EPFLXplore/Power_HW/README.md

# ERC_POWER_HW

This repository contains the KiCad design files for the power boards of the rover. The associated software can be found on the [ERC_POWER_SW](https://github.com/EPFLXplore/ERC_POWER_SW) repository.
