EPFLXplore/Power_HW/ElonMux/Computations/BQ25756-DESIGN-CALC-V01X2_backup.xlsx

Sheet: BQ2575X Design Calculator
 |  |  |  | BQ25756 Buck-Boost Battery Charger Design Calculator
 |  |  |  |  | View Password
 |  |  | = Input Box |  | BQ2575X
Step 1: Operating Specifications |  |  |  |  | Red Text = Conditional Formatting Conditions
 | Input Voltage - Min, VAC(min) | 10 | V | 10 V | 4.2 | 70
 | Input Voltage - Nom, VAC(nom) | 24 | V | 24 V | 4.2 | 70 | 10 | 33
 | Input Voltage - Max, VAC(max) | 33 | V | 33 V | 4.2 | 70
 | Battery Voltage, VBAT | 28.7 | V | 28,7 V | 3.3 | 70
 | Full Load Output Current, IOUT(max) | 10 | A | 10 A
 |  |  |  |  | Black Text = Lists or Formulas
Step 2: Switching Frequency
 | Desired Switching Frequency, FDFW | 600 | kHz | 600 kHz | 200 | 600
 | Recommended Switching Frequency Resistor, RFSW | 40.00 | kΩ | 40 kΩ
 | Selected Switching Frequency Resistor, RFSW | 40 | kΩ | 40 kΩ | 40 | 200
 | Recognized Switching Frequency, FSW | 600.00 | kHz |  | 570 | 630
 | Boost Duty Cycle Limitation | 86.50 | %
 | Boost Output Voltage Limitation at VAC(min) | 70 | V |  | 70 | 28.7
 | Boost Output Voltage Limitation at VAC(nom) | 70 | V |  | 70 | 28.7
 | Boost Output Voltage Limitation at VAC(max) | N/A | V |  | 70 | 28.7
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
