EPFLXplore/Power_HW/Wagos/power_hat_prots_ina/computations/ADM/24V_ADM1270 Design Spreadsheet tool_Release.xlsm

Set Resistor Tolerances
Sense Resistor Tolerance (%/100) |  | 0.01
Other Resistor Tolerance (%/100) |  | 0.01
UV and OV |  | Section 1
Set UV threshold | 20 | Volts
Set OV threshold | 27 | Volts
Set R3 in Kohms | 10 | Kohm
R1, closest Std 1% value | 255 | Kohm
R2, closest Std 1% value | 3.48 | Kohm
Actual UV Threshold | 19.92 | Volts
Actual OV Threshold | 26.848 | Volts
Worst Case UV High | 20.50 | Volts
Worst Case UV Low | 19.35 | Volts
Worst Case OV High | 27.64 | Volts
Worst Case OV Low | 26.07 | Volts
 |  | Section 2
CURRENT LIMIT
Desired Current Limit | 9 | Amps
Set Rsense | 0.005 | Ohms
Set R5 in Kohms | 10 | Kohms
R4, closest Std 1% value | 10 | Kohms
Calc actual OC | 9.000 | Amps
Calc VISET | 1.8 | Volts
Worst Case OC High | 9.825 | Amps
Worst Case OC Low | 8.194 | Amps
 |  | Section 3
FOLDBACK and PG
Set PG Threshold | 24 | Volts
Set FLB Threshold | 26 | Volts
Ignore these calculations, use next section
Set R9 in Kohms | 4.75 | Kohms
R7, closest Std 1% value | #N/A | Kohms
R8, closest Std 1% value | 110 | Kohms
Calc actual PG | #N/A | Volts
Worst Case PG High | #N/A
Worst Case PG Low | #N/A
Reverse FB and FLB connections, Set R8
Set R8 in Kohms | 100 | Kohms
R7, closest Std 1% value | 0.732 | Kohms
R9, closest Std 1% value | 3.65 | Kohms
Calc actual PG | 23.82 | Volts
Worst Case PG High | 24.52 | Volts
Worst Case PG Low | 23.14 | Volts
 |  | Section 4
Set Capacitor Tolerance (%/100) | 0.1
TIMER
Set Timer in milliseconds | 47 | mS
Calc Ctimer | 470 | nF
Wost Case Timer Max | 58.59 | mS
Wost Case Timer Min | 41.87 | mS
Set TimerOff in milliseconds | 940 | mS
Cal CtimerOff | 470 | nF
Wost Case TimerOff Max | 1318.3 | mS
Wost Case TimerOff Min | 690.9 | mS
Start Up Time from Internal UVLO (set by CtimerOff)
Wost Case Max | 65.9 | mS
Wost Case Min | 34.5 | mS
 |  | Section 5
Load Capacitance | 3500 | uF
Start up time | 0.01180727358 | Seconds
 | Time | Start Up
 | 0.01180727358 | 8.194
 | Volts | Start Up
 | 27.64 | 8.194
 |  | Section 6
FET Selection
Max Junction Temperature | 150 | C
Ambient Temperature | 40 | C
Mosfet thermal resistance from datasheet | 54 | C/W
Max permissible FET power dissipation | 2.037 | W
Permissible FET on resistance | 0.021 | ohms
Derating Factor from FET datasheet | 1.6
Max permissible FET on resistance | 0.013 | ohms
Actual FET on resistance @ 25C | 0.007 | ohms
Max FET on resistance at max Junc. Temp. | 0.011 | ohms
Actual FET power dissipation | 1.308 | W
Actual junction temperature rise | 70.636 | C
Maximum junction temperature | 110.636 | C
Calculated FET Power Derating Factor (DF) | 1.14
