EPFLXplore/Power_HW/Wagos/power_hat_prots_ina/computations/TPS/15V_TPS25983_Design_Calculator_v1.4.xlsm

TPS25983 Design Calculation Tool |  |  |  |  |  |  |  |  |  |  |  |  | Yes | 4
Constants Cells | Input/SelectCells | Calculation Cells |  |  | Recommended |  |  |  |  |  |  |  | No | 16
Error Cells, Must be Fixed | Calculated, but can be over-ridden by user |  |  |  | Value |  |  |  |  |  |  |  | Auto-Retry | 64
Parameter | Description | Value | Units | Tolerance |  |  |  |  |  |  |  |  | Latch-off | 256
VIN (nom) | Nominal operating input voltage | 15.00 | V |  |  |  |  |  |  |  |  |  |  | Infinite
VIN (max) | Maximum Operating input voltage (magnitude) | 15.00 | V |  | #REF!
OVLOset | Overvoltage Threshold (VIN Rising) | 18.00 | V
UVLOset | Undervoltage Threshold (VIN Rising) | 12.00 | V
VUVP | Internal IN Undervoltage Protection Threshold (VIN Rising) | 2.53 | V | 2.7%
Cout | Load Capacitance | 3500.0 | uF | 10.0%
Rlstart | Load at start-up (assumed to be resistive), Refer to Section 9.2.2.5.2 in Datasheet (http://www.ti.com/lit/ds/symlink/tps25982.pdf) | 75.0 | Ohm |  | 1.5
Imax | Maximum continuous load current (magnitude) | 10.00 | A
Ilimit | Set current Limit 20% (typical) higher than maximum continuous load current | 11.00 | A
TA(max) | Max Ambient Temperature | 70 | degC
 | Do you need to be immue to line transient due to adjacent card “hot-swap events” | No
tITIMER | Enter the time interval to support load transient currents | 5000 | us
 | Fault Response | Auto-Retry
tRETRY_DLY | Time delay between retries | 10.00 | ms
NRETRY | Number of retries | Infinite
Rec_VIMONMax | Recommended maximum IMON voltage | 3.3 | V
VIMON-Max | Enter current monitor (IMON) full-scale voltage range | 2.0 | V
UVLO, OVLO set point calculations |  |  |  |  |  |  |  |  |  | 120 |  | 111.1111111
UVLO Set Point | Desired Undervoltage Threshold (VIN Rising) | 12.00 |  |  |  |  |  | 10.90 | Power Fail (VIN Falling) | 180
OVLO Set Point | Desired Over Voltage Lockout Set Point | 18.00 |  |  |  |  |  | 11.90 | Release UVLO (VIN Rising)
R1: Pullup at EN/OVLO Pin | Value > 350K recommended | 1000.0 | kOhm | 1.0% |  |  |  | 17.63 | OV Cut-off (VIN Rising) | 182
R2_cal | Calculated value of Resistor at EN/OVLO pin | 37.0 | kOhm
R3_cal | Calculated value of Resistor at EN/OVLO pin | 74.1 | kOhm
SELECT THE VALUE OF RESISTORS AS CLOSEST AVAILABLE VALUE OF R2 & R3
R2 | Select the closest possible value as R2_cal | 36.50 | kOhm | 1.00% | 37.4
R3 | Select the closest possible value as R3_cal | 75.69 | kOhm | 1.00% | 75.69406393
UV_final_rising | Undervoltage Threshold (VIN Rising) | 11.90 | V
UV_final_falling | Undervoltage Threshold (VIN Falling) | 10.90 | V
OV_final_rising | Overvoltage Threshold (VIN Rising) | 17.63 | V
OV_final_falling | Overvoltage Threshold (VIN Falling) | 16.16 | V
I_R123 | Current in R1, R2 and R3 Branch | 13.49 | uA
Calculations for Ilimit (resistor on ILIM Pin) |  |  |  |  |  |  |  | 0.20 | Inrush Charging Current | 370.3703704
RILIM_Cal | Calculated current limit resistor | 134.07 | Ohm |  |  |  |  | 10.77 | Overload Curr Limit | 374
SELECT A ILIMIT RESISTOR WITH THE CLOSEST AVAILABLE VALUE OF Rilim_Cal |  |  |  |  |  |  |  |  |  | 134.07
RILIM | Select the closest available value of RILIM_cal | 137 | Ohm | 1.0% | 137 |  |  |  |  | 137
Ilimit_final | Final current Limit Set Point | 10.77 | A | 9.4% | 9.76 | A
Calculations for CURRENT MONITOR |  |  |  |  |  |  |  |  |  | 764.4193269
RIMON_max | Maximum allowed resistance at IMON pin | 764.42 | Ohm |  | 764.42 |  |  |  |  | 750
RIMON_sel | Resistor value selected at IMON pin | 750.00 | Ohm | 1.0% | 750
VIMON_final | Maximum voltage at IMON for maximum load current | 1.96 | V | 3.2%
The range of voltage output at IMON pin will be from 0V to VMON_imax |  | VIMON is Within Limits
Calculations for SoftStart control (external cap on dVdt pin)
Parameter | Description | Value | Units | Tolerance
Tchg_fastest | When no external capacitor is connected (max. slew rate) | 2.04 | ms | 15.0%
Icharge_fastest | Charging current when charging at fastest possible rate If this current is < Ilimit, no capacitor is required at dVdT pin | 10.77 | A
Tchg_req | The charging time required | 200.00 | ms
Icharge_req | Charging (inrush) current desired in the system | 0.30 | A
Cext_dvdt_cal1 | Calculated value of capacitor at dVdT pin for required Tcharge | 61.33 | nF
Cext_dvdt_cal2 | Calculated value of capacitor at dVdT pin for required Icharge | 53.67 | nF |  | 61.33
SELECT A CAPACITOR WITH THE CLOSEST POSSIBLE VALUE to max(Cext_dvdt_cal1, Cext_dvdt_cal2)
CdVdT_ext | The external capacitor connecetd across dVdT pin | 82.00 | nF | 10.0% | 68.0
Icharge | Charging Current as per dVdT setting | 0.20 | A | 18.0%
Does Device Enter Current Limit during start-up? |  | 0.00 |  |  | 13086.20
Tchg_dVdT | Charging time set | 267.39 | ms | 18.0%
Pd_Cout_startup | Power dissipation due to load cap at start-up | 1.47 | W
Total Power dissipation at Start-up
Pd_Rlstart | Power dissipation due to load resistance at start-up | 0.50 | W
Pd_startup | Total power dissipation at start-up | 1.97 | W |  |  |  |  |  |  | 2.57 | #N/A
 | Max power dissipation allowed for glitch-free startup for the programmed startup time (20% margin) | 2.06 | W | 20.0% | 2.57 |  |  |  |  | 1.40 | #N/A
 | Will the system have glitch-free startup? Look at Thermal Shutdown Limit Plot Tab | YES
Steady state Voltage drop & Power dissipation
Parameter | Description | Value | Units | Tolerance
Vdrop | Maximum voltage drop across device @ 25 degC | 32.00 | mV
Pdiss_Imax | Steady state power dissipation with Max current @ 25degC | 320.00 | mW
Calculations for Transient Overcurrent Blanking Interval
Citimer_cal | Calculated value of capacitor at ITIMER pin | 10.64 | nF |  | 10.64
Citimer_sel | Capacitor value selected at ITIMER pin | 10.00 | nF | 10.0% | 15.0
tITIMER_final | Time duration for which load transients between Ilimit and 2.1xIlimit are allowed | 4700 | us |  | 6536.74125 | nF
Setting the Auto-Retry Delay and Number of Retries
CRETRY_DLY_cal | Calculated value of capacitor at RETRY_DLY pin | 0.21 | nF |  | 0.21
CRETRY_DLY_sel | Capacitor value selected at RETRY_DLY pin | 0.22 | nF | 10.0% | 0.22
tRETRY_DLY_final | Time delay between retries | 10.49 | ms
CNRETRY_cal | Calculated value of capacitor at NRETRY pin | Short to Gnd | nF |  | Short to Gnd
CNRETRY_sel | Capacitor value selected at NRETRY pin | Short to Gnd | nF | 10.0% | Short to Gnd | #VALUE!
NRETRY_final | Number of retries | Infinite |  |  | Infinite | Infinite
Design Summary
 |  | R1 = | 12 | kOhm | Parameter |  | Typical | Units
 |  | R2 = | 36.5 | kOhm | Current limit |  | 10.77 | A
 |  | R3 = | 75.69 | kOhm | Upper UVLO Threshold |  | 11.90 | V
 |  | RG = | 2 | Ohm | Lower UVLO Threshold |  | 10.90 | V
 |  | RILIM = | 137 | Ohm | Output voltage ramp time, TdVdt |  | 267.39 | ms
 |  | RIMON = | 750.00 | Ohm
 |  | RPG = | 10.00 | kOhm | Transient overcurrent blanking interval (tITIMER) |  | 4700 | us
 |  | CdVdt = | 82.00 | nF
 |  | CITIMER = | 10 | nF | Time delay between retries |  | 10.48992 | ms
 |  | CRETRY_DLY = | 0.22 | nF | Number of retries |  | Infinite
 |  | CNRETRY = | Short to Gnd | nF
 |  |  |  |  | Overvoltage lockout |  | 17.63 | V
Notes: | 1. Although not mandatory, CIN provides transient suppression at the VIN pin | CIN = | 0.01uF | uF
 | 2. TVS clamp diode D1 from VIN to GND is recommented to clamp the voltage overshoot during device turn-off, e.g. during circuit breaker | COUT = | Optional
 | 3. Schottky diode D2 from VOUT to GND is mandatory to absorb negative spikes | D1 = | SMCJxx
 |  | D2 = | B530C-13-F
Parameters internal to Device
Internal FET Parameters
Parameter | Description | Value | Units | Tolerance
VDSS (max) | FET drain-source voltage rating (maximum) | 30.0 | V
ID(max) | FET drain-source current rating (maximum) | 18.0 | A
Rds(on) | FET maximum Rds(on) at 25degC | 3.20 | mOhm
Rds(on)_max | FET maximum Rds(on) at 125degC | 4.50 | mOhm
Thermal Parameters
Tj(max) | Device maximum junction temperature | 150.0 | C
TA(max) | Maximum ambient temperature of the application | 125.0 | C
RJC(top) | Junction to case (top) Thermal Resistance | 36.7 | C/W
RJA | Junction to ambient thermal resistance | 34.6 | C/W
RJC(bot) | Junction-to-case(bottom) thermal resistance | 1.6 | C/W
Internal References
Uvref_rise | Internal Undervoltage reference (Rising) | 1.20 | V | 2.5%
Uvref_fall | Internal Undervoltage reference (Falling) | 1.10 | V | 2.7%
GainIMON | Current monitor gain | 243.00 | uA/A | 3.0%
Idvdt | dVdt Pin Charging Current | 4.76 | uA | 3.0%
Delay
tD,ON | Device turn ON delay | 26.03 | ms
tGHI | Time taken to reach steady state | 346.45 | ms
