EPFLXplore/Power_HW/Wagos/power_hat_prots_ina/computations/TPS/TPS25983_Design_Calculator_v1.4.xlsm

TPS25983 Design Calculation Tool
Constants Cells | Input/SelectCells | Calculation Cells |  |  | Recommended
Error Cells, Must be Fixed | Calculated, but can be over-ridden by user |  |  |  | Value
Parameter | Description | Value | Units | Tolerance
VIN (nom) | Nominal operating input voltage | 15.00 | V
VIN (max) | Maximum Operating input voltage (magnitude) | 25.00 | V |  | #REF!
OVLOset | Overvoltage Threshold (VIN Rising) | 26.00 | V
UVLOset | Undervoltage Threshold (VIN Rising) | 4.00 | V
VUVP | Internal IN Undervoltage Protection Threshold (VIN Rising) | 2.53 | V | 2.7%
Cout | Load Capacitance | 62.0 | uF | 10.0%
Rlstart | Load at start-up (assumed to be resistive), Refer to Section 9.2.2.5.2 in Datasheet (http://www.ti.com/lit/ds/symlink/tps25982.pdf) | 24.0 | Ohm |  | 0.8
Imax | Maximum continuous load current (magnitude) | 18.00 | A
Ilimit | Set current Limit 20% (typical) higher than maximum continuous load current | 21.60 | A
TA(max) | Max Ambient Temperature | 70 | degC
 | Do you need to be immue to line transient due to adjacent card “hot-swap events” | No
tITIMER | Enter the time interval to support load transient currents | 2000 | us
 | Fault Response | Auto-Retry
tRETRY_DLY | Time delay between retries | 100.00 | ms
NRETRY | Number of retries | 4
Rec_VIMONMax | Recommended maximum IMON voltage | 3.3 | V
VIMON-Max | Enter current monitor (IMON) full-scale voltage range | 2.0 | V
UVLO, OVLO set point calculations |  |  |  |  |  |  |  |  |  | 400 |  | 213.8571429
UVLO Set Point | Desired Undervoltage Threshold (VIN Rising) | 4.00 |  |  |  |  |  | 3.65 | Power Fail (VIN Falling) | 260
OVLO Set Point | Desired Over Voltage Lockout Set Point | 26.00 |  |  |  |  |  | 3.99 | Release UVLO (VIN Rising)
R1: Pullup at EN/OVLO Pin | Value > 350K recommended | 499.0 | kOhm | 1.0% |  |  |  | 25.98 | OV Cut-off (VIN Rising) | 261
R2_cal | Calculated value of Resistor at EN/OVLO pin | 181.0 | kOhm
R3_cal | Calculated value of Resistor at EN/OVLO pin | 32.9 | kOhm
SELECT THE VALUE OF RESISTORS AS CLOSEST AVAILABLE VALUE OF R2 & R3
R2 | Select the closest possible value as R2_cal | 182.00 | kOhm | 1.00% | 182
R3 | Select the closest possible value as R3_cal | 32.98 | kOhm | 1.00% | 32.97927281
UV_final_rising | Undervoltage Threshold (VIN Rising) | 3.99 | V
UV_final_falling | Undervoltage Threshold (VIN Falling) | 3.65 | V
OV_final_rising | Overvoltage Threshold (VIN Rising) | 25.98 | V
OV_final_falling | Overvoltage Threshold (VIN Falling) | 23.81 | V
I_R123 | Current in R1, R2 and R3 Branch | 35.02 | uA
Calculations for Ilimit (resistor on ILIM Pin) |  |  |  |  |  |  |  | 0.05 | Inrush Charging Current | 180.956044
RILIM_Cal | Calculated current limit resistor | 67.94 | Ohm |  |  |  |  | 21.55 | Overload Curr Limit | 182
SELECT A ILIMIT RESISTOR WITH THE CLOSEST AVAILABLE VALUE OF Rilim_Cal |  |  |  |  |  |  |  |  |  | 679.3857608
RILIM | Select the closest available value of RILIM_cal | 68.1 | Ohm | 1.0% | 68.1 |  |  |  |  | 681
Ilimit_final | Final current Limit Set Point | 21.55 | A | 6.9% | 20.08 | A
Calculations for CURRENT MONITOR |  |  |  |  |  |  |  |  |  | 381.9402144
RIMON_max | Maximum allowed resistance at IMON pin | 381.94 | Ohm |  | 381.94 |  |  |  |  | 374
RIMON_sel | Resistor value selected at IMON pin | 374.00 | Ohm | 1.0% | 374
VIMON_final | Maximum voltage at IMON for maximum load current | 1.96 | V | 3.2%
The range of voltage output at IMON pin will be from 0V to VMON_imax |  | VIMON is Within Limits
Calculations for SoftStart control (external cap on dVdt pin)
Parameter | Description | Value | Units | Tolerance
Tchg_fastest | When no external capacitor is connected (max. slew rate) | 2.04 | ms | 15.0%
Icharge_fastest | Charging current when charging at fastest possible rate If this current is < Ilimit, no capacitor is required at dVdT pin | 0.46 | A
Tchg_req | The charging time required | 20.00 | ms
Icharge_req | Charging (inrush) current desired in the system | 1.00 | A
Cext_dvdt_cal1 | Calculated value of capacitor at dVdT pin for required Tcharge | 6.13 | nF
Cext_dvdt_cal2 | Calculated value of capacitor at dVdT pin for required Icharge | 0.29 | nF |  | 6.13
SELECT A CAPACITOR WITH THE CLOSEST POSSIBLE VALUE to max(Cext_dvdt_cal1, Cext_dvdt_cal2)
CdVdT_ext | The external capacitor connecetd across dVdT pin | 6.20 | nF | 10.0% | 6.2
Icharge | Charging Current as per dVdT setting | 0.05 | A | 18.0%
Does Device Enter Current Limit during start-up? |  | FALSE |  |  | 686.47
Tchg_dVdT | Charging time set | 20.22 | ms | 18.0%
Pd_Cout_startup | Power dissipation due to load cap at start-up | 0.34 | W
Total Power dissipation at Start-up
Pd_Rlstart | Power dissipation due to load resistance at start-up | 1.56 | W
Pd_startup | Total power dissipation at start-up | 1.91 | W |  |  |  |  |  |  | 9.69 | 9.28
 | Max power dissipation allowed for glitch-free startup for the programmed startup time (20% margin) | 7.75 | W | 20.0% | 9.69 |  |  |  |  | 6.62 | 6.69
 | Will the system have glitch-free startup? Look at Thermal Shutdown Limit Plot Tab | YES
Steady state Voltage drop & Power dissipation
Parameter | Description | Value | Units | Tolerance
Vdrop | Maximum voltage drop across device @ 25 degC | 57.60 | mV
Pdiss_Imax | Steady state power dissipation with Max current @ 25degC | 1036.80 | mW
Calculations for Transient Overcurrent Blanking Interval
Citimer_cal | Calculated value of capacitor at ITIMER pin | 4.26 | nF |  | 4.26
Citimer_sel | Capacitor value selected at ITIMER pin | 4.30 | nF | 10.0% | 4.3
tITIMER_final | Time duration for which load transients between Ilimit and 2.1xIlimit are allowed | 2021 | us |  | 517.1819868 | nF
Setting the Auto-Retry Delay and Number of Retries
CRETRY_DLY_cal | Calculated value of capacitor at RETRY_DLY pin | 2.13 | nF |  | 2.13
CRETRY_DLY_sel | Capacitor value selected at RETRY_DLY pin | 2.20 | nF | 10.0% | 2.2
tRETRY_DLY_final | Time delay between retries | 103.21 | ms
CNRETRY_cal | Calculated value of capacitor at NRETRY pin | 2.20 | nF |  | 1.98
CNRETRY_sel | Capacitor value selected at NRETRY pin | 1.8 | nF | 10.0% | 1.8 | 3.266787659
NRETRY_final | Number of retries | 4 |  |  | 3.266787659 | 4
Design Summary
 |  | R1 = | 4 | kOhm | Parameter |  | Typical | Units
 |  | R2 = | 182 | kOhm | Current limit |  | 21.55 | A
 |  | R3 = | 32.98 | kOhm | Upper UVLO Threshold |  | 3.99 | V
 |  | RG = | 2 | Ohm | Lower UVLO Threshold |  | 3.65 | V
 |  | RILIM = | 68.1 | Ohm | Output voltage ramp time, TdVdt |  | 20.22 | ms
 |  | RIMON = | 374 | Ohm
 |  | RPG = | 10.00 | kOhm | Transient overcurrent blanking interval (tITIMER) |  | 2021 | us
 |  | CdVdt = | 6.20 | nF
 |  | CITIMER = | 4.3 | nF | Time delay between retries |  | 103.21332 | ms
 |  | CRETRY_DLY = | 2.2 | nF | Number of retries |  | 4
 |  | CNRETRY = | 1.8 | nF
 |  |  |  |  | Overvoltage lockout |  | 25.98 | V
Notes: | 1. Although not mandatory, CIN provides transient suppression at the VIN pin | CIN = | 0.01uF | uF
 | 2. TVS clamp diode D1 from VIN to GND is recommented to clamp the voltage overshoot during device turn-off, e.g. during circuit breaker | COUT = | Optional
 | 3. Schottky diode D2 from VOUT to GND is mandatory to absorb negative spikes | D1 = | SMCJxx
 |  | D2 = | B530C-13-F
Parameters internal to Device
Internal FET Parameters
Parameter | Description | Value | Units | Tolerance
VDSS (max) | FET drain-source voltage rating (maximum) | 30.0 | V
ID(max) | FET drain-source current rating (maximum) | 18.0 | A
Rds(on) | FET maximum Rds(on) at 25degC | 3.20 | mOhm
Rds(on)_max | FET maximum Rds(on) at 125degC | 4.50 | mOhm
Thermal Parameters
Tj(max) | Device maximum junction temperature | 150.0 | C
TA(max) | Maximum ambient temperature of the application | 125.0 | C
RJC(top) | Junction to case (top) Thermal Resistance | 36.7 | C/W
RJA | Junction to ambient thermal resistance | 34.6 | C/W
RJC(bot) | Junction-to-case(bottom) thermal resistance | 1.6 | C/W
Internal References
Uvref_rise | Internal Undervoltage reference (Rising) | 1.20 | V | 2.5%
Uvref_fall | Internal Undervoltage reference (Falling) | 1.10 | V | 2.7%
GainIMON | Current monitor gain | 243.00 | uA/A | 3.0%
Idvdt | dVdt Pin Charging Current | 4.76 | uA | 3.0%
Delay
tD,ON | Device turn ON delay | 3.18 | ms
tGHI | Time taken to reach steady state | 27.41 | ms
