EPFLXplore/Power_HW/Pollux/Altium/Pollux III/ImportantLogos.docx

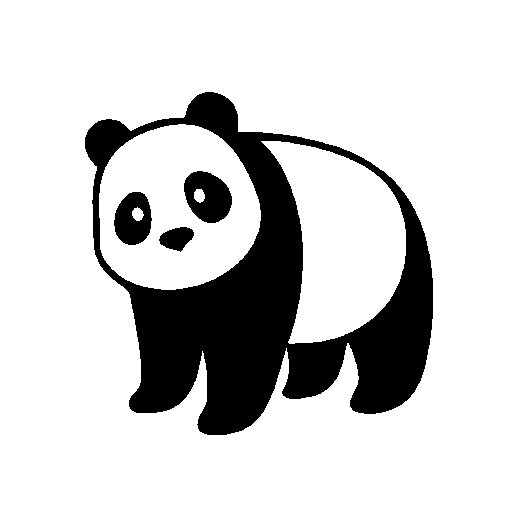
[picture p22: figure]
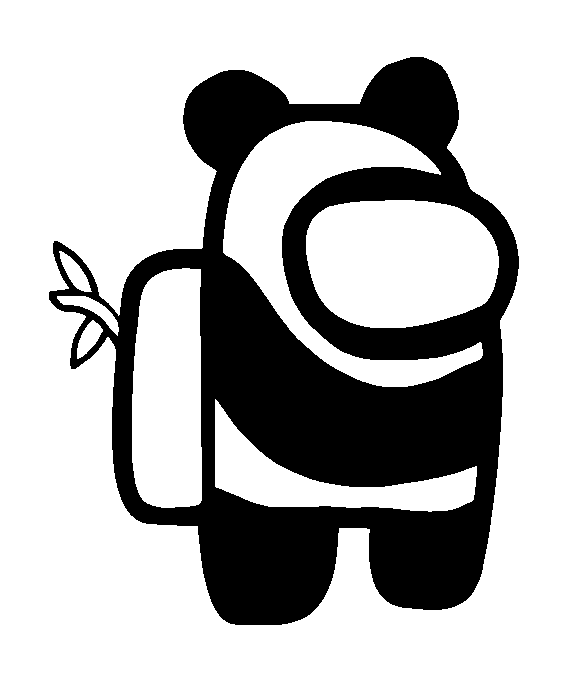
[picture p23: figure]
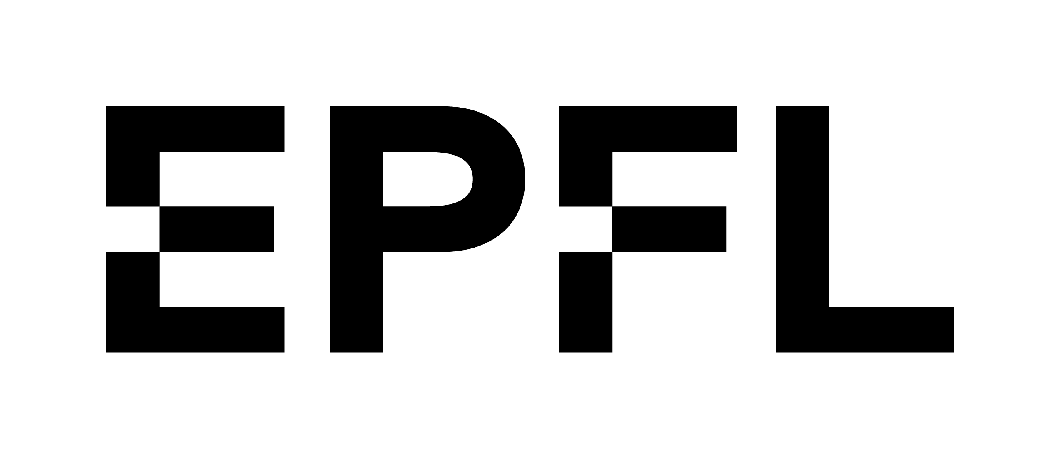
[picture p24: figure]
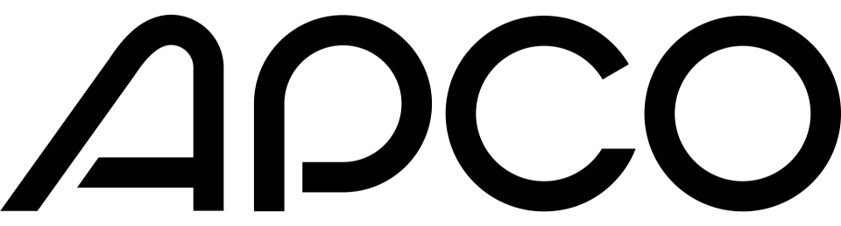
[picture p25: figure]
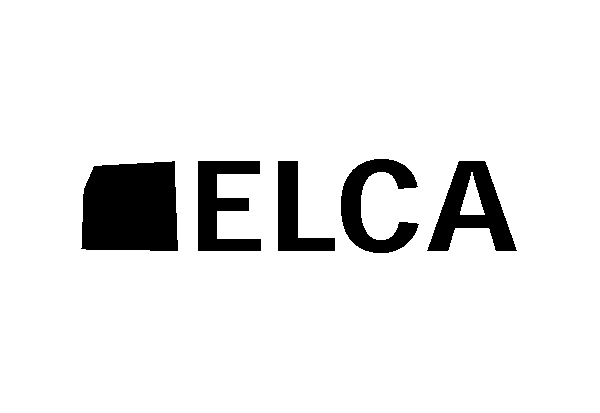
[picture p26: figure]
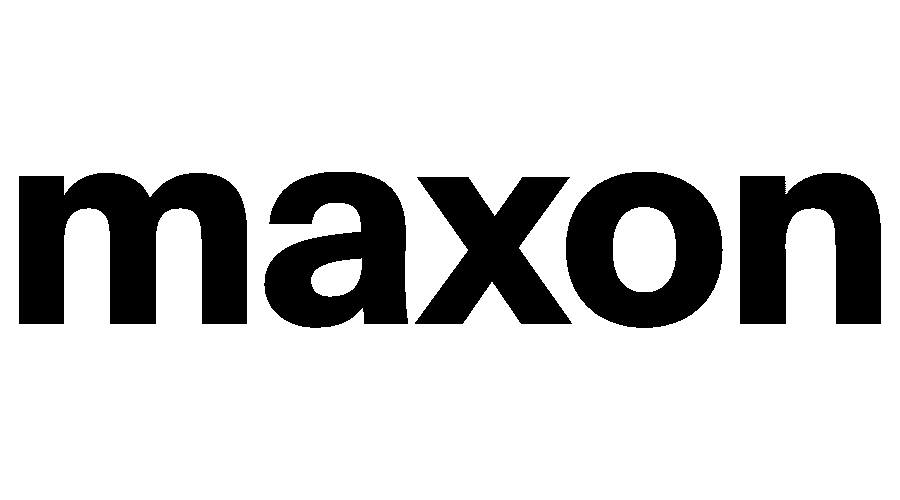
[picture p27: figure]
