EPFLXplore/Power_HW/ElonMux/Images/0.96-Inch-I2CIIC-4-Pin-OLED-Display-Module-WHITE-2.png.png

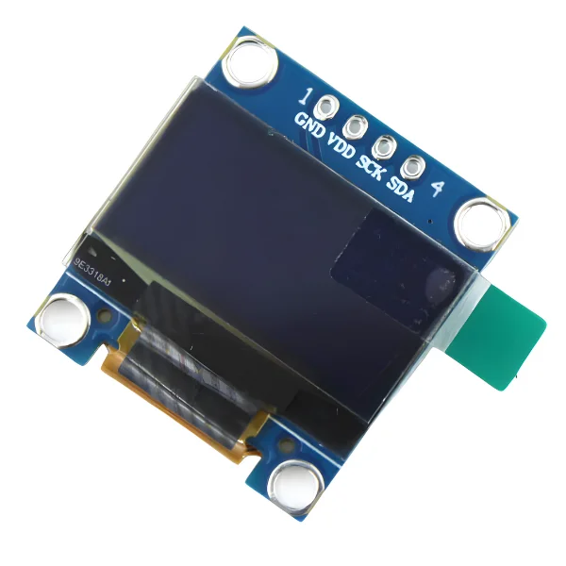
ElonMux/Images/0.96-Inch-I2CIIC-4-Pin-OLED-Display-Module-WHITE-2.png.png
