EPFLXplore/Power_HW/ElonMux/Images/BQ25756E.png

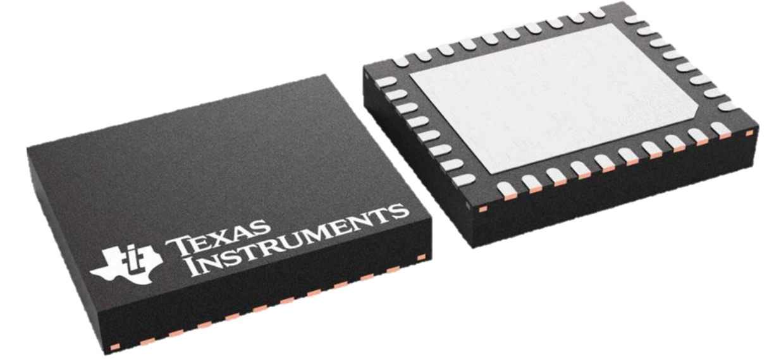
ElonMux/Images/BQ25756E.png
