EPFLXplore/Power_HW/ElonMux/Images/Capture d’écran 2024-12-14 à 01.28.16.png

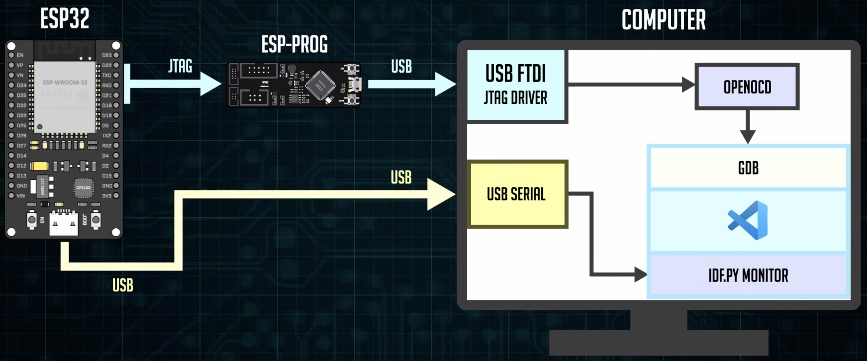
ElonMux/Images/Capture d’écran 2024-12-14 à 01.28.16.png
