EPFLXplore/Power_HW/ElonMux/Images/ElonMuxBack1.png

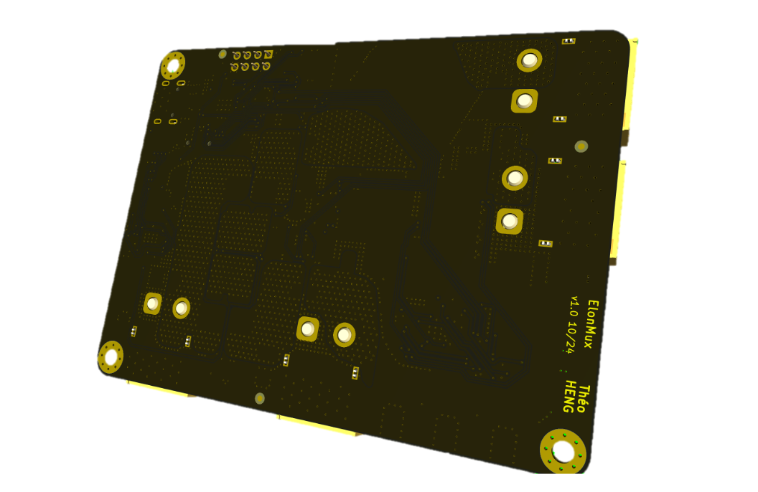
ElonMux/Images/ElonMuxBack1.png
