EPFLXplore/Power_HW/ElonMux/Images/ElonMuxBack2.png

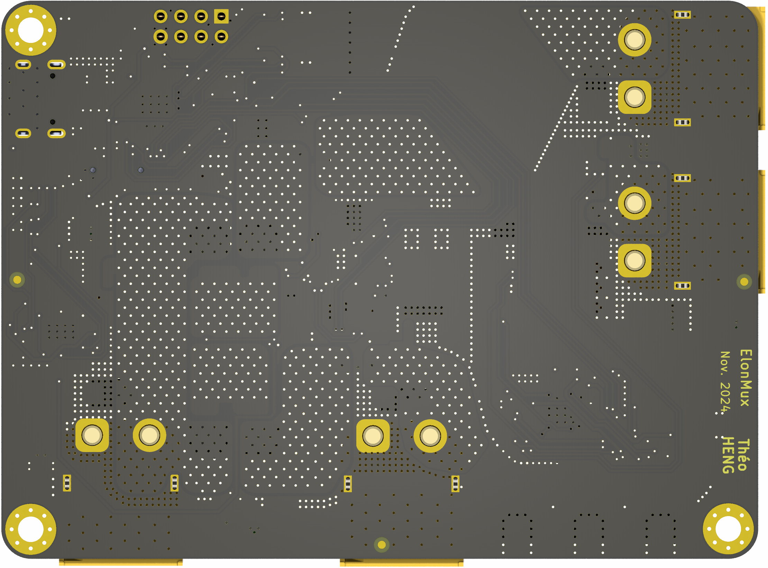
ElonMux/Images/ElonMuxBack2.png
