EPFLXplore/Power_HW/ElonMux/Images/ElonMuxBack3.png

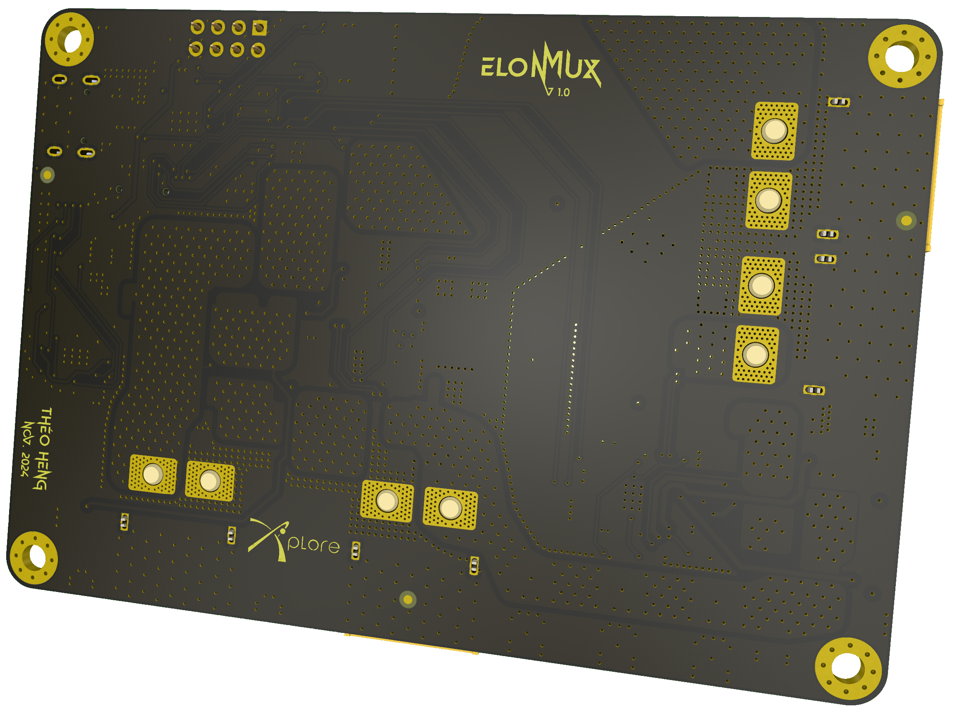
ElonMux/Images/ElonMuxBack3.png
