EPFLXplore/Power_HW/ElonMux/Images/ElonMuxBack4.png

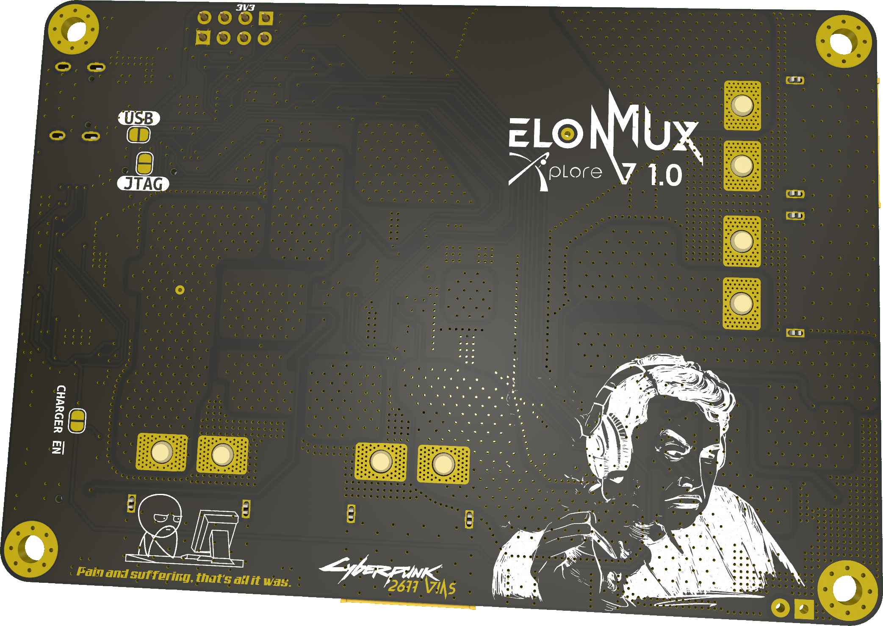
ElonMux/Images/ElonMuxBack4.png
