EPFLXplore/Power_HW/ElonMux/Images/ElonMuxBack5.png

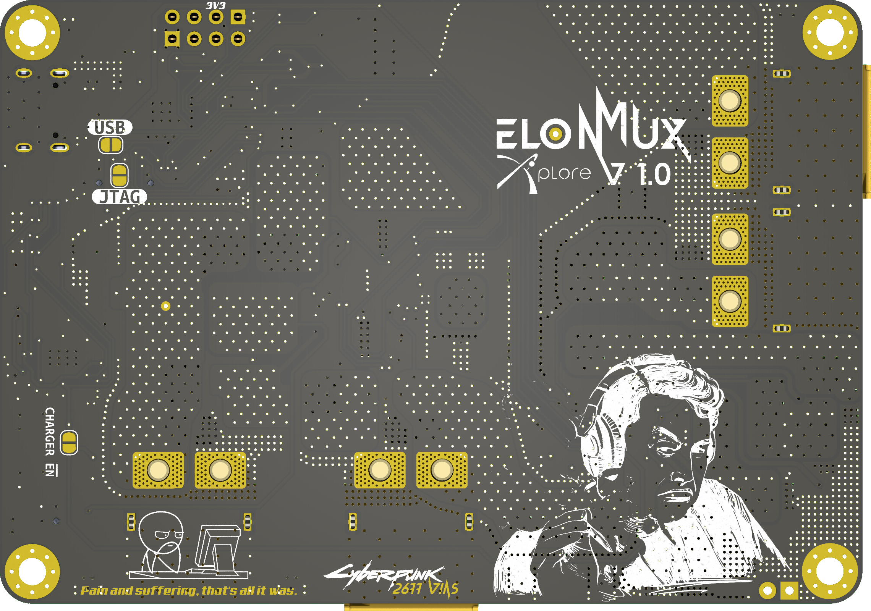
ElonMux/Images/ElonMuxBack5.png
