EPFLXplore/Power_HW/ElonMux/Images/ElonMuxFront1.png

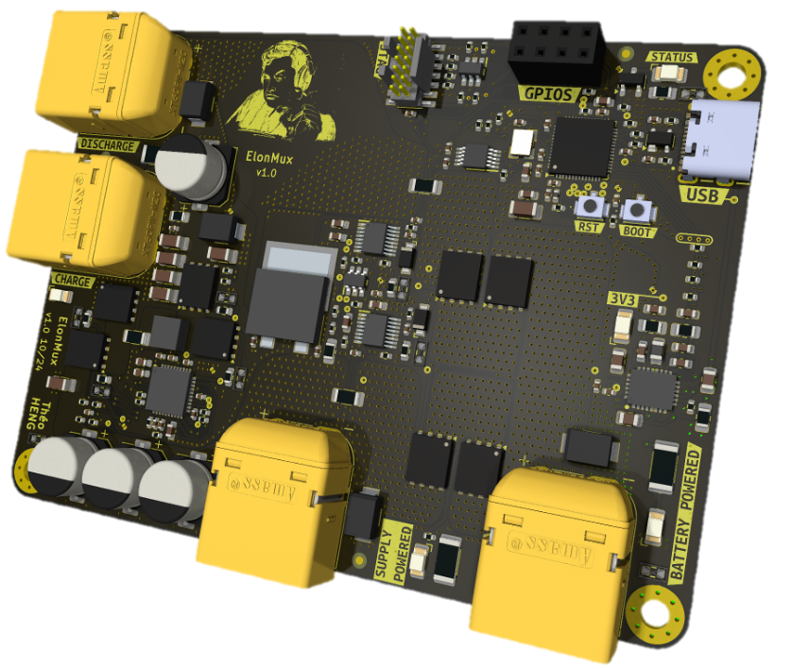
ElonMux/Images/ElonMuxFront1.png
