EPFLXplore/Power_HW/ElonMux/Images/ElonMuxFront2.png

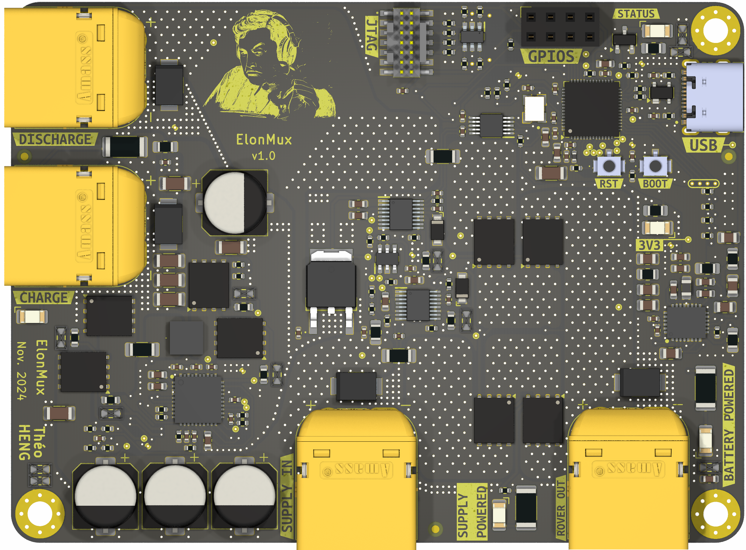
ElonMux/Images/ElonMuxFront2.png
