EPFLXplore/Power_HW/ElonMux/Images/ElonMuxFront3.png

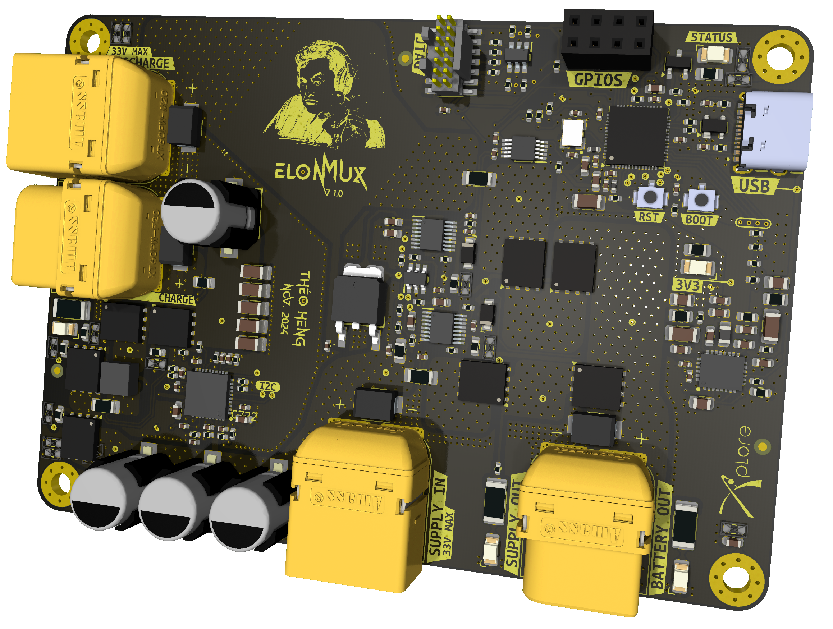
ElonMux/Images/ElonMuxFront3.png
