EPFLXplore/Power_HW/ElonMux/Images/ElonMuxFront4.png

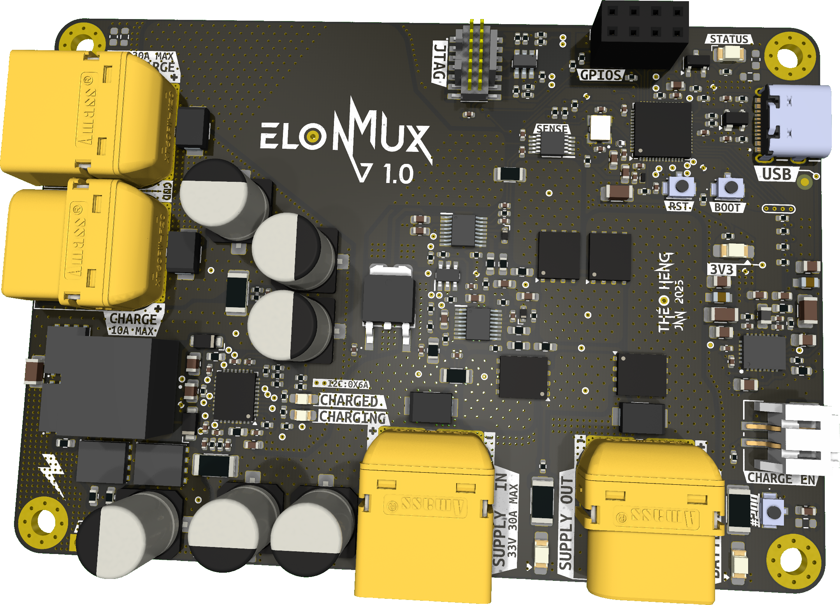
ElonMux/Images/ElonMuxFront4.png
