EPFLXplore/Power_HW/ElonMux/Images/ElonMuxFrontSafe_1.png

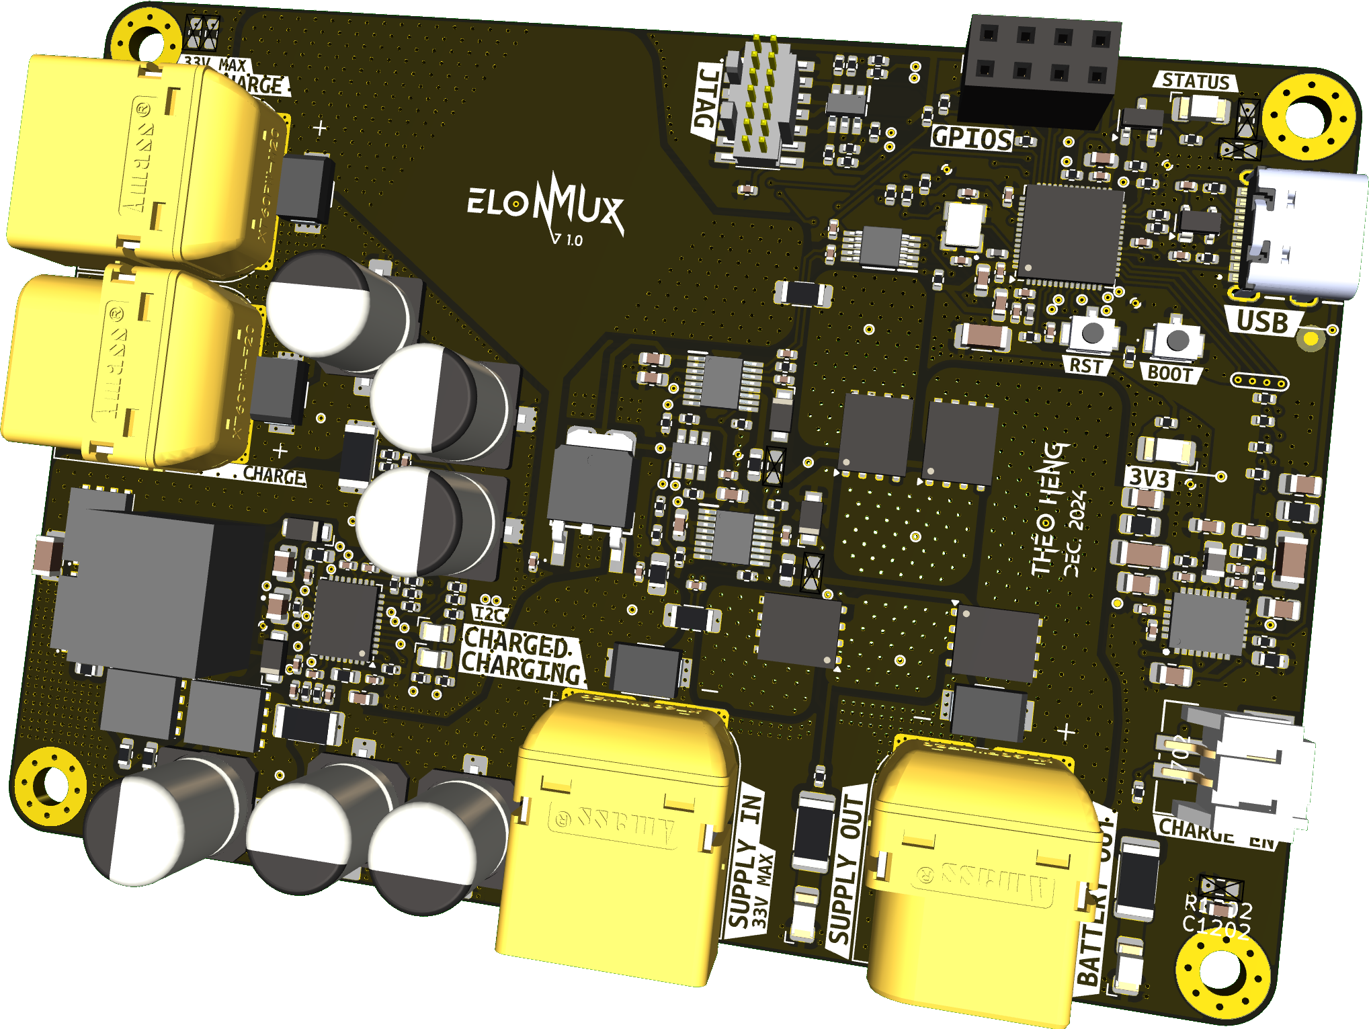
ElonMux/Images/ElonMuxFrontSafe_1.png
