EPFLXplore/Power_HW/ElonMux/Images/ElonMuxL1_1.png

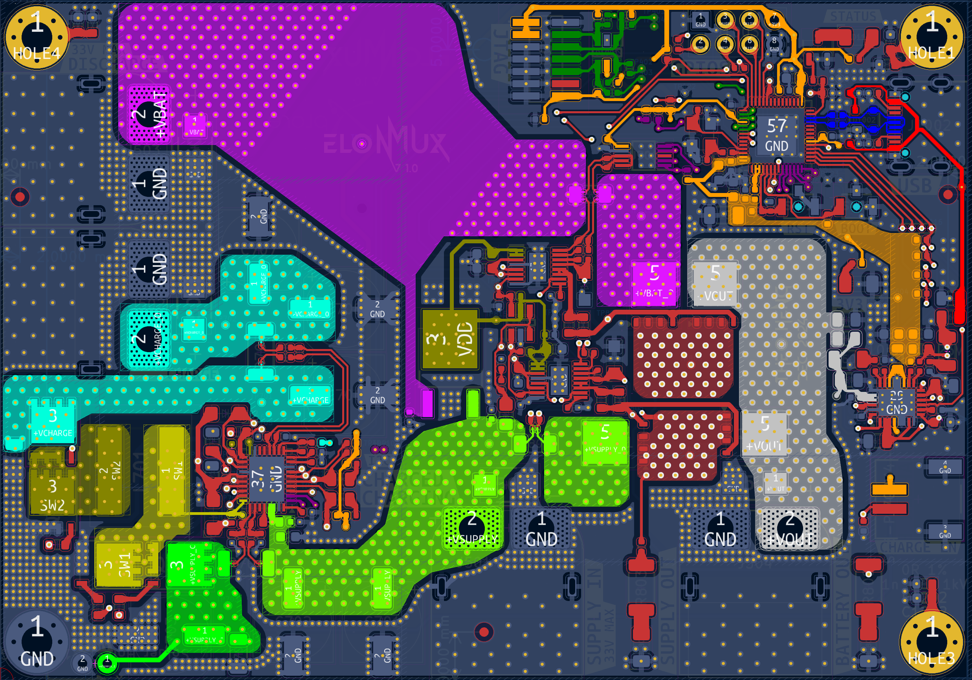
ElonMux/Images/ElonMuxL1_1.png
