EPFLXplore/Power_HW/ElonMux/Images/EMux_render.png

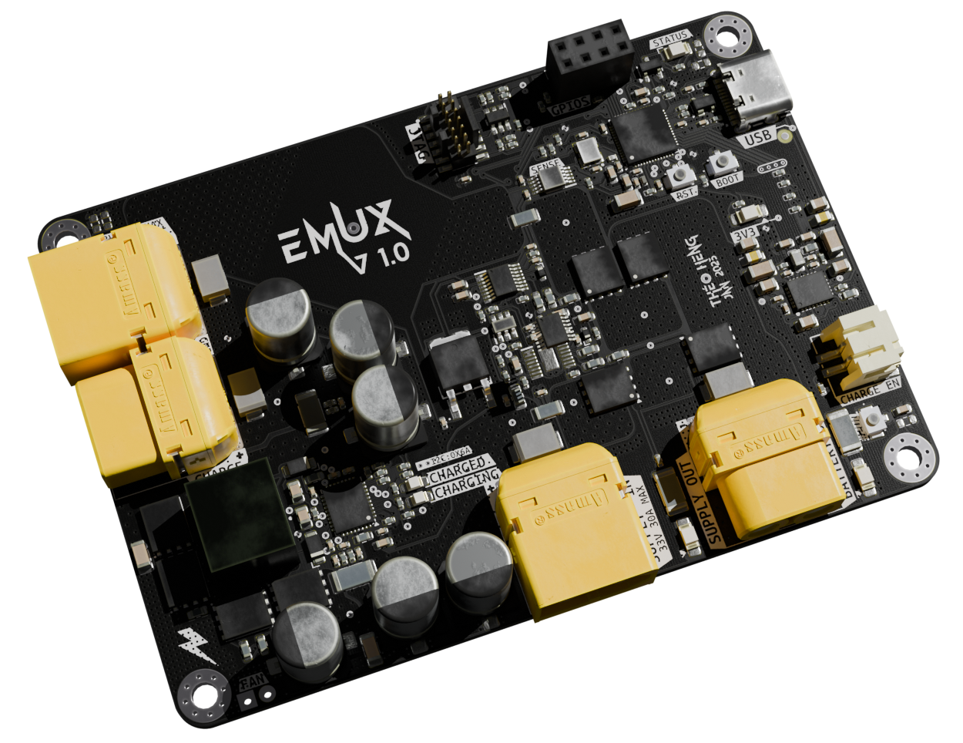
ElonMux/Images/EMux_render.png
