EPFLXplore/Power_HW/ElonMux/Images/ESP-Prog_Pinout.png

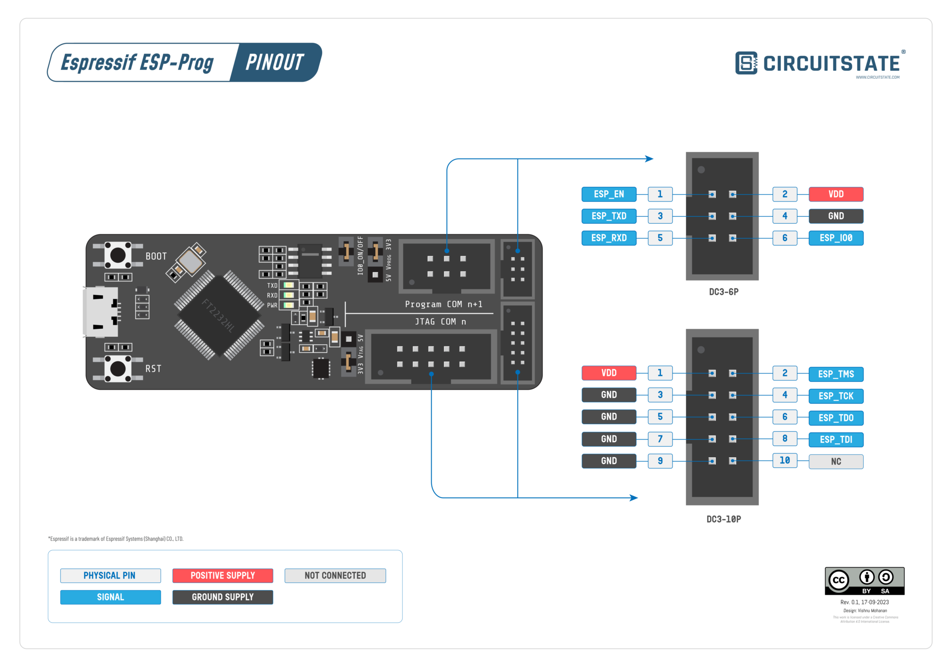
ElonMux/Images/ESP-Prog_Pinout.png
