EPFLXplore/Power_HW/ElonMux/Images/Ferrite Filter.png

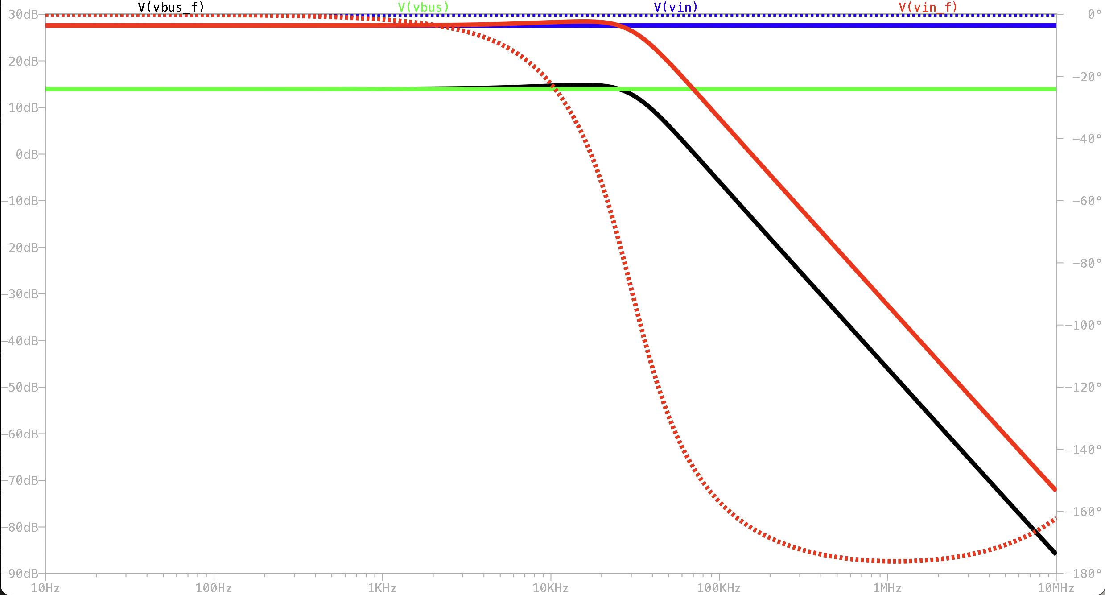
ElonMux/Images/Ferrite Filter.png
