EPFLXplore/Power_HW/ElonMux/Images/FTSH-107-01-F-DV-K.png

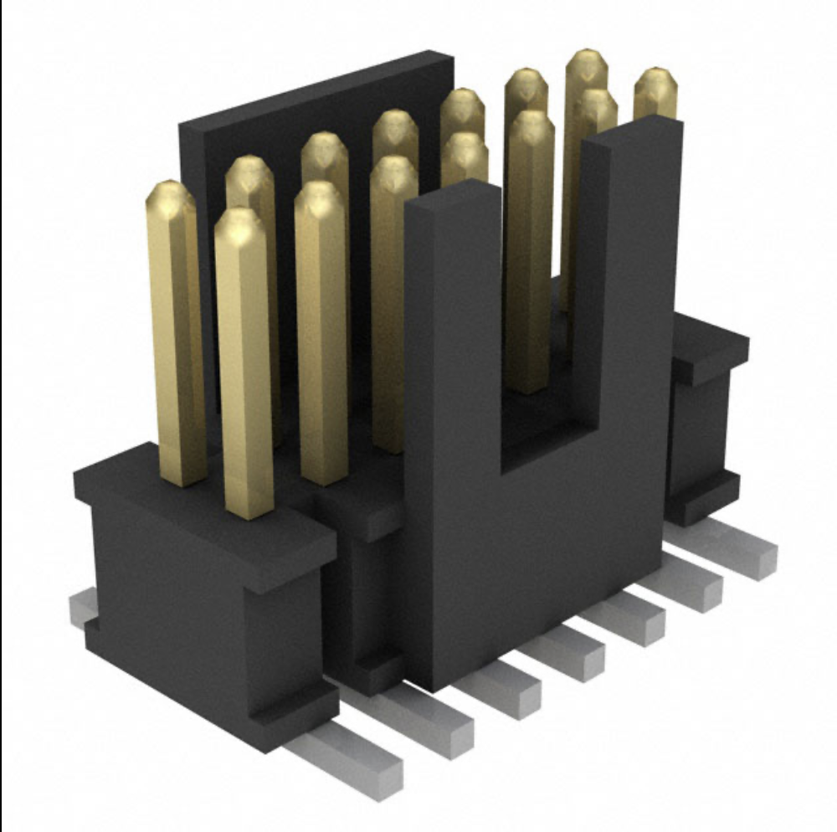
ElonMux/Images/FTSH-107-01-F-DV-K.png
