EPFLXplore/Power_HW/ElonMux/Images/Photos/IMG_1249.jpg

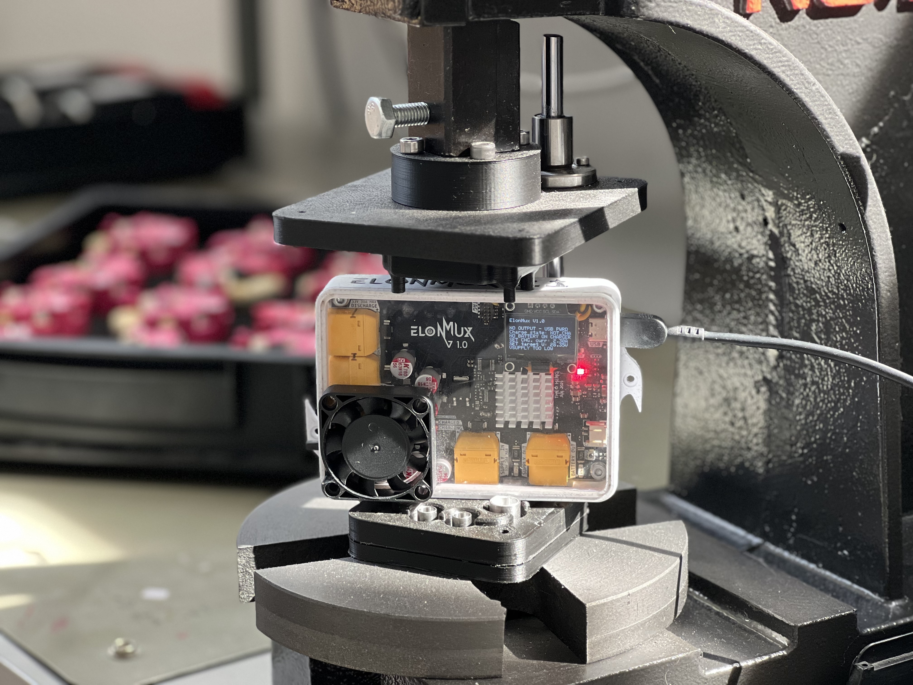
ElonMux/Images/Photos/IMG_1249.jpg
