EPFLXplore/Power_HW/ElonMux/Images/Photos/IMG_1306.jpg

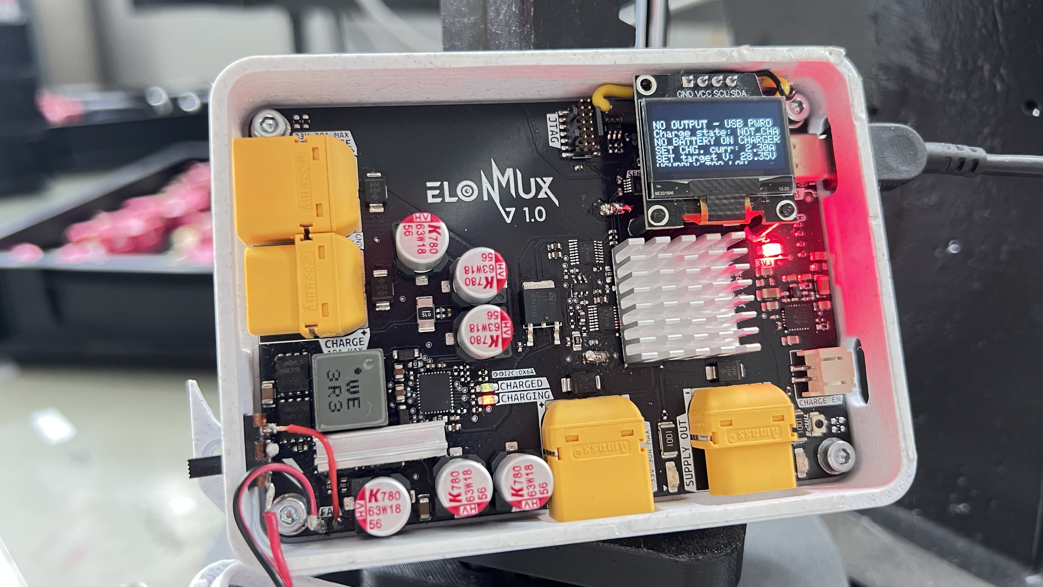
ElonMux/Images/Photos/IMG_1306.jpg
