EPFLXplore/Power_HW/ElonMux/Images/PPTC042LFBN-RC.jpg

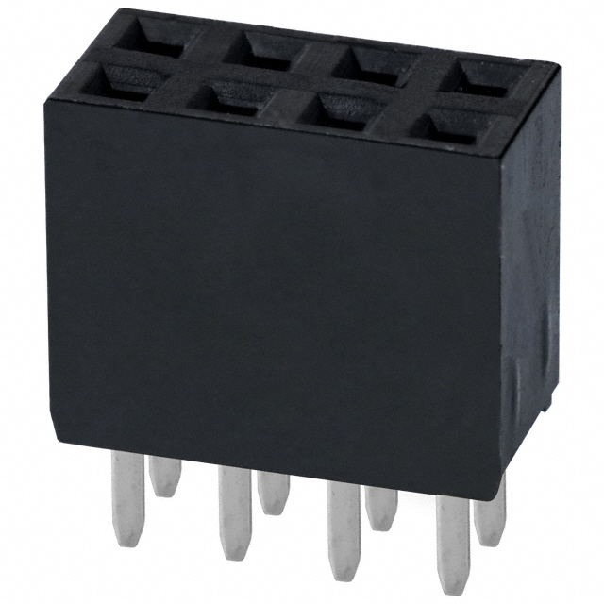
ElonMux/Images/PPTC042LFBN-RC.jpg
