EPFLXplore/Power_HW/ElonMux/Images/Switching freq graph.png

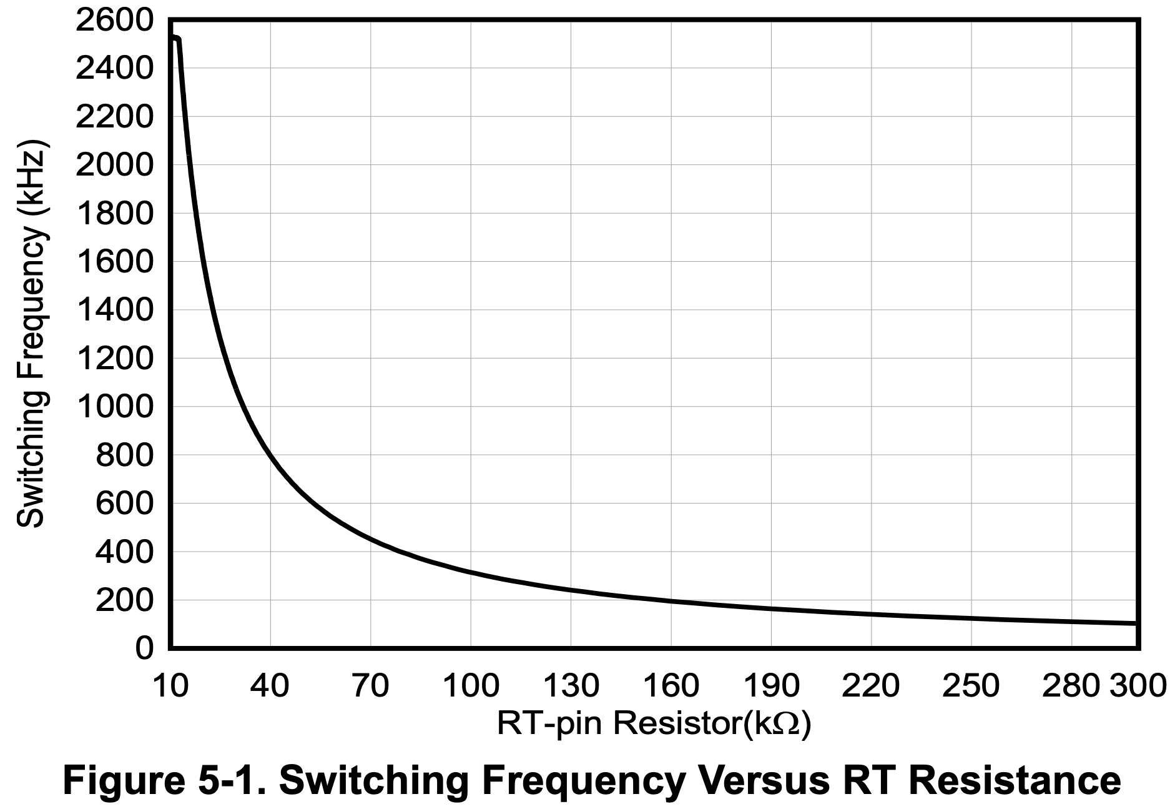
ElonMux/Images/Switching freq graph.png
