EPFLXplore/Power_HW/ElonMux/Thermal/FLIR0195.jpg

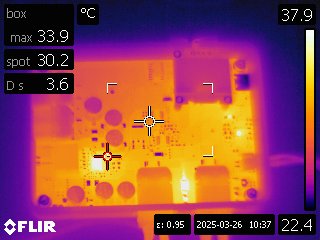
ElonMux/Thermal/FLIR0195.jpg
