EPFLXplore/Power_HW/ElonMux/Thermal/FLIR0197.jpg

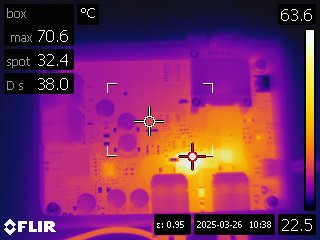
ElonMux/Thermal/FLIR0197.jpg
