EPFLXplore/Power_HW/ElonMux/Thermal/FLIR0199.jpg

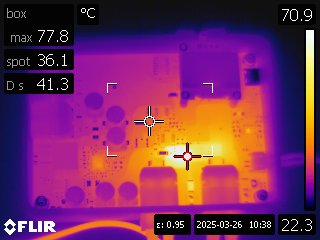
ElonMux/Thermal/FLIR0199.jpg
