EPFLXplore/Power_HW/ElonMux/Thermal/FLIR0201.jpg

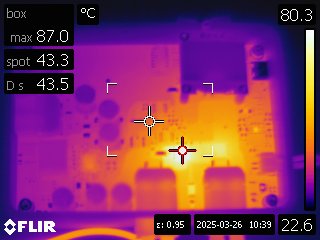
ElonMux/Thermal/FLIR0201.jpg
