EPFLXplore/Power_HW/ElonMux/Thermal/FLIR0203.jpg

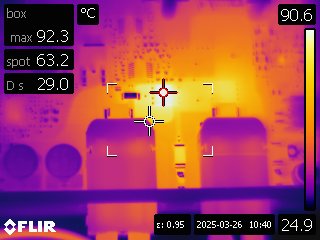
ElonMux/Thermal/FLIR0203.jpg
