EPFLXplore/Power_HW/ElonMux/Thermal/FLIR0207.jpg

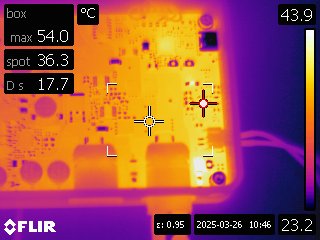
ElonMux/Thermal/FLIR0207.jpg
