EPFLXplore/Power_HW/ElonMux/Thermal/FLIR0209.jpg

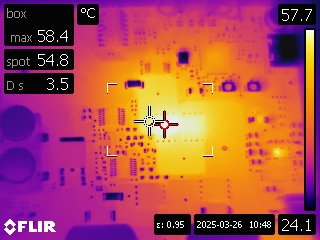
ElonMux/Thermal/FLIR0209.jpg
