EPFLXplore/Power_HW/ElonMux/Thermal/FLIR0211.jpg

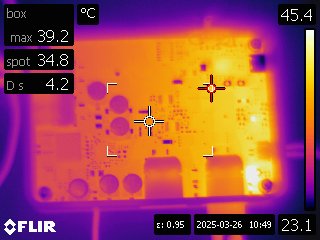
ElonMux/Thermal/FLIR0211.jpg
