EPFLXplore/Power_HW/ElonMux/Thermal/FLIR0213.jpg

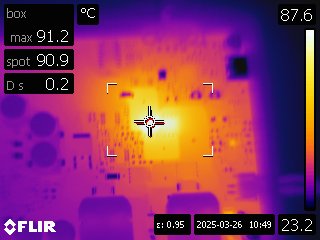
ElonMux/Thermal/FLIR0213.jpg
