EPFLXplore/Power_HW/ElonMux/Thermal/FLIR0215.jpg

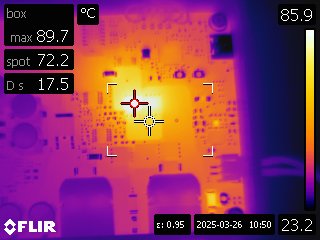
ElonMux/Thermal/FLIR0215.jpg
