EPFLXplore/Power_HW/ElonMux/Thermal/FLIR0217.jpg

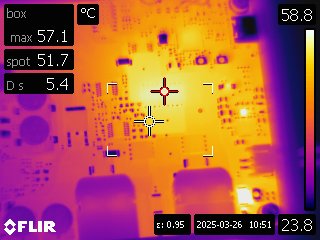
ElonMux/Thermal/FLIR0217.jpg
