EPFLXplore/Power_HW/ElonMux/Thermal/FLIR0219.jpg

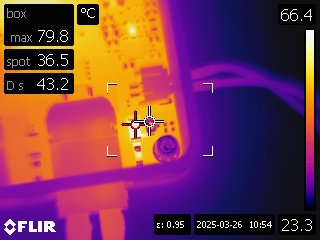
ElonMux/Thermal/FLIR0219.jpg
