EPFLXplore/Power_HW/ElonMux/Thermal/FLIR0221.jpg

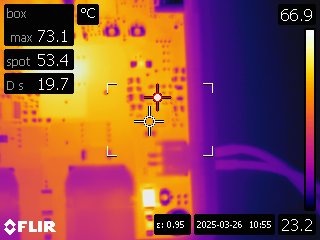
ElonMux/Thermal/FLIR0221.jpg
