EPFLXplore/Power_HW/ElonMux/Thermal/FLIR0223.jpg

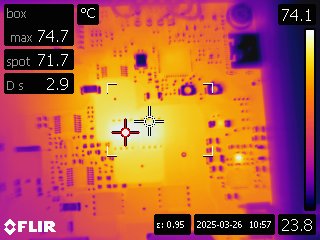
ElonMux/Thermal/FLIR0223.jpg
