EPFLXplore/Power_HW/GEODE/rev2/SMPS_legged_robot_module/footprints/Isolator/SI8630AB-B-IS.step

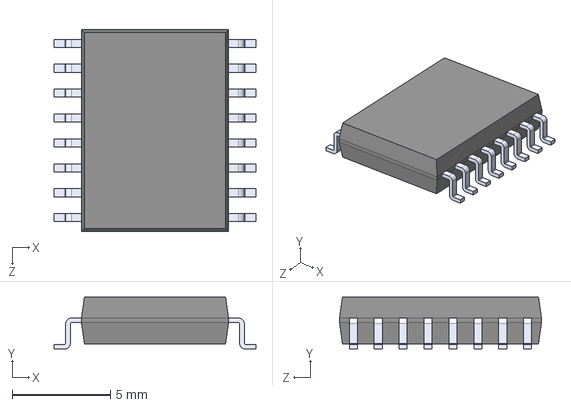
[picture p64: CAD file, 2025-02-26]
GEODE/rev2/SMPS_legged_robot_module/footprints/Isolator/SI8630AB-B-IS.step
10.3 x 2.65 x 10.3 mm
