EPFLXplore/Power_HW/GEODE/rev2/SMPS_legged_robot_module/footprints/Power module/LTC3889EUKG#PBF.stp

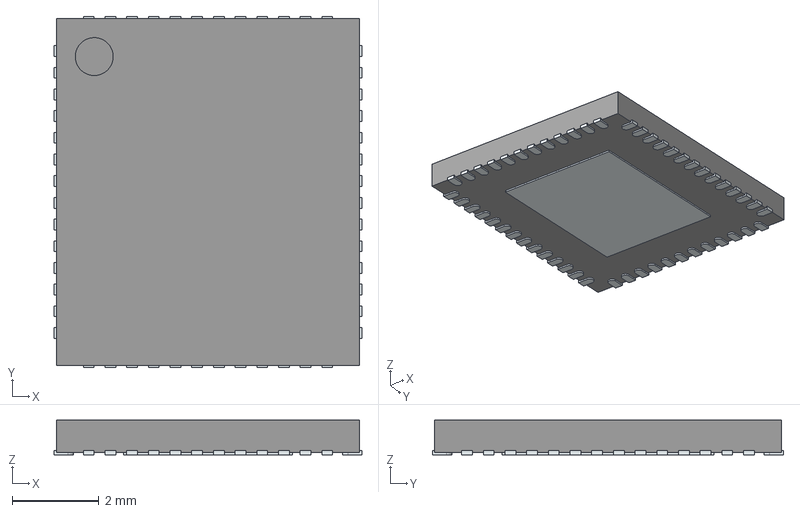
[picture p65: CAD file, 2025-02-26]
GEODE/rev2/SMPS_legged_robot_module/footprints/Power module/LTC3889EUKG#PBF.stp
7.10 x 8.10 x 0.8 mm
ThermalPin
PinsArrayLR
PinsArrayTB
