EPFLXplore/Power_HW/GEODE/rev2/SMPS_Motherboard/footprints/ampli/TPA6205A1DGN.stp

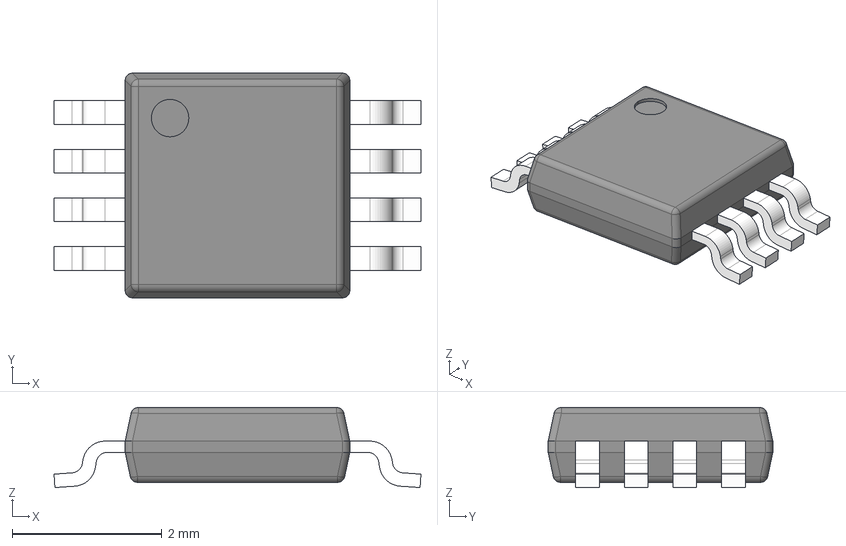
[picture p66: CAD file, 2025-02-26]
GEODE/rev2/SMPS_Motherboard/footprints/ampli/TPA6205A1DGN.stp
4.90 x 3.00 x 1.07 mm
BODY-DGN0008G
LEAD-DGN0008G x 8
PIN1_DGN0008G
DAP_DGN0008G
