EPFLXplore/Power_HW/GEODE/rev2/SMPS_Motherboard/footprints/connector/Input Voltage/XT90PW-F.STEP

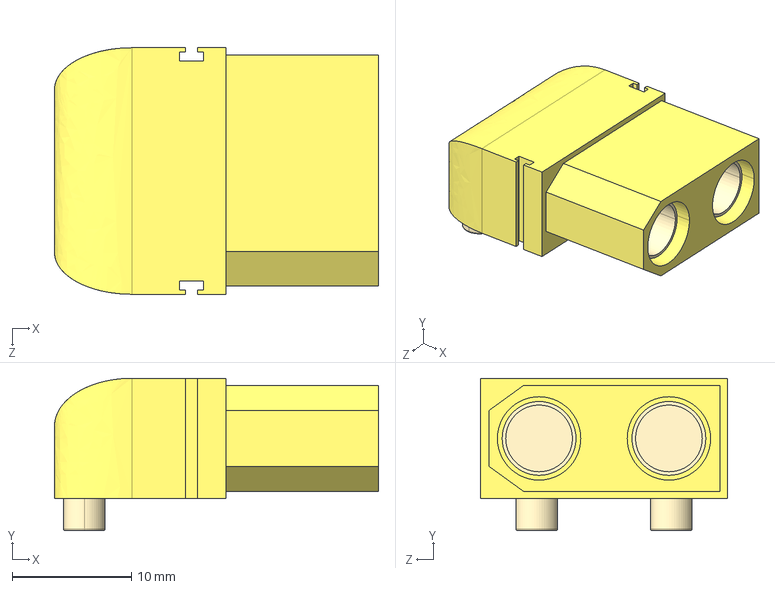
[picture p67: CAD file, 2025-02-26]
GEODE/rev2/SMPS_Motherboard/footprints/connector/Input Voltage/XT90PW-F.STEP
27.2 x 12.8 x 20.7 mm
