EPFLXplore/Power_HW/GEODE/rev2/SMPS_Motherboard/footprints/connector/Output Voltage/PJ-082BH.stp

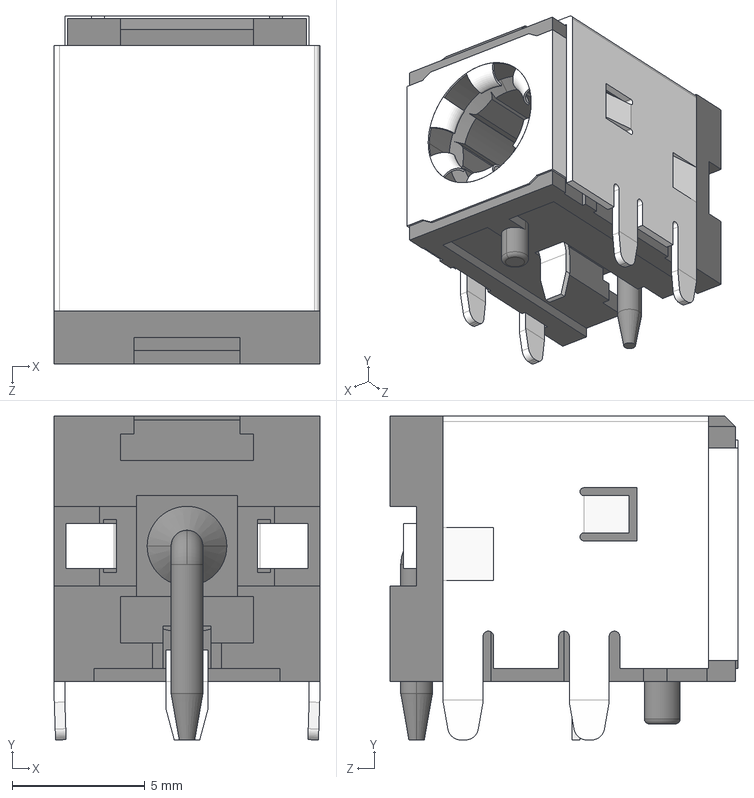
[picture p69: CAD file, 2025-02-26]
GEODE/rev2/SMPS_Motherboard/footprints/connector/Output Voltage/PJ-082BH.stp
10.0 x 12.2 x 13.1 mm
