EPFLXplore/Power_HW/GEODE/rev2/SMPS_Motherboard/footprints/EEPROM/M24C16-RMN6P.stp

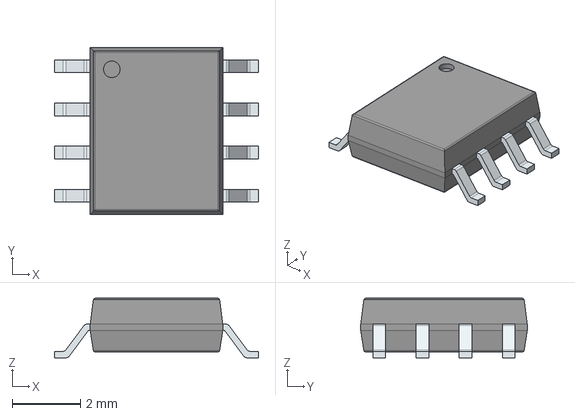
[picture p70: CAD file, 2025-02-26]
GEODE/rev2/SMPS_Motherboard/footprints/EEPROM/M24C16-RMN6P.stp
6.00 x 4.90 x 1.75 mm
PinsArrayLR
