EPFLXplore/Power_HW/GEODE/rev2/SMPS_Motherboard/footprints/EtherCAT/LAN9252_ML.stp

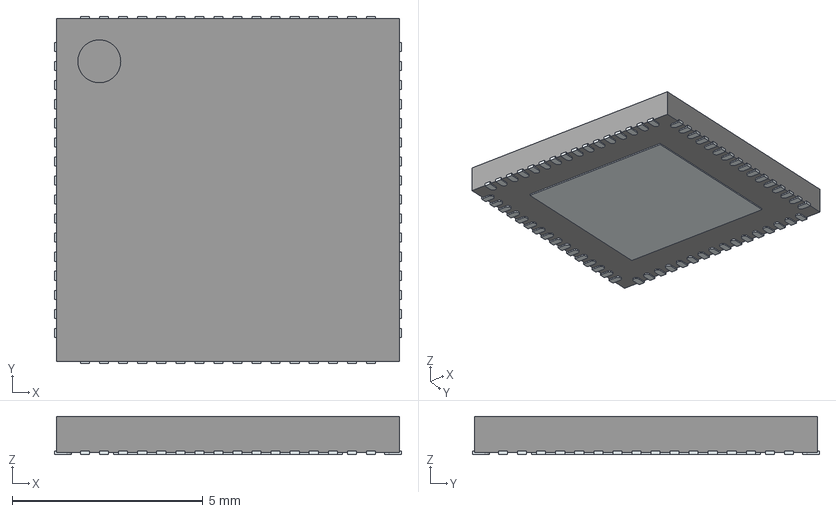
[picture p71: CAD file, 2025-02-26]
GEODE/rev2/SMPS_Motherboard/footprints/EtherCAT/LAN9252_ML.stp
9.10 x 9.10 x 1.00 mm
ThermalPin
PinsArrayLR
PinsArrayTB
