EPFLXplore/Power_HW/GEODE/rev2/SMPS_Motherboard/footprints/Power safety/Hot-Swap/TPS2490DGSRG4.stp

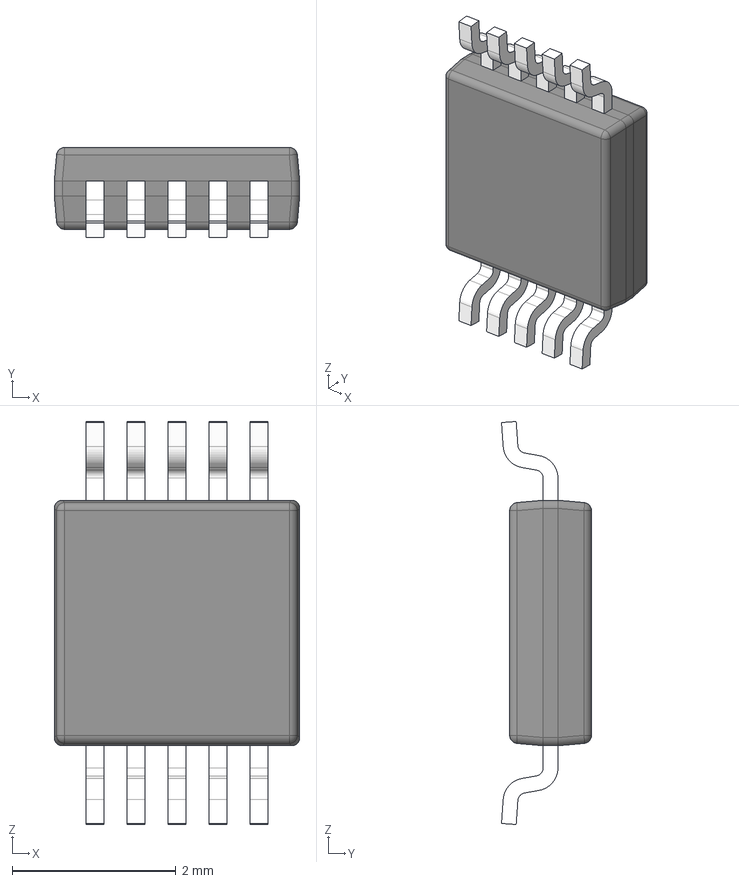
[picture p72: CAD file, 2025-02-26]
GEODE/rev2/SMPS_Motherboard/footprints/Power safety/Hot-Swap/TPS2490DGSRG4.stp
3.00 x 1.10 x 4.93 mm
BODY-SO
LEAD-SO x 10
PIN1-ID
