EPFLXplore/Power_HW/GEODE/rev2/SMPS_Motherboard/footprints/transistor/PSMN4R8-100BSEJ.stp

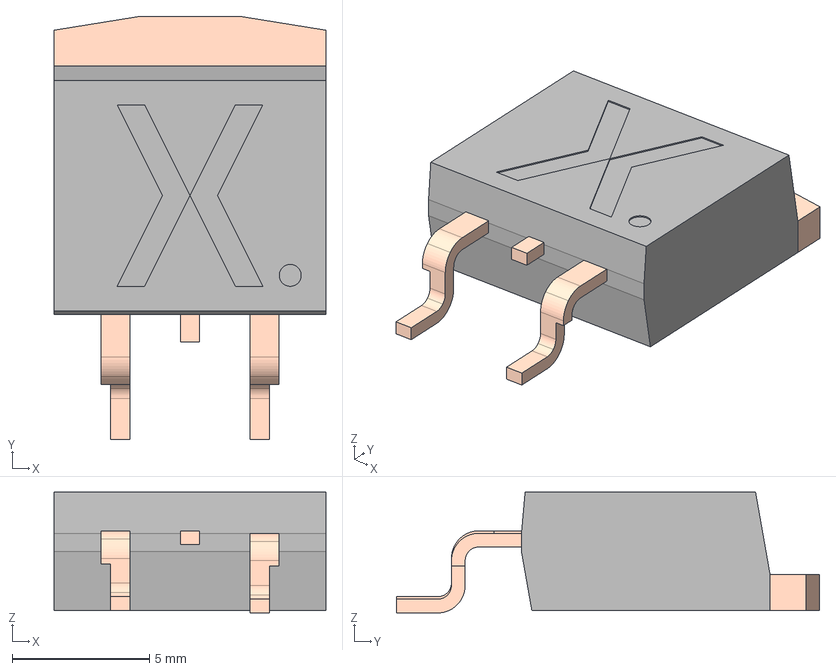
[picture p73: CAD file, 2025-02-26]
GEODE/rev2/SMPS_Motherboard/footprints/transistor/PSMN4R8-100BSEJ.stp
9.90 x 15.4 x 4.40 mm
