EPFLXplore/Power_HW/Pollux/Altium/Pollux III/Pollux III.step

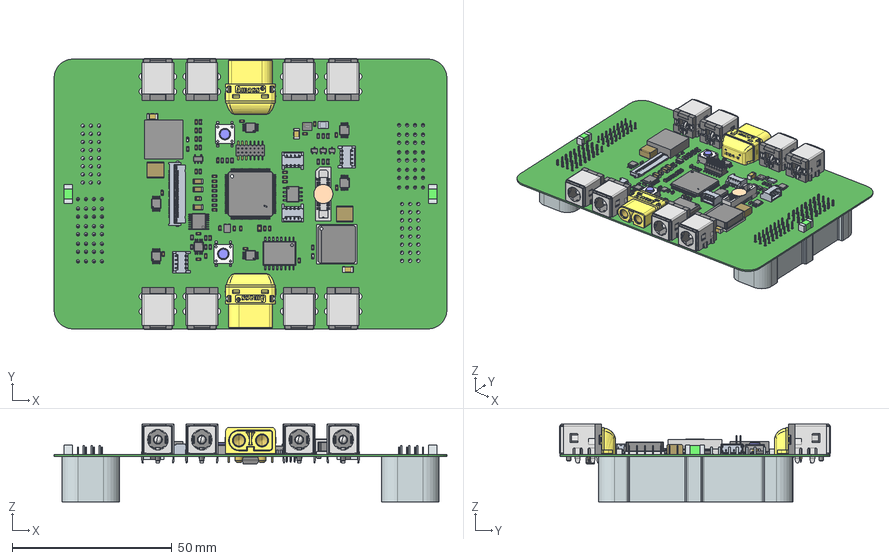
[picture p74: CAD file, 2026-09-20]
Pollux/Altium/Pollux III/Pollux III.step
123.0 x 84.7 x 24.4 mm
PinsArrayLR x 8
BODY_MUY08A
LEAD_MUY08A x 8
EXP_PAD_MUY08A
BODY_MF05A
LEAD_MF05F x 5
term1 x 33
term2 x 33
Pins x 4
CUI_DEVICES_PJ-082BH x 8
IC_BODY
circle
IC_LEG x 100
STMicroelectronics
LL3301_SMT x 2
TopPlate x 2
Plunger x 2
PinsArrayL x 3
FilletPinR x 3
RPMB-3.0
KRTB_DWLM32_32_20190603_geometry
_ERF5-020-05.0-DV_socket
_C-247-020-05.0
_K-DOT-.236-.343-.005_polyamide_pick
BODY-TSSOP
LEAD-TSSOP x 16
PIN1
FilletPin1
FilletPin2
