EPFLXplore/Power_HW/Pollux/Kicad/HVPowerModule/ALTIUM_EMBEDDED_MODELS/MCP47FEB02A0-E_ST.stp

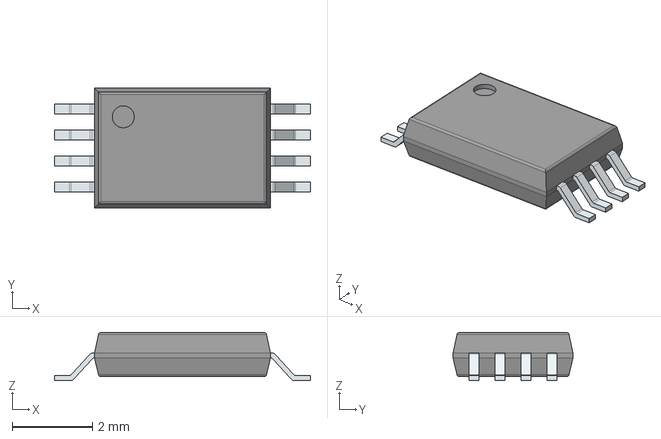
[picture p75: CAD file, 2026-09-20]
Pollux/Kicad/HVPowerModule/ALTIUM_EMBEDDED_MODELS/MCP47FEB02A0-E_ST.stp
6.40 x 3.00 x 1.20 mm
PinsArrayLR
