EPFLXplore/Power_HW/Pollux/Kicad/HVPowerModule/HVPowerModule.step

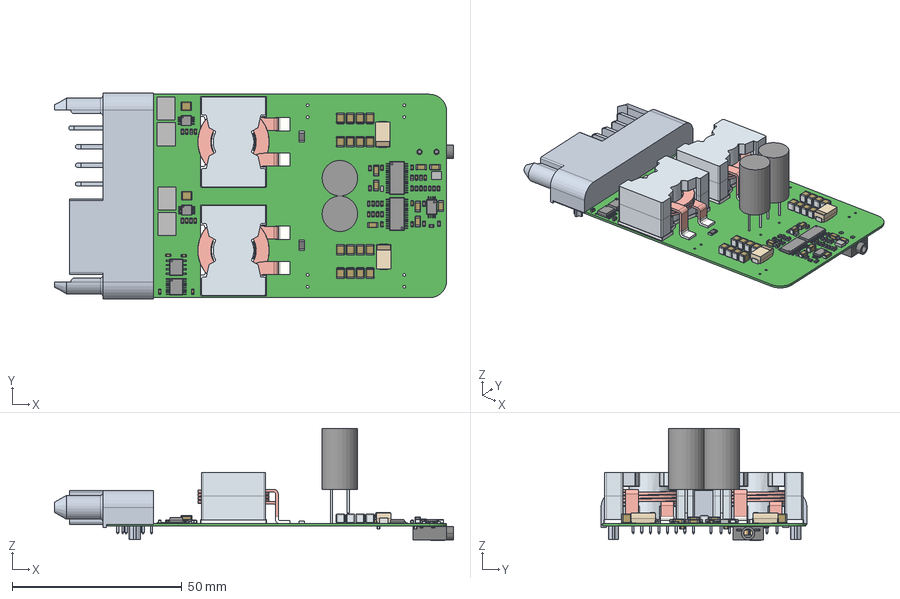
[picture p76: CAD file, 2026-09-20]
Pollux/Kicad/HVPowerModule/HVPowerModule.step
117.7 x 60.8 x 33.1 mm
PinsArrayLR x 7
BASE x 2
PIN x 2
PQ2614 x 4
COIL x 2
SimpleBody x 2
Pin1 x 2
Pin2 x 2
term1 x 22
term2 x 22
Extruded x 6
CAPMP76X43_31N_KEM x 2
ThermalPad x 2
