EPFLXplore/Power_HW/Pollux/Kicad/LVPowerModule/ALTIUM_EMBEDDED_MODELS/CRCW06033R00JNEA.stp

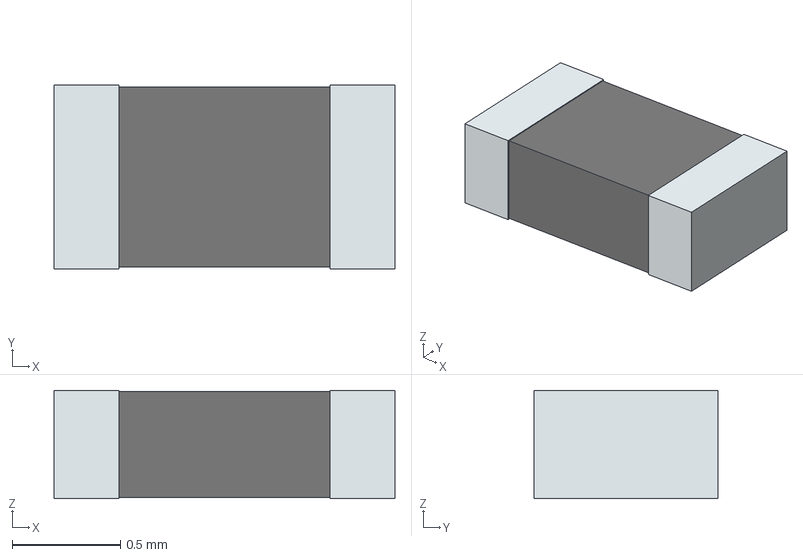
[picture p77: CAD file, 2026-09-20]
Pollux/Kicad/LVPowerModule/ALTIUM_EMBEDDED_MODELS/CRCW06033R00JNEA.stp
1.57 x 0.85 x 0.5 mm
term1
term2
