EPFLXplore/Power_HW/Pollux/Kicad/LVPowerModule/LVPowerModule.step

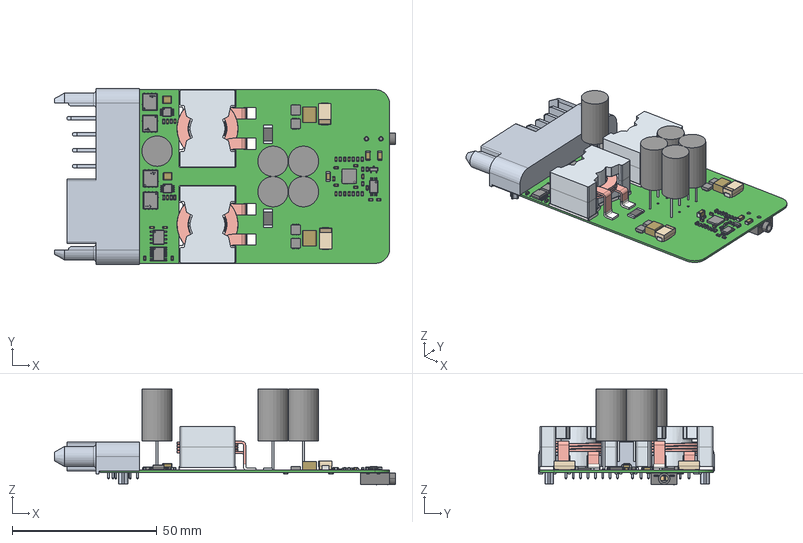
[picture p78: CAD file, 2026-09-20]
Pollux/Kicad/LVPowerModule/LVPowerModule.step
117.7 x 60.8 x 33.1 mm
SimpleBody x 5
Pin1 x 5
Pin2 x 5
PinsArrayLR x 6
term1 x 27
term2 x 27
Infineon_Logo x 4
PinsArrayL
FilletPinR
CAPMP76X43_31N_KEM x 2
Pins x 4
BASE x 2
PIN x 2
PQ2614 x 4
COIL x 2
ThermalPin
PinsArrayTB
