EPFLXplore/Power_HW/Pollux/Kicad/HVPowerModule/ALTIUM_EMBEDDED_MODELS/C1206C105M5RECTU.stp

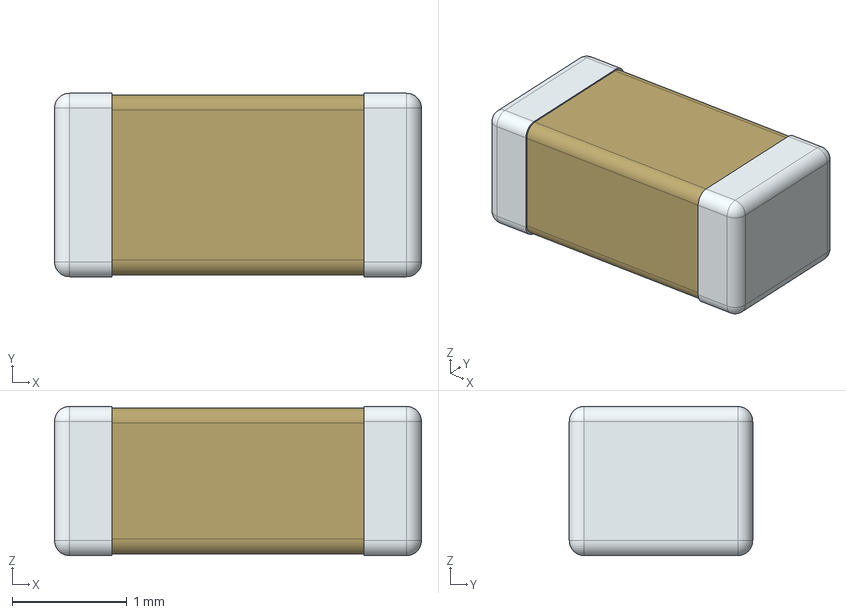
[picture p80: CAD file, 2026-09-20]
Pollux/Kicad/HVPowerModule/ALTIUM_EMBEDDED_MODELS/C1206C105M5RECTU.stp
3.20 x 1.60 x 1.30 mm
