EPFLXplore/Power_HW/Pollux/Kicad/LVPowerModule/ALTIUM_EMBEDDED_MODELS/CAPMP76X43_31N_KEM.step

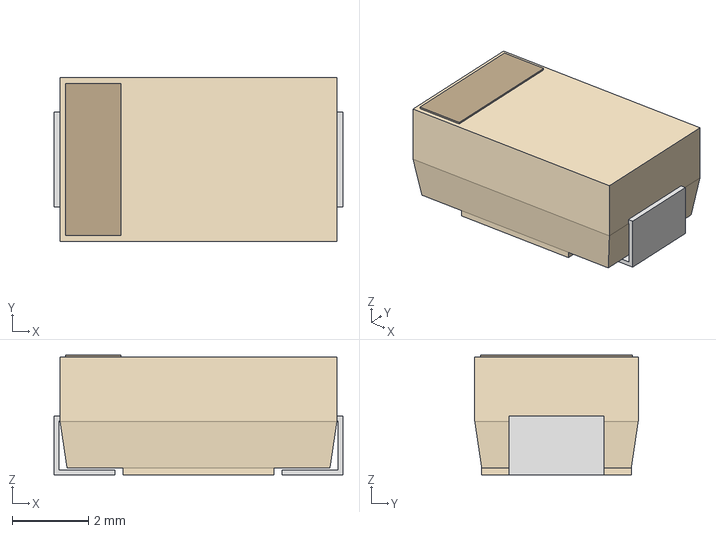
[picture p81: CAD file, 2026-09-20]
Pollux/Kicad/LVPowerModule/ALTIUM_EMBEDDED_MODELS/CAPMP76X43_31N_KEM.step
7.60 x 4.30 x 3.15 mm
