EPFLXplore/Power_HW/Pollux/Kicad/HVPowerModule/ALTIUM_EMBEDDED_MODELS/PCS1206FR0030ET.stp

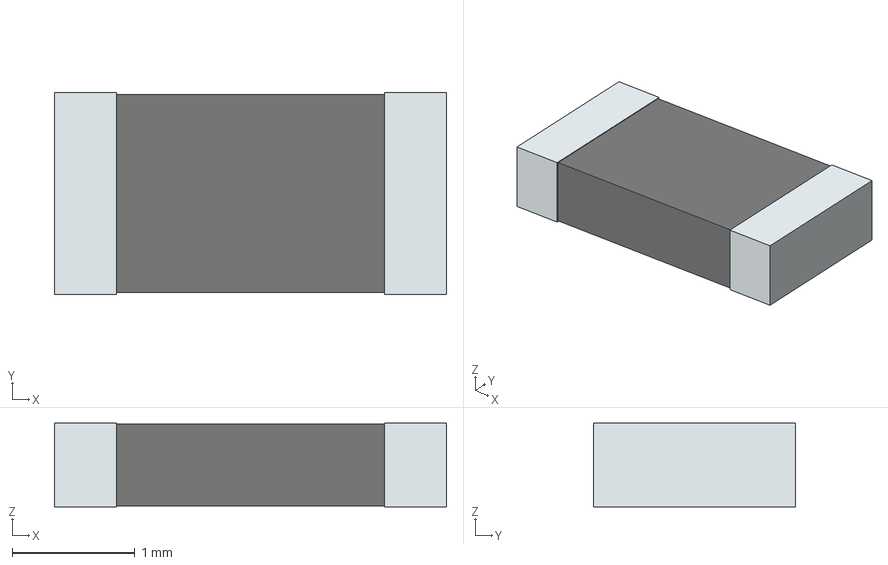
[picture p82: CAD file, 2026-09-20]
Pollux/Kicad/HVPowerModule/ALTIUM_EMBEDDED_MODELS/PCS1206FR0030ET.stp
3.20 x 1.65 x 0.684 mm
term1
term2
