EPFLXplore/Power_HW/Pollux/Kicad/LVPowerModule/ALTIUM_EMBEDDED_MODELS/CRF2512-FZ-R005ELF.stp

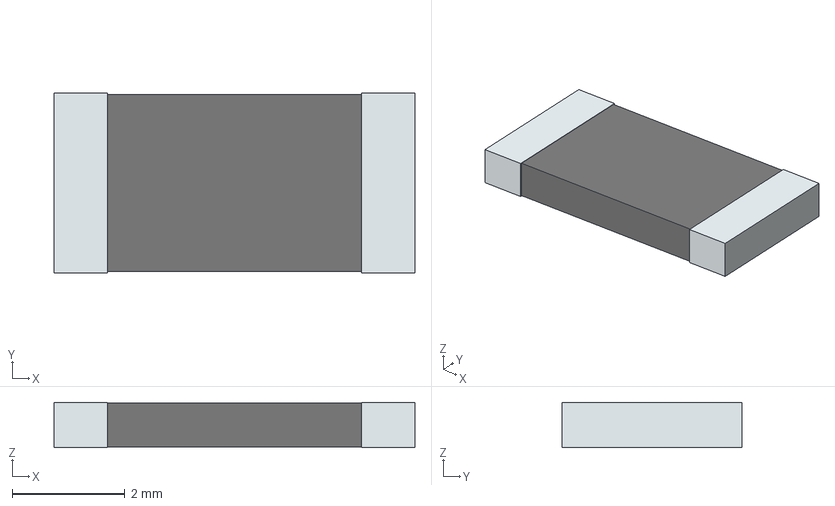
[picture p83: CAD file, 2026-09-20]
Pollux/Kicad/LVPowerModule/ALTIUM_EMBEDDED_MODELS/CRF2512-FZ-R005ELF.stp
6.40 x 3.20 x 0.8 mm
term1
term2
