EPFLXplore/Power_HW/Pollux/Kicad/HVPowerModule/ALTIUM_EMBEDDED_MODELS/SI8640EB-B-IU.stp

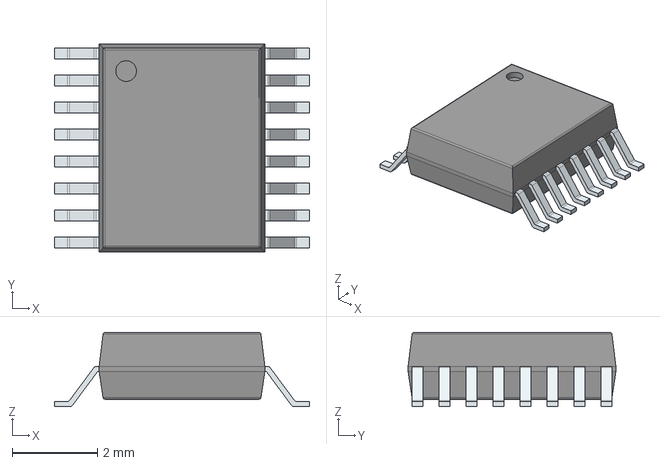
[picture p84: CAD file, 2026-09-20]
Pollux/Kicad/HVPowerModule/ALTIUM_EMBEDDED_MODELS/SI8640EB-B-IU.stp
6.00 x 4.89 x 1.75 mm
PinsArrayLR
