EPFLXplore/Power_HW/Pollux/Kicad/LVPowerModule/ALTIUM_EMBEDDED_MODELS/C0603C101J5RACTU.stp

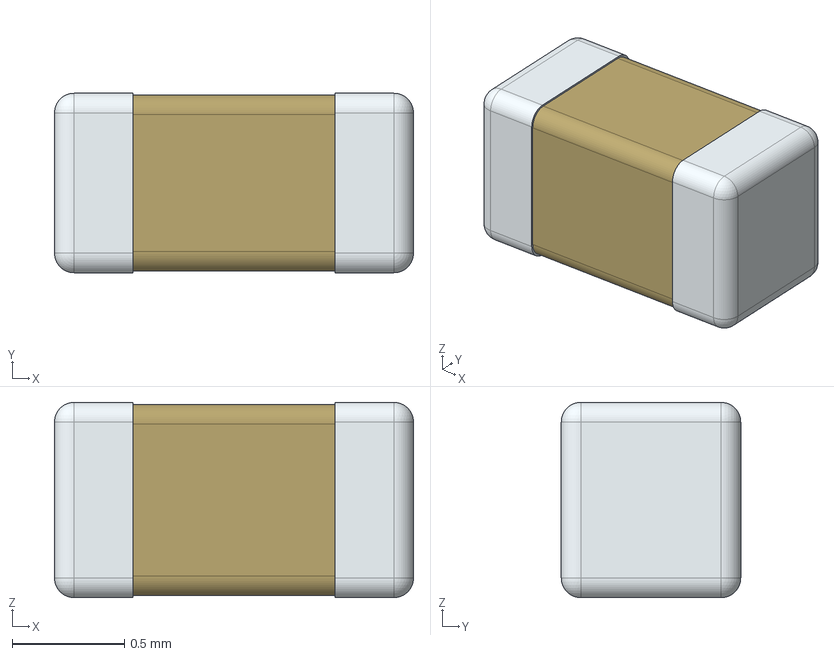
[picture p85: CAD file, 2026-09-20]
Pollux/Kicad/LVPowerModule/ALTIUM_EMBEDDED_MODELS/C0603C101J5RACTU.stp
1.60 x 0.8 x 0.87 mm
