EPFLXplore/Power_HW/Pollux/Kicad/HVPowerModule/ALTIUM_EMBEDDED_MODELS/C1210C106K5RACTU.stp

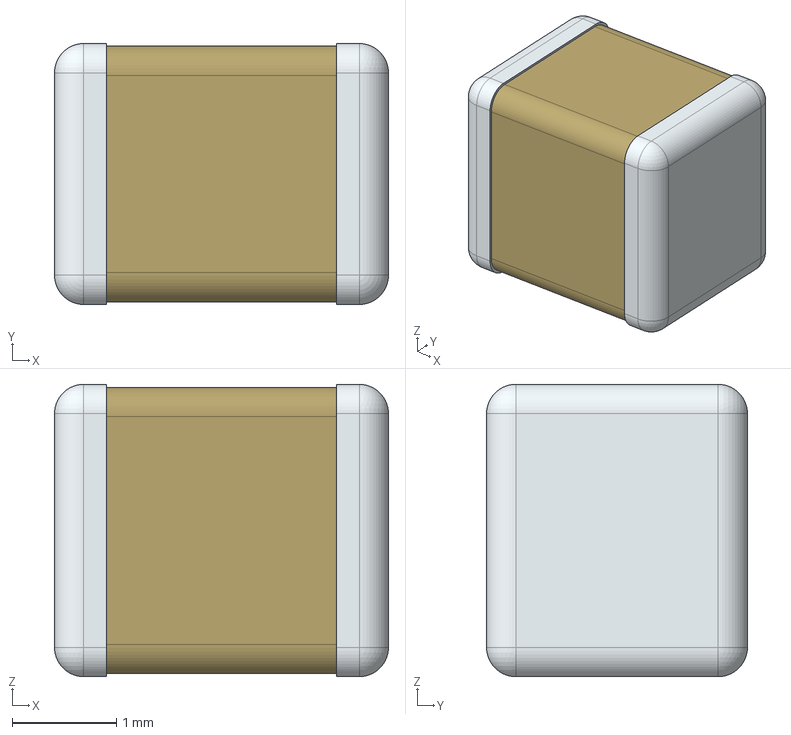
[picture p86: CAD file, 2026-09-20]
Pollux/Kicad/HVPowerModule/ALTIUM_EMBEDDED_MODELS/C1210C106K5RACTU.stp
3.20 x 2.50 x 2.80 mm
