EPFLXplore/Power_HW/Pollux/Kicad/LVPowerModule/ALTIUM_EMBEDDED_MODELS/C1206X475M5RACAUTO.stp

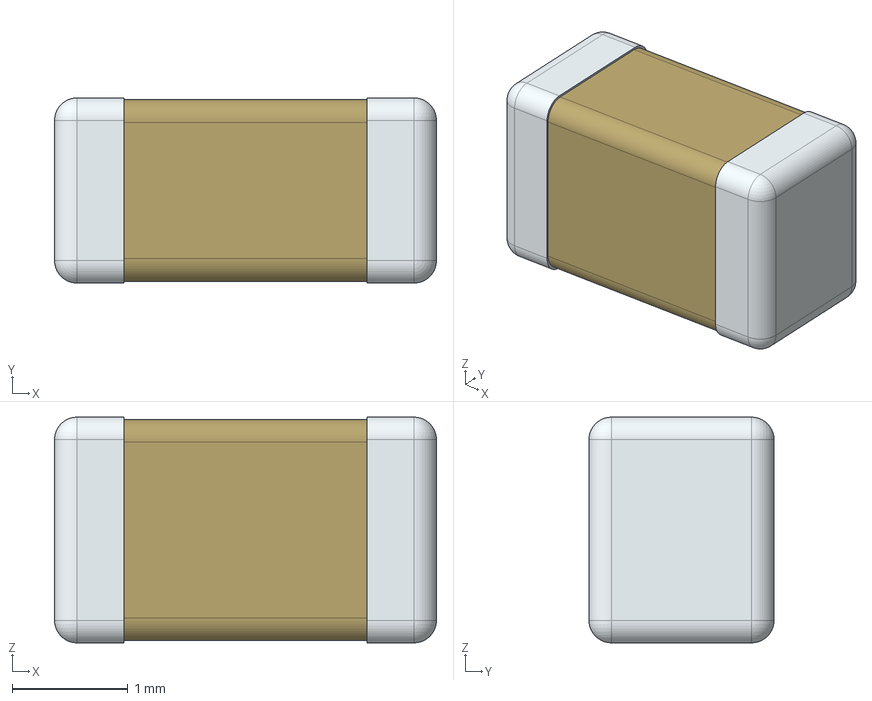
[picture p87: CAD file, 2026-09-20]
Pollux/Kicad/LVPowerModule/ALTIUM_EMBEDDED_MODELS/C1206X475M5RACAUTO.stp
3.30 x 1.60 x 1.95 mm
