EPFLXplore/Power_HW/Pollux/Kicad/LVPowerModule/ALTIUM_EMBEDDED_MODELS/C5750X7S2A106K230KB.stp

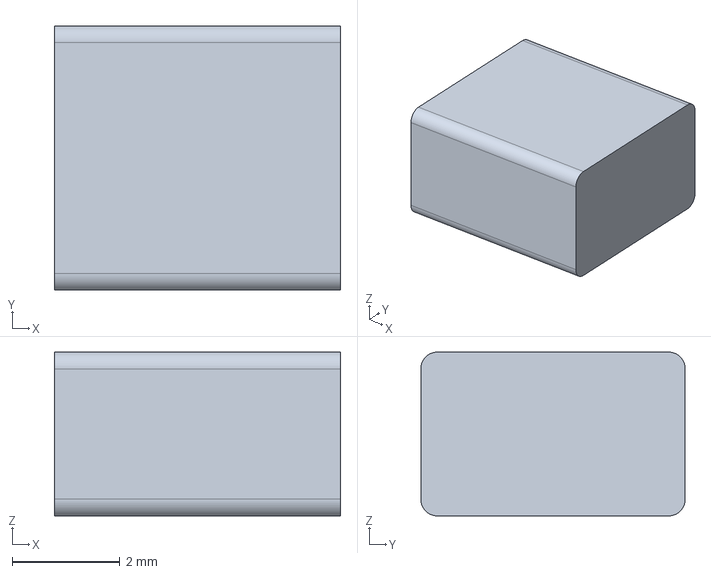
[picture p88: CAD file, 2026-09-20]
Pollux/Kicad/LVPowerModule/ALTIUM_EMBEDDED_MODELS/C5750X7S2A106K230KB.stp
5.30 x 4.90 x 3.04 mm
