EPFLXplore/Power_HW/Pollux/Kicad/HVPowerModule/ALTIUM_EMBEDDED_MODELS/CGA3E2X7R1H683K080AA.stp

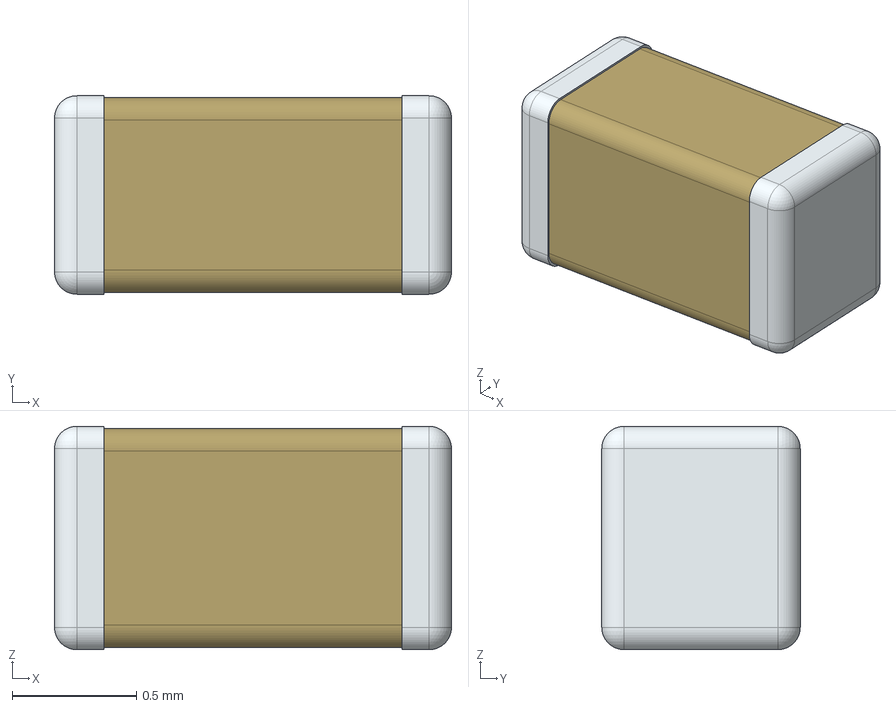
[picture p89: CAD file, 2026-09-20]
Pollux/Kicad/HVPowerModule/ALTIUM_EMBEDDED_MODELS/CGA3E2X7R1H683K080AA.stp
1.60 x 0.8 x 0.9 mm
