EPFLXplore/Power_HW/Pollux/Kicad/LVPowerModule/ALTIUM_EMBEDDED_MODELS/C0603C104M4RACTU.stp

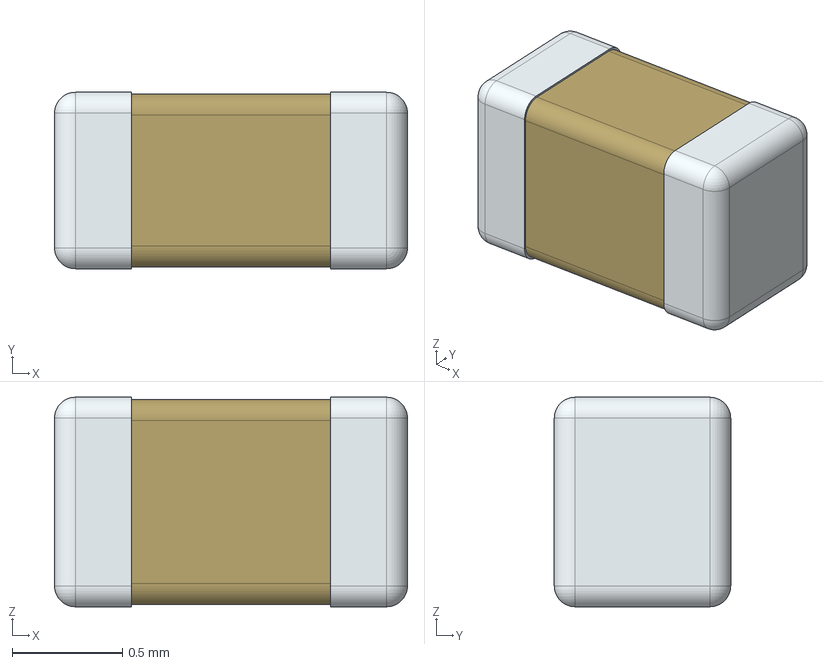
[picture p90: CAD file, 2026-09-20]
Pollux/Kicad/LVPowerModule/ALTIUM_EMBEDDED_MODELS/C0603C104M4RACTU.stp
1.60 x 0.8 x 0.95 mm
