EPFLXplore/Power_HW/Pollux/Kicad/LVPowerModule/ALTIUM_EMBEDDED_MODELS/C3225X7R1H106K250AC.stp

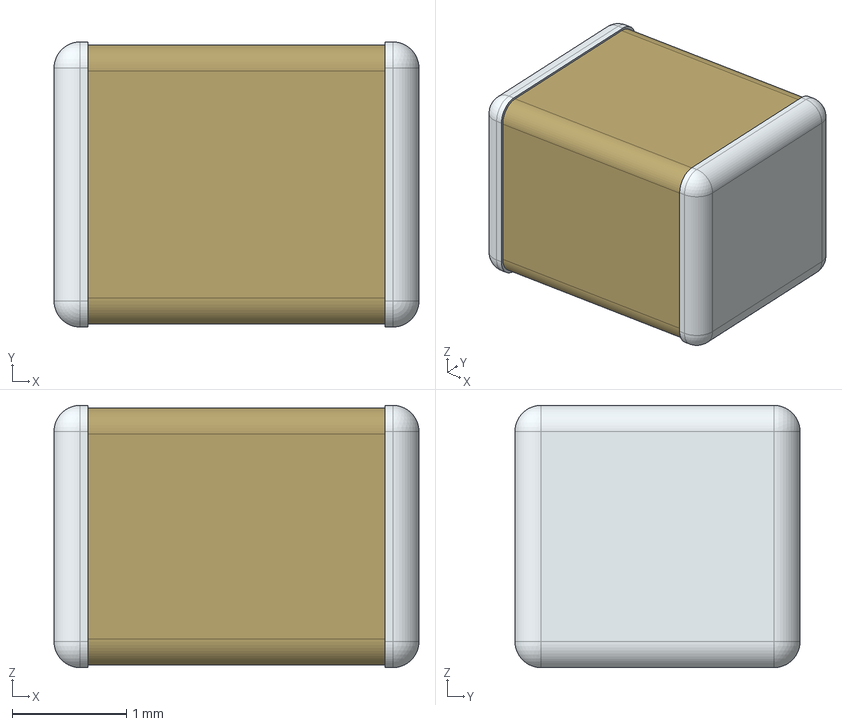
[picture p92: CAD file, 2026-09-20]
Pollux/Kicad/LVPowerModule/ALTIUM_EMBEDDED_MODELS/C3225X7R1H106K250AC.stp
3.20 x 2.50 x 2.30 mm
