EPFLXplore/Power_HW/Pollux/Kicad/HVPowerModule/ALTIUM_EMBEDDED_MODELS/LTC3892EFE-1#PBF.stp

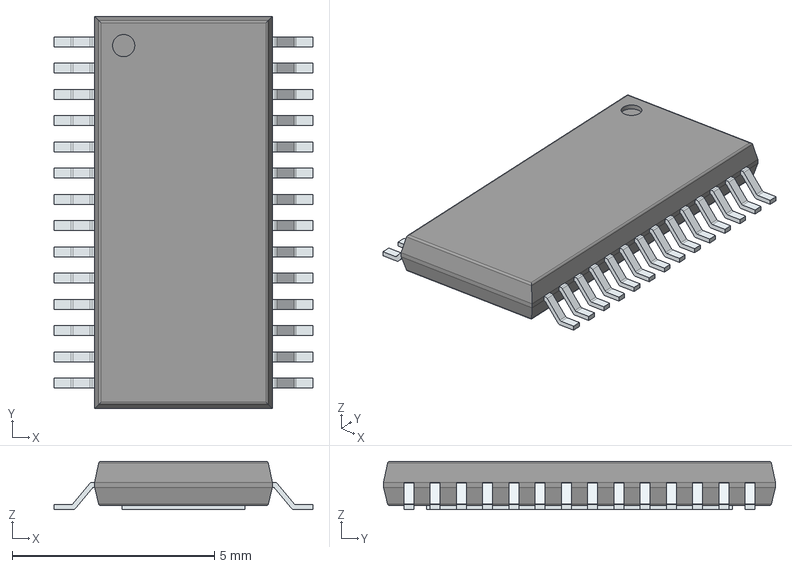
[picture p93: CAD file, 2026-09-20]
Pollux/Kicad/HVPowerModule/ALTIUM_EMBEDDED_MODELS/LTC3892EFE-1#PBF.stp
6.40 x 9.70 x 1.20 mm
PinsArrayLR
ThermalPad
