EPFLXplore/Power_HW/Pollux/Kicad/LVPowerModule/ALTIUM_EMBEDDED_MODELS/MCP1799T-3302H_TT.stp

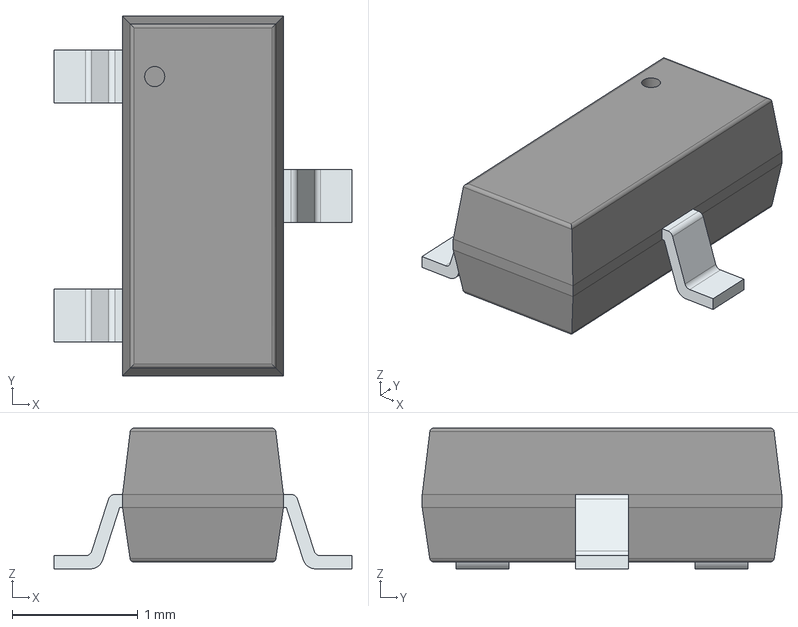
[picture p94: CAD file, 2026-09-20]
Pollux/Kicad/LVPowerModule/ALTIUM_EMBEDDED_MODELS/MCP1799T-3302H_TT.stp
2.37 x 2.86 x 1.12 mm
PinsArrayL
FilletPinR
