EPFLXplore/Power_HW/Pollux/Kicad/HVPowerModule/ALTIUM_EMBEDDED_MODELS/NE555DR.stp

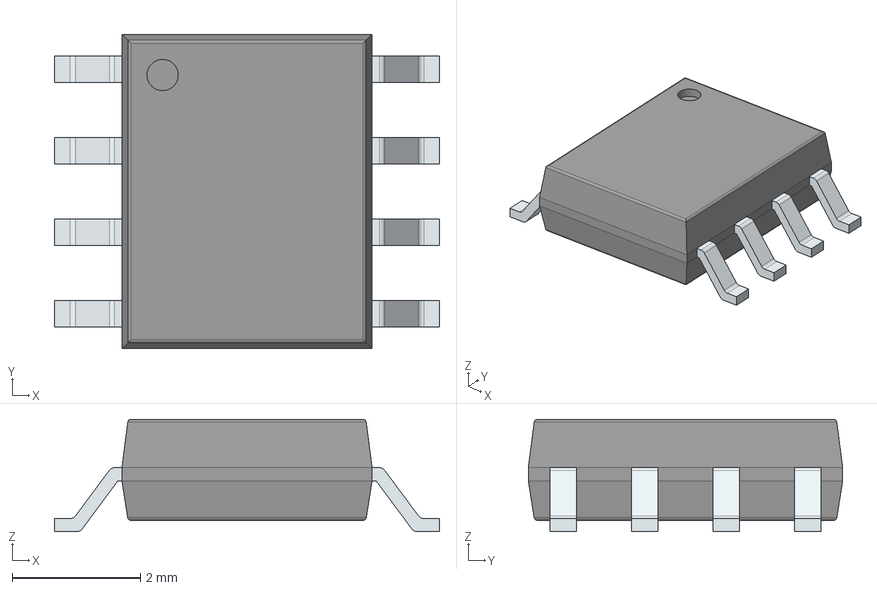
[picture p95: CAD file, 2026-09-20]
Pollux/Kicad/HVPowerModule/ALTIUM_EMBEDDED_MODELS/NE555DR.stp
6.00 x 4.90 x 1.75 mm
PinsArrayLR
