EPFLXplore/Power_HW/Pollux/Kicad/LVPowerModule/ALTIUM_EMBEDDED_MODELS/ERA-3ARB332V.stp

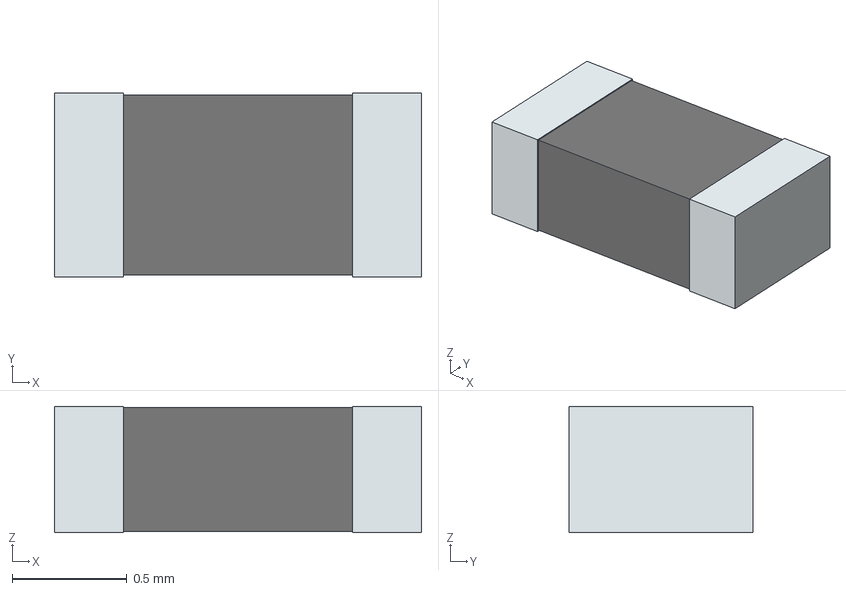
[picture p96: CAD file, 2026-09-20]
Pollux/Kicad/LVPowerModule/ALTIUM_EMBEDDED_MODELS/ERA-3ARB332V.stp
1.60 x 0.8 x 0.55 mm
term1
term2
