EPFLXplore/Power_HW/Pollux/Kicad/HVPowerModule/ALTIUM_EMBEDDED_MODELS/C1206C105K5RAC.stp

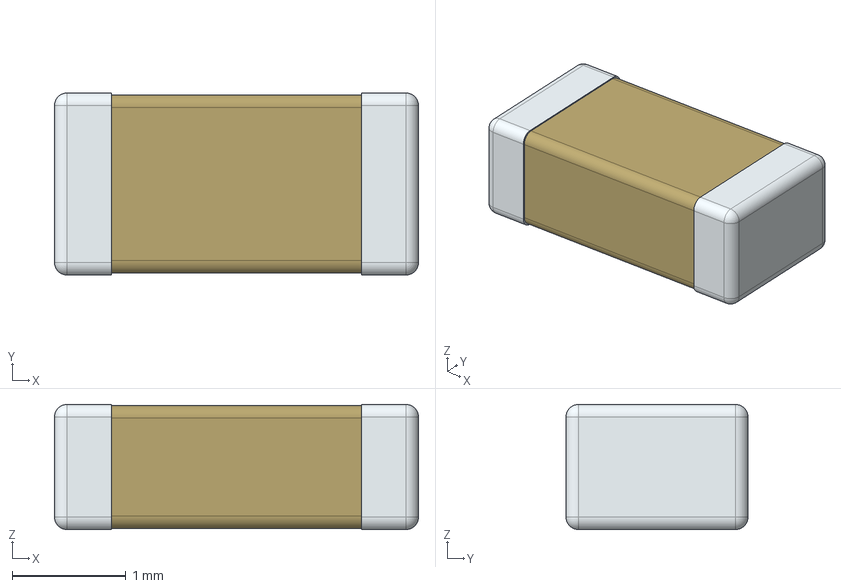
[picture p97: CAD file, 2026-09-20]
Pollux/Kicad/HVPowerModule/ALTIUM_EMBEDDED_MODELS/C1206C105K5RAC.stp
3.20 x 1.60 x 1.10 mm
