EPFLXplore/Power_HW/Pollux/Kicad/LVPowerModule/ALTIUM_EMBEDDED_MODELS/A750MW687M1VAAE018.stp

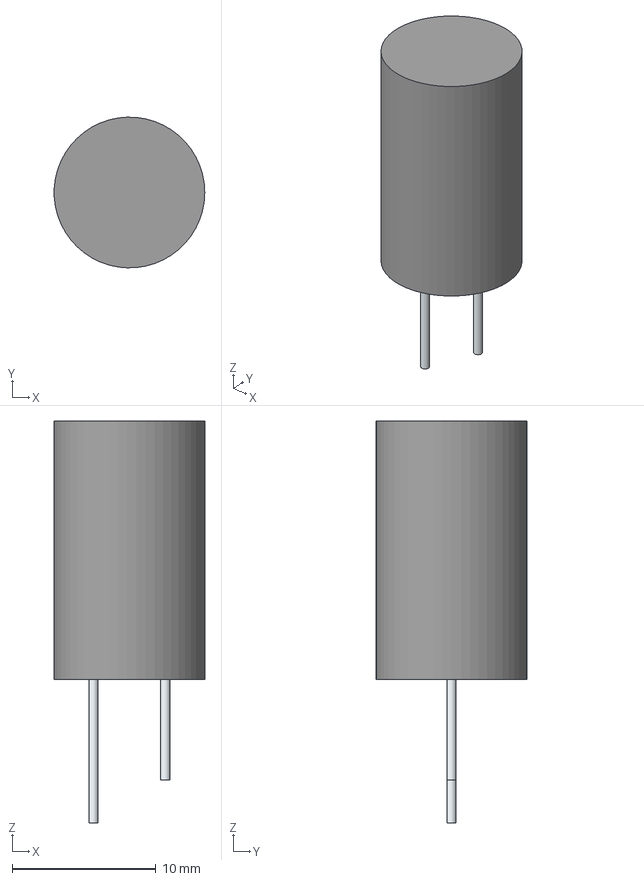
[picture p98: CAD file, 2026-09-20]
Pollux/Kicad/LVPowerModule/ALTIUM_EMBEDDED_MODELS/A750MW687M1VAAE018.stp
10.5 x 10.5 x 28.0 mm
SimpleBody
Pin1
Pin2
