EPFLXplore/Power_HW/Pollux/Kicad/HVPowerModule/ALTIUM_EMBEDDED_MODELS/PQ2614BLA (1).stp

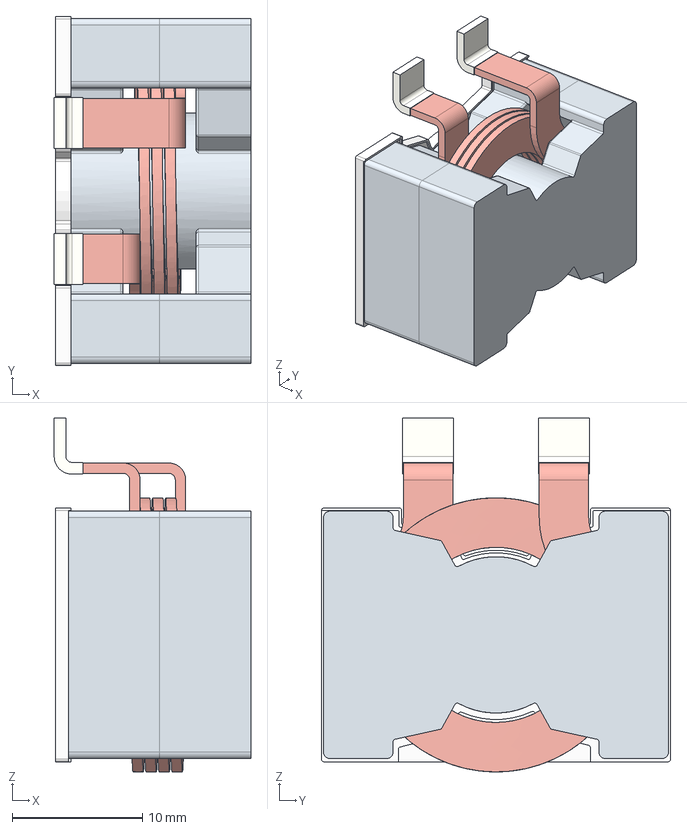
[picture p99: CAD file, 2026-09-20]
Pollux/Kicad/HVPowerModule/ALTIUM_EMBEDDED_MODELS/PQ2614BLA (1).stp
15.1 x 26.8 x 27.2 mm
BASE
PIN
PQ2614 x 2
COIL
