EPFLXplore/Power_HW/Pollux/Kicad/LVPowerModule/ALTIUM_EMBEDDED_MODELS/BSZ011NE2LS5IATMA1.stp

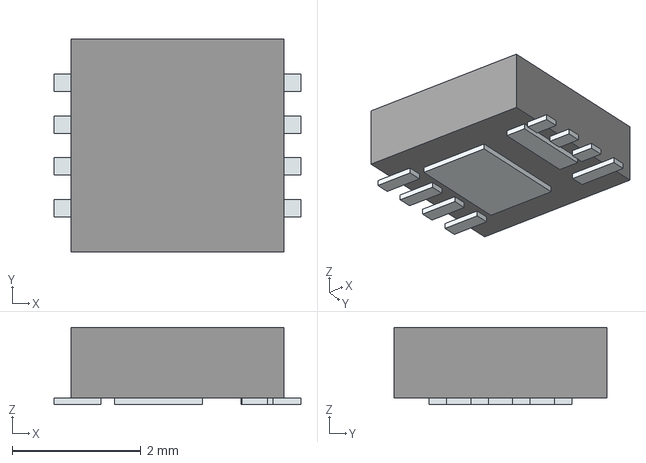
[picture p101: CAD file, 2026-09-20]
Pollux/Kicad/LVPowerModule/ALTIUM_EMBEDDED_MODELS/BSZ011NE2LS5IATMA1.stp
3.83 x 3.30 x 1.20 mm
Pins
