EPFLXplore/Power_HW/Pollux/Kicad/LVPowerModule/ALTIUM_EMBEDDED_MODELS/Trans_Infineon_BSC016N06NSATMA1_eec.STEP

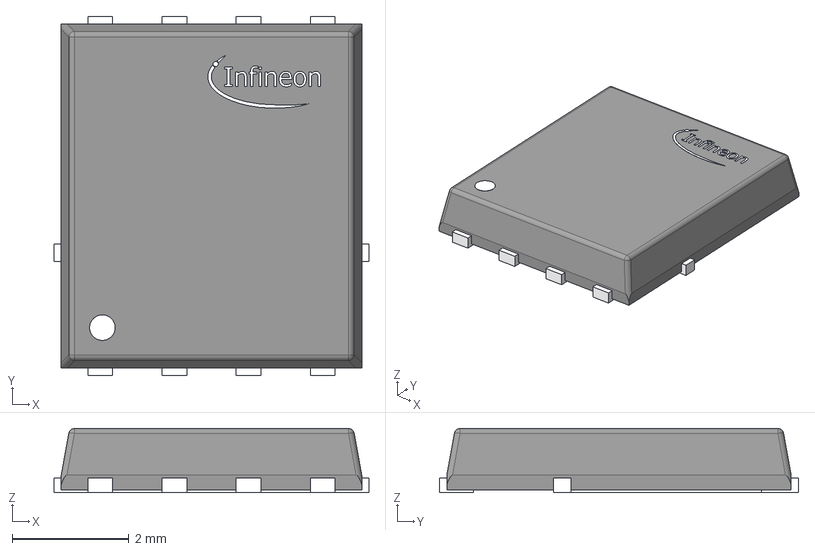
[picture p102: CAD file, 2026-09-20]
Pollux/Kicad/LVPowerModule/ALTIUM_EMBEDDED_MODELS/Trans_Infineon_BSC016N06NSATMA1_eec.STEP
5.39 x 6.15 x 1.10 mm
