EPFLXplore/Power_HW/Pollux/Kicad/HVPowerModule/ALTIUM_EMBEDDED_MODELS/LTC4372CMS8#TRPBF.stp

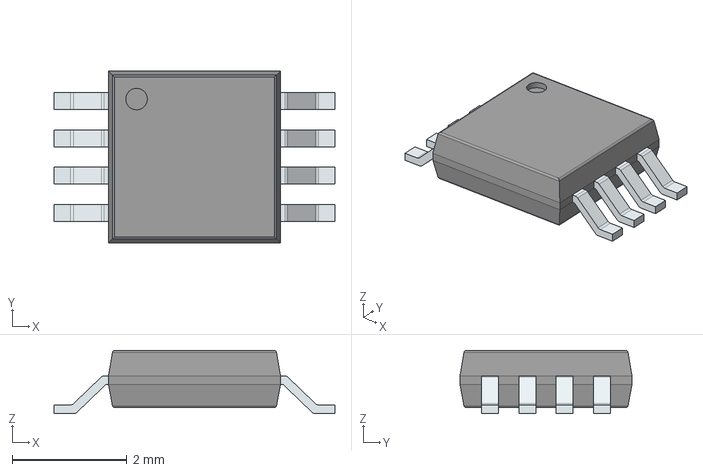
[picture p103: CAD file, 2025-02-26]
Pollux/Kicad/HVPowerModule/ALTIUM_EMBEDDED_MODELS/LTC4372CMS8#TRPBF.stp
4.90 x 3.00 x 1.10 mm
PinsArrayLR
