EPFLXplore/Power_HW/(list of files, cad)

Other CAD files:
Pollux/Kicad/HVPowerModule/ALTIUM_EMBEDDED_MODELS/CRCW0603118KFKEA.stp
Pollux/Kicad/LVPowerModule/ALTIUM_EMBEDDED_MODELS/CRCW0603118KFKEA.stp
GEODE/rev1/Documentation/KiCAD design files/SMPS_Motherboard/footprints/connector/Board to board/10159558-410421RLF.step
GEODE/rev1/Documentation/KiCAD design files/SMPS_Motherboard/footprints/connector/Board to board/10159558-410421RLF.stp
GEODE/rev1/Documentation/KiCAD design files/SMPS_Motherboard/footprints/connector/ETH/74980111211_Download_STP_74980111211_rev1.stp
GEODE/rev1/Documentation/KiCAD design files/SMPS_Motherboard/footprints/connector/ampli/53048-0450.stp
GEODE/rev1/Documentation/KiCAD design files/SMPS_Motherboard/footprints/different/fuse/0451015.MRL.stp
GEODE/rev1/SMPS_Motherboard/footprints/connector/Board to board/10159558-410421RLF.step
GEODE/rev1/SMPS_Motherboard/footprints/connector/Board to board/10159558-410421RLF.stp
GEODE/rev1/SMPS_Motherboard/footprints/connector/ETH/74980111211_Download_STP_74980111211_rev1.stp
GEODE/rev1/SMPS_Motherboard/footprints/connector/ampli/53048-0450.stp
GEODE/rev1/SMPS_Motherboard/footprints/different/fuse/0451015.MRL.stp
GEODE/rev2/SMPS_Motherboard/footprints/connector/Board to board/10159558-410421RLF.step
GEODE/rev2/SMPS_Motherboard/footprints/connector/Board to board/10159558-410421RLF.stp
GEODE/rev2/SMPS_Motherboard/footprints/connector/ETH/74980111211_Download_STP_74980111211_rev1.stp
GEODE/rev2/SMPS_Motherboard/footprints/connector/ampli/53048-0450.stp
GEODE/rev2/SMPS_Motherboard/footprints/different/fuse/0451015.MRL.stp
Pollux/Kicad/HVPowerModule/ALTIUM_EMBEDDED_MODELS/464373001.stp
Pollux/Kicad/LVPowerModule/ALTIUM_EMBEDDED_MODELS/464373001.stp
