EPFLXplore/Power_HW/Wagos/power_hat_prots_ina/computations/ADM/ADM1270 Design Guide Readme.pdf

### ADM1270 Hotswap controller Design Guide

By Glenn Morita
[glenn.morita@analog.com]

Note: The section titles correspond to the design tool sections.

System Specifications
The following conditions are assumed for this example:
- Controller = ADM1270
- VIN = 32 V Nominal
- VIN = 20 V Minimum
- 18V Power Good Threshold
- 8.7V UV Threshold
- 37.5V OV Threshold
- VMAX = 55V
- ITRIP = 450 mA
- CLOAD = 100 µF
- TAMAX = 60°C
- RPOWERUP = 500Ω (static load resistance during system power up)
To simplify this example, the calculations exclude the effects of component tolerances. These tolerances should of course be considered when designing for worst-case conditions. Note also there may be slight differences in the numbers quoted here compared to the design tool. In this case the tool takes precedence.

Sense Resistor/Vdrop Selection
Tool Section 2
The sense resistor chosen is primarily based on the required circuit breaker trip current. However, the ADM1270 has an adjustable current limit threshold which allows for fine tuning of the current limit beyond that provided by the limited availability of standard sense resistor values. The sense voltage can be programmed within a 12.5 to 62.5 mV range. Such a low sense voltage, along with the flexibility of programmability, offers reduced power loss and size in sense resistor selection. The circuit breaker timer (current fault glitch filter) begins is typically 1mV below the regulation point. This means that to set a trip point of 450 mA(45mV) we need to set the regulation point to ~460 mA (46mV).
= | = | ≈ | mΩ
I

V R

TRIP

SENSE
SENSE | 110
450 mA

0.050 V

This is not a common available value so the closest to consider is 100mΩ. Lets reverse the equation above to determine the required sense voltage.

m | mV
V | R | I SENSE | SENSE | TRIP
=100 Ω×0.45 ≈ 45

= ×

The ISET pin can be programmed to a desired voltage using a divider from the VCAP reference. ISET voltage = Vsense x 40.

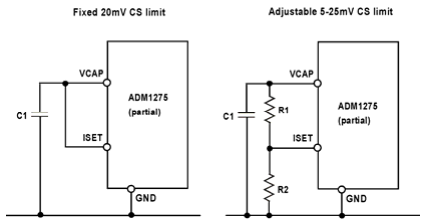
[picture p104: figure]

### VISET =VSENSE × 40 = 45mV × 40 =1.80V

Using the VCAP reference of 3.6V and assuming R2= 100KΩ, this will result in a top resistor of 100 KΩ.
The given ISET voltage provides a circuit breaker trip point of ~450 mA and a regulation current set point of 460 mA.

Power Rating:
Assuming worst case DC current could be as high as 487 mA (including tolerances), Therefore power can be calculated as:

~ 0.024 W

(0.487 A) 0.10 ²

2

=

= | × | Ω
RSENSE = TRIP × RSENSE P | I

So the sense resistor should be capable of dissipating 0.024 W (including temperature derating factors). A 0.1W or 0.125W resistor is recommended.
Summary of the key component selection for this section:

RISET(TOP) = 100 KΩ

RISET(BOT) = 100 KΩ
RSENSEx = 100mΩ
PG and Foldback - Tool Section 3
The ADM1270 utilizes a foldback technique to protect the MOSFETs in the event of overcurrent faults or short circuits. The output voltage is monitored using a divider on the FLB pin and the current limit is adjusted based on the VDS of the MOSFET. An example of this relationship can be seen in figure x

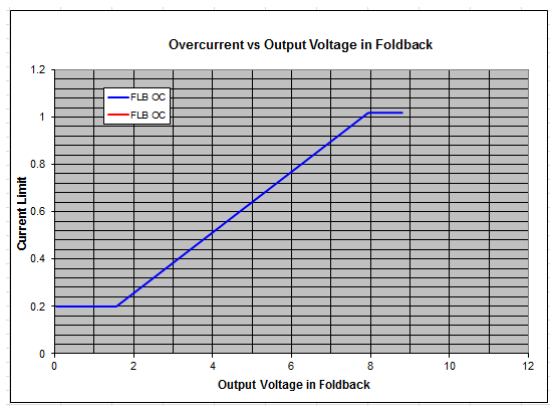
[picture p105: figure]

When the output voltage is at zero, there is a lower limit clamp to prevent the current limit approaching zero. This clamp is fixed at 0.2V on the FLB pin (or 8mV Vsense), which equated to ~200mA on this particular design. As the output voltage increases, the current limit ramps as a function of the output voltage. This threshold is set by the divider on the FLB pin, using a reference equal to VSENSEREG X 40. This voltage should be chosen to be low enough to avoid any expected Vout load steps from affecting the current limit. Also, the PGOOD output is derived from the voltage divider that sets the FLB level.

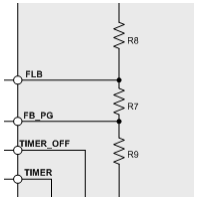
[picture p106: figure]

Targeting 8V and an 11V PGOOD we get a divider of 95.3KΩ (R8), 4.02K (R7), and 10KΩ (R9).
Summary of the key spec / component selection for this section:
VPG | = 18V
VFLB | = 13.2V
R7 | = 4.53K
R8 | = 332K
R9 | = 20K

MOSFET Selection - Tool Section 6
The first consideration as criteria for selection of a suitable MOSFET is the RDSON specification, to ensure that minimum power is lost in the
MOSFET when it is fully enhanced in normal operation.
The ADM1270 features a high voltage gate drive to ensure a minimum of 10V VGS is achieved to maintain the lowest specified RDSON. The gate drive circuit is designed to achieve this while still ensuring the 20V maximum VGS spec is not violated.
As the temperature of the MOSFET increases, its power rating is reduced, or derated. The RDSON spec determines the maximum junction temperature of the MOSFET and therefore the required derating can be applied to SOA parameters. In addition, running MOSFETs at high temperatures may decreases their reliability. Lets begin by estimating the required RDSON. Recall the maximum DC current was 487mA, worst case. Then using the maximum ambient temperature specified in section 1 we can estimate the power loss in the MOSFET(s). First we make a few assumptions…
- RthJA = 78 C/W (must not exceed)
- TjMAX = 120 °C

(This is the maximum preferred junction temp, keeping well away from any silicon limits)
Calculate the junction temperature rise:
120 60 60 C
- TRISE = TjMAX - TAMAX = - =

Then the power for a single FET:

mW
R

T P

thJA

RISE
MOSFET | 770
78
60 = | = | =

Now total RDSON:

3.25 0.487

0.770 = | 2 = | 2 = | Ω

MAXDC

MOSFET
DSON I

P R

Now we derate this further by a factor of 1.6:

2.03 1.6

3.25 RDSON = | = | Ω

Taking this as our target RSDON we can now search for suitable candidates. The search can be narrowed to FETs that fit the following profile:

- VDS = 60V (55V may be possible but not preferred)
- VGS = 20V
- RDSON ≤ 2.03Ω
After selecting a suitable MOSFET, the derating of the RDSON should be quantified using the MOSFET datasheet graph of RDSON against TJ.

Using TjMAX of 120 °C, we can see the RDSON increases by a factor of 1.6 to about 220mΩ (assuming 135mΩ at 25°C) at 120°C. As a rule it is best to keep junction temp ≤120C.
Assuming that the MOSFET’s max RDSON is 220mΩ, the power of the FET can be determined by:
( | )
( | )
52 W

0.487 A 220

10%

| 2
| 2

m

m

P | I | RDSON DMAX MOSFET

≈

= | × | Ω
= | × | ×

The MOSFET’s thermal resistance at ambient temperature should be specified in the datasheet. The footprint size, airflow, nearby heat sources and additional copper will also have an effect on this value so care must be taken to ensure the specified conditions are met. Assume, for this design a target of:

RthJA = 78
C/W

(Note: Care should be taken to ensure layout/airflow does not exceed this figure)
As the MOSFET is expected to dissipate ~52mW, a worst-case temperature rise of 4.1 °C above ambient can be expected as follows:
4.1 C
- TRISE = RthJA × PMOSFET =

The resulting junction temp of the FET can be determined as follows:
60 4.1 64.1 C
- TJ = TA + TRISE = + =

As this is below the maximum selected value of 120°C, the risk of thermal runway should be avoided. When using multiple MOSFETs in parallel, a 10Ω resistor should be use in series with the gate of each MOSFET to prevent oscillations.

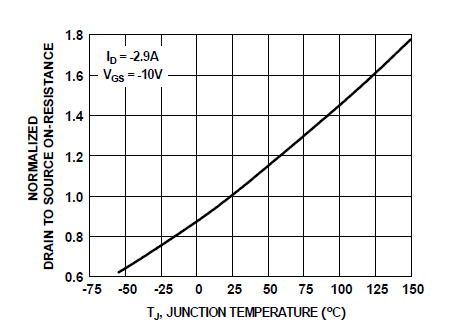
[picture p107: figure]

Summary of the key spec / component selection for this section:
QX | = Selected 135mΩ MOSFET.
RthJA | = 78 K/W

Power Derating Factor
Now that the maximum junction temperature is verified we can determine the maximum derate factor. This number will be used to derate all the SOA parameters to verify a robust solution across temperature.
To determine the maximum expected case temperature we can use:
T | C
T | T | R | P

C

C | j | thJC | MOSFET
- 64.1 (78 0.052) 60
| ( | | )
= | - | × | =
= - | ×

Now the derating factor can be calculated as follows:

1.4
150 C 60 C

150 C 25 C

max | max
max | = ° - °

° - ° = -

- =
J | C
J | CSOA
T | T
T | T DF

Summary of the key spec / component selection for this section:
DF = 1.4
MOSFET SOA Analysis – Short Circuit
The next step is to review the SOA curve on the MOSFET datasheet to determine how much time it can tolerate the worst case power in the FET. This will determine a suitable timer capacitor value.
The ADM1270 has a very fast overcurrent detect circuit which detects a severe overcurrent event and responds in <300ns. There is also a very large gate pulldown device to ensure large MOSFET are shutdown fast. These combined should ensure ~1µs shutdown(excluding any system level component which may slow down di/dt) . The controller will re-establish control and begin controlled current fault timing.
If a short was applied the Vds of the FET can be assumed to be ~20V (assuming source at GND). In reality the number would likely to be lower than this due to line impedance.
However, if we look at the profile of the FET power against Vout we see that the relationship is not monotonic.

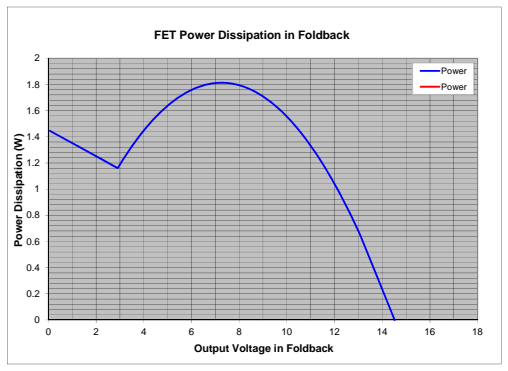
[picture p108: figure]
Power Dissipation (W); Output Voltage in Foldback; FET Power Dissipation in Foldback; Power

In figure x we can see that the worst case power in the FET is at ~7V (35% of Vin). The current can be easily calculated using the following equation:

mA
R | CS | m

V I

R | R

R
V | V
SENSE | GAIN

FLB
FLB WCP

FLB TOP FLB BOT

FLB BOT
FLB OUT WCP

103
100 40

0.413

0.413
20 336.5

20 7

_

_ | _

_
_

= Ω× = × =

÷ =
ø

ö ç
è

æ
+ = ×

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
(WCP=Worst Case Power)
Now derate this by 1.4 (from section 5) and we get 145mA. So if we go to the SOA diagram of the MOSFET, and intersect 7V with 145mA, we get approximately 10s. This means that timer “fault time” should never exceed 10s.

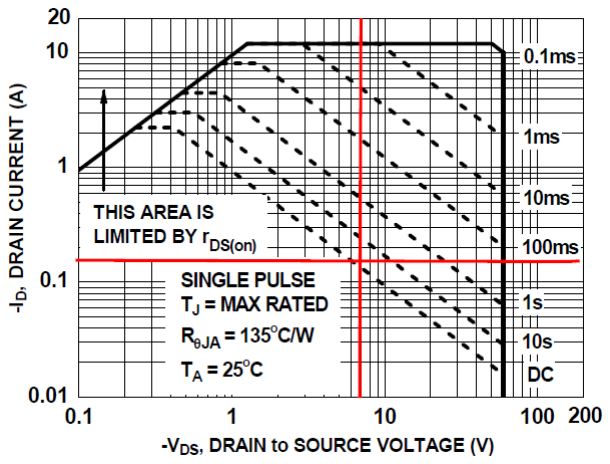
[picture p109: figure]

It should be noted that some FETs SOA power lines do not always represent a constant power product. This should be checked and if the line is not constant power then more points should be checked.

Summary of the key spec / component selection for this section:

TSOA_MAX | = 10s

Powerup analysis - Tool Section 5
Now that the timer had been selected, we must check to verify that there is sufficient time available to allow the loads caps to complete powerup. This is determined by how long the startup current profile intersects with the current limit… i.e. how long the timer is active during powerup.
During the power-up phase, the controller will usually hit the current limit due to the inrush current demanded by the load capacitance. If the time set by the TIMER pin is insufficient to allow the load capacitors to charge, then the MOSFET will be disabled and system will not power up.
We can use the following equation to estimate the powerup time using an average current limit across the foldback system:

ms

R

V I

C V
t

POWERUP

MAX
AVERAGE

LOAD MAX
CHARGE

45

1000

32 103mA

100 10 F 32 V

6

≈

× × =

× =

TPOWERUP | = ~ 45ms

Timer Capacitor - Tool Section 4
Now that the MOSFETs SOA requirements have been determined, and powerup time is satisfied, a TIMER capacitor value can be calculated. This can be calculated as follows:

TIMER

TIMER | TIMER
TIMER | V
t | I C | × =

Where ITIMER = 20 μA and VTIMER = 2.0 V,

( | )( | )
| 2.0 V
45 10 s 20 10 A -3 | -6 × | × | × CTIMER =

≈ 0.45 uF

Power in MOSFET at startup -SOA

Now, as a final step we need to check that the power being dissipated in the FETs at startup is within the SOA limits of the MOSFET. We can calculate the Energy required to charge the laod cap as follows:

()

### joules

### CV ECL

0.052

2

100 10 32

2

6 | 2

2

≈

× × =

=

The power can be determined using:

W

t

E PFET

1.16

45 10

0.052 3

≈

× =

=

- (where t = 116ms)

Now calculate the current at max Vds…

mA
V
P I | 36
32

1.16 = = =

Now if we examine the SOA again, we can see that 32V and 36mA corresponds to ~10s. As the maximum expected powerup is ~45ms, there is adequate room for tolerance and margin within this spec.
