EPFLXplore/Power_HW/Pollux/Altium/Pollux III/Output.pdf

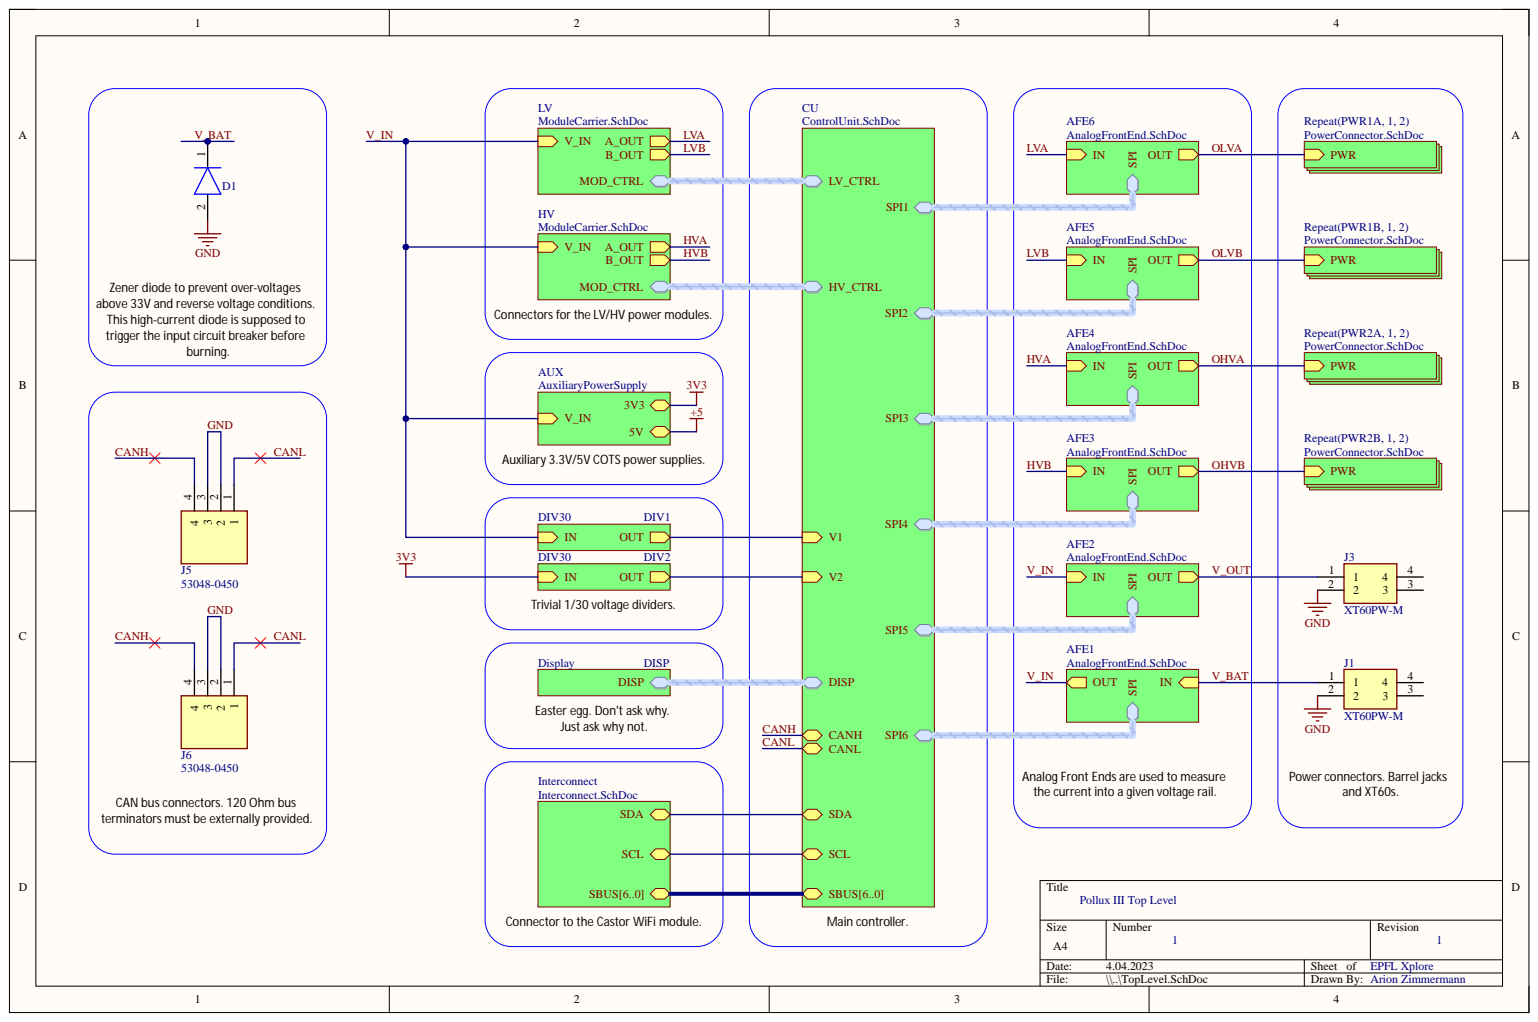
[picture p110: page 1]

Zener diode to prevent over-voltages
above 33V and reverse voltage condit
This high-current diode is supposed to
trigger the input circuit breaker be
53048-0450 GND GND

Connectors for the LV/HV power modules.

Auxiliary 3.3V/5V COTS power supplies.

Connector to the Castor WiFi module. Easter egg. Don't ask why.

Just ask why not.

Analog Front Ends are used to measure
the current in

Power connectors. Barrel jacks

to a given voltage rail.

CAN bus connectors. 120 Ohm bus
termina

tors must be externally provided.

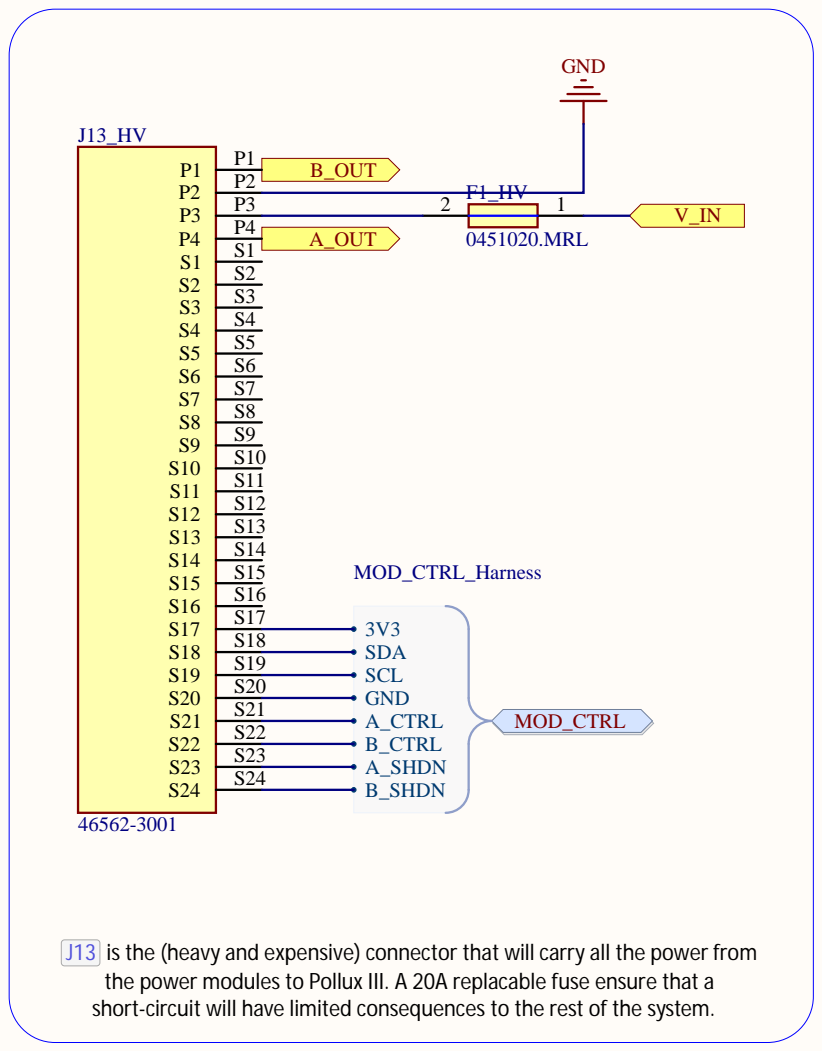
[picture p111: page 2]

J13 is the (heavy and expensive) connector that will carry all the power from
the power modules to Pollux III. A 20A replacable fuse ensure that a
short-circuit will have limited consequences to the rest of the system.

Interface to the Power Modules

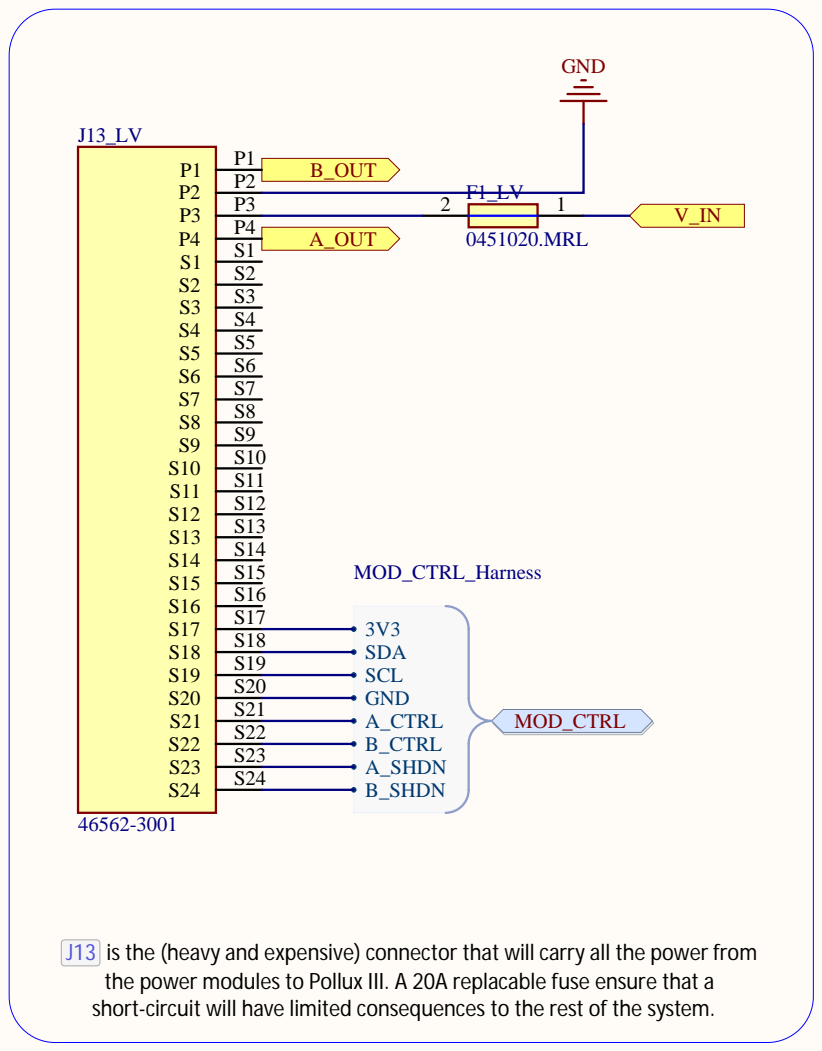
[picture p112: page 3]
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

Interface to the Power Modules

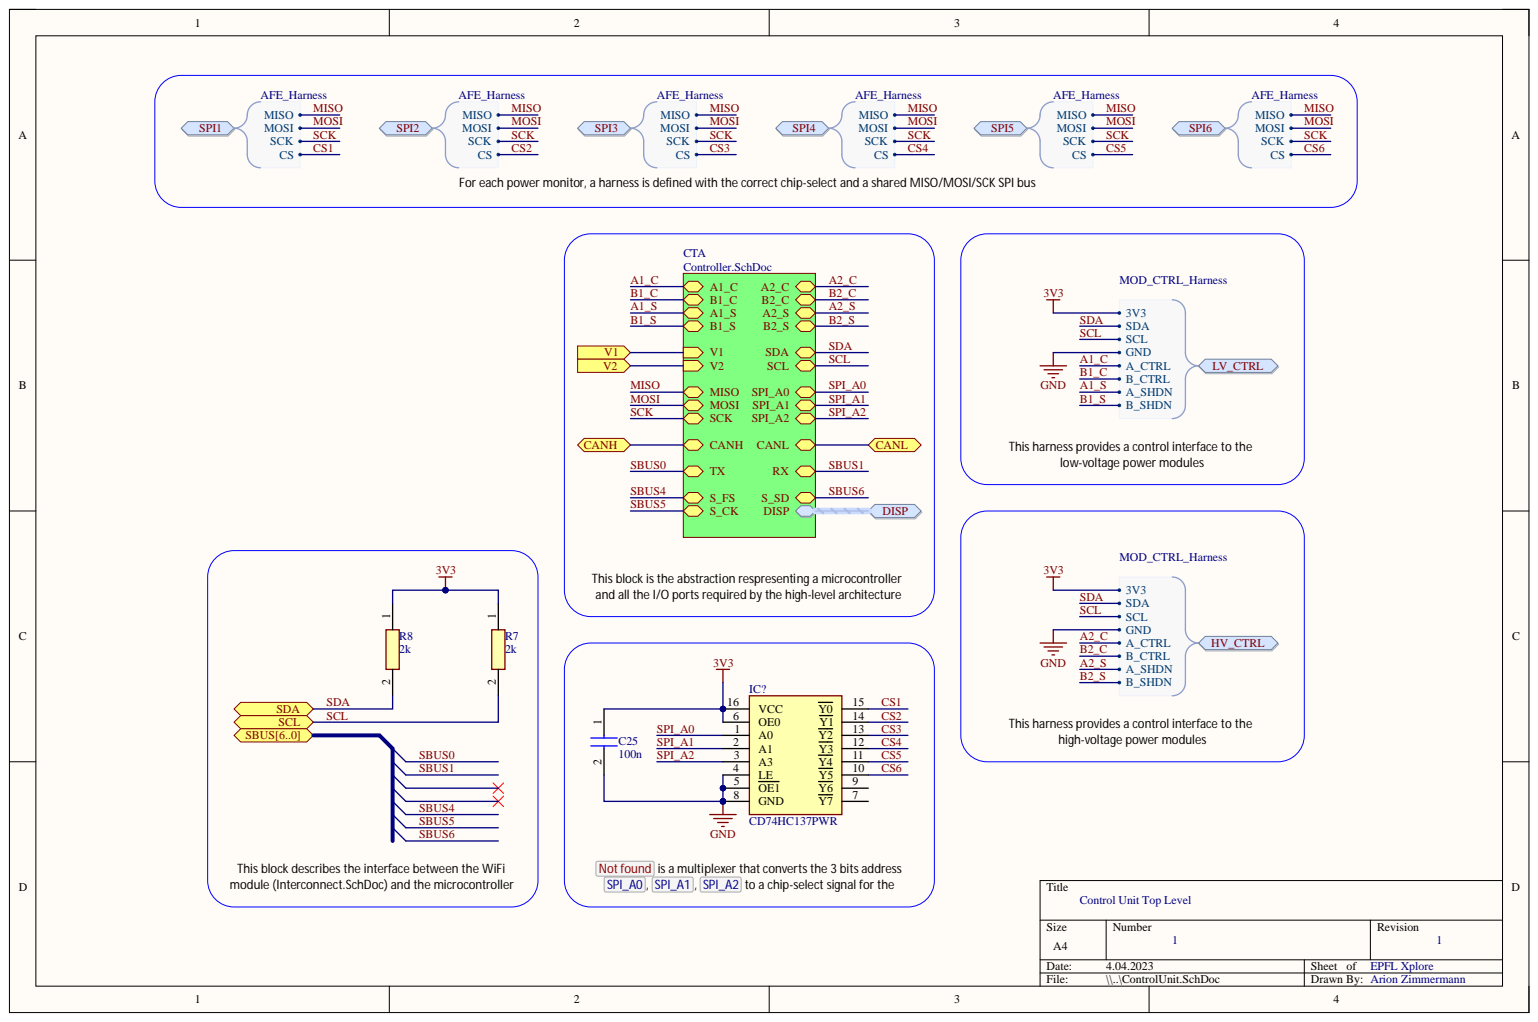
[picture p113: page 4]

For each power monitor, a harness is defined with the correct chip-select and a shared MISO/MOSI/SCK SPI bus

This harness provides a control interface to the

low-voltage power modules

This block is the abstraction respresenting a microcontroller
and all the I/O ports required by the high-level architecture

high-voltage power modules

This block describes the interface between the WiFi
module (Interconnect.SchDoc) and the microcontroller

Not found is a multiplexer that converts the 3 bits address
SPI_A0 , SPI_A1 , SPI_A2 to a chip-select signal for the

Control Unit Top Level

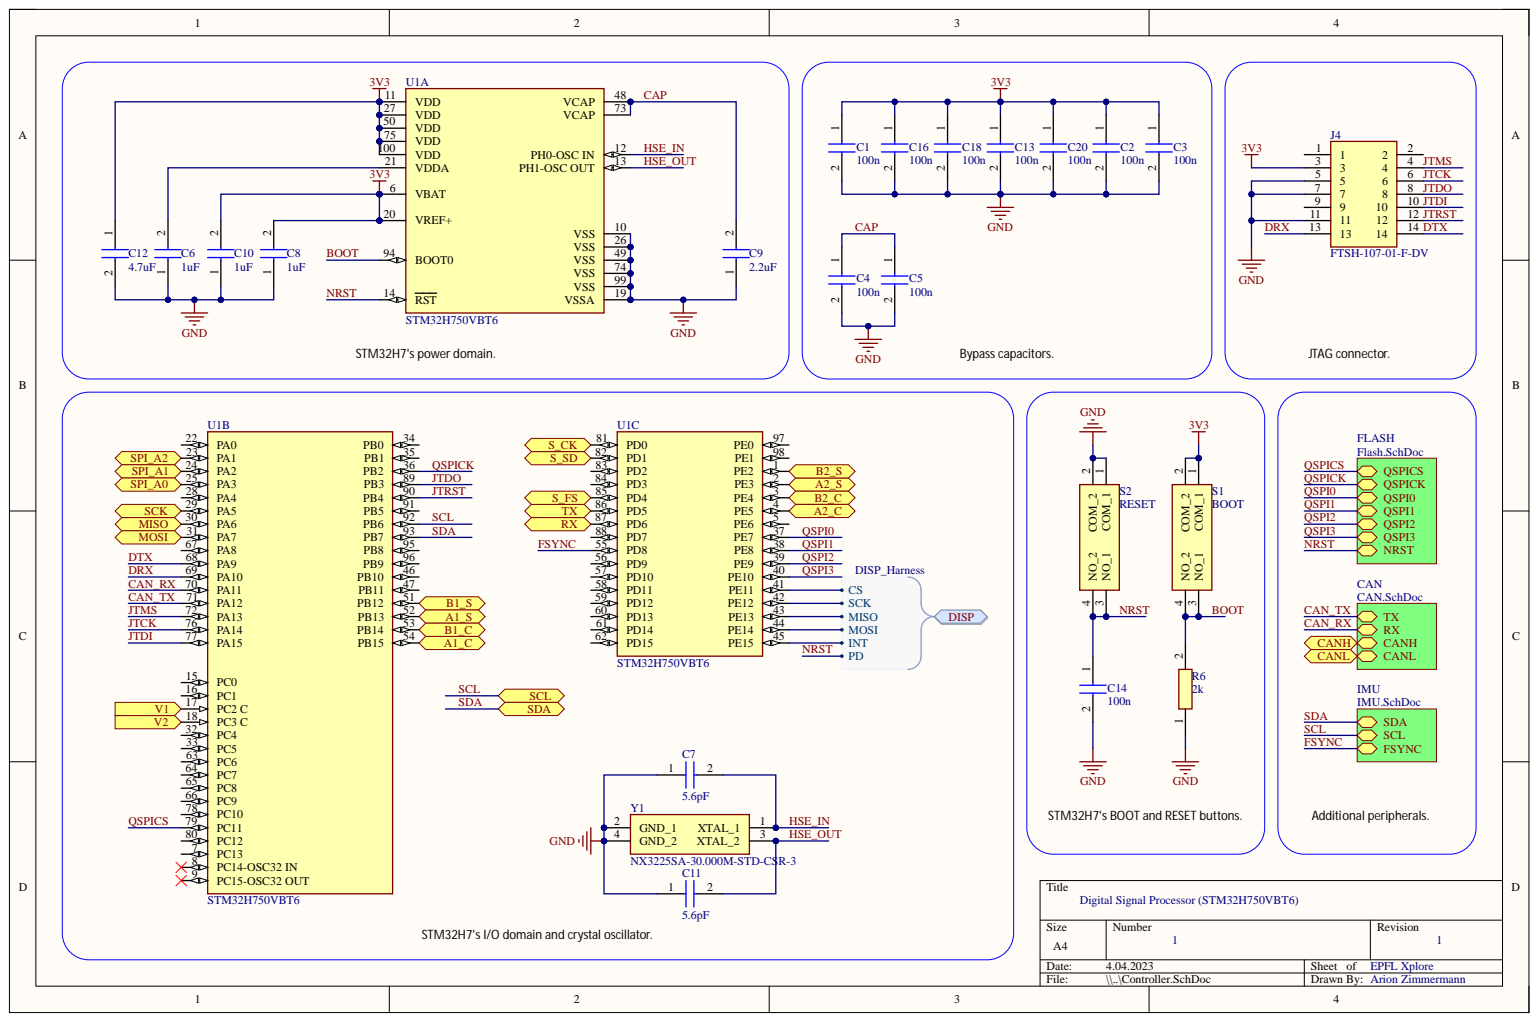
[picture p114: page 5]

STM32H7's I/O domain and crystal oscillator.

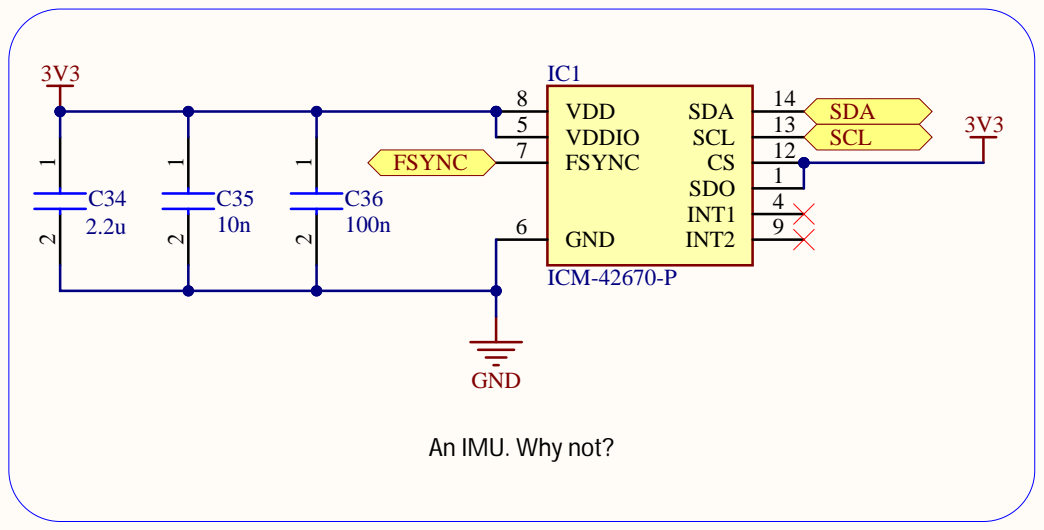
[picture p115: page 6]

An IMU. Why not?

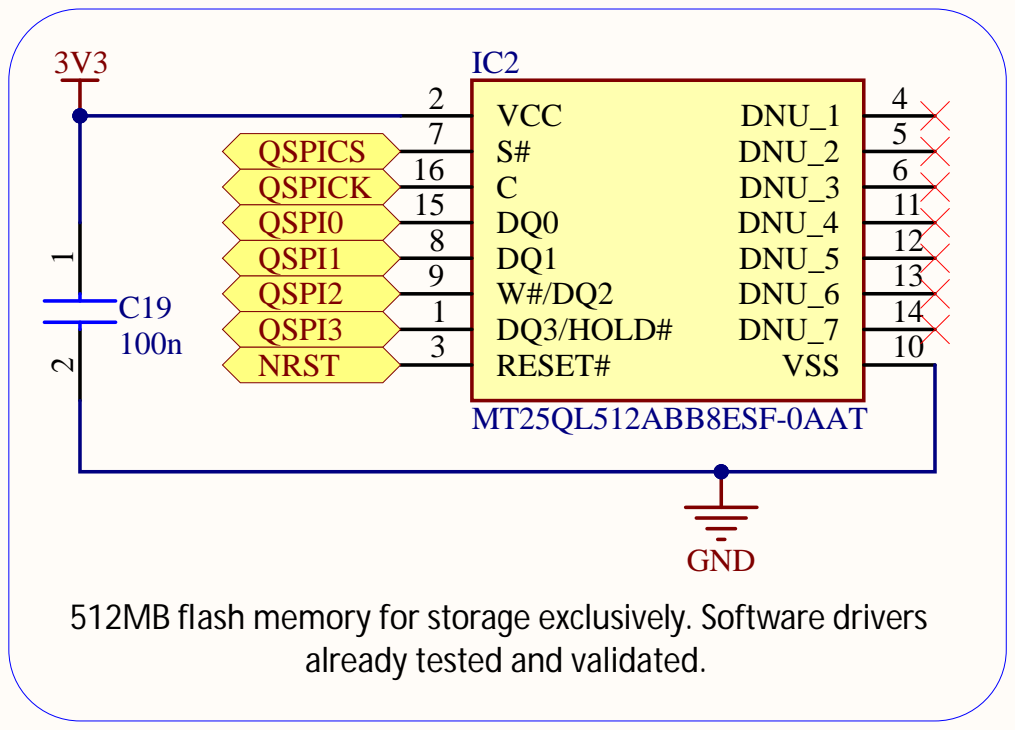
[picture p116: page 7]

512MB flash memory for storage e

already tested and valida

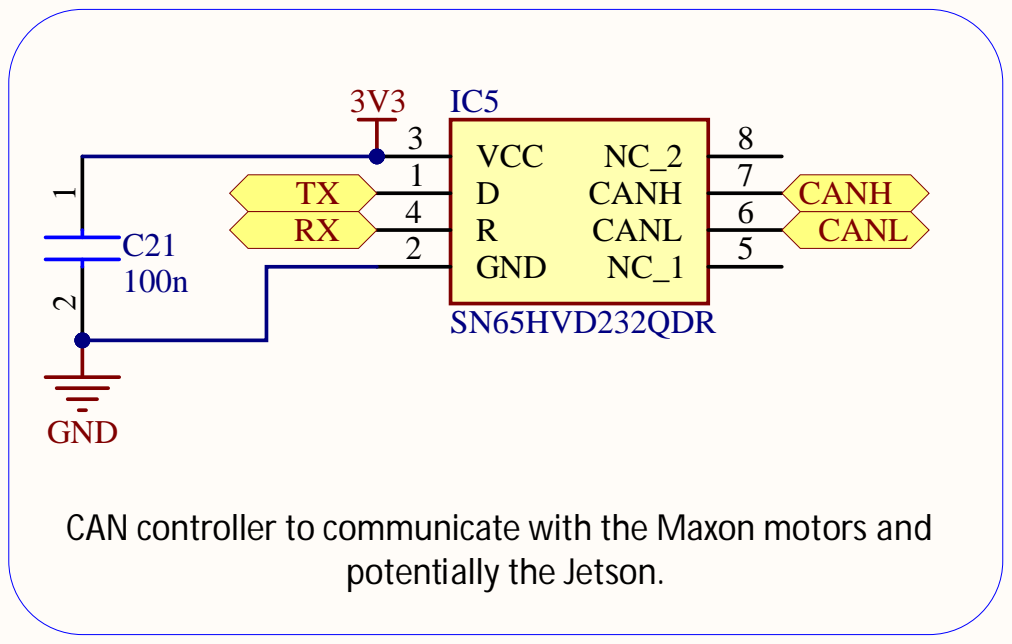
[picture p117: page 8]

CAN controller to communica

te with the Ma
tially the Jetson.

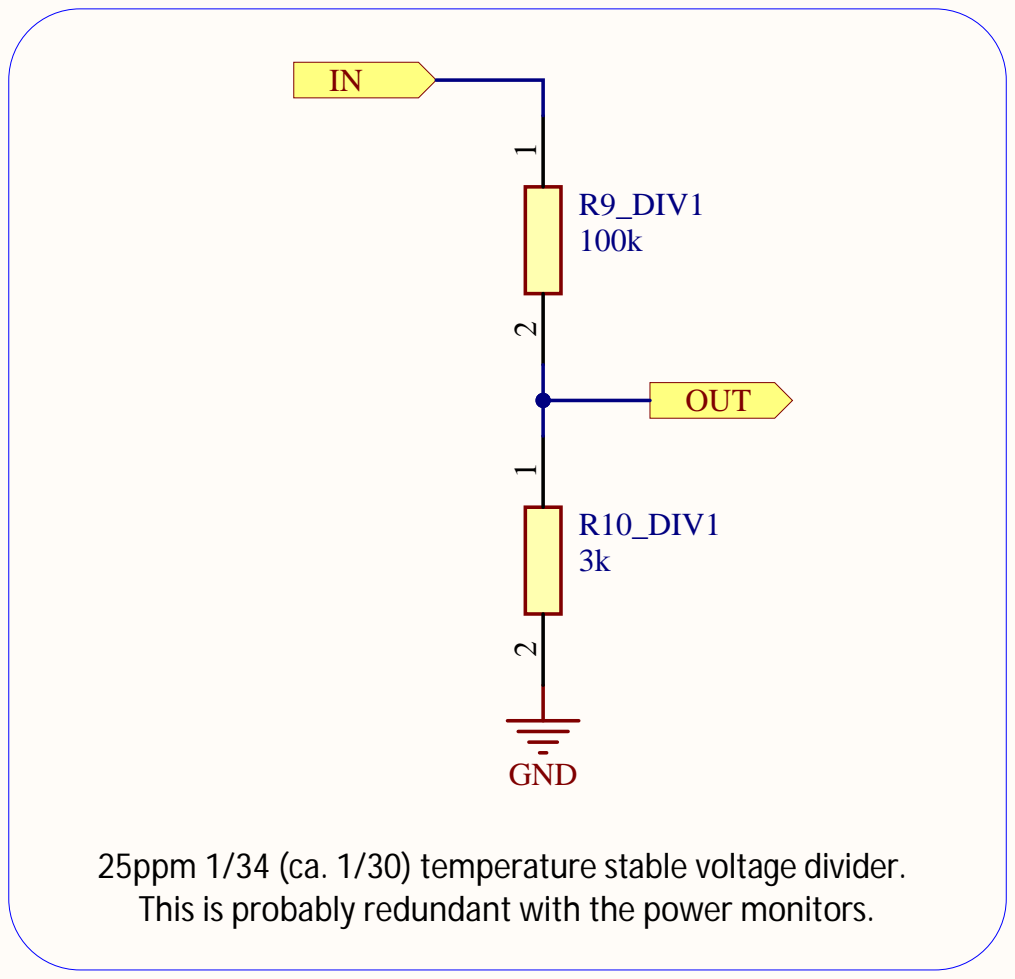
[picture p118: page 9]

25ppm 1/34 (ca. 1/30) temperature stable voltage divider.
This is probably redundant with the power monitors.

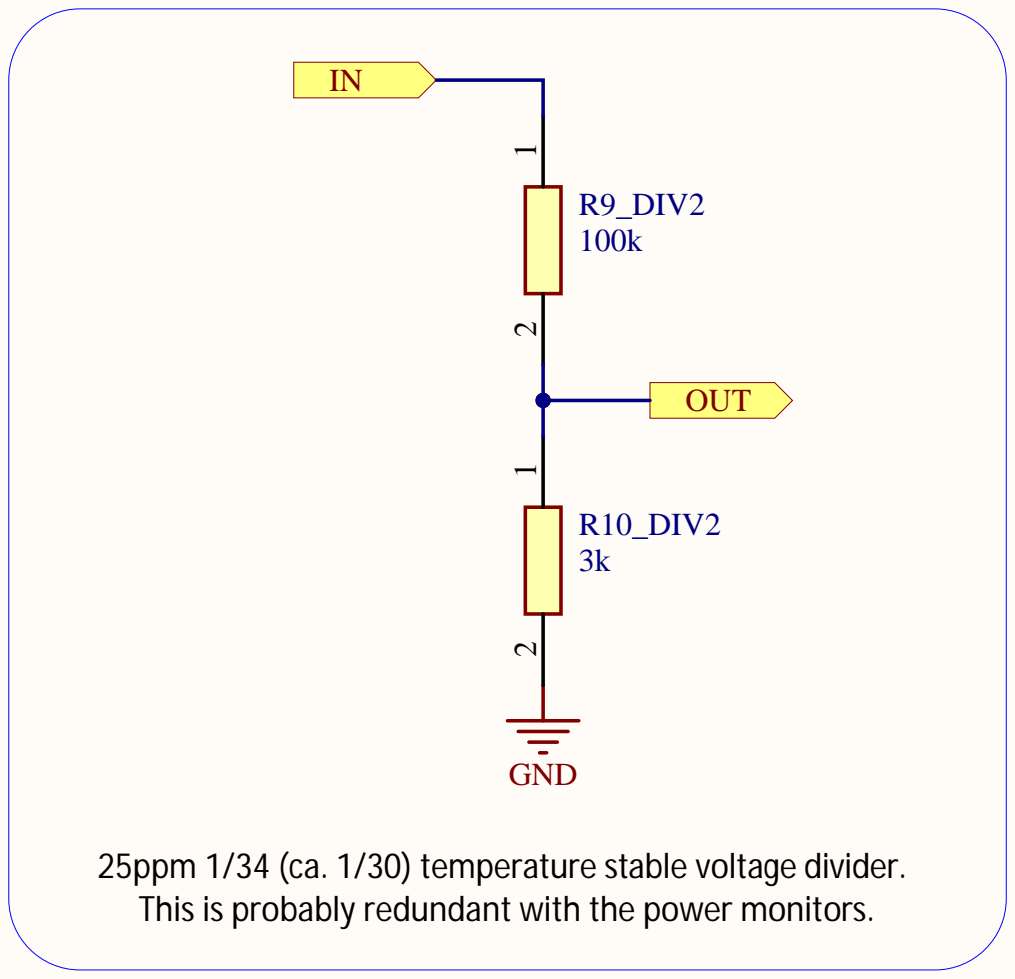
[picture p119: page 10]
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

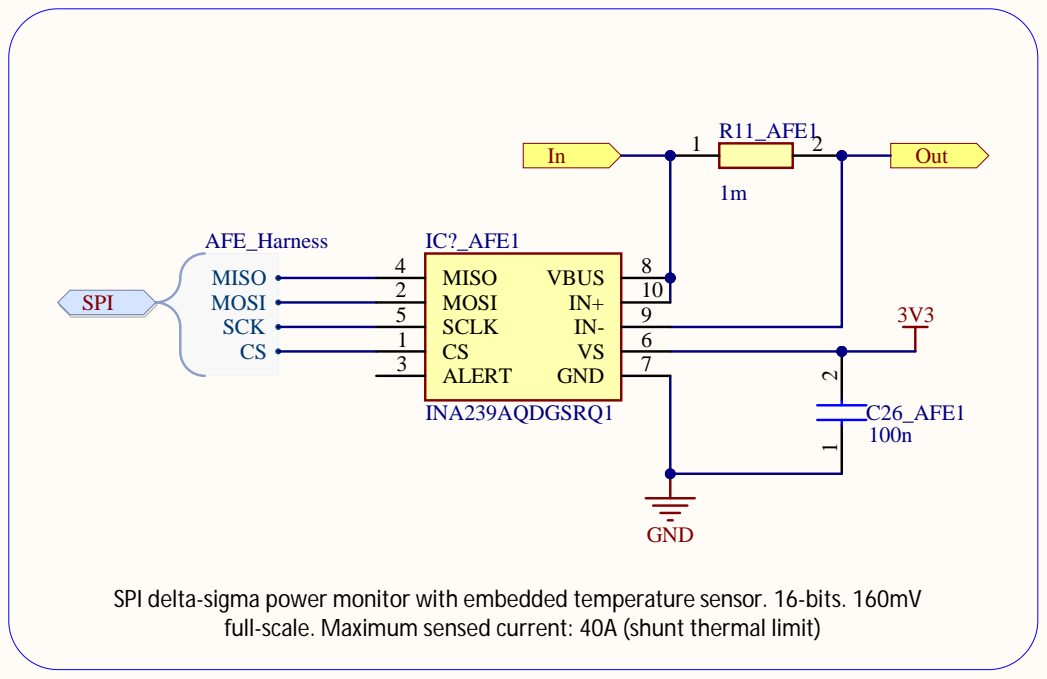
[picture p120: page 11]

SPI delta-sigma power monitor with embedded temperature sensor. 16-bits. 160mV

full-scale. Maximum sensed current: 40A (shunt thermal limit)

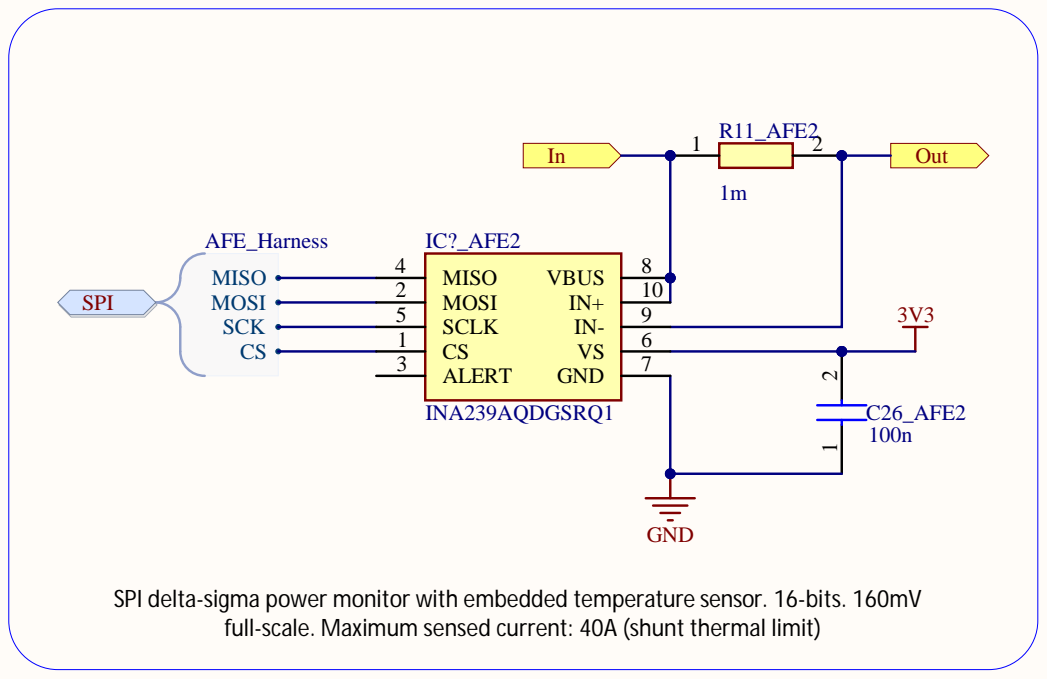
[picture p121: page 12]

SPI delta-sigma power monitor with embedded temperature sensor. 16-bits. 160mV

full-scale. Maximum sensed current: 40A (shunt thermal limit)

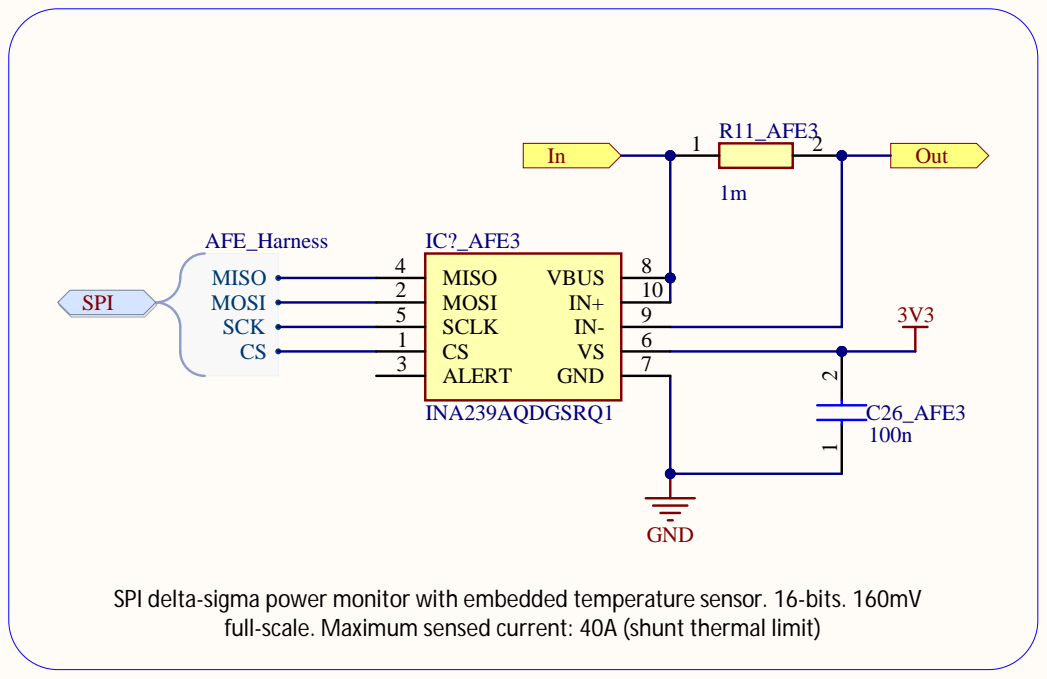
[picture p122: page 13]

SPI delta-sigma power monitor with embedded temperature sensor. 16-bits. 160mV

full-scale. Maximum sensed current: 40A (shunt thermal limit)

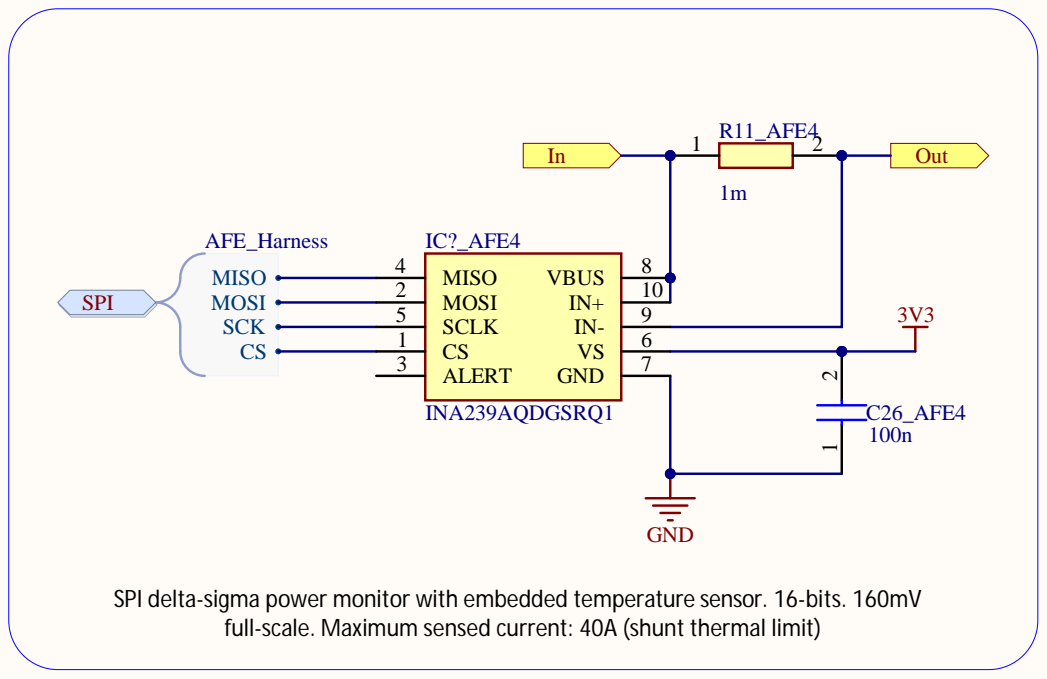
[picture p123: page 14]

SPI delta-sigma power monitor with embedded temperature sensor. 16-bits. 160mV

full-scale. Maximum sensed current: 40A (shunt thermal limit)

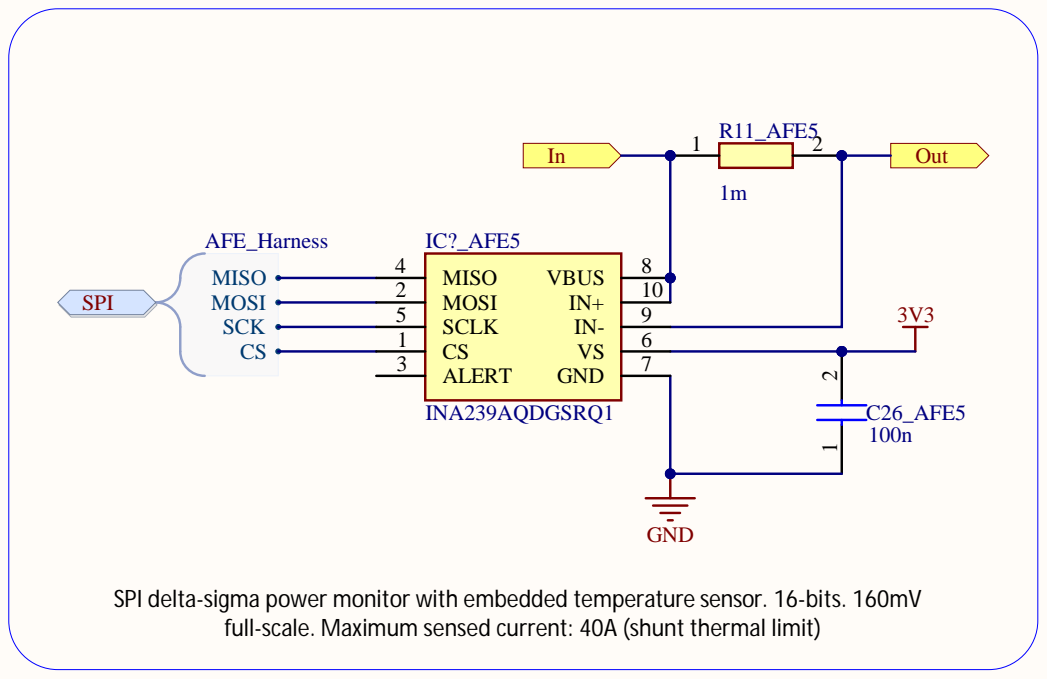
[picture p124: page 15]

SPI delta-sigma power monitor with embedded temperature sensor. 16-bits. 160mV

full-scale. Maximum sensed current: 40A (shunt thermal limit)

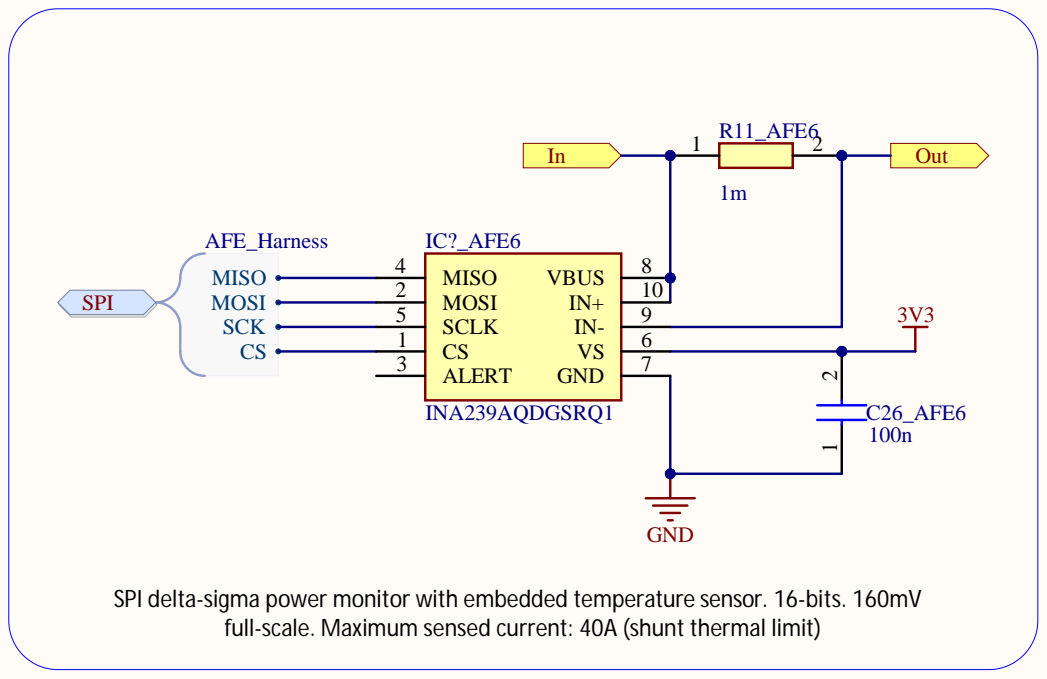
[picture p125: page 16]

SPI delta-sigma power monitor with embedded temperature sensor. 16-bits. 160mV

full-scale. Maximum sensed current: 40A (shunt thermal limit)

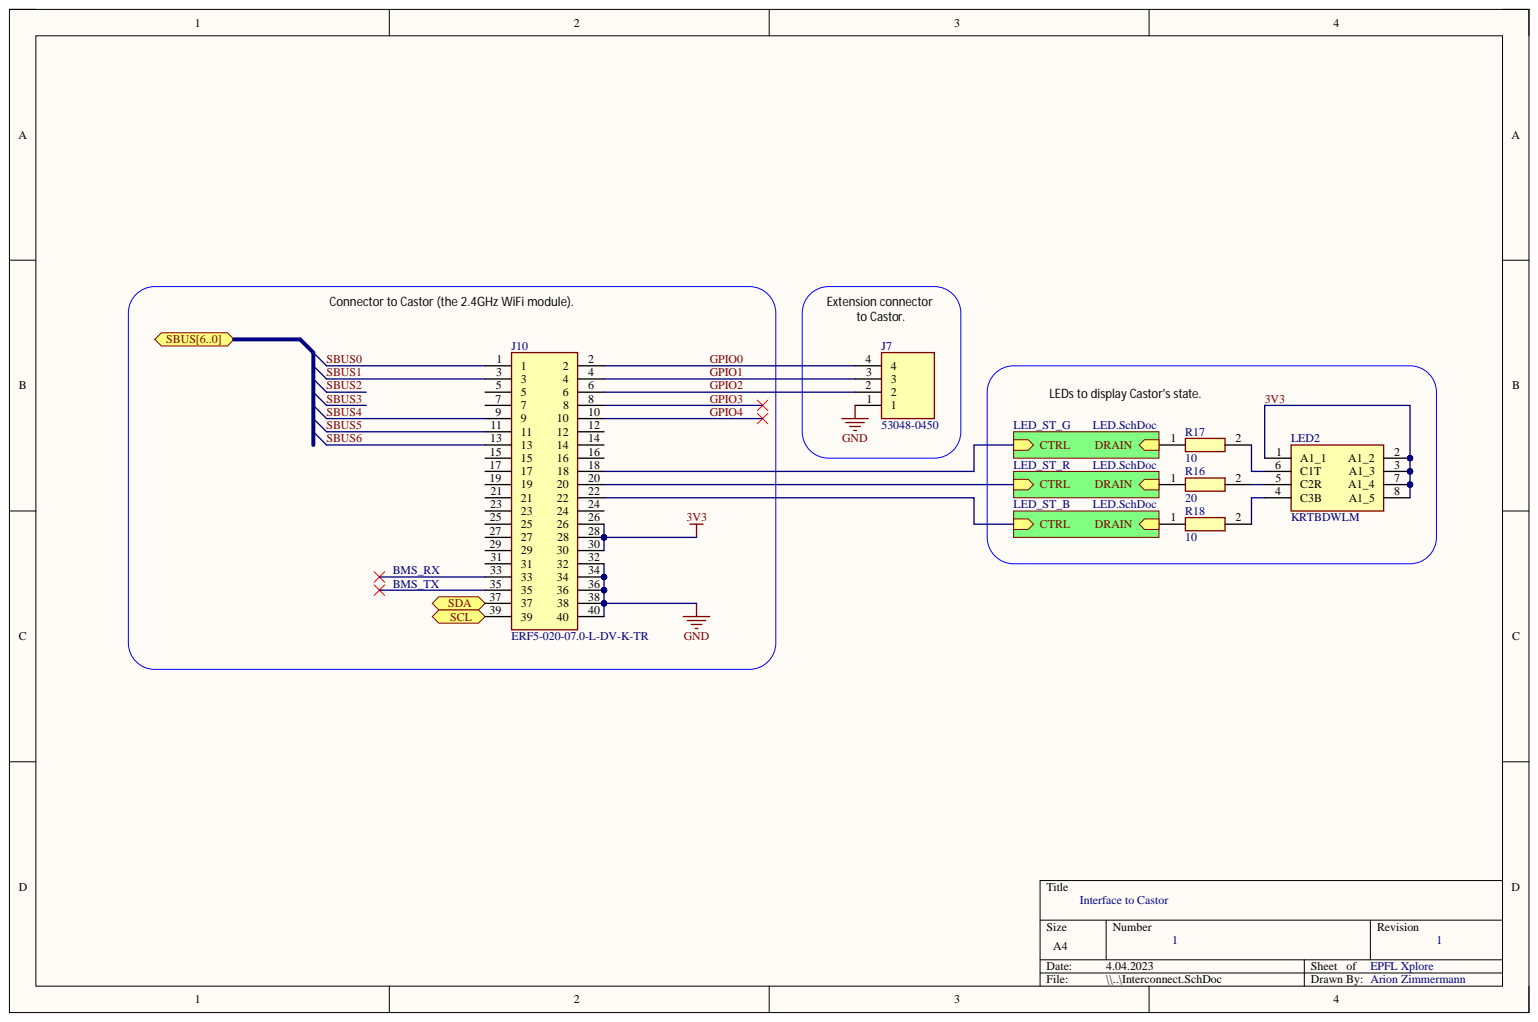
[picture p126: page 17]

LEDs to display Castor's sta

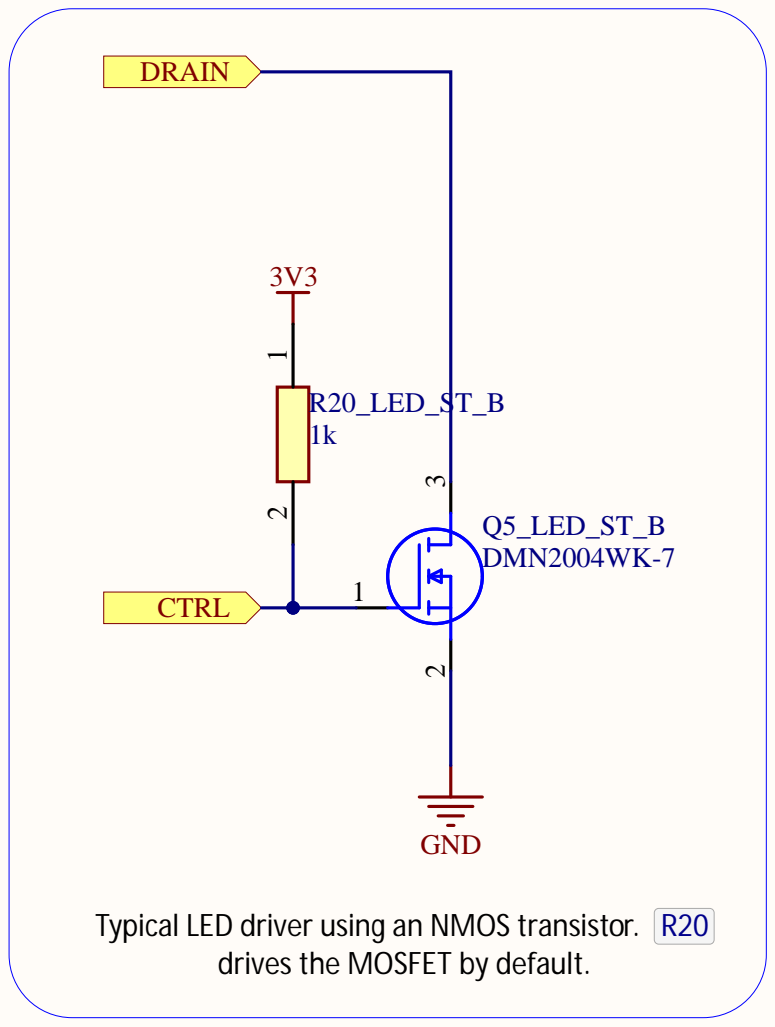
[picture p127: page 18]

Typical LED driver using an NMOS transistor. R20

drives the MOSFET by default.

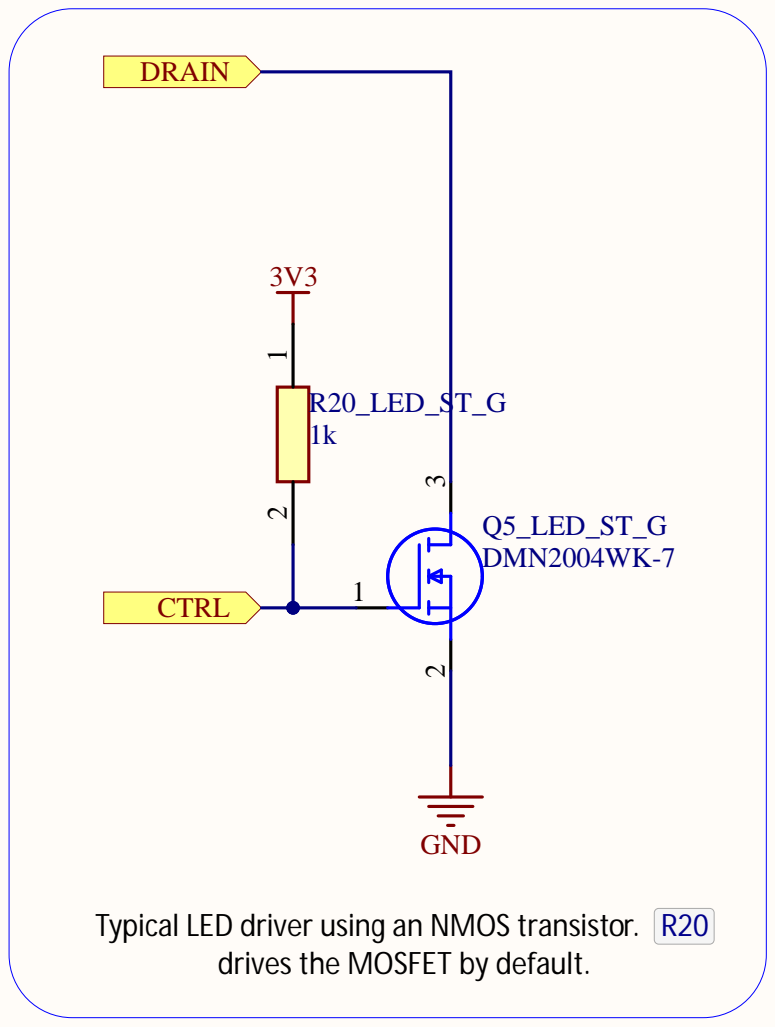
[picture p128: page 19]

Typical LED driver using an NMOS transistor. R20

drives the MOSFET by default.

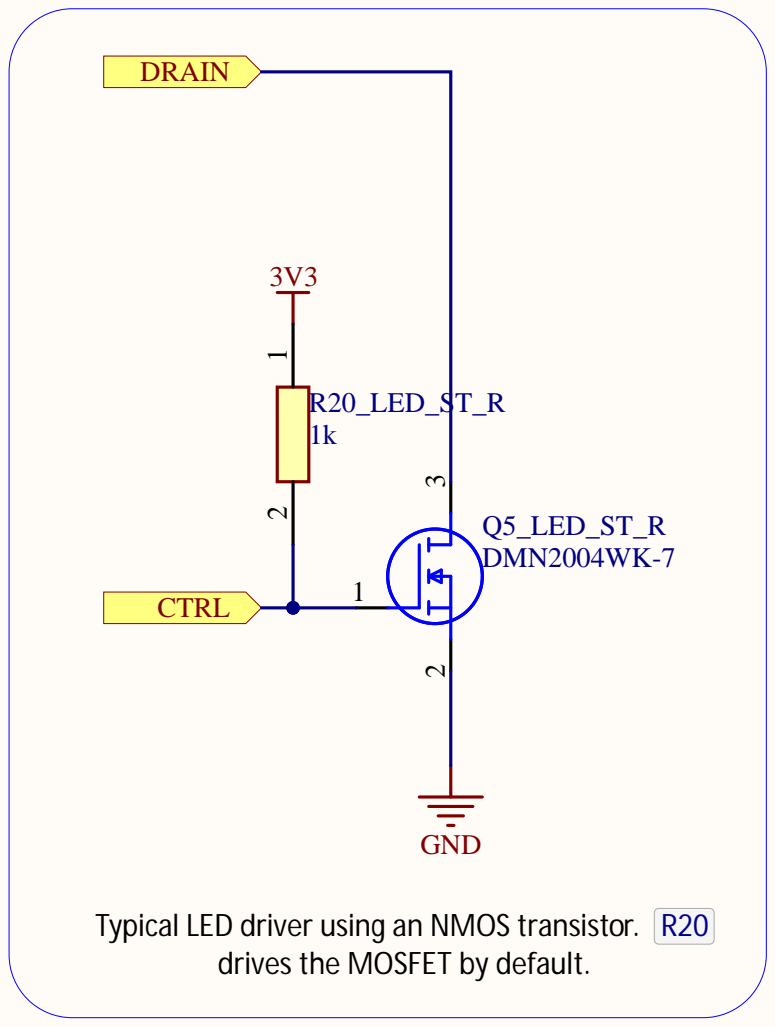
[picture p129: page 20]

Typical LED driver using an NMOS transistor. R20

drives the MOSFET by default.

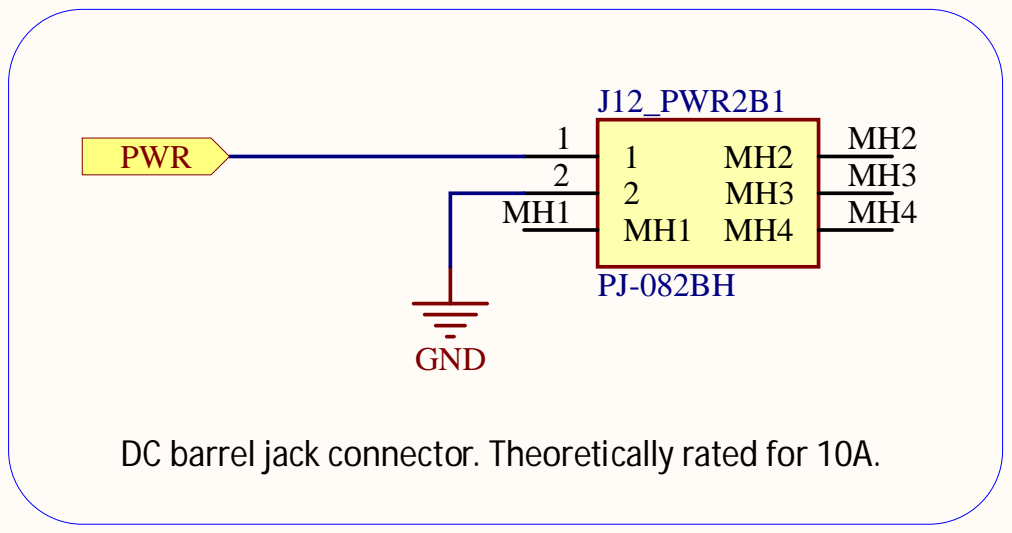
[picture p130: page 21]

DC barrel jack connector. Theoretically rated for 10A.

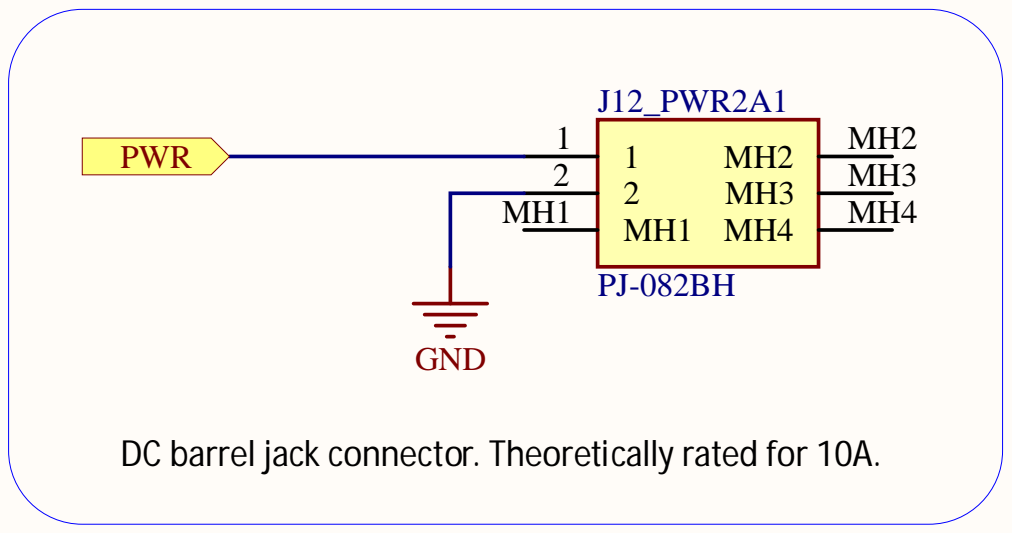
[picture p131: page 22]

DC barrel jack connector. Theoretically rated for 10A.

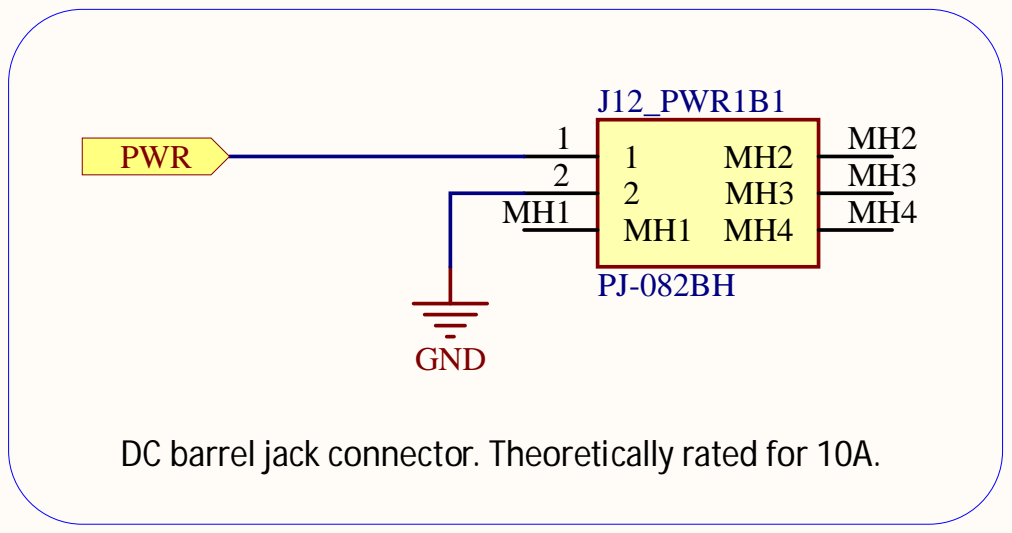
[picture p132: page 23]

DC barrel jack connector. Theoretically rated for 10A.

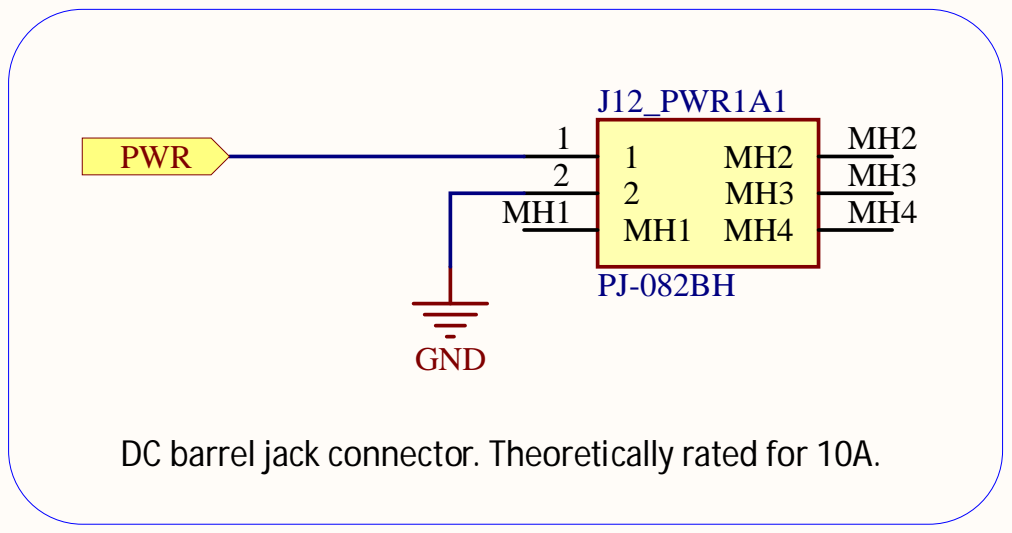
[picture p133: page 24]

DC barrel jack connector. Theoretically rated for 10A.

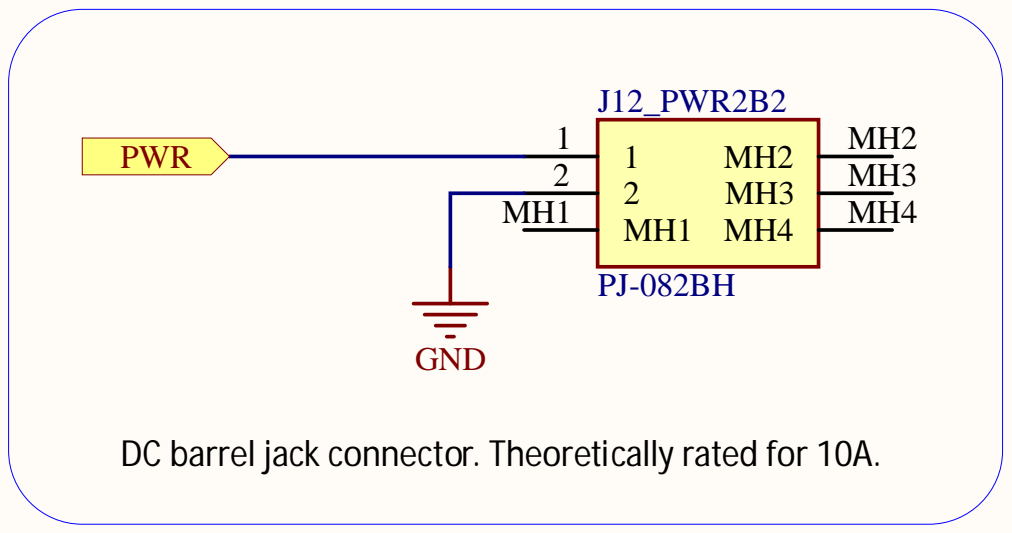
[picture p134: page 25]

DC barrel jack connector. Theoretically rated for 10A.

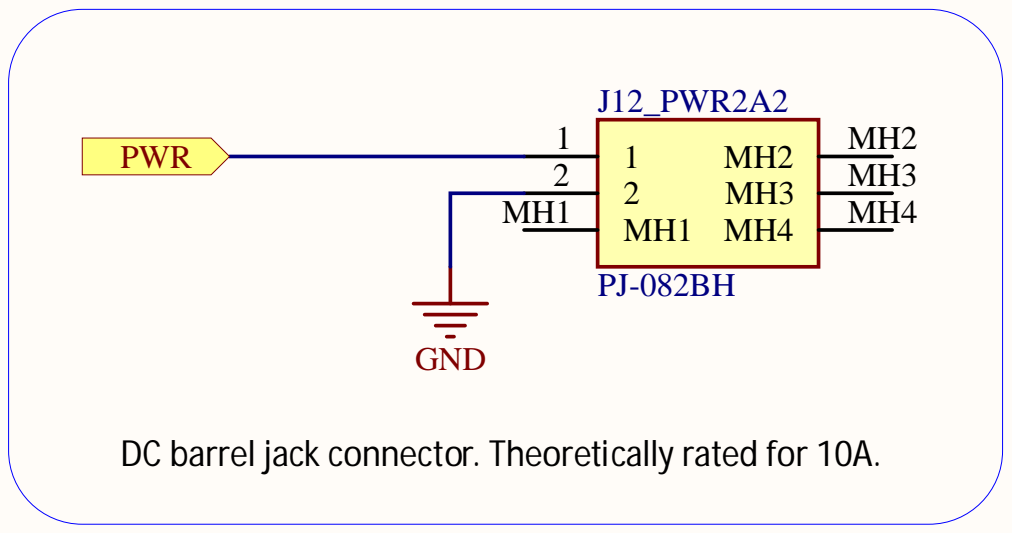
[picture p135: page 26]

DC barrel jack connector. Theoretically rated for 10A.

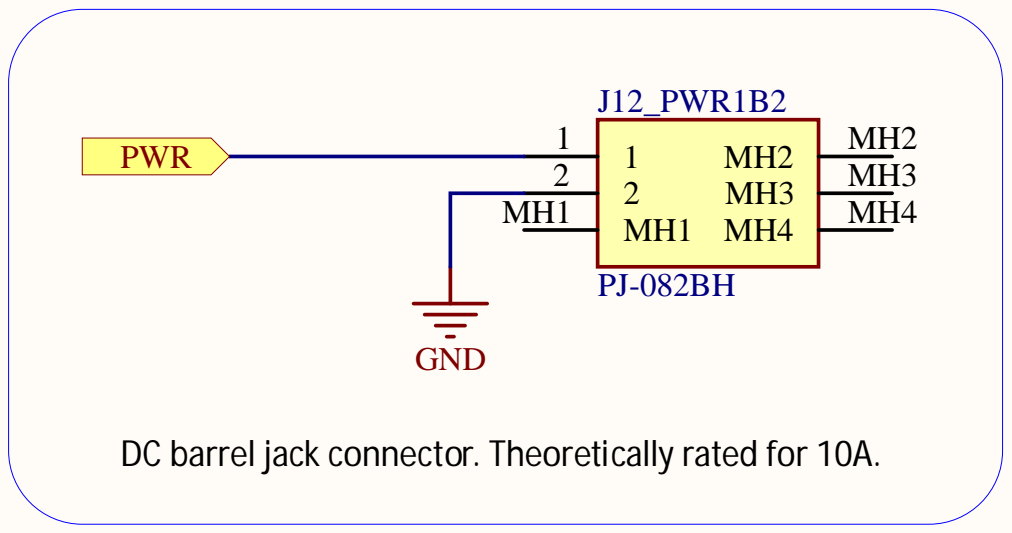
[picture p136: page 27]

DC barrel jack connector. Theoretically rated for 10A.

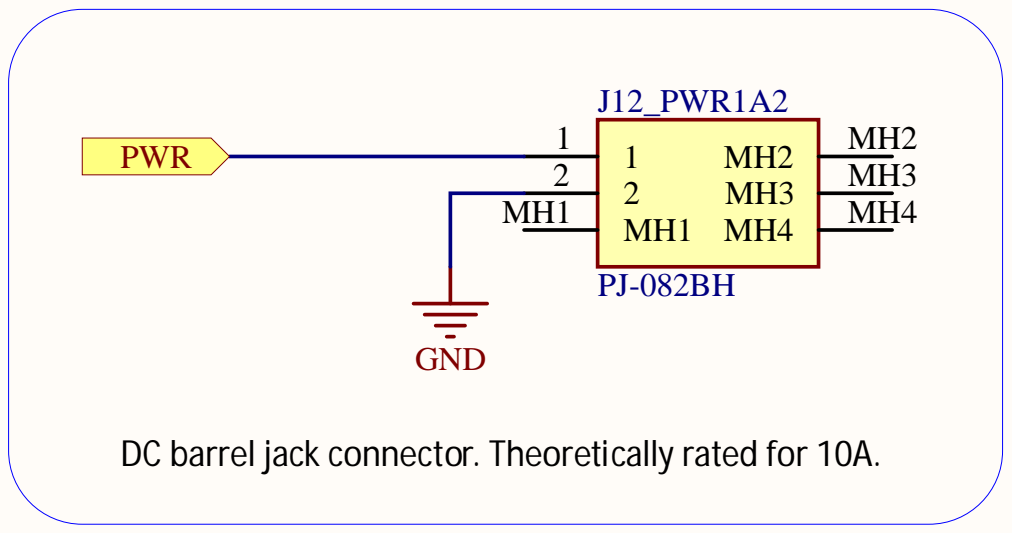
[picture p137: page 28]

DC barrel jack connector. Theoretically rated for 10A.

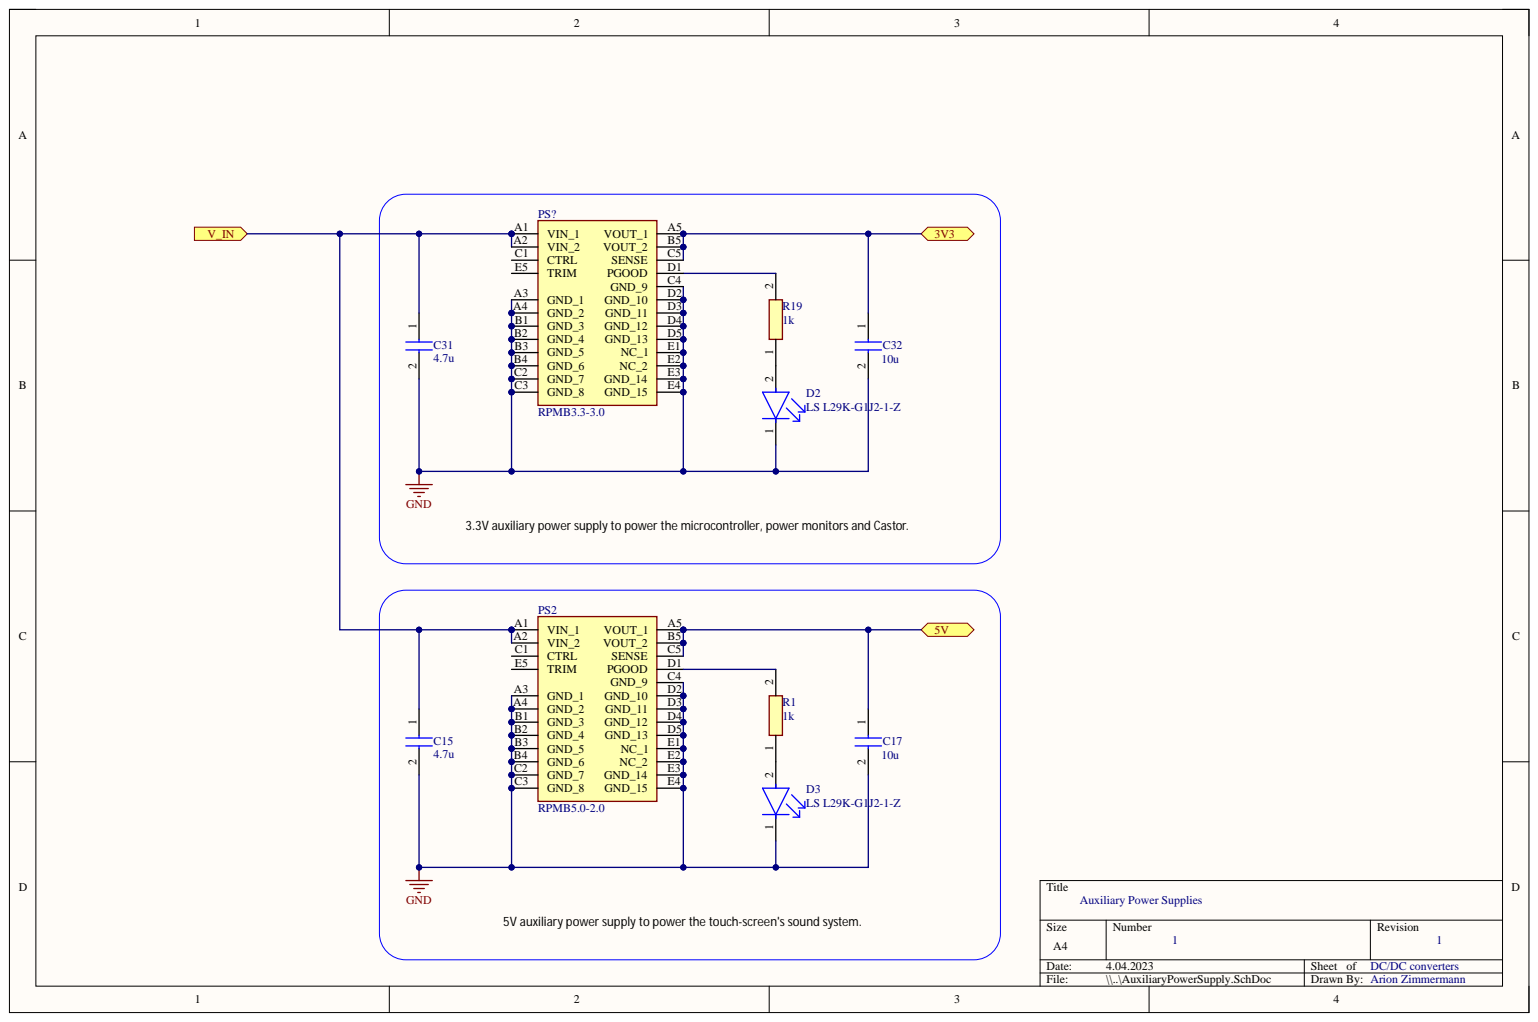
[picture p138: page 29]

3.3V auxiliary power supply to power the microcontroller, power monitors and Castor.
TRIM E5

5V auxiliary power supply to power the touch-screen's sound system.

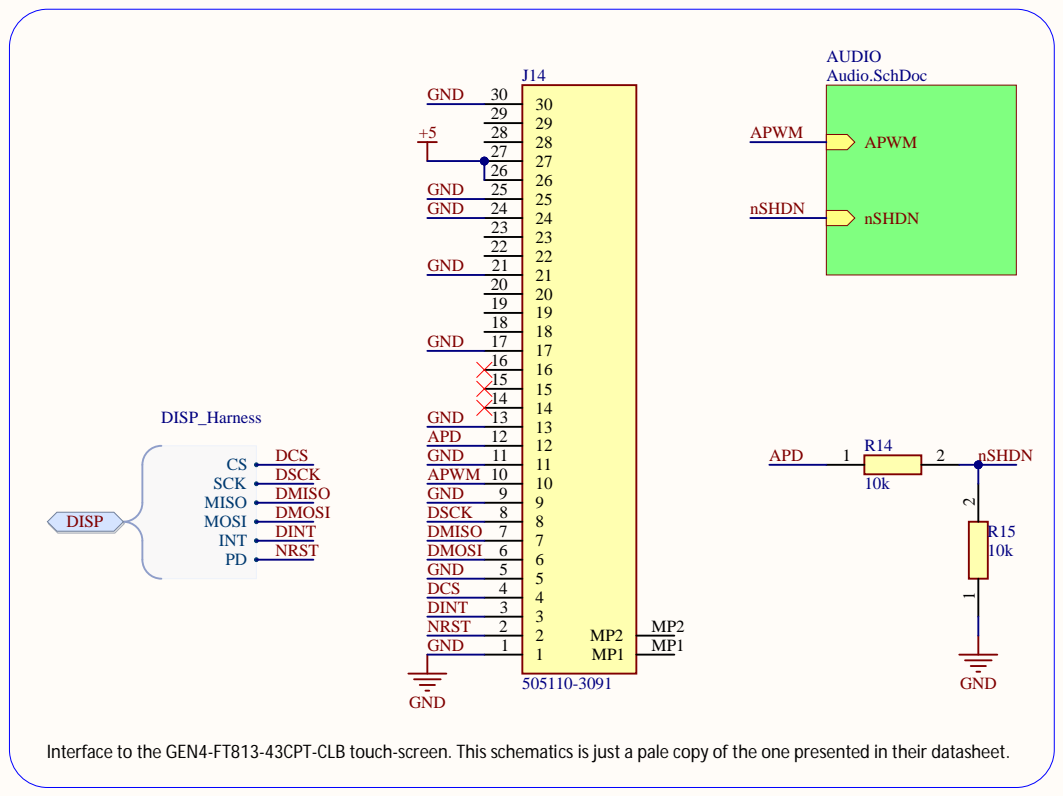
[picture p139: page 30]

GND GND GND GND GND

terface to the GEN4-FT813-43CPT-CLB touch-screen. This schema

tics is just a pale copy of the one presen

ted in their da

Interface to the Touch-Screen 1

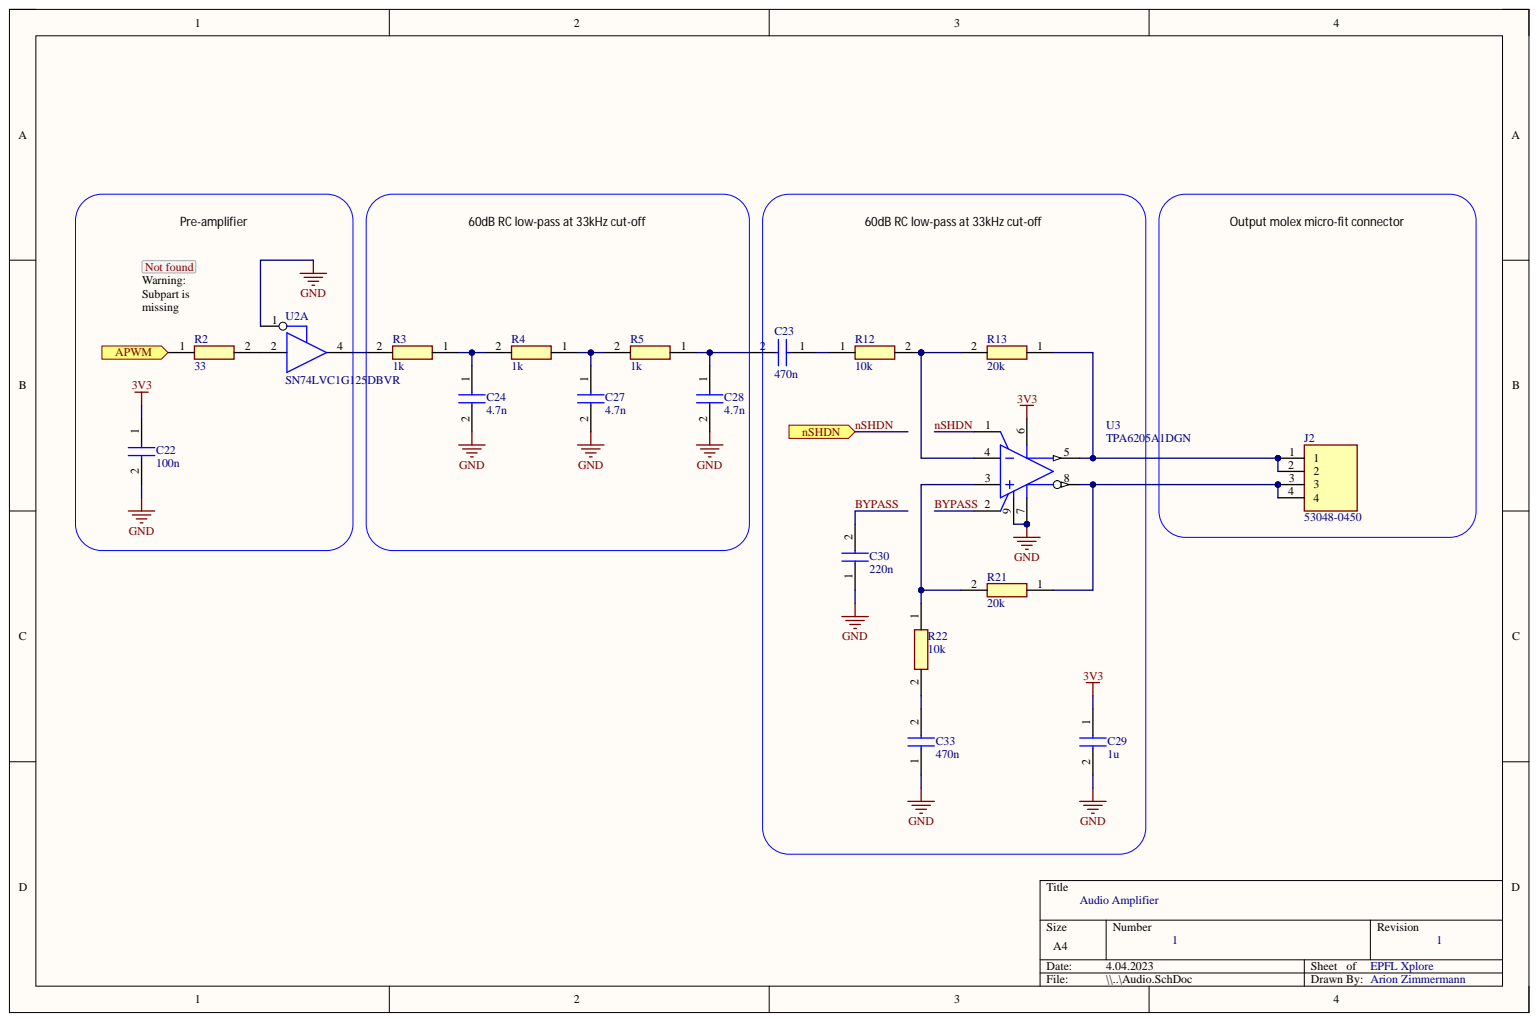
[picture p140: page 31]

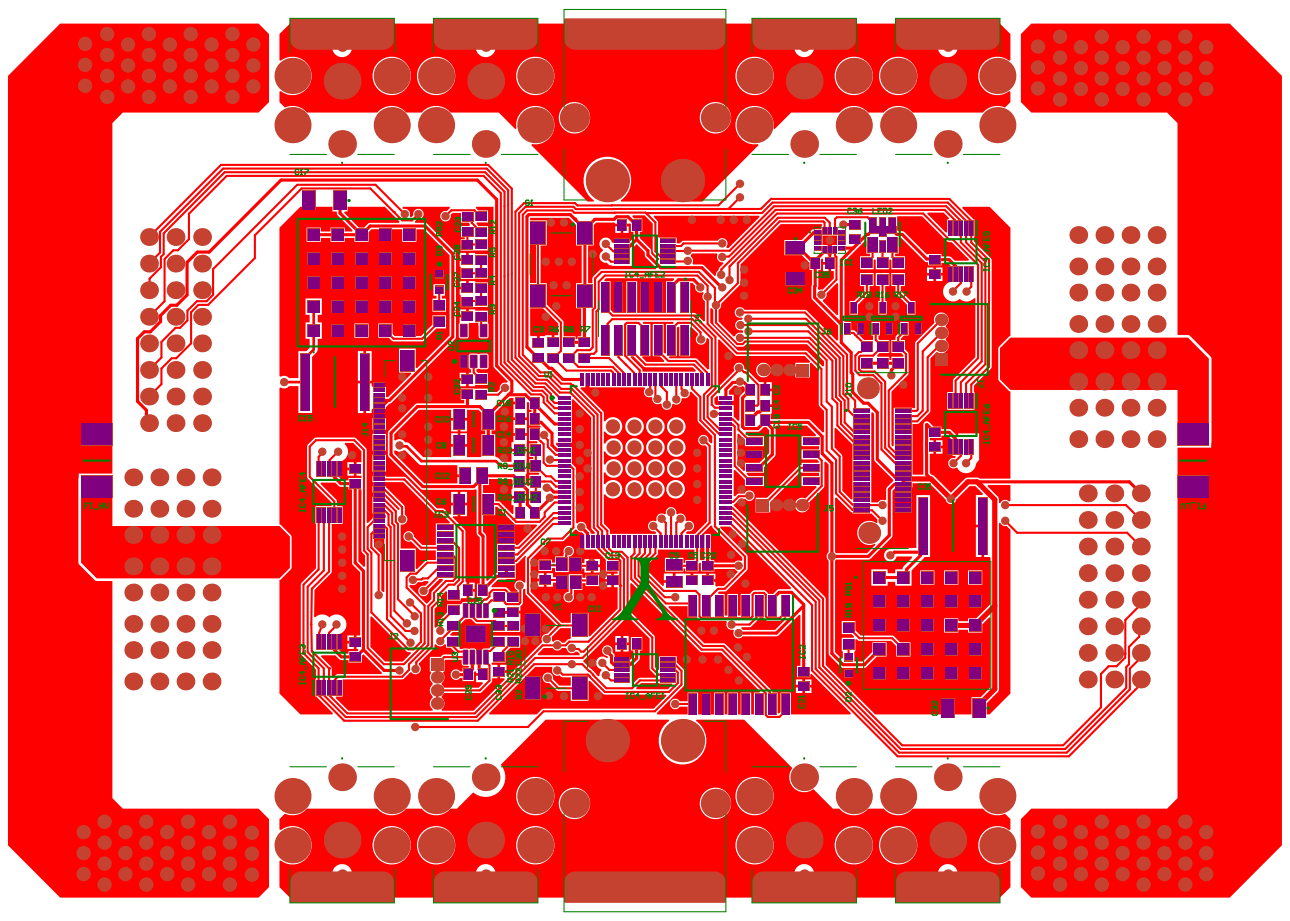
[picture p141: page 32]

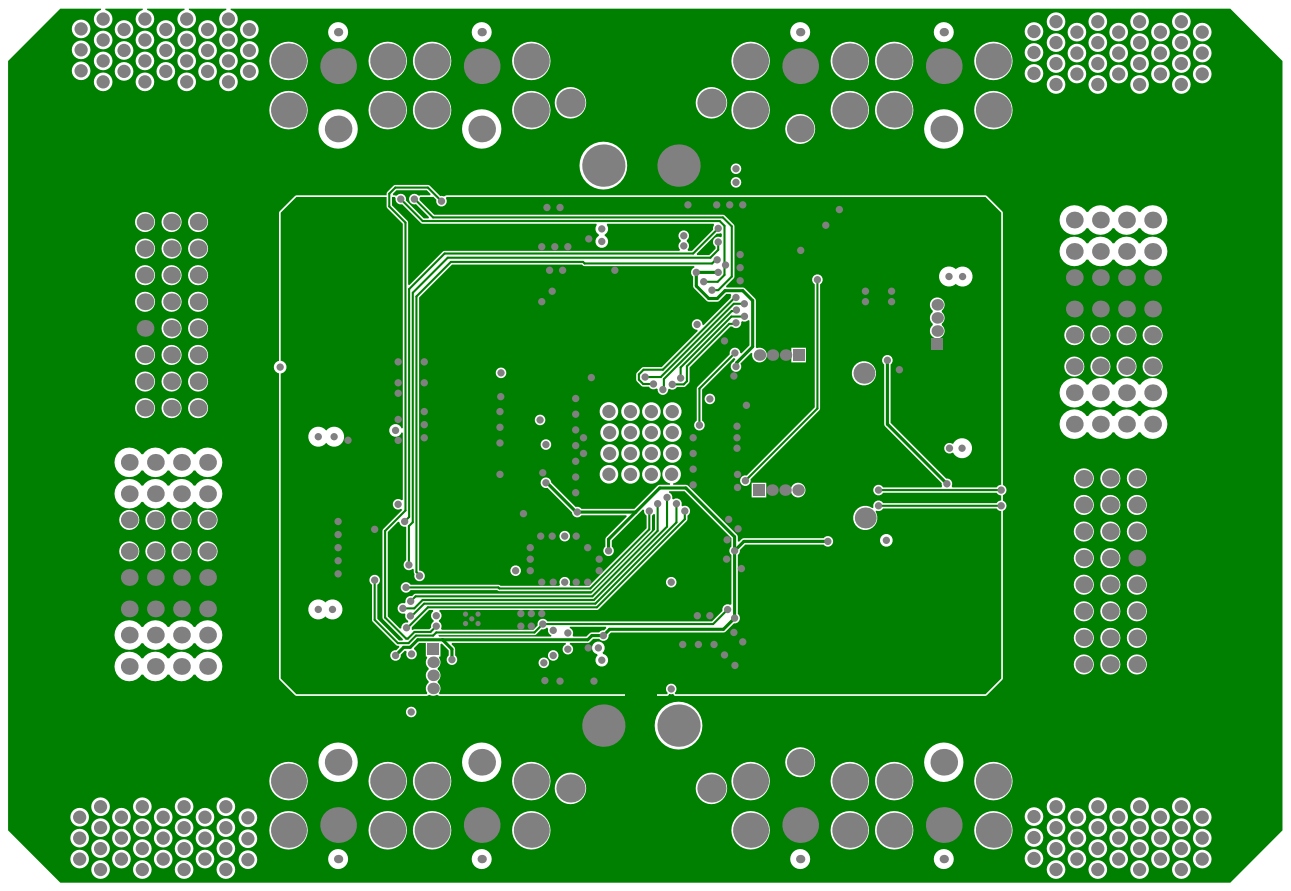
[picture p142: page 33]

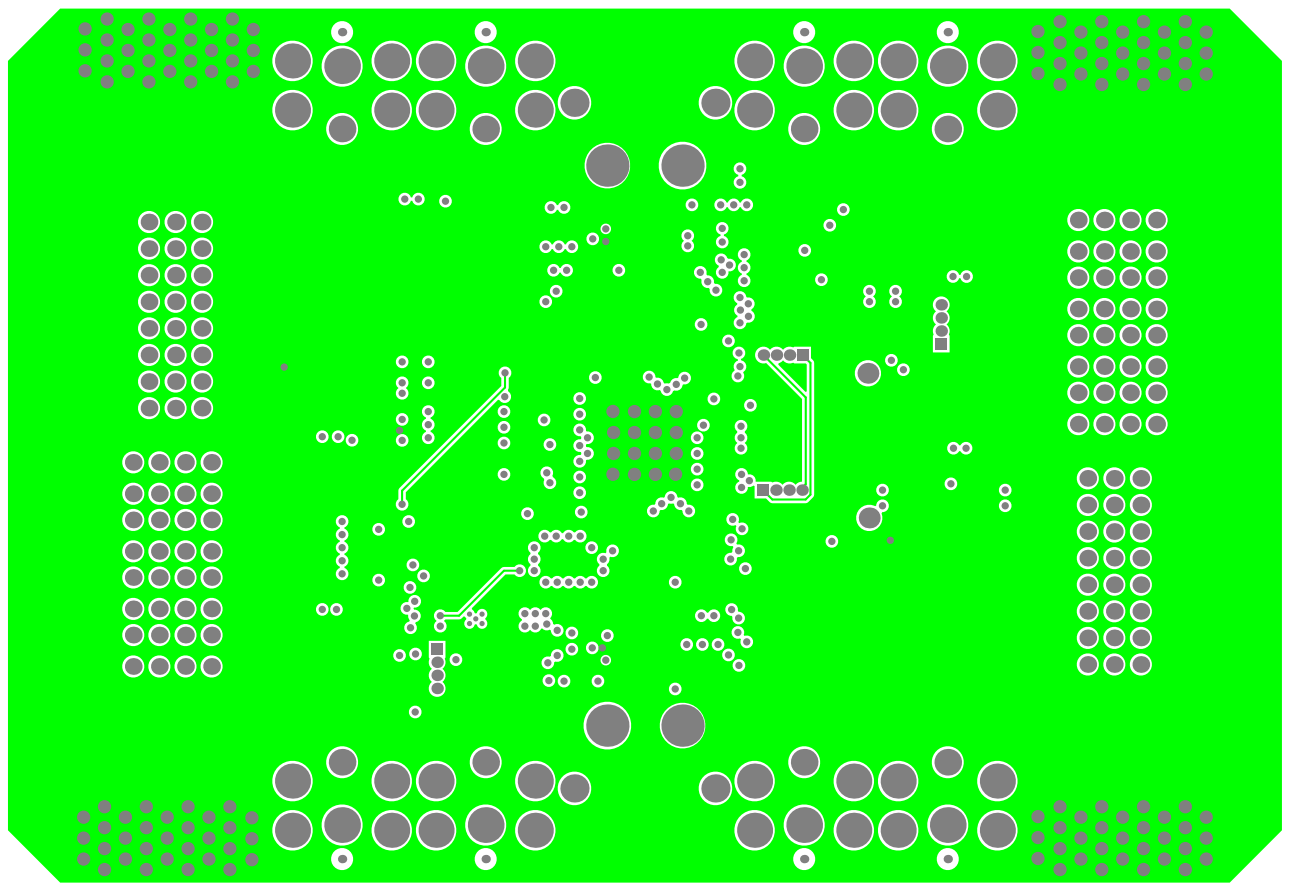
[picture p143: page 34]

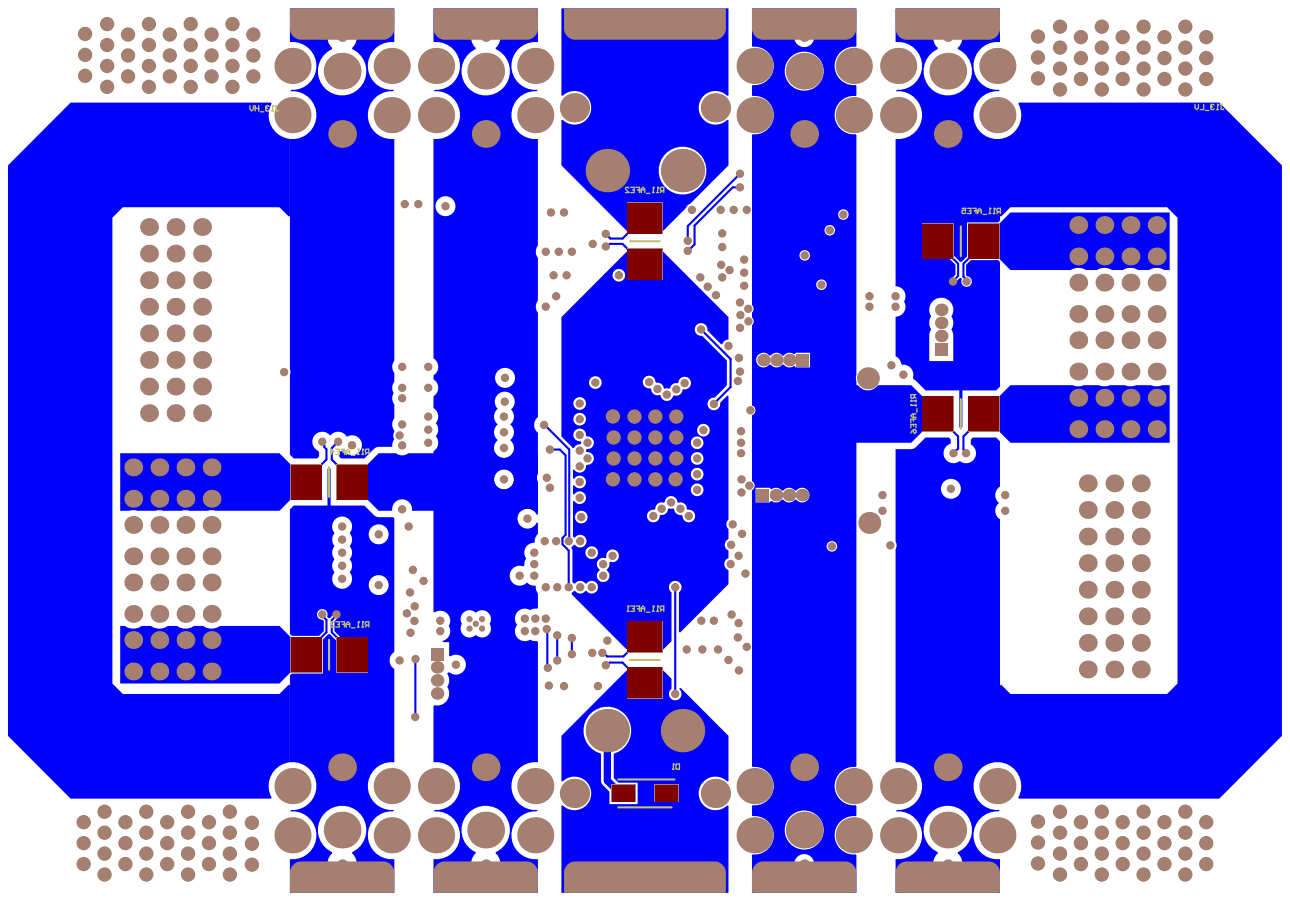
[picture p144: page 35]

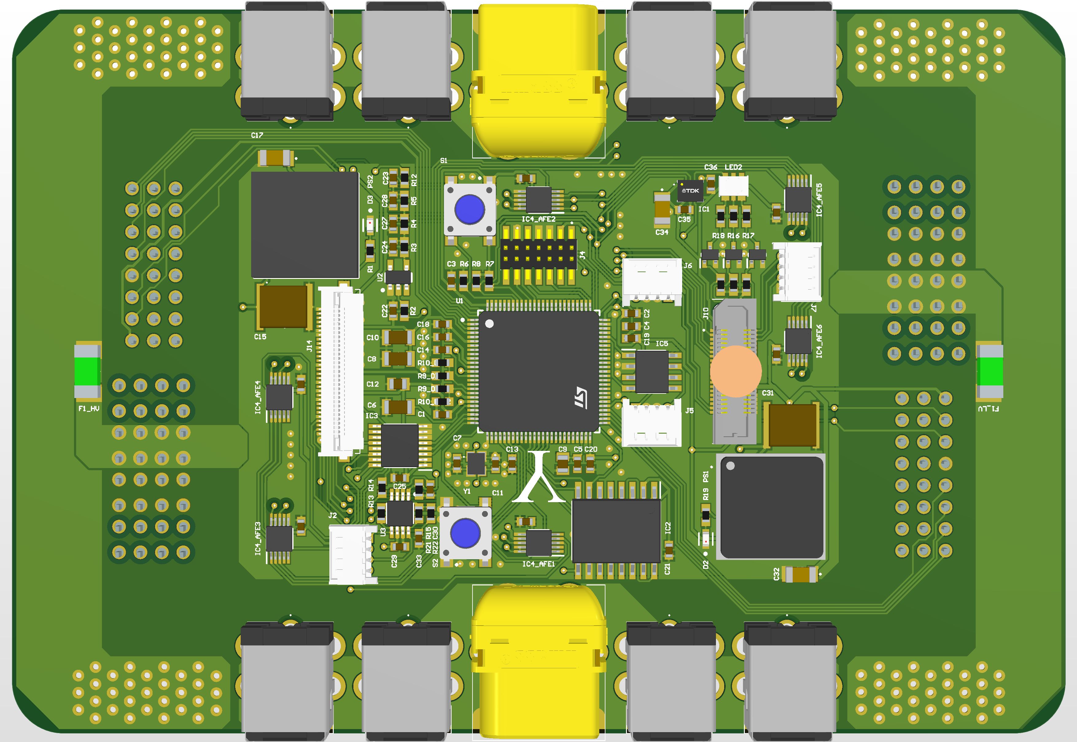
[picture p145: page 36]

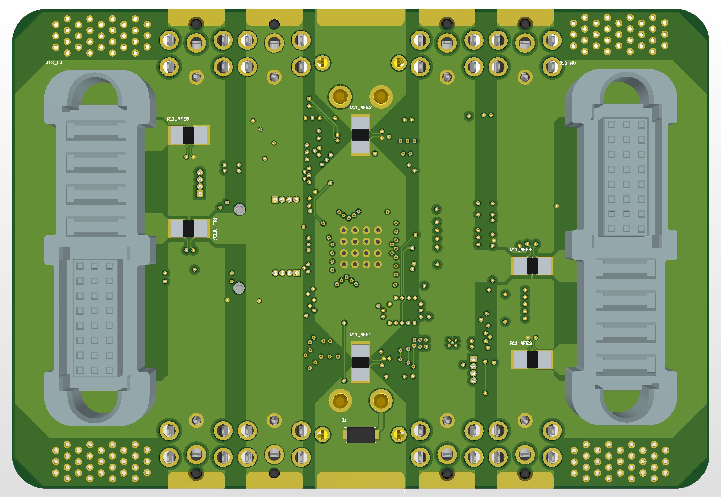
[picture p146: page 37]
