EPFLXplore/Power_HW/Pollux/Kicad/HVPowerModule/Output.pdf

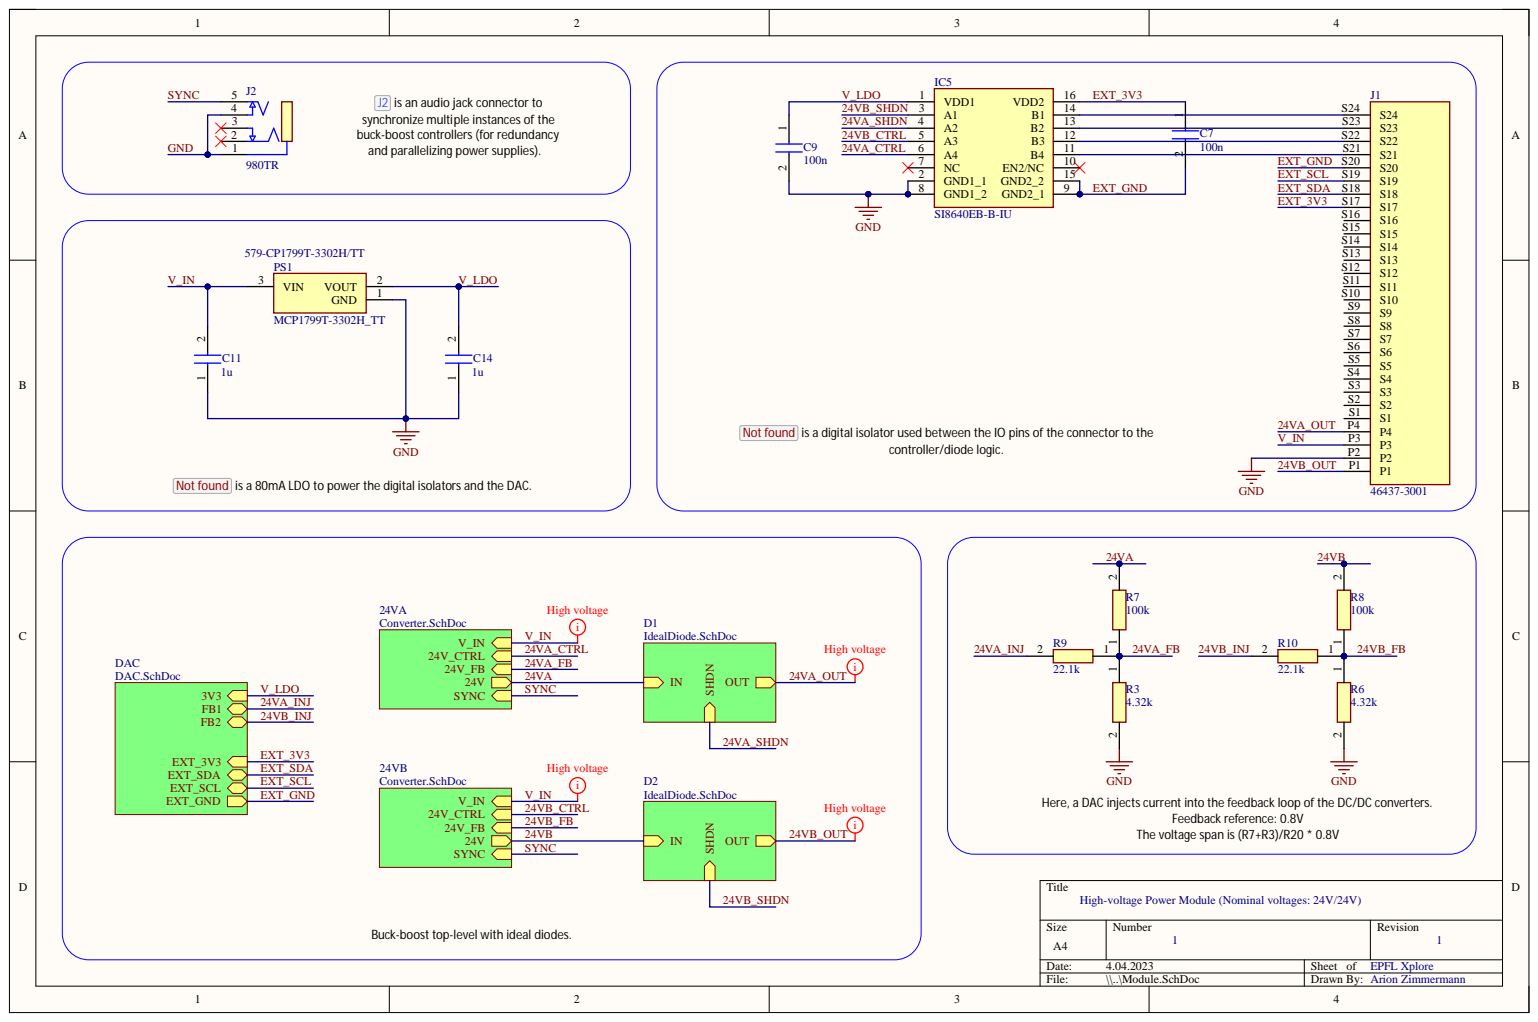
[picture p147: page 1]

J2 is an audio jack connector to
synchronize mult
buck-boost controllers (for redundancy
and parallelizing power supplies).

iple instances of the

EXT_GND

found is a digital isola

tor used between the IO pins of the connector to the controller/diode logic.

found is a 80mA LDO to power the digital isola

tors and the DAC.

Here, a DAC injects current in

to the feedback loop of the DC/DC con
Feedback reference: 0.8V
The voltage span is (R7+R3)/R20 * 0.8V

High-voltage Power Module (Nominal voltages: 24V/24V) 1

Buck-boost top-level with ideal diodes.

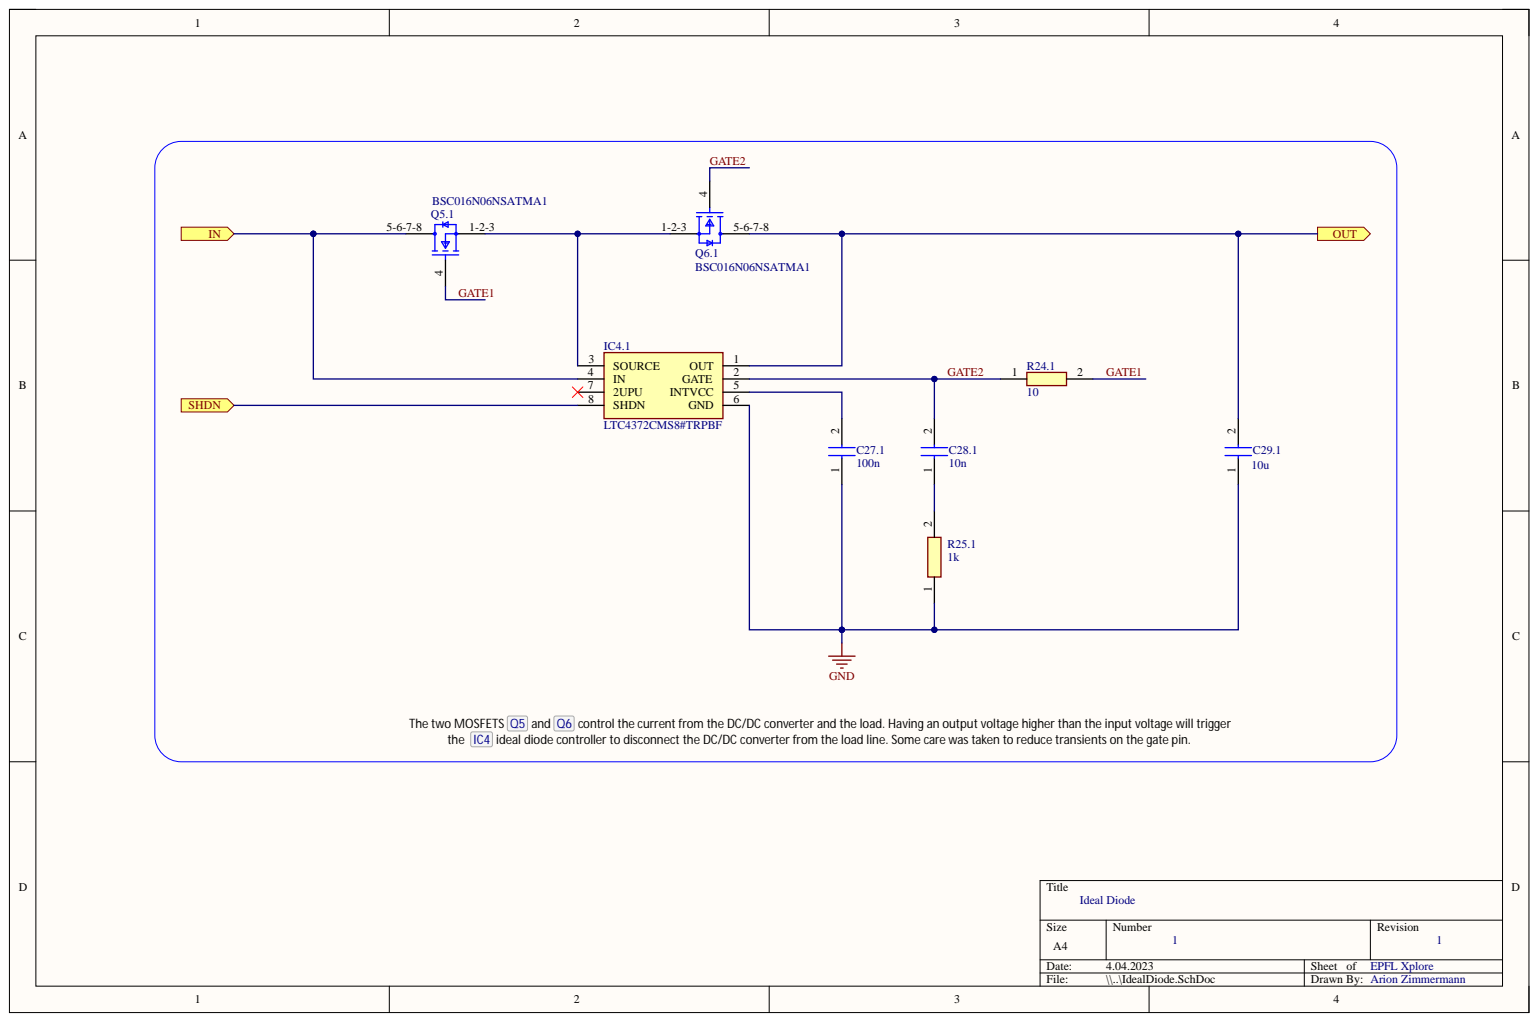
[picture p148: page 2]

The two MOSFETS Q5 an
the IC4 ideal diode controller to disconnect the DC/DC con

control the current from the DC/DC con

verter and the load. Having an output voltage higher than the input voltage will trigger
verter from the load line. Some care was taken to reduce transients on the ga

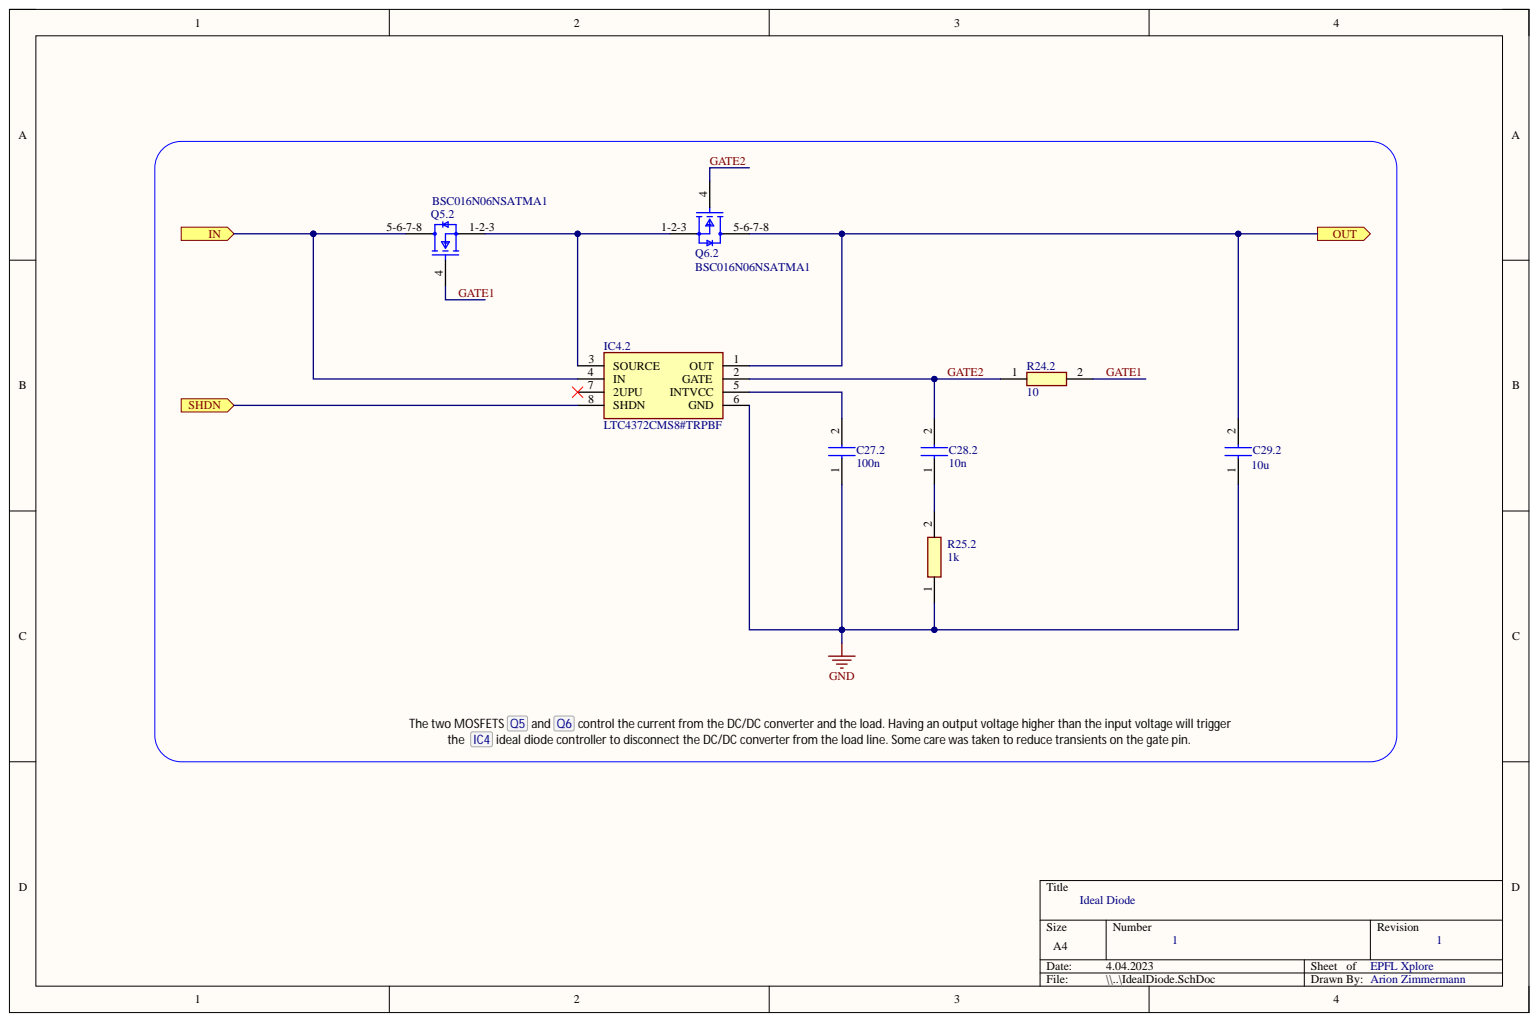
[picture p149: page 3]

The two MOSFETS Q5 an
the IC4 ideal diode controller to disconnect the DC/DC con

control the current from the DC/DC con

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

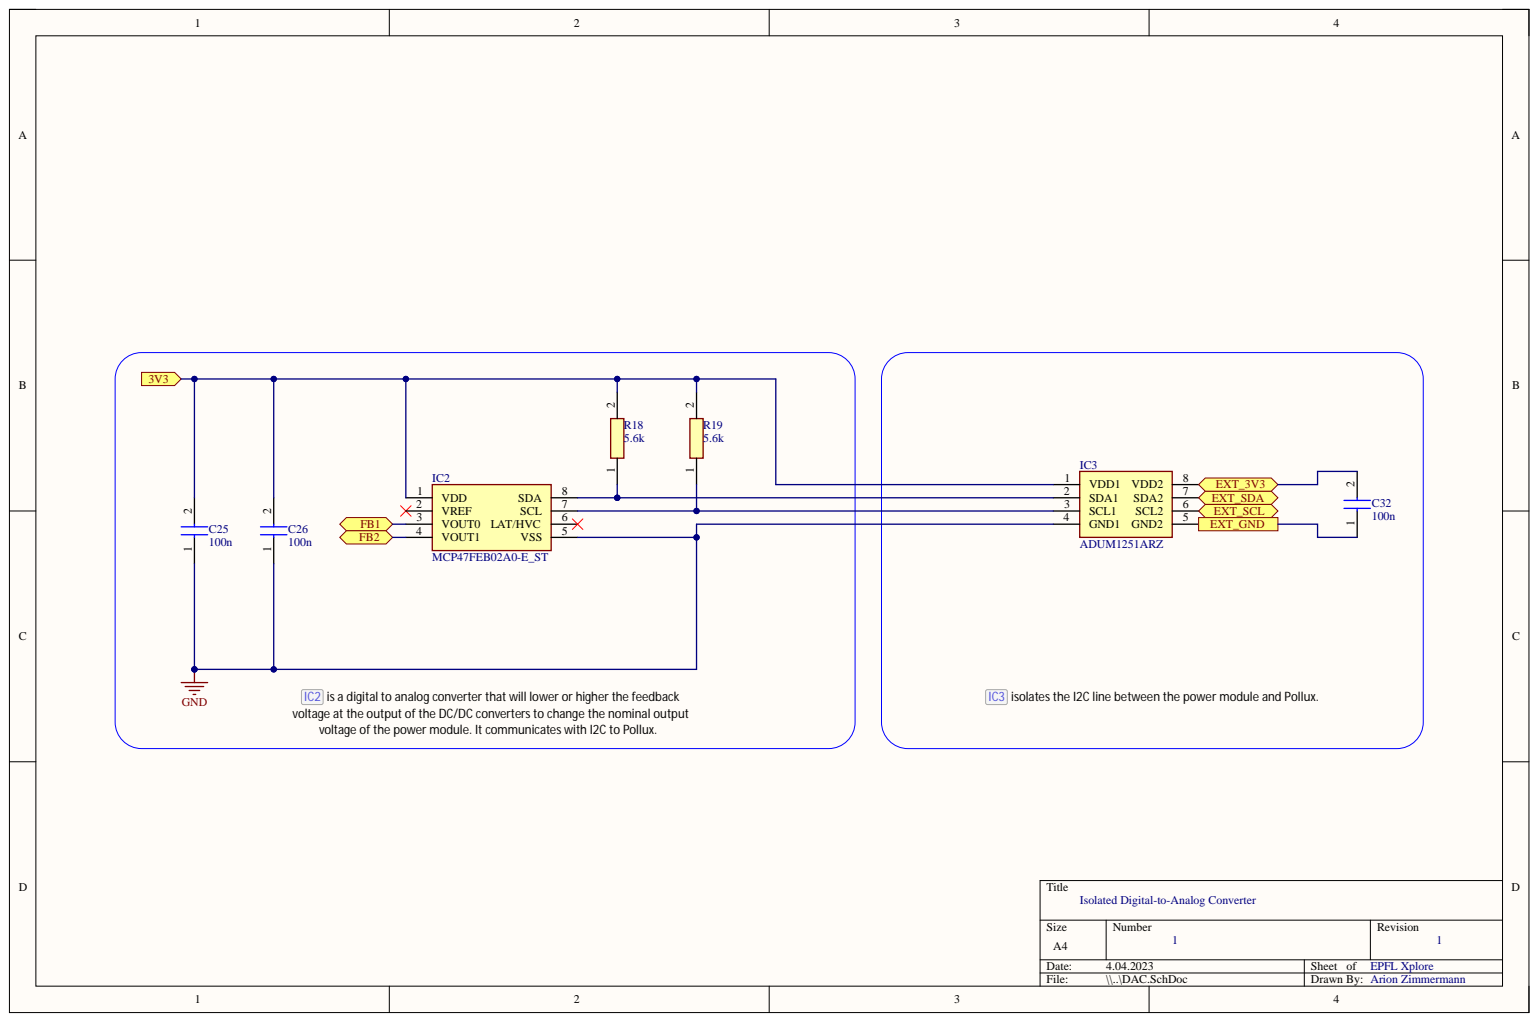
[picture p150: page 4]

IC2 is a digital to analog con
voltage at the output of the DC/DC con
voltage of the power module. It communica

verter that will lower or higher the feedback

tes the I2C line between the power module and Pollux.

verters to change the nominal output

tes with I2C to Pollux.

Isolated Digital-to-Analog Converter 1

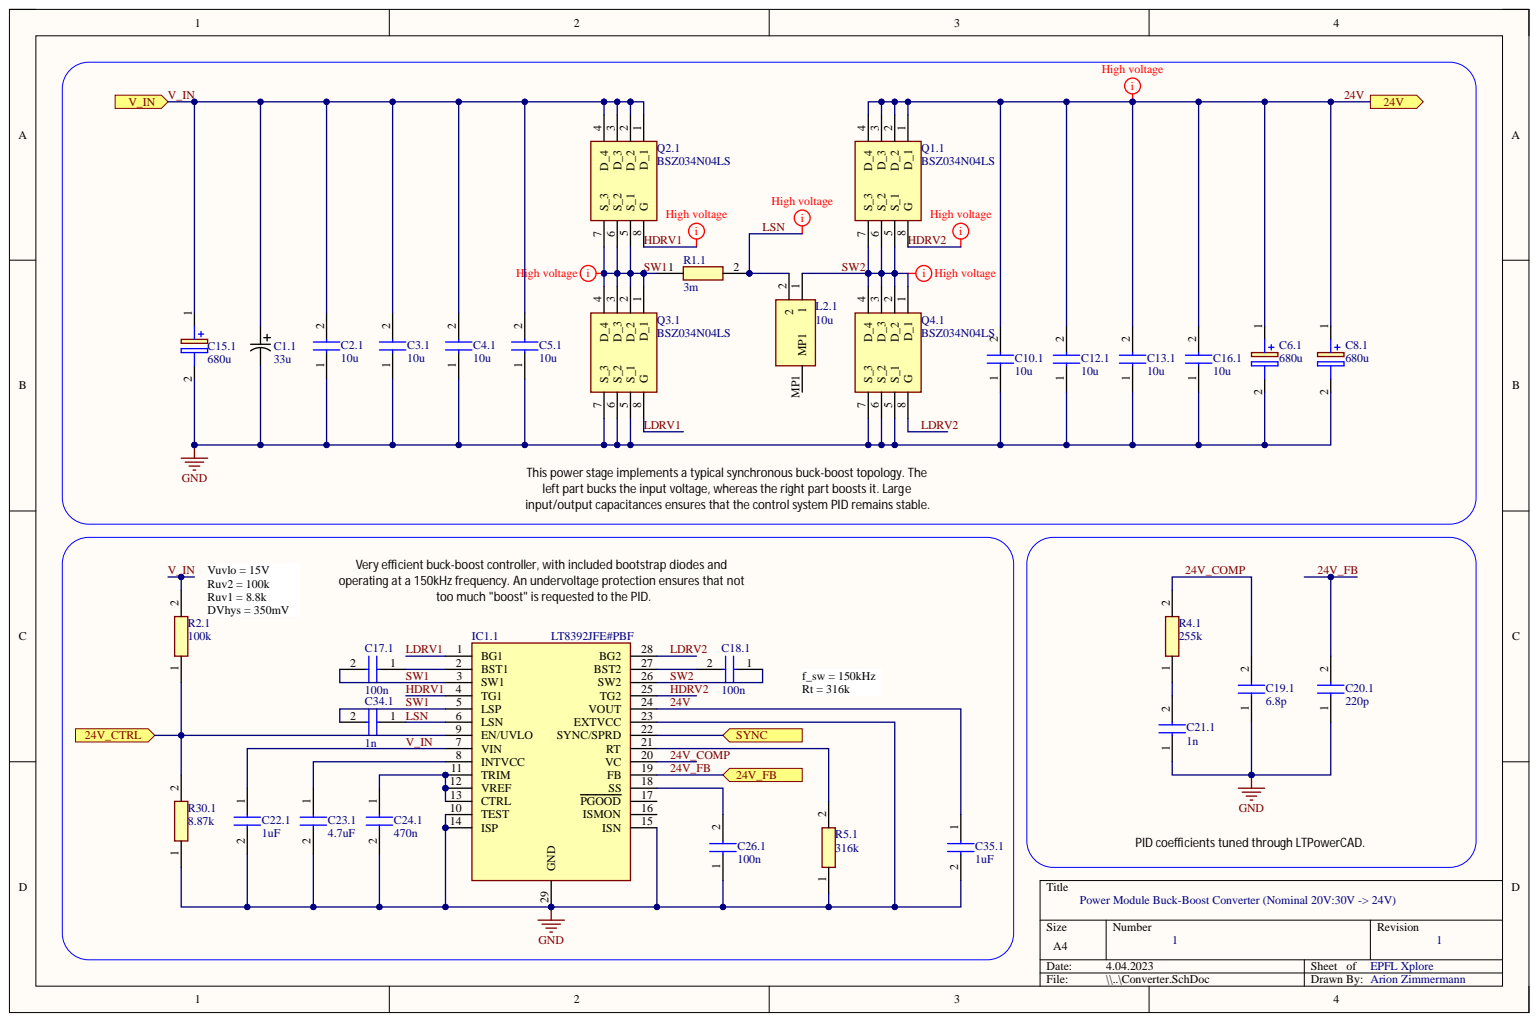
[picture p151: page 5]

This power stage implements a typical synchronous buck-boost topology. The
left part bucks the input voltage, whereas the right part boosts it. Large
input/output capacitances ensures that the control system PID remains stable.

Very efficient buck-boost controller, with included bootstrap diodes and
operating at a 150kHz frequency. An undervoltage protection ensures that not

too much "boost" is requested to the PID.

PID coefficients tuned through LTPowerCAD.

Power Module Buck-Boost Converter (Nominal 20V:30V -> 24V)

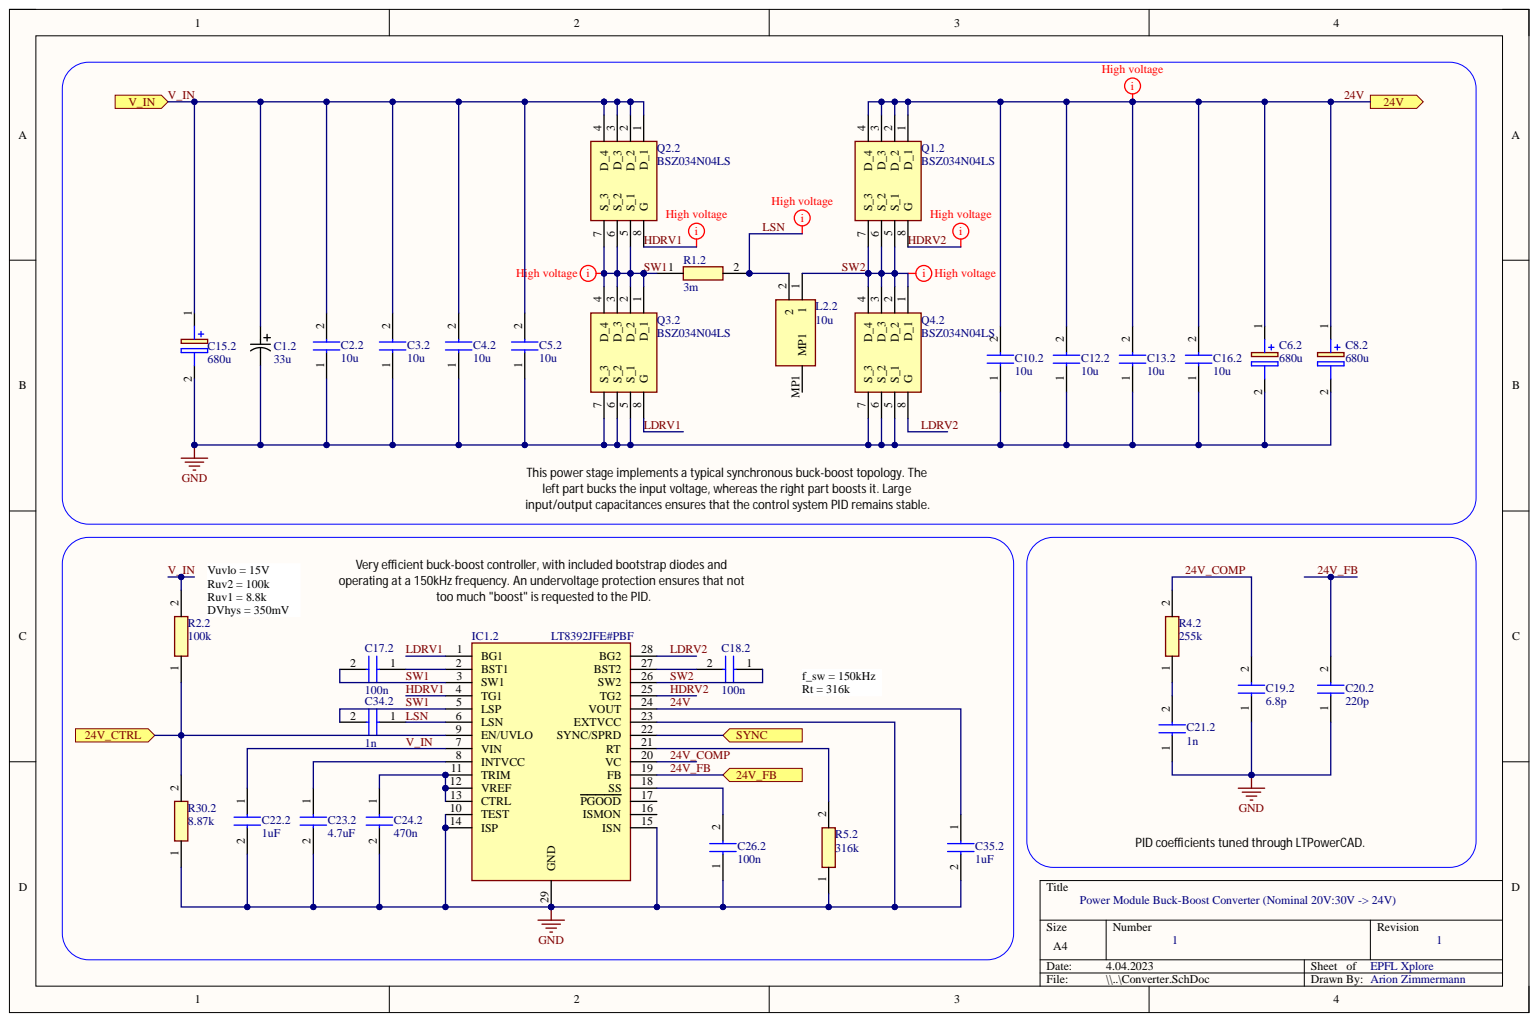
[picture p152: page 6]
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

too much "boost" is requested to the PID.

PID coefficients tuned through LTPowerCAD.

Power Module Buck-Boost Converter (Nominal 20V:30V -> 24V)

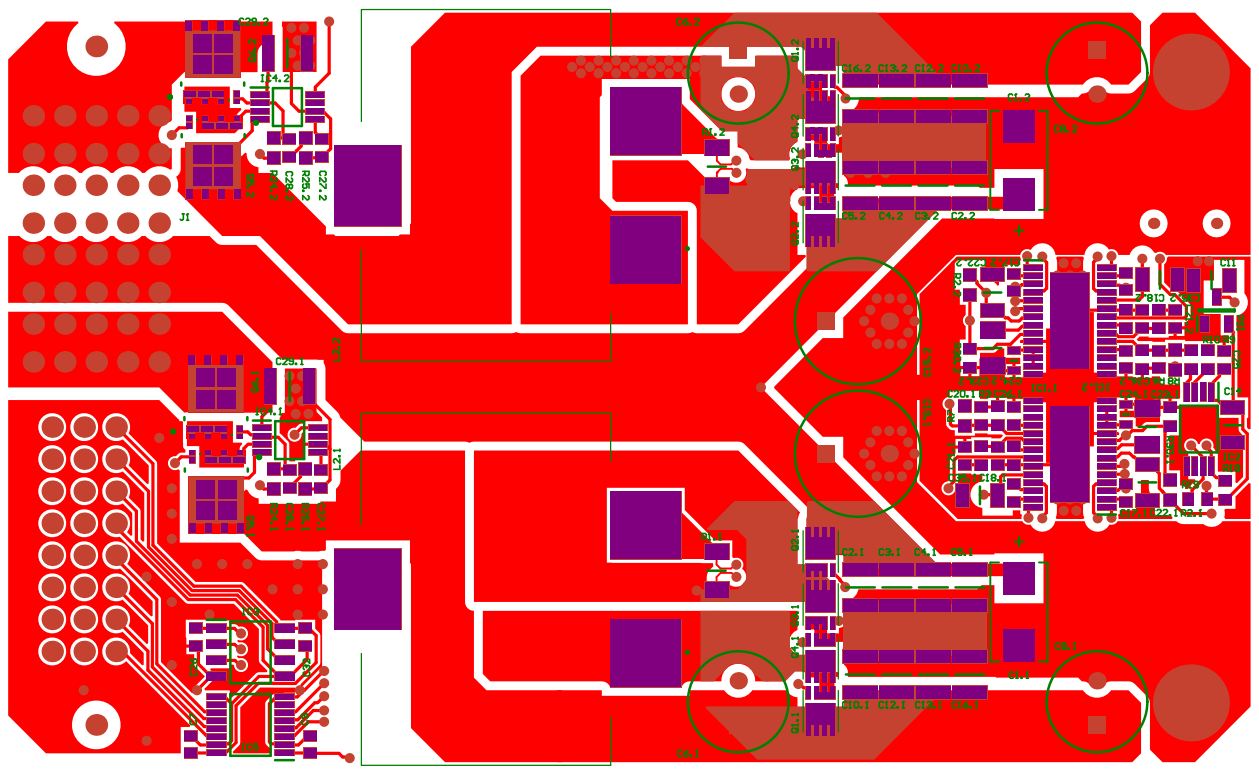
[picture p153: page 7]

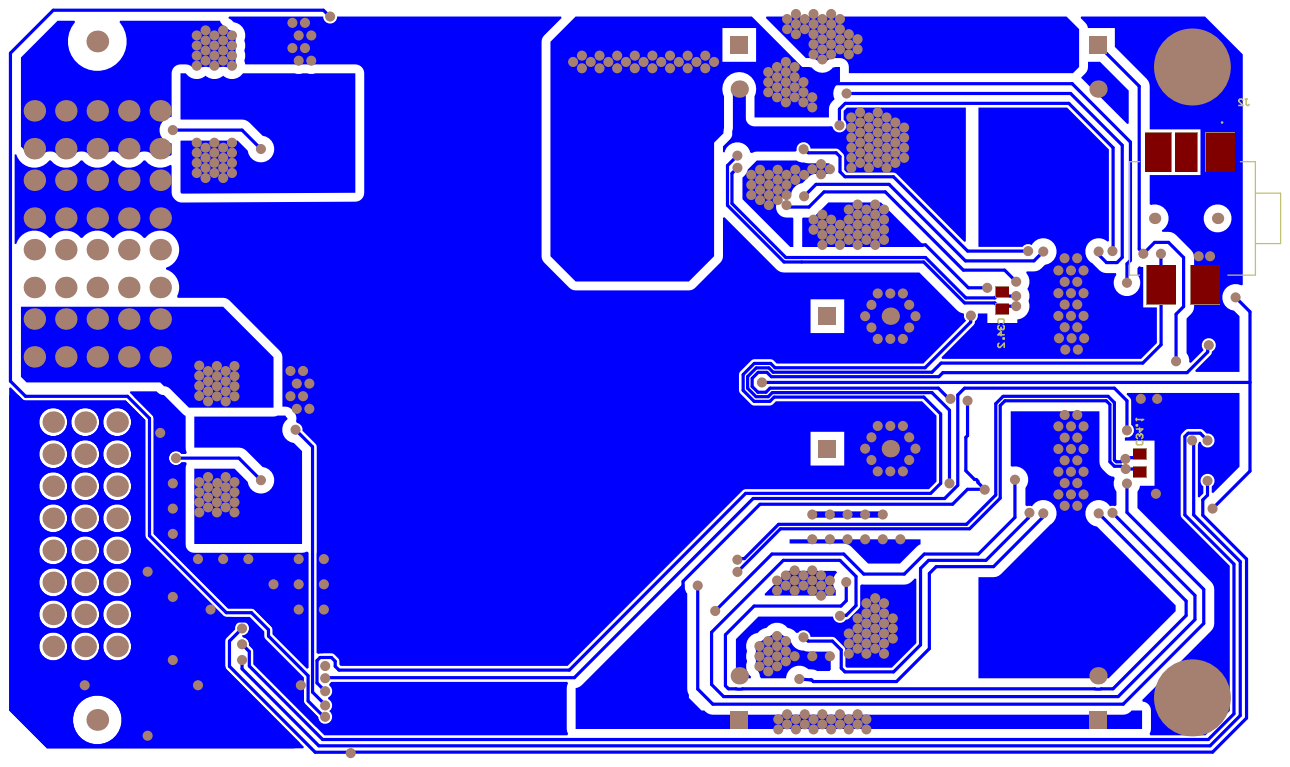
[picture p154: page 8]

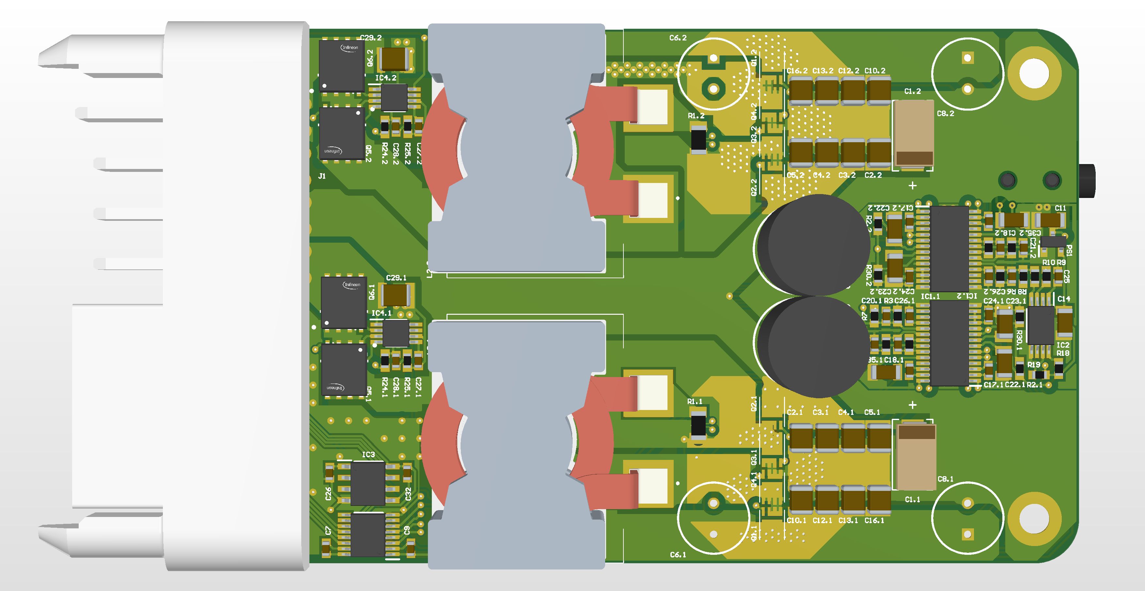
[picture p155: page 9]

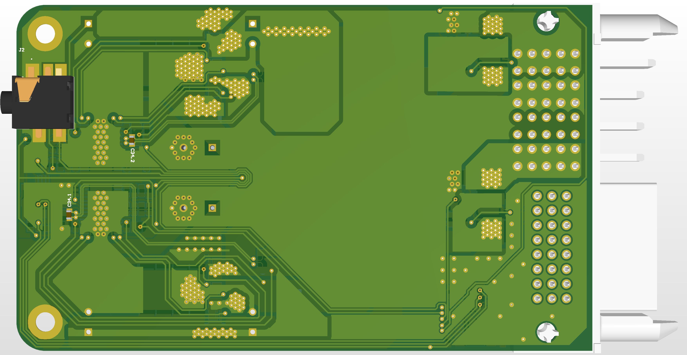
[picture p156: page 10]
