EPFLXplore/Power_HW/Pollux/Kicad/LVPowerModule/Output.pdf

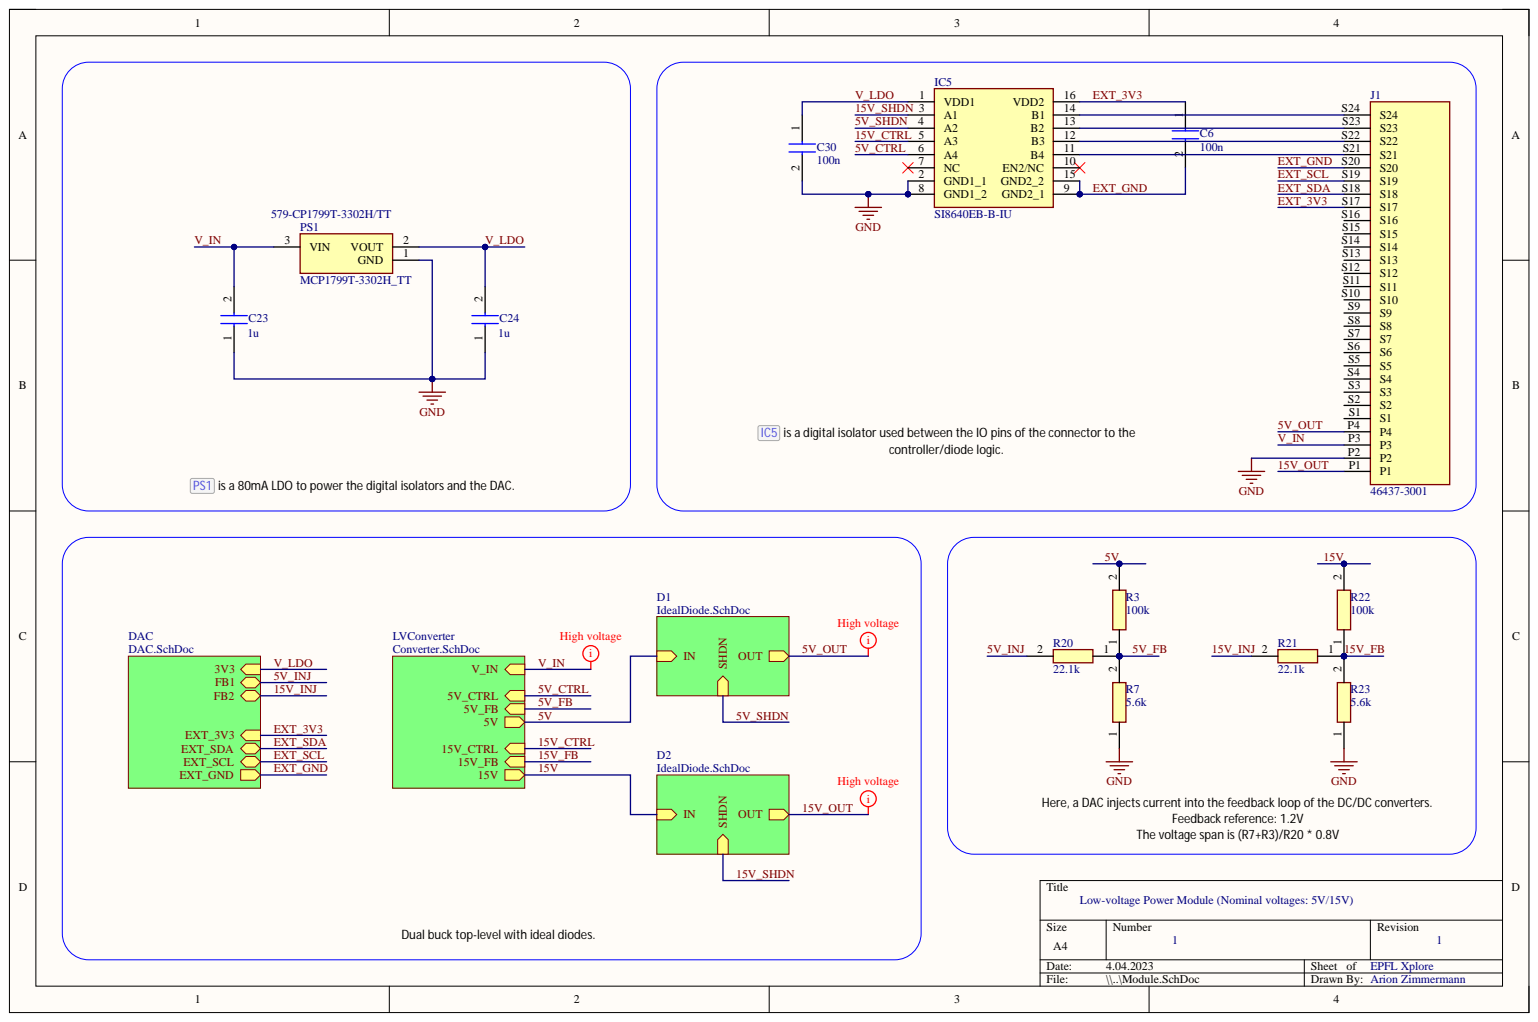
[picture p162: page 1]

EXT_GND

tor used between the IO pins of the connector to the controller/diode logic.

PS1 is a 80mA LDO to power the digital isola

tors and the DAC.

Here, a DAC injects current in

to the feedback loop of the DC/DC con
Feedback reference: 1.2V
The voltage span is (R7+R3)/R20 * 0.8V

Low-voltage Power Module (Nominal voltages: 5V/15V) 1

Dual buck top-level with ideal diodes.

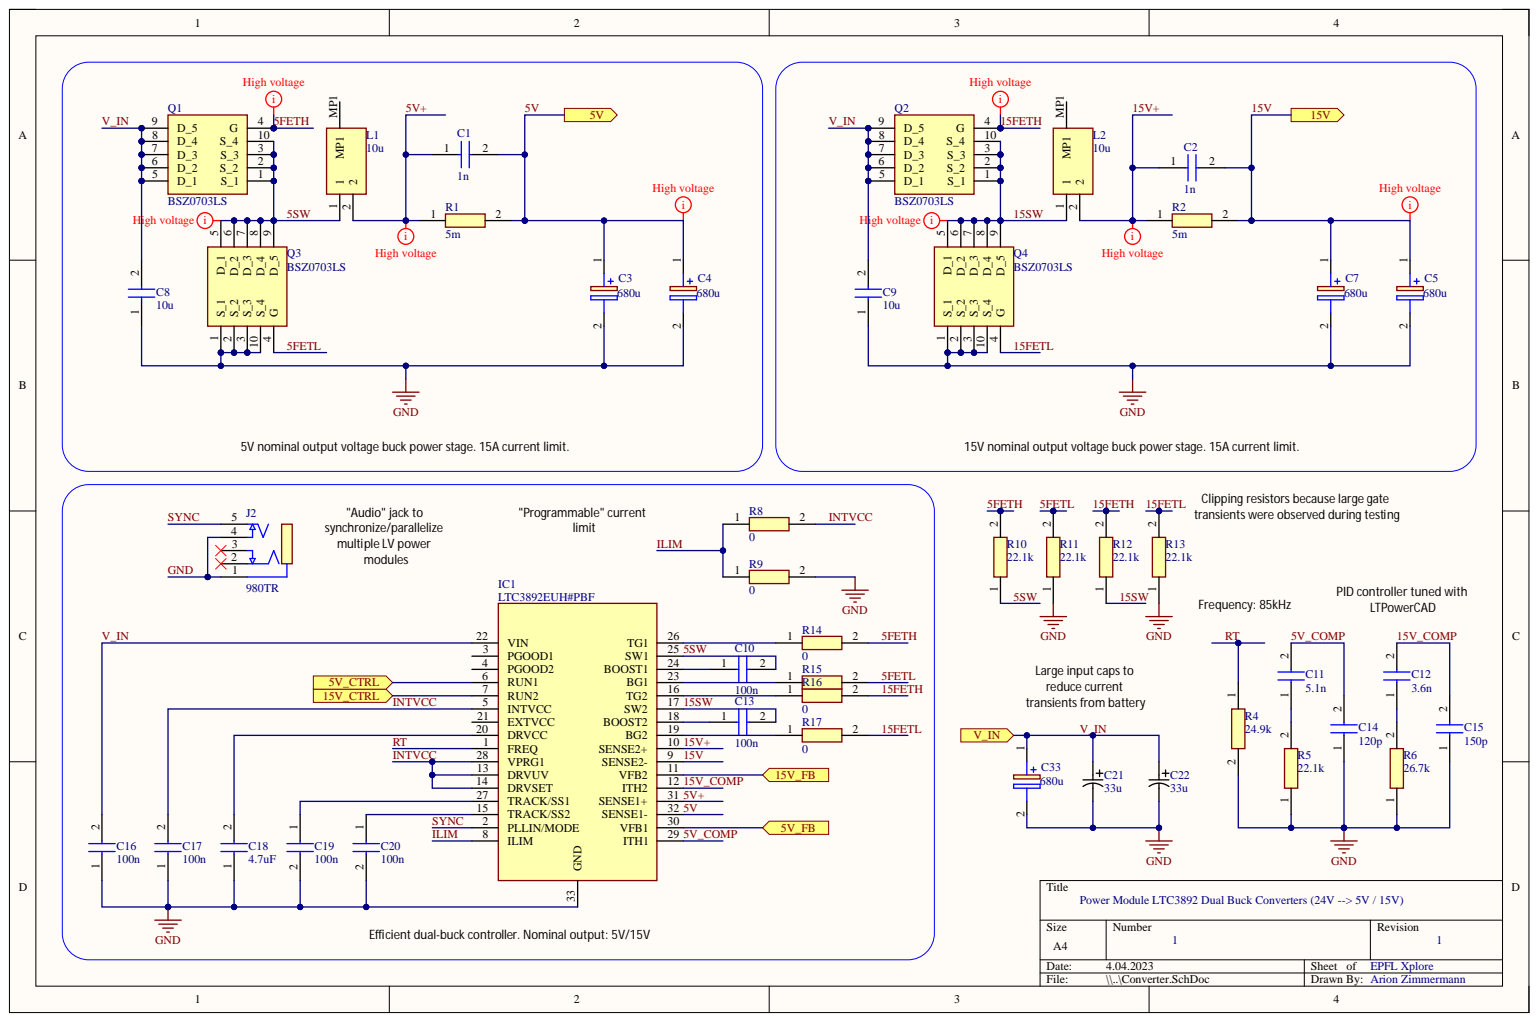
[picture p163: page 2]

Clipping resistors because large gate
transients were observed during testing

PID controller tuned with
LTPowerCAD

Large input caps to
reduce current
transients from battery

TRACK/SS2 15 | 5V
PLLIN/MODE 2 ILIM 8 | 5V_COMP

Power Module LTC3892 Dual Buck Converters (24V --> 5V / 15V)

Efficient dual-buck controller. Nominal output: 5V/15V


IC2 is a digital to analog con
voltage at the output of the DC/DC con
voltage of the power module. It communica

verter that will lower or higher the feedback

tes the I2C line between the power module and Pollux.

verters to change the nominal output

tes with I2C to Pollux.

Isolated Digital-to-Analog Converter 1

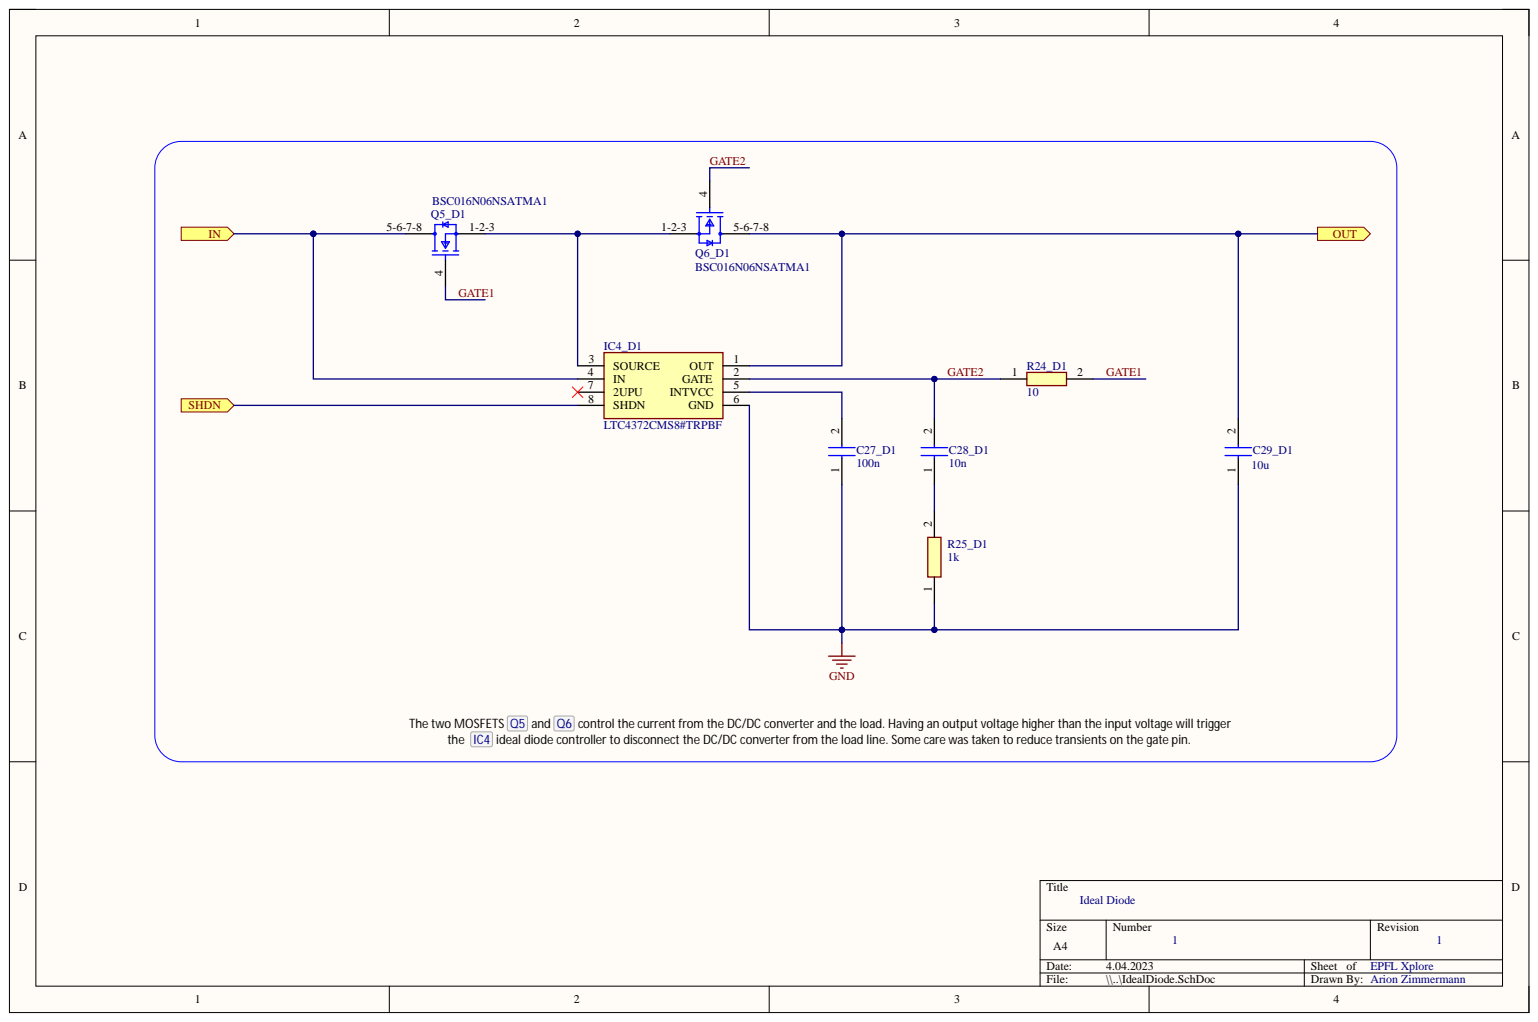
[picture p164: page 4]

The two MOSFETS Q5 an
the IC4 ideal diode controller to disconnect the DC/DC con

control the current from the DC/DC con

verter and the load. Having an output voltage higher than the input voltage will trigger
verter from the load line. Some care was taken to reduce transients on the ga

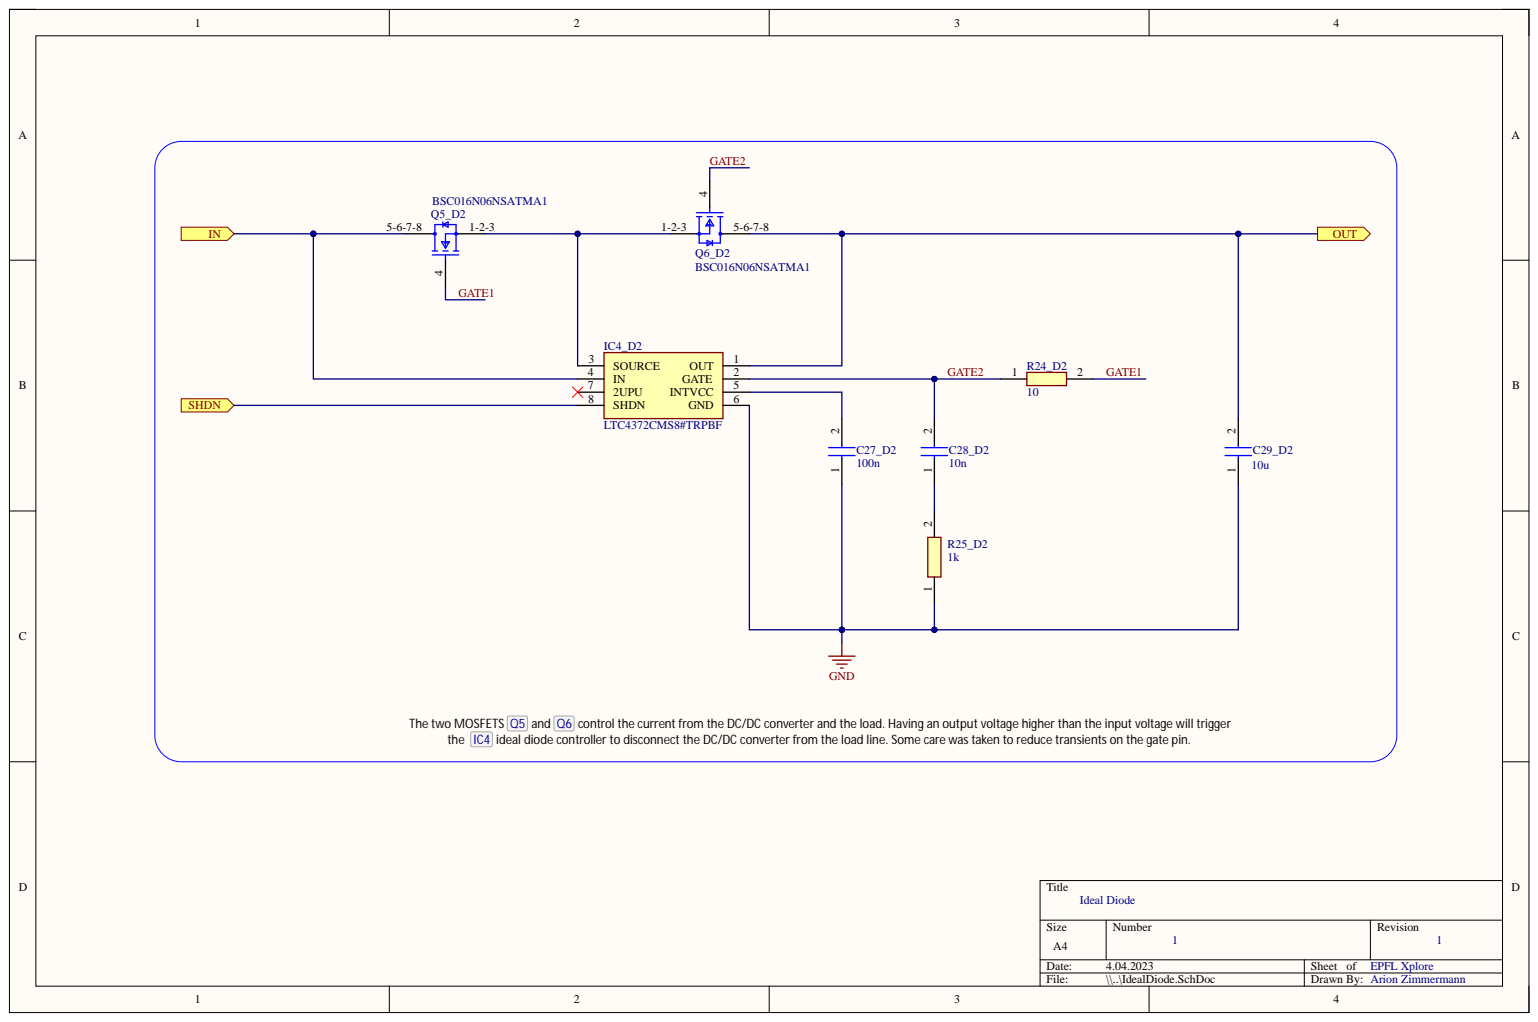
[picture p165: page 5]

The two MOSFETS Q5 an
the IC4 ideal diode controller to disconnect the DC/DC con

control the current from the DC/DC con

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

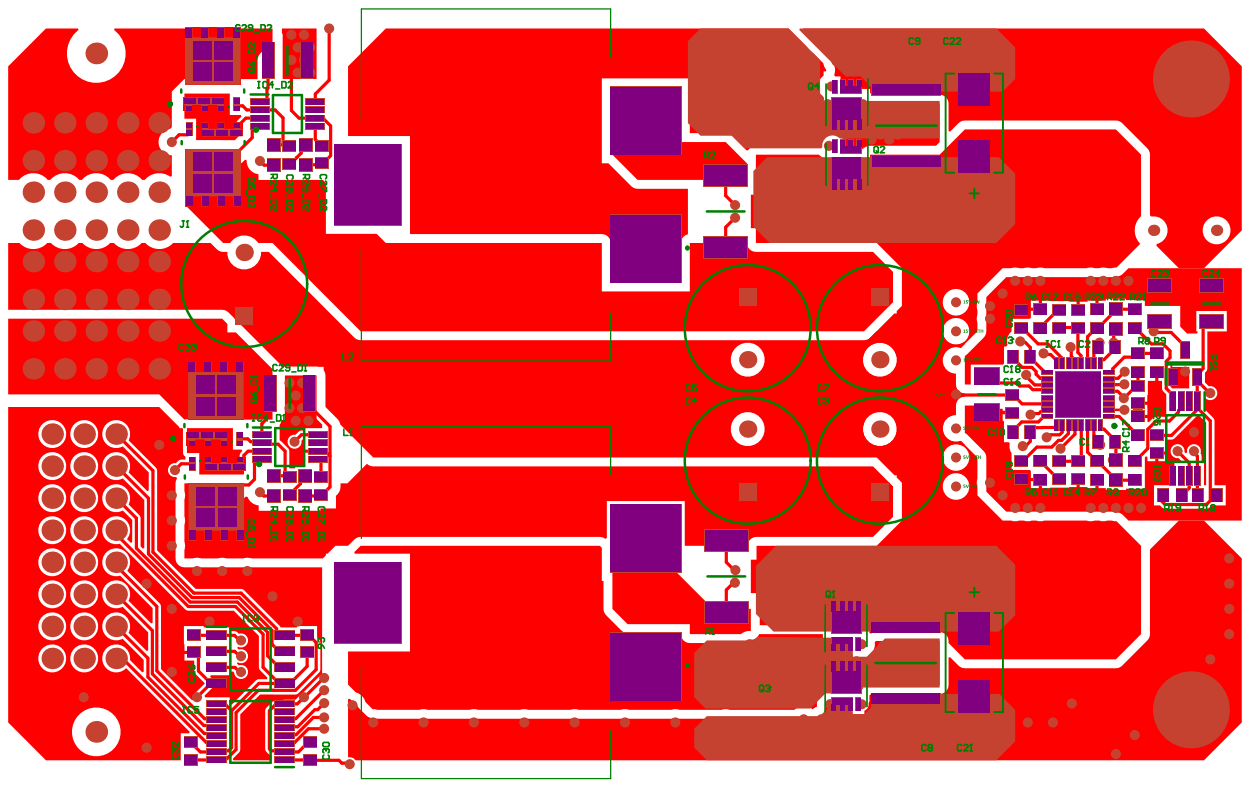
[picture p166: page 6]

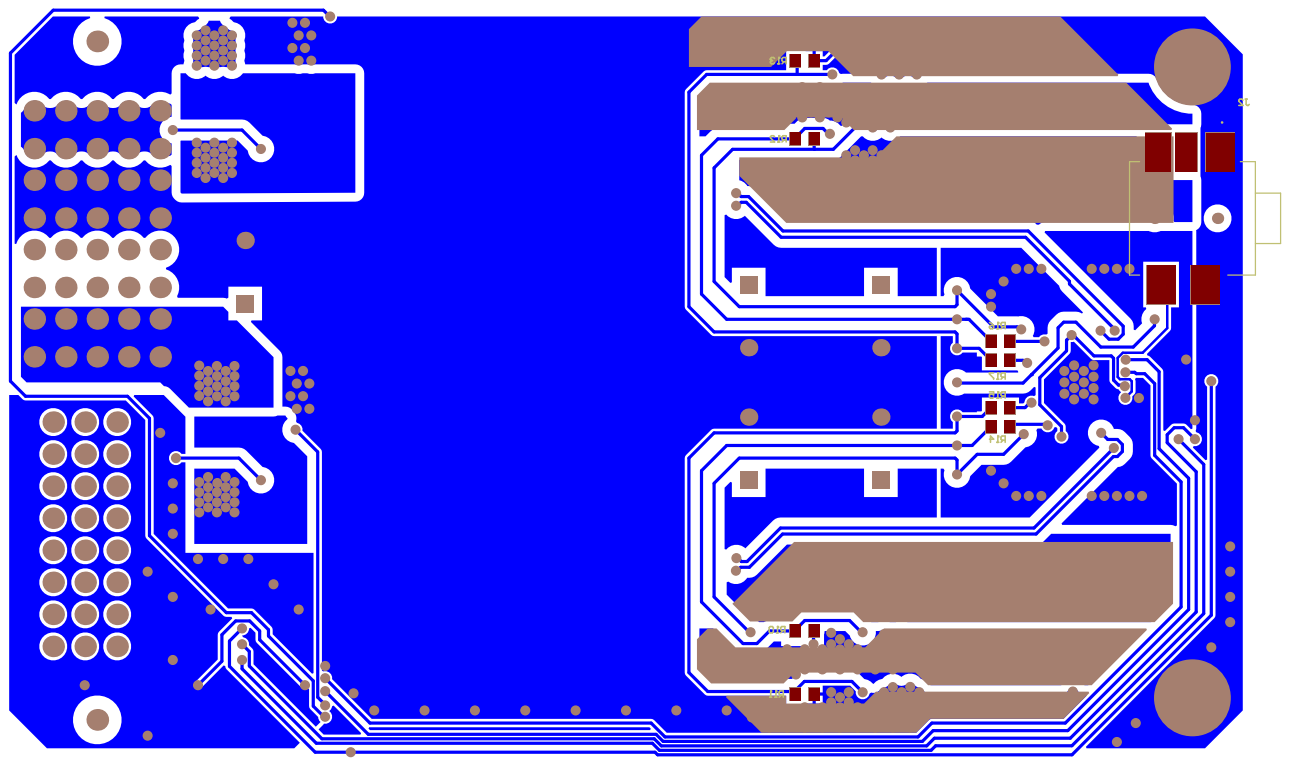
[picture p167: page 7]

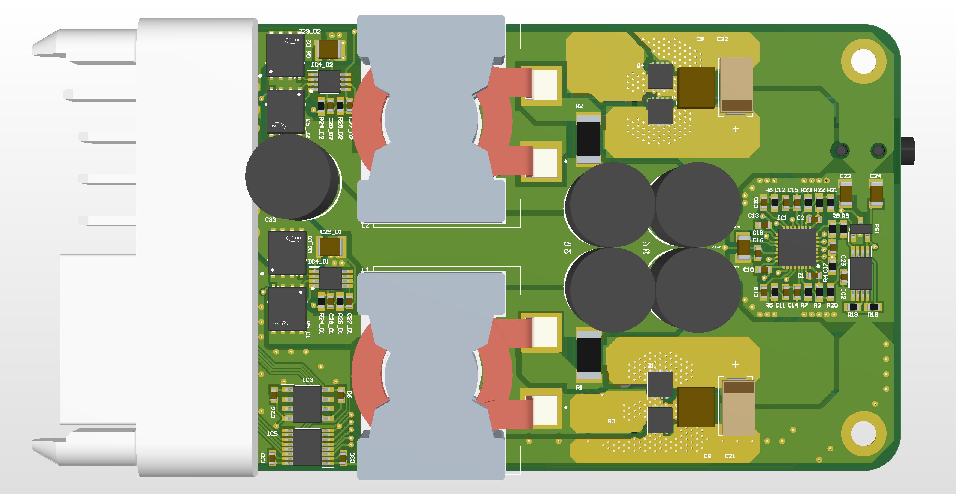
[picture p168: page 8]

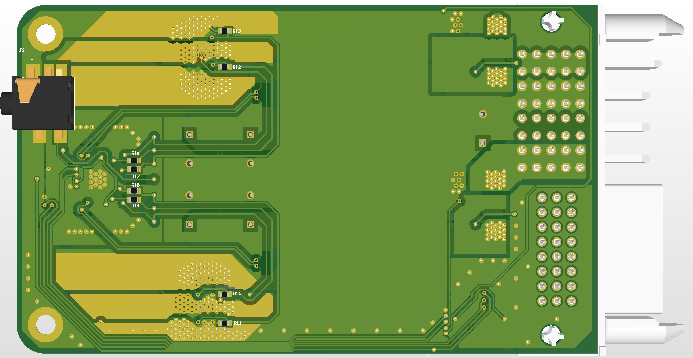
[picture p169: page 9]
