EPFLXplore/Power_HW/GEODE/rev1/Documentation/PDF design files/Layout/Module/SMPS_legged_robot_module-Edge_Cuts.pdf

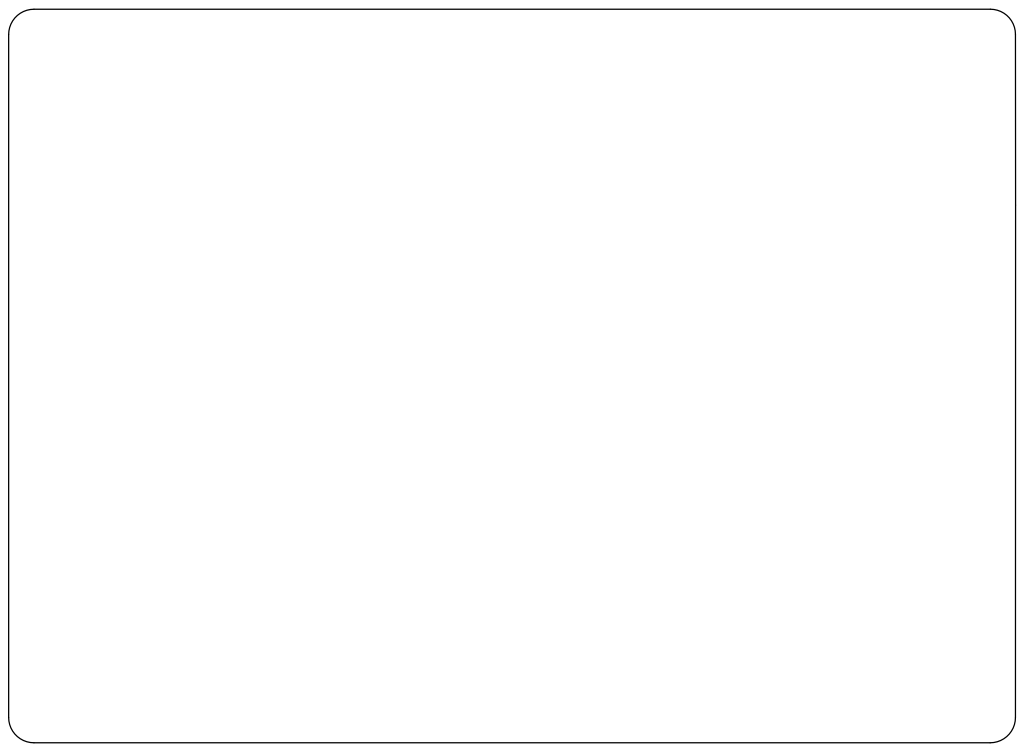
[picture p170: page 1]
