EPFLXplore/Power_HW/GEODE/rev1/Documentation/PDF design files/Layout/Module/SMPS_legged_robot_module-L1 (Sig, PWR).pdf

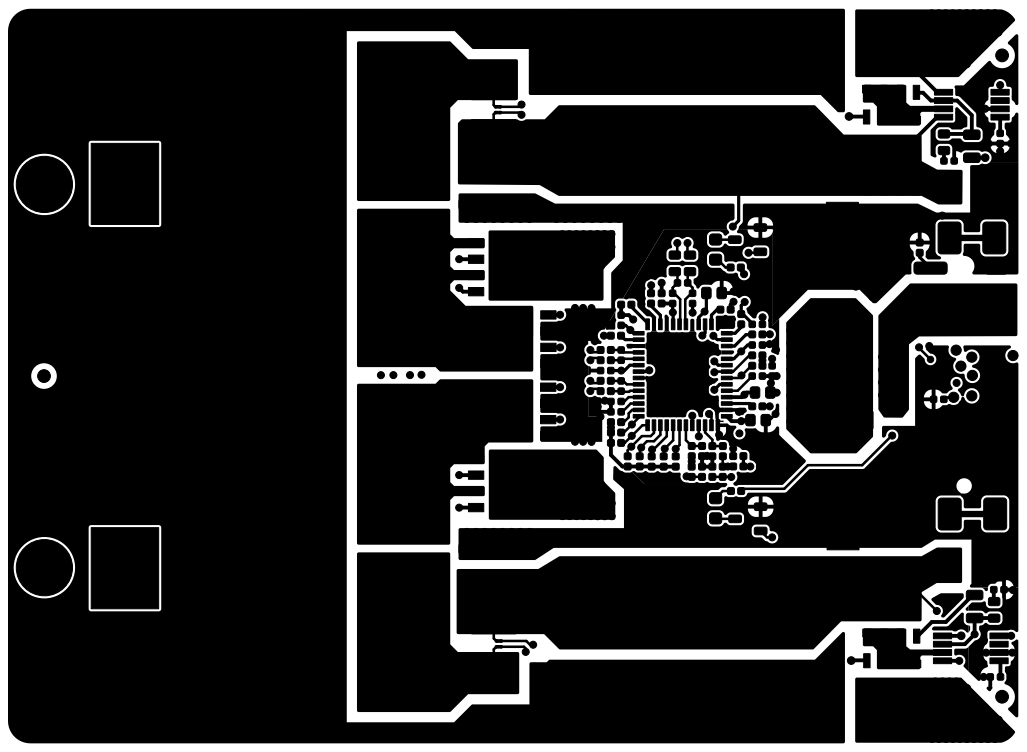
[picture p171: page 1]
