EPFLXplore/Power_HW/GEODE/rev1/Documentation/PDF design files/Layout/Module/SMPS_legged_robot_module-L2 (GND).pdf

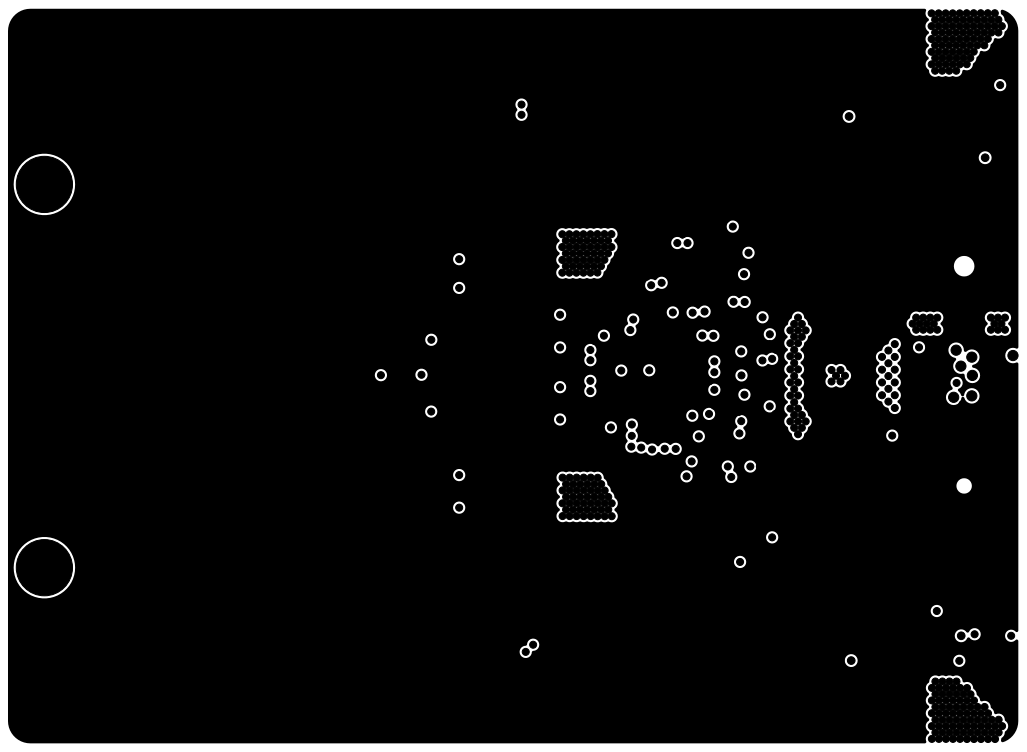
[picture p172: page 1]
