EPFLXplore/Power_HW/GEODE/rev1/Documentation/PDF design files/Layout/Module/SMPS_legged_robot_module-L3 (Sig, PWR).pdf

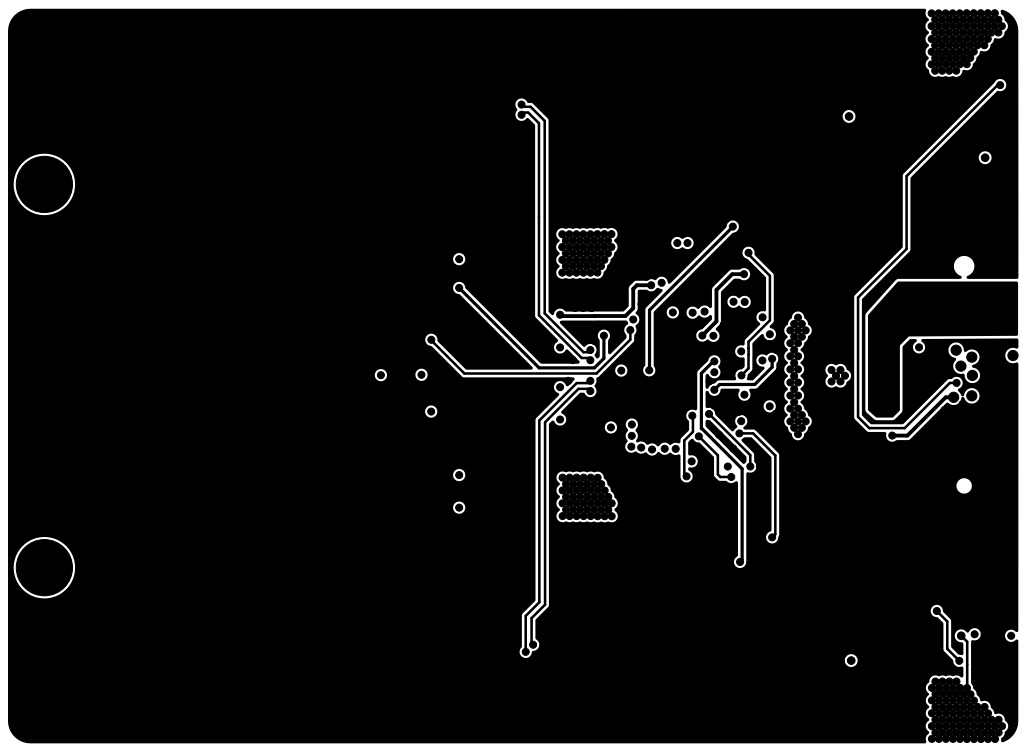
[picture p173: page 1]
