EPFLXplore/Power_HW/GEODE/rev1/Documentation/PDF design files/Layout/Module/SMPS_legged_robot_module-L4 (Sig, PWR).pdf

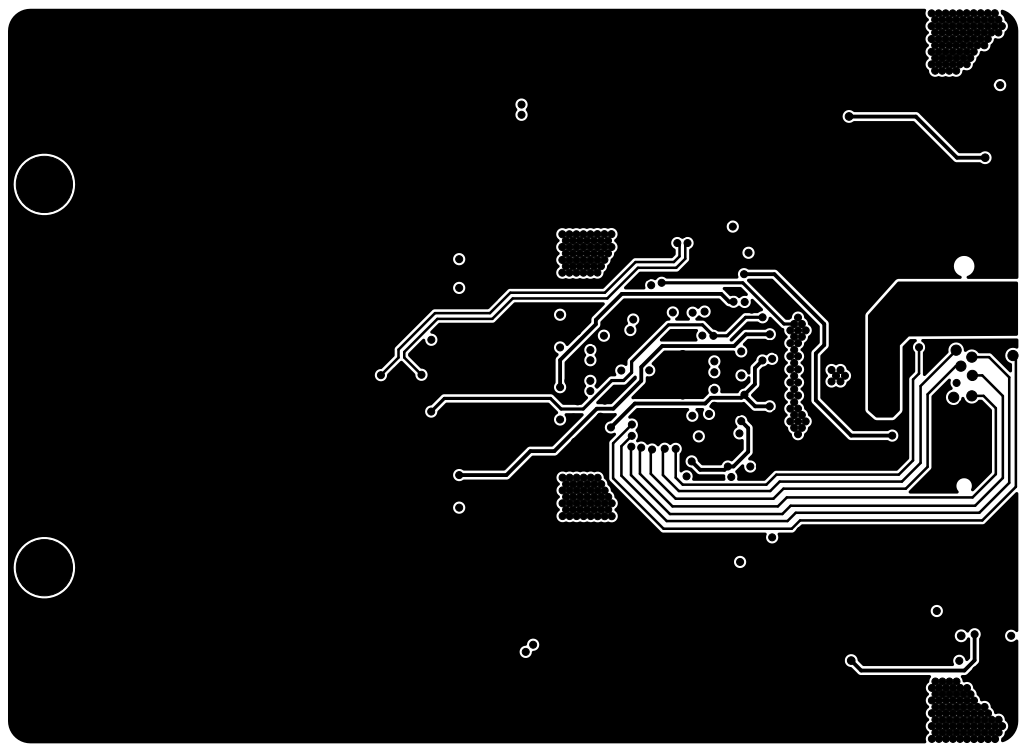
[picture p174: page 1]
