EPFLXplore/Power_HW/GEODE/rev1/Documentation/PDF design files/Layout/Module/SMPS_legged_robot_module-L6 (Sig, PWR).pdf

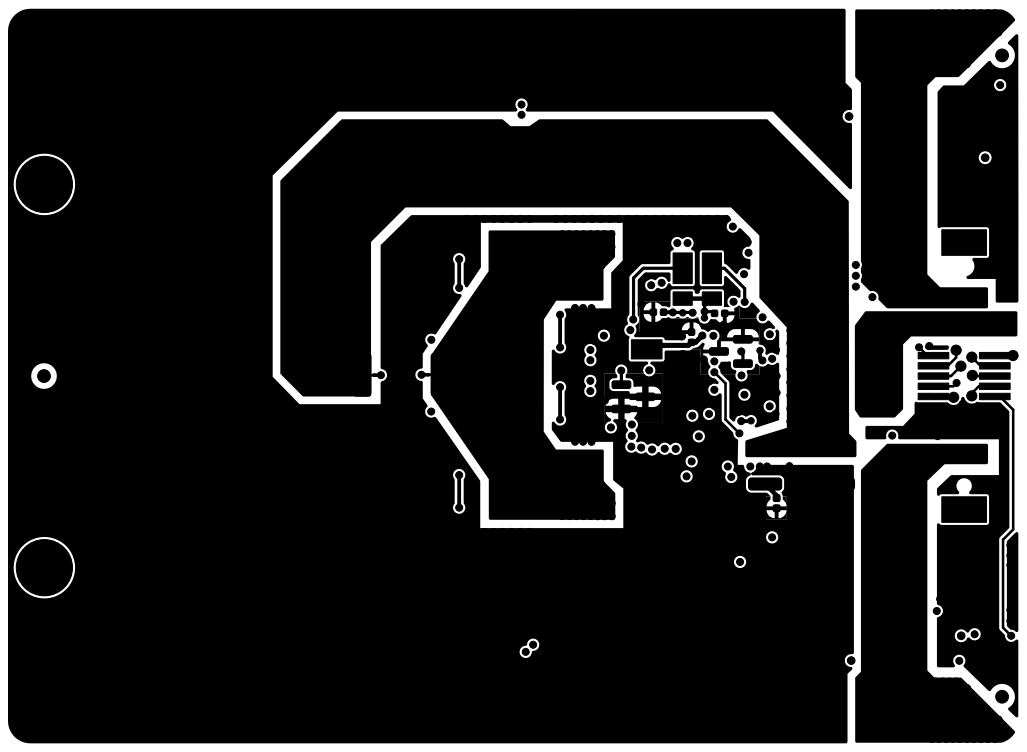
[picture p175: page 1]
