EPFLXplore/Power_HW/GEODE/rev1/Documentation/PDF design files/Layout/Motherboard/smps_legged_robot-Edge_Cuts.pdf

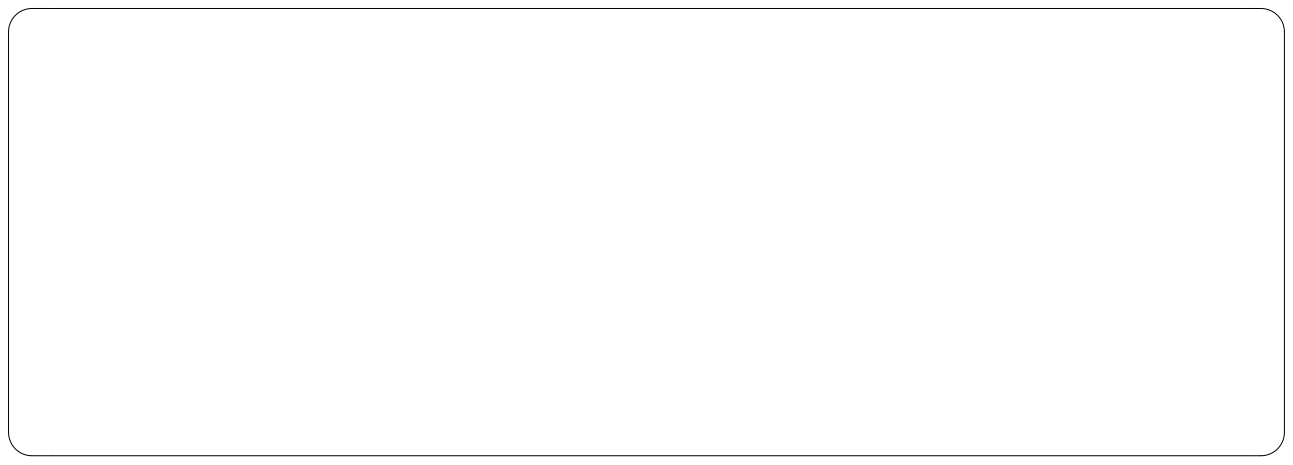
[picture p176: page 1]
