EPFLXplore/Power_HW/GEODE/rev1/Documentation/PDF design files/Layout/Motherboard/smps_legged_robot-L1 (Sig, PWR).pdf

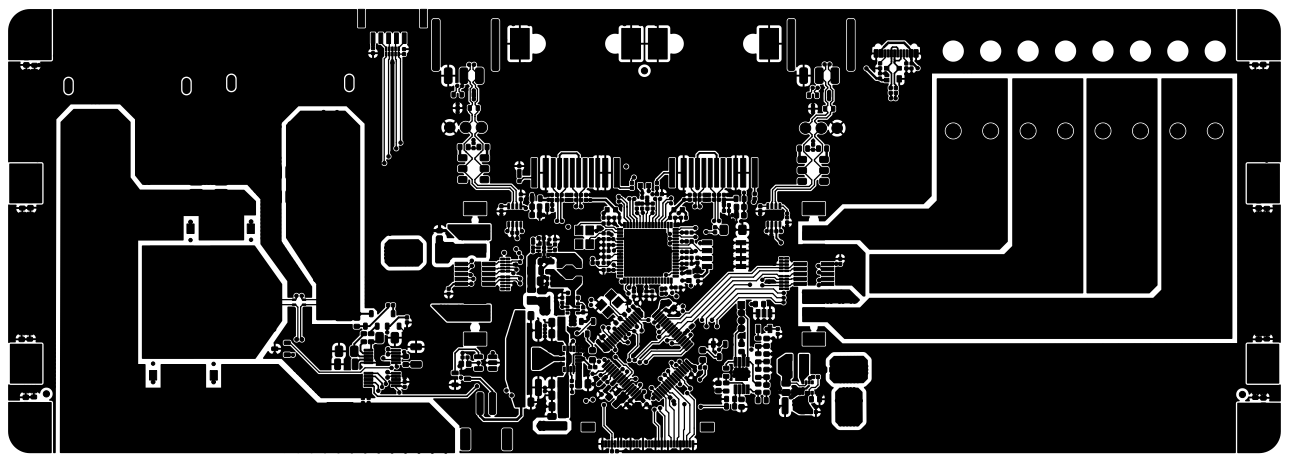
[picture p177: page 1]
