EPFLXplore/Power_HW/GEODE/rev1/Documentation/PDF design files/Layout/Motherboard/smps_legged_robot-L2 (GND).pdf

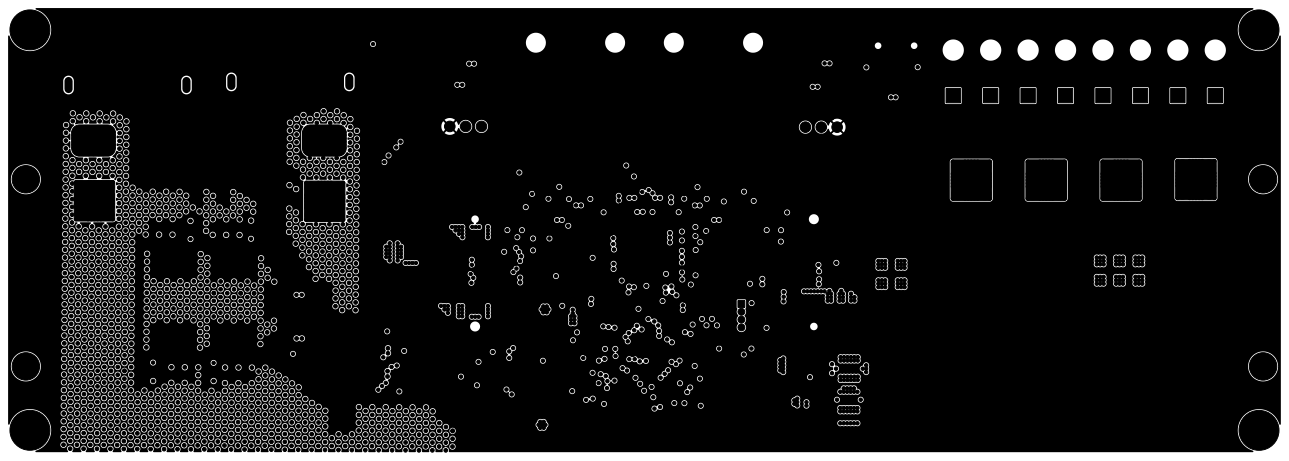
[picture p178: page 1]
