EPFLXplore/Power_HW/GEODE/rev1/Documentation/PDF design files/Layout/Motherboard/smps_legged_robot-L3 (Sig, PWR).pdf

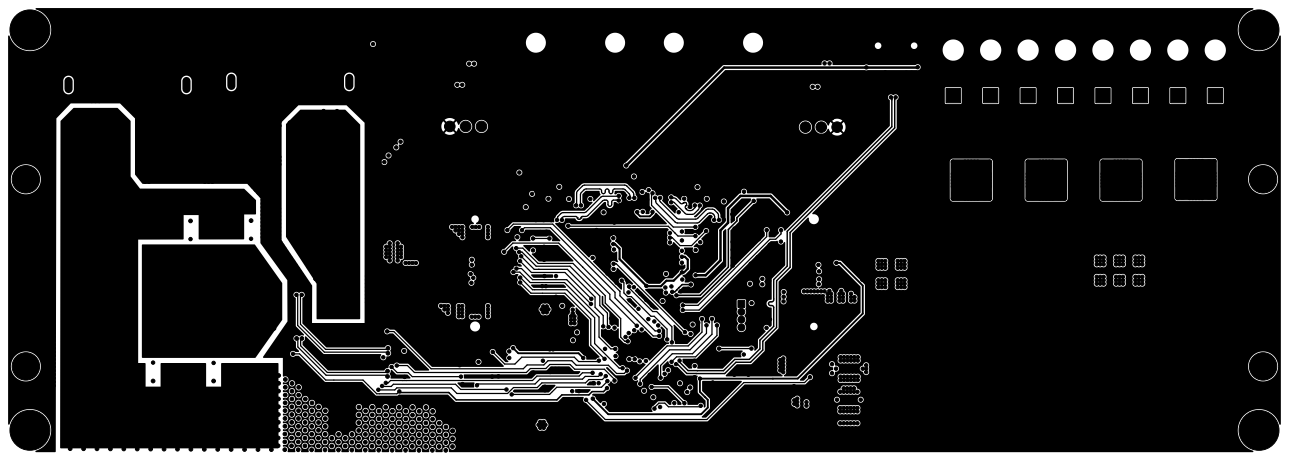
[picture p179: page 1]
