EPFLXplore/Power_HW/GEODE/rev1/Documentation/PDF design files/Layout/Motherboard/smps_legged_robot-L4 (Sig, PWR).pdf

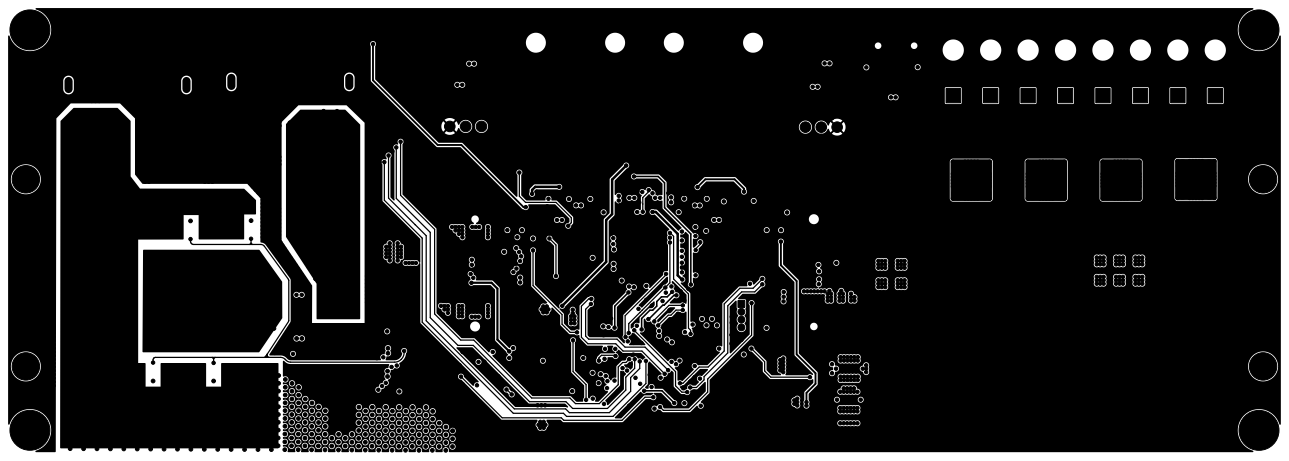
[picture p180: page 1]
