EPFLXplore/Power_HW/GEODE/rev1/Documentation/PDF design files/Layout/Motherboard/smps_legged_robot-L6 (Sig, PWR).pdf

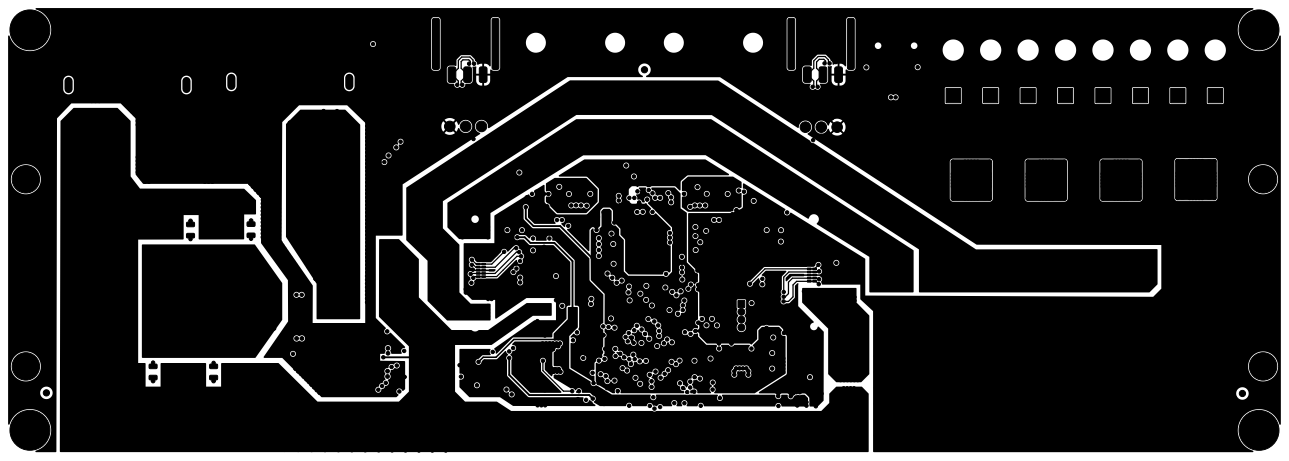
[picture p181: page 1]
