EPFLXplore/Power_HW/(list of files, drawings)

Other design files:
Pollux/Altium/Pollux III/AnalogFrontEnd.SchDoc
Pollux/Altium/Pollux III/Audio.SchDoc
Pollux/Altium/Pollux III/AuxiliaryPowerSupply.SchDoc
Pollux/Altium/Pollux III/CAN.SchDoc
Pollux/Altium/Pollux III/CarrierBoard.PcbLib
Pollux/Altium/Pollux III/Controller.SchDoc
Pollux/Altium/Pollux III/ControlUnit.SchDoc
Pollux/Altium/Pollux III/Display.SchDoc
Pollux/Altium/Pollux III/DIV30.SchDoc
Pollux/Altium/Pollux III/Flash.SchDoc
Pollux/Altium/Pollux III/History/Pollux III.~(23).PcbDoc
Pollux/Altium/Pollux III/IMU.SchDoc
Pollux/Altium/Pollux III/Interconnect.SchDoc
Pollux/Altium/Pollux III/LED.SchDoc
Pollux/Altium/Pollux III/ModuleCarrier.SchDoc
Pollux/Altium/Pollux III/Pollux III.PcbDoc
Pollux/Altium/Pollux III/Pollux III.PcbLib
Pollux/Altium/Pollux III/Pollux III.PrjPcb
Pollux/Altium/Pollux III/Pollux III.SchLib
Pollux/Altium/Pollux III/PowerConnector.SchDoc
Pollux/Altium/Pollux III/ProtectedLDO.SchDoc
Pollux/Altium/Pollux III/TopLevel.SchDoc
Pollux/Kicad/HVPowerModule/Converter.SchDoc
Pollux/Kicad/HVPowerModule/HVPowerModule.PcbDoc
Pollux/Kicad/HVPowerModule/HVPowerModule.PcbLib
Pollux/Kicad/HVPowerModule/HVPowerModule.PrjPcb
Pollux/Kicad/HVPowerModule/HVPowerModule_Old.PcbDoc
Pollux/Kicad/HVPowerModule/HVPowerModule_Old.PcbLib
Pollux/Kicad/HVPowerModule/Module.SchDoc
Pollux/Kicad/LVPowerModule/Converter.SchDoc
Pollux/Kicad/LVPowerModule/DAC.SchDoc
Pollux/Kicad/LVPowerModule/History/DAC.~(1).SchDoc
Pollux/Kicad/LVPowerModule/History/LVPowerModule.~(21).PcbDoc
Pollux/Kicad/LVPowerModule/IdealDiode.SchDoc
Pollux/Kicad/LVPowerModule/LVPowerModule.PcbDoc
Pollux/Kicad/LVPowerModule/LVPowerModule.PcbLib
Pollux/Kicad/LVPowerModule/LVPowerModule.PrjPcb
Pollux/Kicad/LVPowerModule/LVPowerModule.SchLib
Pollux/Kicad/LVPowerModule/Module.SchDoc
