EPFLXplore/Power_HW/TRACO_COTS/5V_Buck_Board.kicad_pcb

## KiCad design TRACO_COTS/5V_Buck_Board.kicad_pcb (2026-09-20)

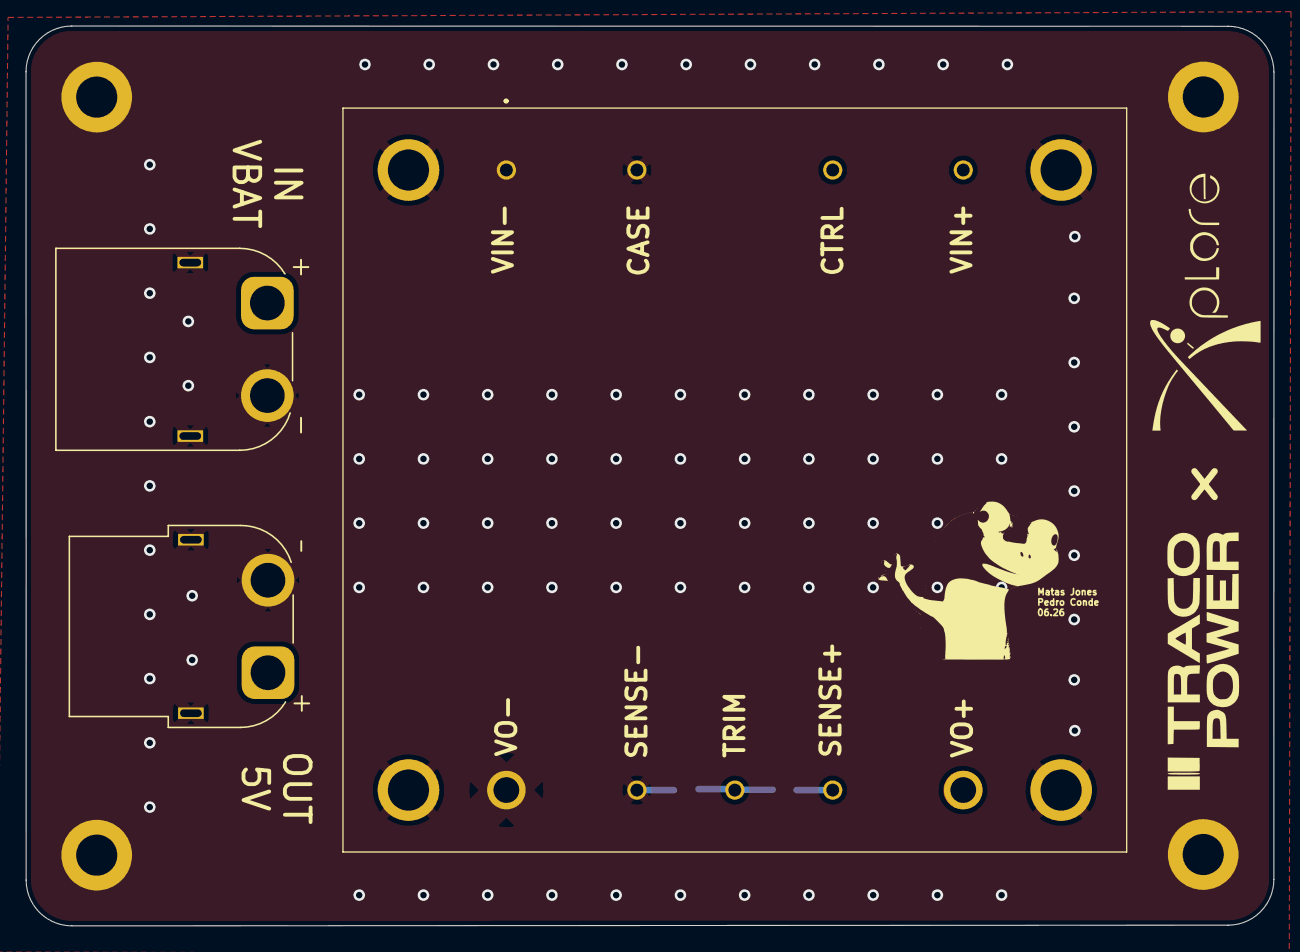
[picture p182: board 5V_Buck_Board.kicad_pcb from above]

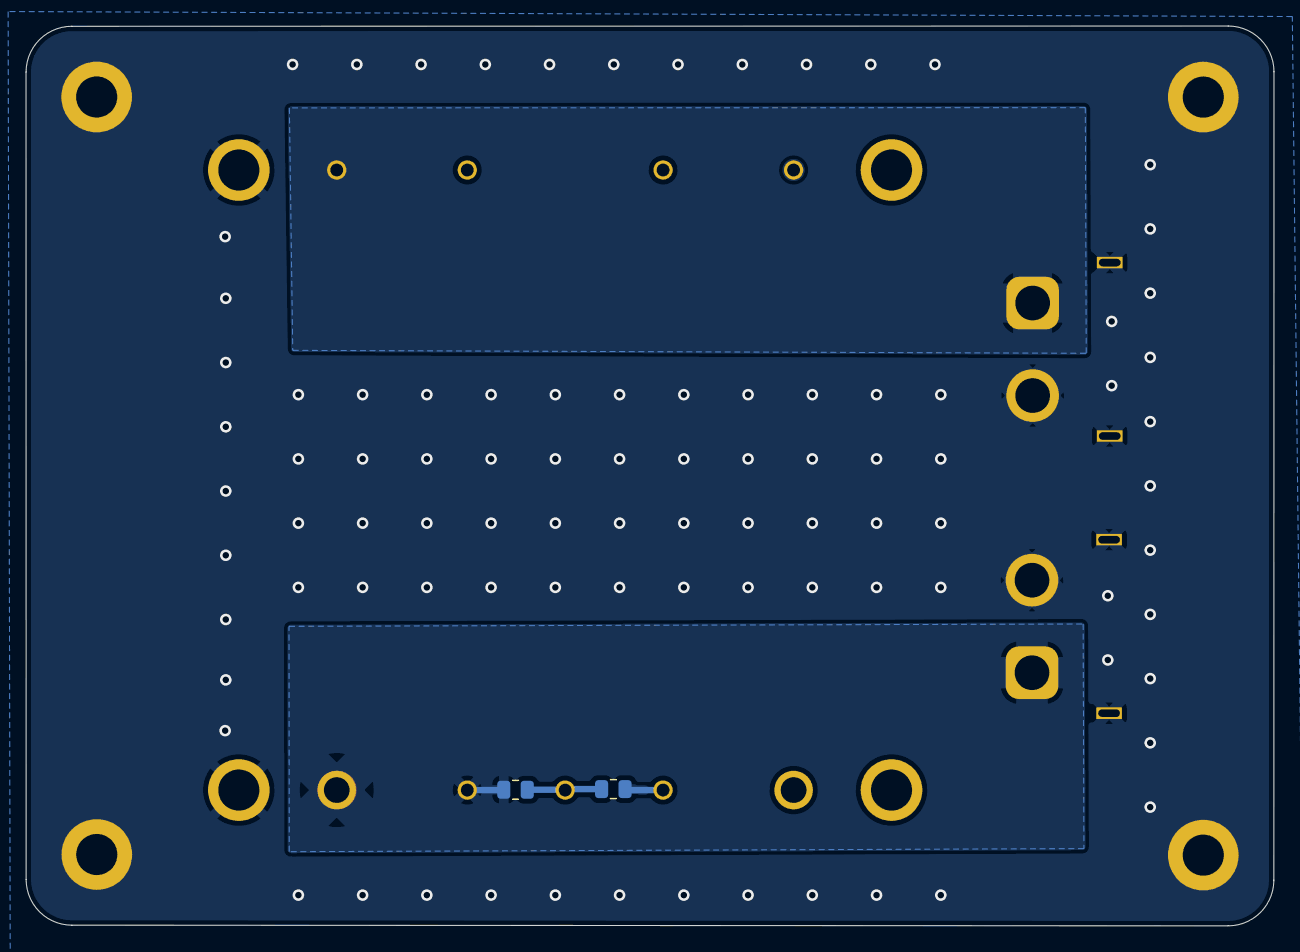
[picture p183: board 5V_Buck_Board.kicad_pcb from below]

Board: 2 copper layers, 97.1 x 70.0 mm, 9 parts (2 on the bottom side), 4 nets.

Parts:
H1, H2, H3, H4: MountingHole_Pad; MountingHole_3.2mm_M3_ISO14580_Pad
J1: XT60PW-M; AMASS_XT60PW-M_1x02_P7.20mm_Horizontal
J2: XT60PW-F; AMASS_XT60PW-F_1x02_P7.20mm_Horizontal
PS1: TEP_100-2411WIR; TEP1002411WIR
R1, R2: NM; R_0805_2012Metric

Connections:
GND: H1.1, H2.1, H3.1, H4.1, J1.2, J1.MH1, J1.MH2, J2.2, J2.MH1, J2.MH2, PS1.1 (-VIN(GND)), PS1.2 (CASE), PS1.5 (-VOUT), PS1.6 (-SENSE), PS1.MH1, PS1.MH2, PS1.MH3, PS1.MH4, R2.2
unnamed: J2.1, PS1.8 (+SENSE), PS1.9 (+VOUT), R1.1
unnamed: J1.1, PS1.4 (+VIN(VCC))
unnamed: PS1.7 (TRIM), R1.2, R2.1
