EPFLXplore/Power_HW/Pollux/Kicad/PolluxIII/PolluxIII.kicad_pcb

## KiCad design Pollux/Kicad/PolluxIII/PolluxIII.kicad_pcb (2026-09-20)

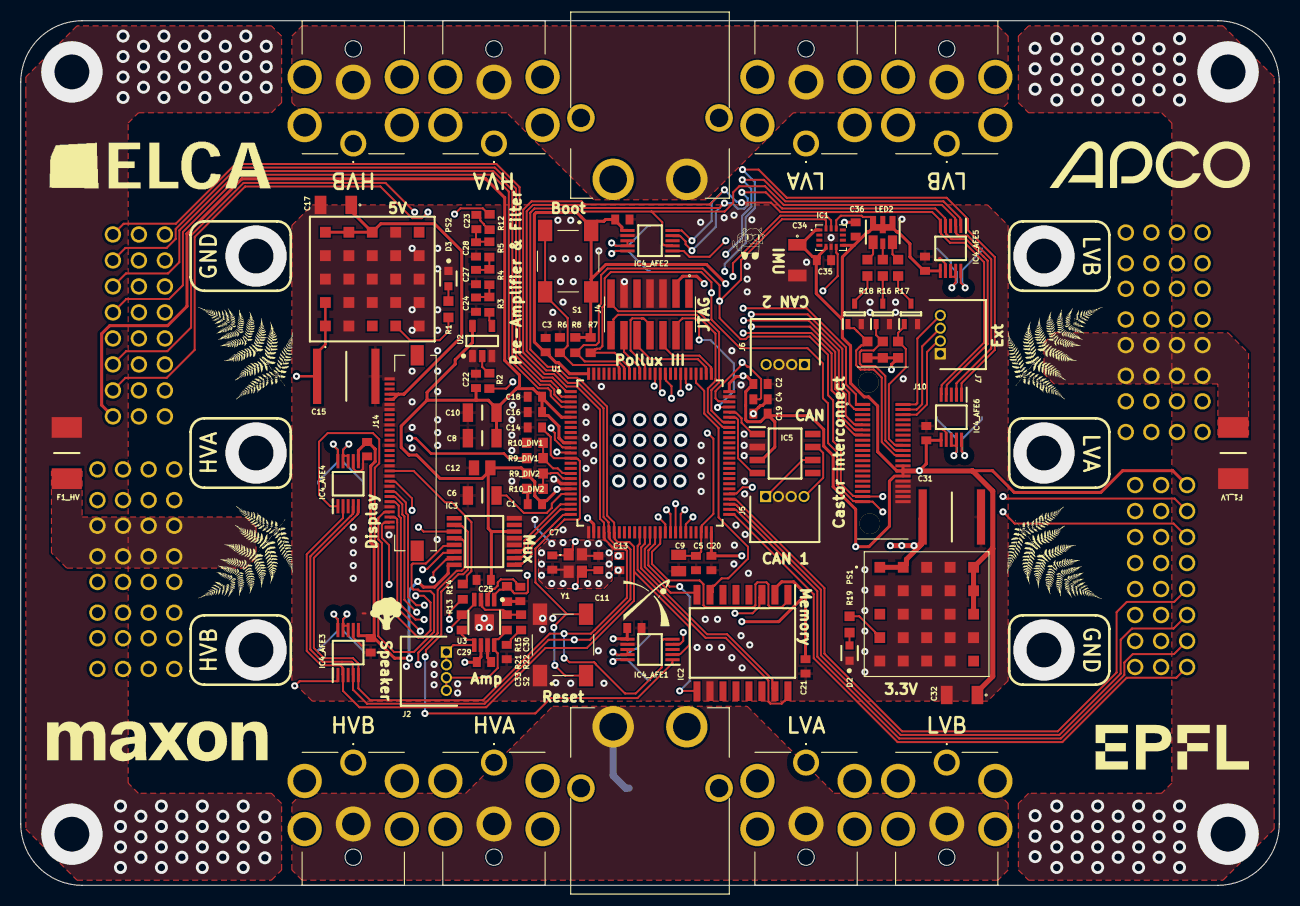
[picture p184: board PolluxIII.kicad_pcb from above]

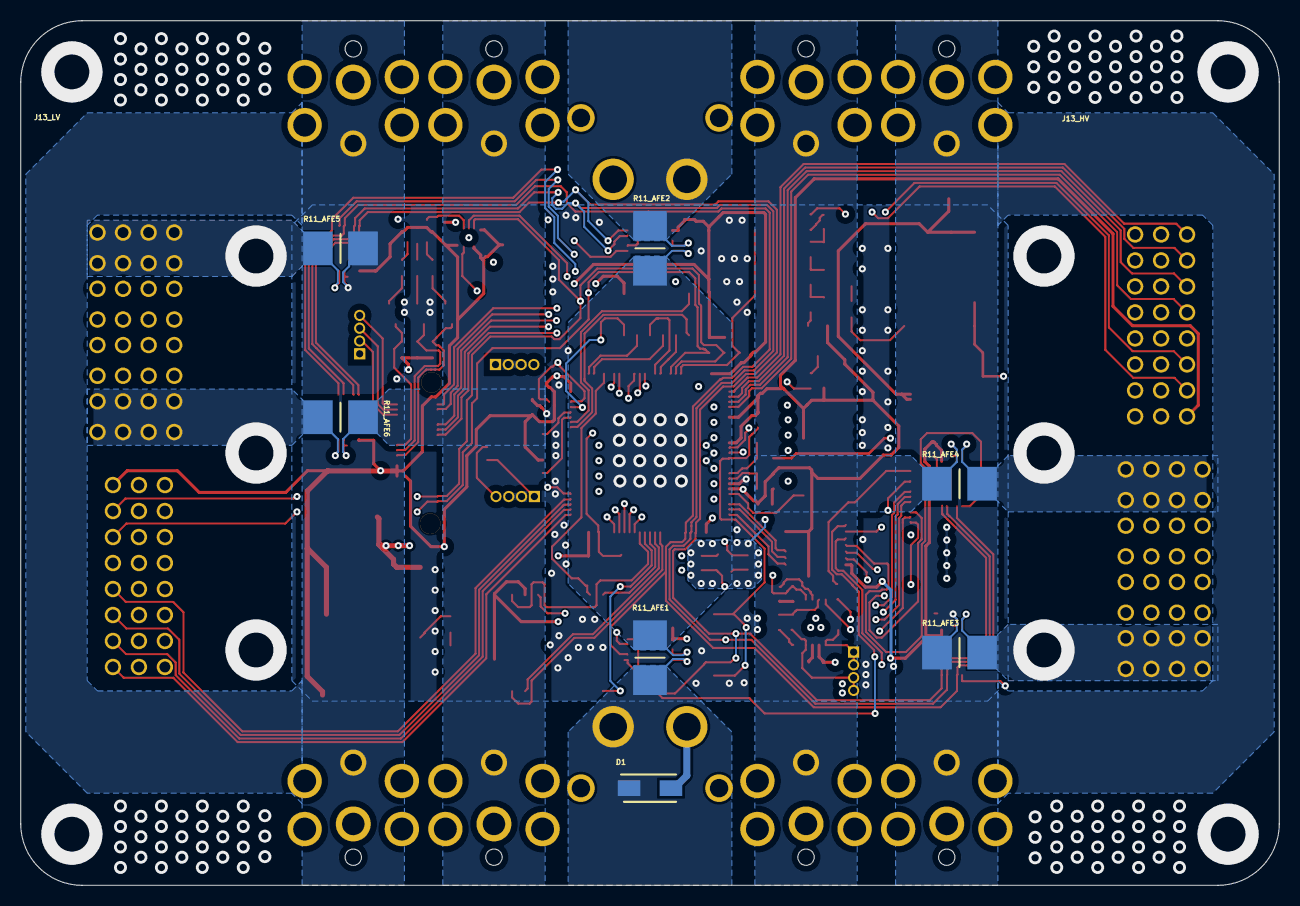
[picture p185: board PolluxIII.kicad_pcb from below]

Board: 4 copper layers, 123.0 x 84.5 mm, 118 parts (9 on the bottom side), 105 nets.

Parts:
C1, C2, C3, C4, C5, C13, C14, C16, C18, C19, C20, C21, C22, C25, C26_AFE1, C26_AFE2, C26_AFE3, C26_AFE4, C26_AFE5, C26_AFE6, C36: C0603C104K5RACTU; CAPC1608X95N
C6, C8, C10: C1206C105M5RECTU; CAPC3216X130N
C7, C11: CBR06C569B5GAC; CAPC1608X87N
C9: C0805C225K4REC7210; CAPC2012X140N
C12: C0805C475M4PACTU; CAPC2012X140N
C15, C31: C5750JB2A475M230KA; CAPC5750X310N
C17, C32: C1206C106K4RACTU; C1206
C23, C33: C0603C474K4PACTU; CAPC1608X95N
C24, C27, C28: C0603C472J5RACTU; CAPC1608X95N
C29: C0603C105K4RACTU; CAPC1608X95N
C30: C0603C224K8RAC7411; CAPC1608X95N
C34: C1206J225J4RACAUTO; C1206
C35: C0603C103K5RACTU; CAPC1608X95N
D1: BZG03C33-HM3-08; DIOM5127X229N
D2, D3: LS L29K-G1J2-1-Z; FP-LS_L29K-MFG
F1_HV, F1_LV: 0451020.MRL; FUSC6127X294N
IC1: ICM-42670-P; ICM42670P
IC2: MT25QL512ABB8ESF-0AAT; SOIC127P1032X265-16N
IC3: CD74HC137PWR; SOP65P640X120-16N
IC4_AFE1, IC4_AFE2, IC4_AFE3, IC4_AFE4, IC4_AFE5, IC4_AFE6: INA239AQDGSRQ1; SOP50P490X110-10N
IC5: SN65HVD232QDR; SOIC127P600X175-8N
J1, J3: XT60PW-M; XT60PWM
J2, J5, J6, J7: 53048-0450; SHDRRA4W35P0X125_1X4_675X550X350P
J4: FTSH-107-01-F-DV; FTSH-107-XX-YYY-DV
J10: ERF5-020-07.0-L-DV-K-TR; ERF5-020-XX.X-Y-DV-K-TR
J12_PWR1A1, J12_PWR1A2, J12_PWR1B1, J12_PWR1B2, J12_PWR2A1, J12_PWR2A2, J12_PWR2B1, J12_PWR2B2: PJ-082BH; PJ082BH
J13_HV, J13_LV: 46562-3001; 465623001
J14: 505110-3091; 5051103091
LED2: KRTBDWLM; KRTBDWLM3232T4U6JWAAABJ3R4S65V
PS1: RPMB3.3-3.0; RPMB5030
PS2: RPMB5.0-2.0; RPMB5020
Q5_LED_ST_B, Q5_LED_ST_G, Q5_LED_ST_R: DMN2004WK-7; SOT65P210X110-3N
R1, R19: CRCW06031K00JNEAC; RESC1608X55N
R2, R14: CRCW060333R0JNEAC; RESC1608X50N
R3, R4, R5: CRCW06031K00FKECC; RESC1608X50N
R6, R7, R8: CRCW06032K00JNEB; RESC1608X50N
R9_DIV1, R9_DIV2: TNPW0603100KBEEA; RESC1608X55N
R10_DIV1, R10_DIV2: TNPW06033K00BEEA; RESC1608X55N
R11_AFE1, R11_AFE2, R11_AFE3, R11_AFE4, R11_AFE5, R11_AFE6: PCS2512FR0010ET; RESC6430X90N
R12, R22: CRCW060310K2FKEA; RESC1608X50N
R13, R21: CRCW060320K0FKEAC; RESC1608X50N
R15: CRCW060347K0FKEAC; RESC1608X50N
R16: CRCW060320R0FKEAC; RESC1608X55N
R17, R18: CRCW060310R0JNEAC; RESC1608X55N
R20_LED_ST_B, R20_LED_ST_G, R20_LED_ST_R: CRCW060349K9FKEAC; RESC1608X55N
S1: BOOT; LL3301FF065QJ
S2: RESET; LL3301FF065QJ
U1: STM32H750VBT6; FP-LQFP100-1L-MFG
U2: SN74LVC1G125DBVR; DBV0005A_M
U3: TPA6205A1DGN; DGN0008D_N
Y1: NX3225SA-30.000M-STD-CSR-3; NX2520SA192MHzEXS00ACS05400

Connections:
3V3: C1.1, C2.1, C3.1, C8.2, C10.2, C12.1, C13.1, C16.1, C18.1, C19.1, C20.1, C21.1, C22.1, C25.1, C26_AFE1.2, C26_AFE2.2, C26_AFE3.2, C26_AFE4.2, C26_AFE5.2, C26_AFE6.2, C29.1, C32.1, C34.1, C35.1, C36.1, IC1.1, IC1.5, IC1.8, IC1.12, IC2.2, IC3.6, IC3.16, IC4_AFE1.6, IC4_AFE2.6, IC4_AFE3.6, IC4_AFE4.6, IC4_AFE5.6, IC4_AFE6.6, IC5.3, J4.3, J10.26, J10.28, J10.30, J13_HV.S17, J13_LV.S17, LED2.1, LED2.2, LED2.3, LED2.7, LED2.8, PS1.A5, PS1.B5, PS1.C5, R7.1, R8.1, R9_DIV2.1, R20_LED_ST_B.1, R20_LED_ST_G.1, R20_LED_ST_R.1, S1.1, S1.2, U1.6, U1.11, U1.20, U1.27, U1.50, U1.75, U1.100, U2.5, U3.6
+5: C17.1, J14.26, J14.27, PS2.A5, PS2.B5, PS2.C5
A1_C: J13_LV.S21, U1.54
A1_S: J13_LV.S23, U1.52
A2_C: J13_HV.S21, U1.4
A2_S: J13_HV.S23, U1.2
APD: J14.12, R14.1
APWM: J14.10, R2.1
B1_C: J13_LV.S22, U1.53
B1_S: J13_LV.S24, U1.51
B2_C: J13_HV.S22, U1.3
B2_S: J13_HV.S24, U1.1
BOOT: R6.2, S1.3, S1.4, U1.94
BYPASS: C30.2, U3.2
CANH: IC5.7, J5.4, J6.4
CANL: IC5.6, J5.1, J6.1
CAN_RX: IC5.4, U1.70
CAN_TX: IC5.1, U1.71
CAP: C4.1, C5.1, C9.2, U1.48, U1.73
CS1: IC3.15, IC4_AFE6.1
CS2: IC3.14, IC4_AFE5.1
CS3: IC3.13, IC4_AFE4.1
CS4: IC3.12, IC4_AFE3.1
CS5: IC3.11, IC4_AFE2.1
CS6: IC3.10, IC4_AFE1.1
DCS: J14.4, U1.41
DINT: J14.3, U1.45
DMISO: J14.7, U1.43
DMOSI: J14.6, U1.44
DRX: J4.13, U1.69
DSCK: J14.8, U1.42
DTX: J4.14, U1.68
FSYNC: IC1.7, U1.55
GND: C1.2, C2.2, C3.2, C4.2, C5.2, C6.1, C7.1, C8.1, C9.1, C10.1, C11.1, C12.2, C13.2, C14.2, C15.2, C16.2, C17.2, C18.2, C19.2, C20.2, C21.2, C22.2, C24.2, C25.2, C26_AFE1.1, C26_AFE2.1, C26_AFE3.1, C26_AFE4.1, C26_AFE5.1, C26_AFE6.1, C27.2, C28.2, C29.2, C30.1, C31.2, C32.2, C33.1, C34.2, C35.2, C36.2, D1.2, D2.1, D3.1, IC1.6, IC2.10, IC3.4, IC3.5, IC3.8, IC4_AFE1.7, IC4_AFE2.7, IC4_AFE3.7, IC4_AFE4.7, IC4_AFE5.7, IC4_AFE6.7, IC5.2, J1.2, J3.2, J4.5, J4.7, J4.11, J5.2, J5.3, J6.2, J6.3, J7.1, J10.32, J10.34, J10.36, J10.38, J10.40, J12_PWR1A1.2, J12_PWR1A2.2, J12_PWR1B1.2, J12_PWR1B2.2, J12_PWR2A1.2, J12_PWR2A2.2, J12_PWR2B1.2, J12_PWR2B2.2, J13_HV.P2, J13_HV.S20, J13_LV.P2, J13_LV.S20, J14.1, J14.5, J14.9, J14.11, J14.13, J14.17, J14.21, J14.24, J14.25, J14.30, PS1.A3, PS1.A4, PS1.B1, PS1.B2, PS1.B3, PS1.B4, PS1.C2, PS1.C3, PS1.C4, PS1.D2, PS1.D3, PS1.D4, PS1.D5, PS1.E1, PS1.E2, PS1.E3, PS1.E4, PS2.A3, PS2.A4, PS2.B1, PS2.B2, PS2.B3, PS2.B4, PS2.C2, PS2.C3, PS2.C4, PS2.D2, PS2.D3, PS2.D4, PS2.D5, PS2.E1, PS2.E2, PS2.E3, PS2.E4, Q5_LED_ST_B.2, Q5_LED_ST_G.2, Q5_LED_ST_R.2, R6.1, R10_DIV1.2, R10_DIV2.2, R15.1, S2.1, S2.2, U1.10, U1.19, U1.26, U1.49, U1.74, U1.99, U2.1, U2.3, U3.7, U3.9, Y1.2, Y1.4
GPIO0: J7.4, J10.2
GPIO1: J7.3, J10.4
GPIO2: J7.2, J10.6
HSE_IN: C7.2, U1.12, Y1.1
HSE_OUT: C11.2, U1.13, Y1.3
HVA: IC4_AFE4.10, J13_HV.P4, R11_AFE4.1
HVB: IC4_AFE3.10, J13_HV.P1, R11_AFE3.1
JTCK: J4.6, U1.76
JTDI: J4.10, U1.77
JTDO: J4.8, U1.89
JTMS: J4.4, U1.72
JTRST: J4.12, U1.90
LVA: IC4_AFE6.10, J13_LV.P4, R11_AFE6.1
LVB: IC4_AFE5.10, J13_LV.P1, R11_AFE5.1
MISO: IC4_AFE1.4, IC4_AFE2.4, IC4_AFE3.4, IC4_AFE4.4, IC4_AFE5.4, IC4_AFE6.4, U1.30
MOSI: IC4_AFE1.2, IC4_AFE2.2, IC4_AFE3.2, IC4_AFE4.2, IC4_AFE5.2, IC4_AFE6.2, U1.31
NRST: C14.1, IC2.3, J14.2, S2.3, S2.4, U1.14
NetC6_2: C6.2, U1.21
NetC23_1: C23.1, R12.1
NetC23_2: C23.2, C28.1, R5.1
NetC24_1: C24.1, R3.1, R4.2
NetC27_1: C27.1, R4.1, R5.2
NetC33_2: C33.2, R22.2
NetD2_2: D2.2, R19.1
NetD3_2: D3.2, R1.1
NetF1_HV_2: F1_HV.2, J13_HV.P3
NetF1_LV_2: F1_LV.2, J13_LV.P3
NetJ2_1: J2.1, J2.2, R13.1, U3.5
NetJ2_3: J2.3, J2.4, R21.1, U3.8
NetJ10_18: J10.18, Q5_LED_ST_G.1, R20_LED_ST_G.2
NetJ10_20: J10.20, Q5_LED_ST_R.1, R20_LED_ST_R.2
NetJ10_22: J10.22, Q5_LED_ST_B.1, R20_LED_ST_B.2
NetLED2_4: LED2.4, R18.2
NetLED2_5: LED2.5, R16.2
NetLED2_6: LED2.6, R17.2
NetPS1_D1: PS1.D1, R19.2
NetPS2_D1: PS2.D1, R1.2
NetQ5_LED_ST_B_3: Q5_LED_ST_B.3, R18.1
NetQ5_LED_ST_G_3: Q5_LED_ST_G.3, R17.1
NetQ5_LED_ST_R_3: Q5_LED_ST_R.3, R16.1
NetR2_2: R2.2, U2.2
NetR3_2: R3.2, U2.4
NetR9_DIV1_2: R9_DIV1.2, R10_DIV1.1, U1.17
NetR9_DIV2_2: R9_DIV2.2, R10_DIV2.1, U1.18
NetR12_2: R12.2, R13.2, U3.4
NetR21_2: R21.2, R22.1, U3.3
OHVA: IC4_AFE4.8, IC4_AFE4.9, J12_PWR2A1.1, J12_PWR2A2.1, R11_AFE4.2
OHVB: IC4_AFE3.8, IC4_AFE3.9, J12_PWR2B1.1, J12_PWR2B2.1, R11_AFE3.2
OLVA: IC4_AFE6.8, IC4_AFE6.9, J12_PWR1A1.1, J12_PWR1A2.1, R11_AFE6.2
OLVB: IC4_AFE5.8, IC4_AFE5.9, J12_PWR1B1.1, J12_PWR1B2.1, R11_AFE5.2
QSPI0: IC2.15, U1.37
QSPI1: IC2.8, U1.38
QSPI2: IC2.9, U1.39
QSPI3: IC2.1, U1.40
QSPICK: IC2.16, U1.36
QSPICS: IC2.7, U1.79
SBUS0: J10.1, U1.86
SBUS1: J10.3, U1.87
SBUS4: J10.9, U1.85
SBUS5: J10.11, U1.81
SBUS6: J10.13, U1.82
SCK: IC4_AFE1.5, IC4_AFE2.5, IC4_AFE3.5, IC4_AFE4.5, IC4_AFE5.5, IC4_AFE6.5, U1.29
SCL: IC1.13, J10.39, J13_HV.S19, J13_LV.S19, R7.2, U1.92
SDA: IC1.14, J10.37, J13_HV.S18, J13_LV.S18, R8.2, U1.93
SPI_A0: IC3.1, U1.25
SPI_A1: IC3.2, U1.24
SPI_A2: IC3.3, U1.23
V_BAT: D1.1, IC4_AFE1.10, J1.1, R11_AFE1.1
V_IN: C15.1, C31.1, F1_HV.1, F1_LV.1, IC4_AFE1.8, IC4_AFE1.9, IC4_AFE2.10, PS1.A1, PS1.A2, PS2.A1, PS2.A2, R9_DIV1.1, R11_AFE1.2, R11_AFE2.1
V_OUT: IC4_AFE2.8, IC4_AFE2.9, J3.1, R11_AFE2.2
nSHDN: R14.2, R15.2, U3.1
