EPFLXplore/Power_HW/Wagos/power_hat_wago/power_hat_wago.kicad_pcb

## KiCad design Wagos/power_hat_wago/power_hat_wago.kicad_pcb (2026-09-20)

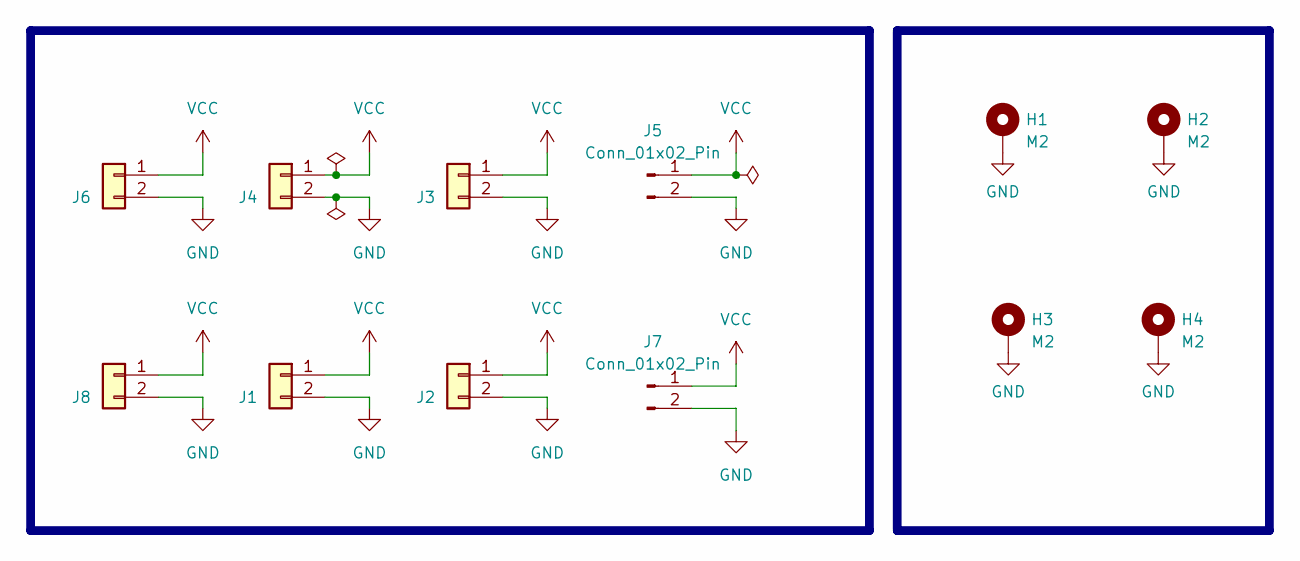
[picture p186: schematic power_hat_wago.kicad_sch, Power Protections V2]

Parts:
H1, H2, H3, H4: M2; MountingHole_3.2mm_M3_Pad_Via
J1, J2, J3, J4, J6, J8: XT30PW-M/Terminal block; AMASS_XT30PW-M_1x02_P2.50mm_Horizontal; Manufacturer_Part_Number XT30PW-M
J5: Conn_01x02_Pin; AMASS_XT60PW-M_1x02_P7.20mm_Horizontal
J7: Conn_01x02_Pin; AMASS_XT60PW-F_1x02_P7.20mm_Horizontal

Connections:
GND: H1.1 (1_1), H2.1 (1_1), H3.1 (1_1), H4.1 (1_1), J1.2, J2.2, J3.2, J4.2, J5.2, J6.2, J7.2, J8.2
VCC: J1.1, J2.1, J3.1, J4.1, J5.1, J6.1, J7.1, J8.1

Board: 4 copper layers, 12 parts (0 on the bottom side), 2 nets, no tracks yet.
