EPFLXplore/Power_HW/Wagos/power_hat_prots_ina/power_hat.kicad_pcb

## KiCad design Wagos/power_hat_prots_ina/power_hat.kicad_pcb (2026-09-20)

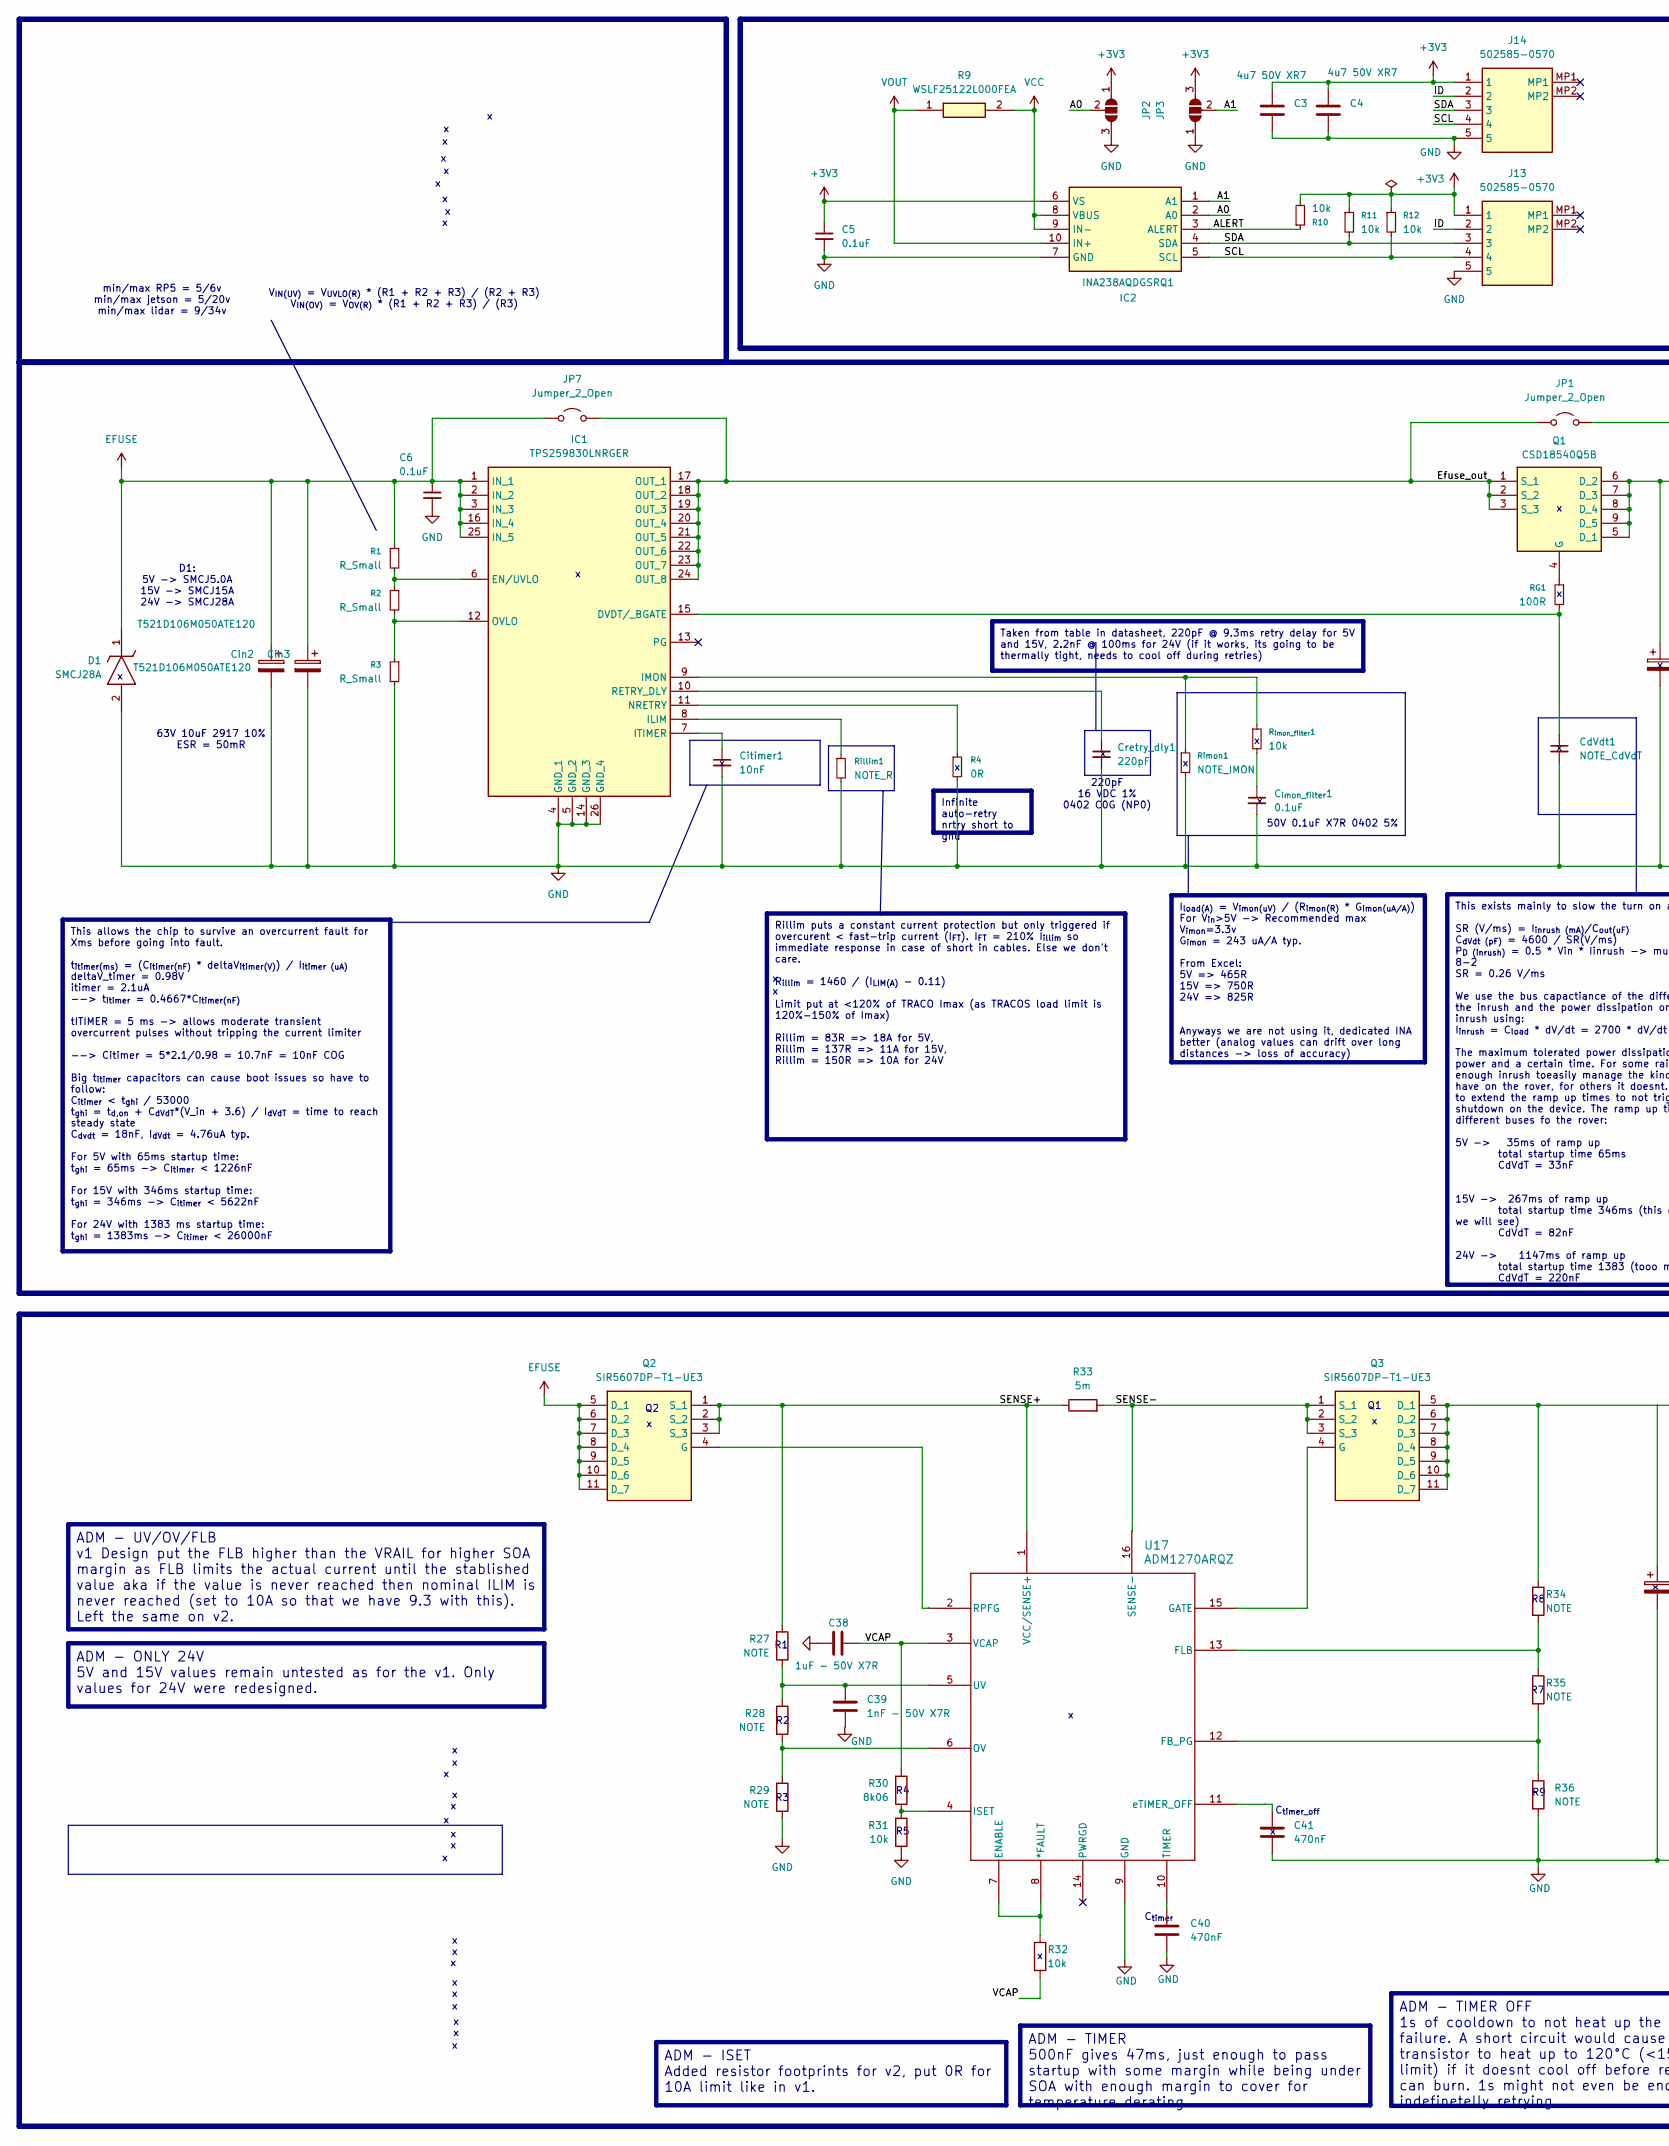
[picture p187: schematic power_hat.kicad_sch, Power Protections V2, part in row 1, column 1]

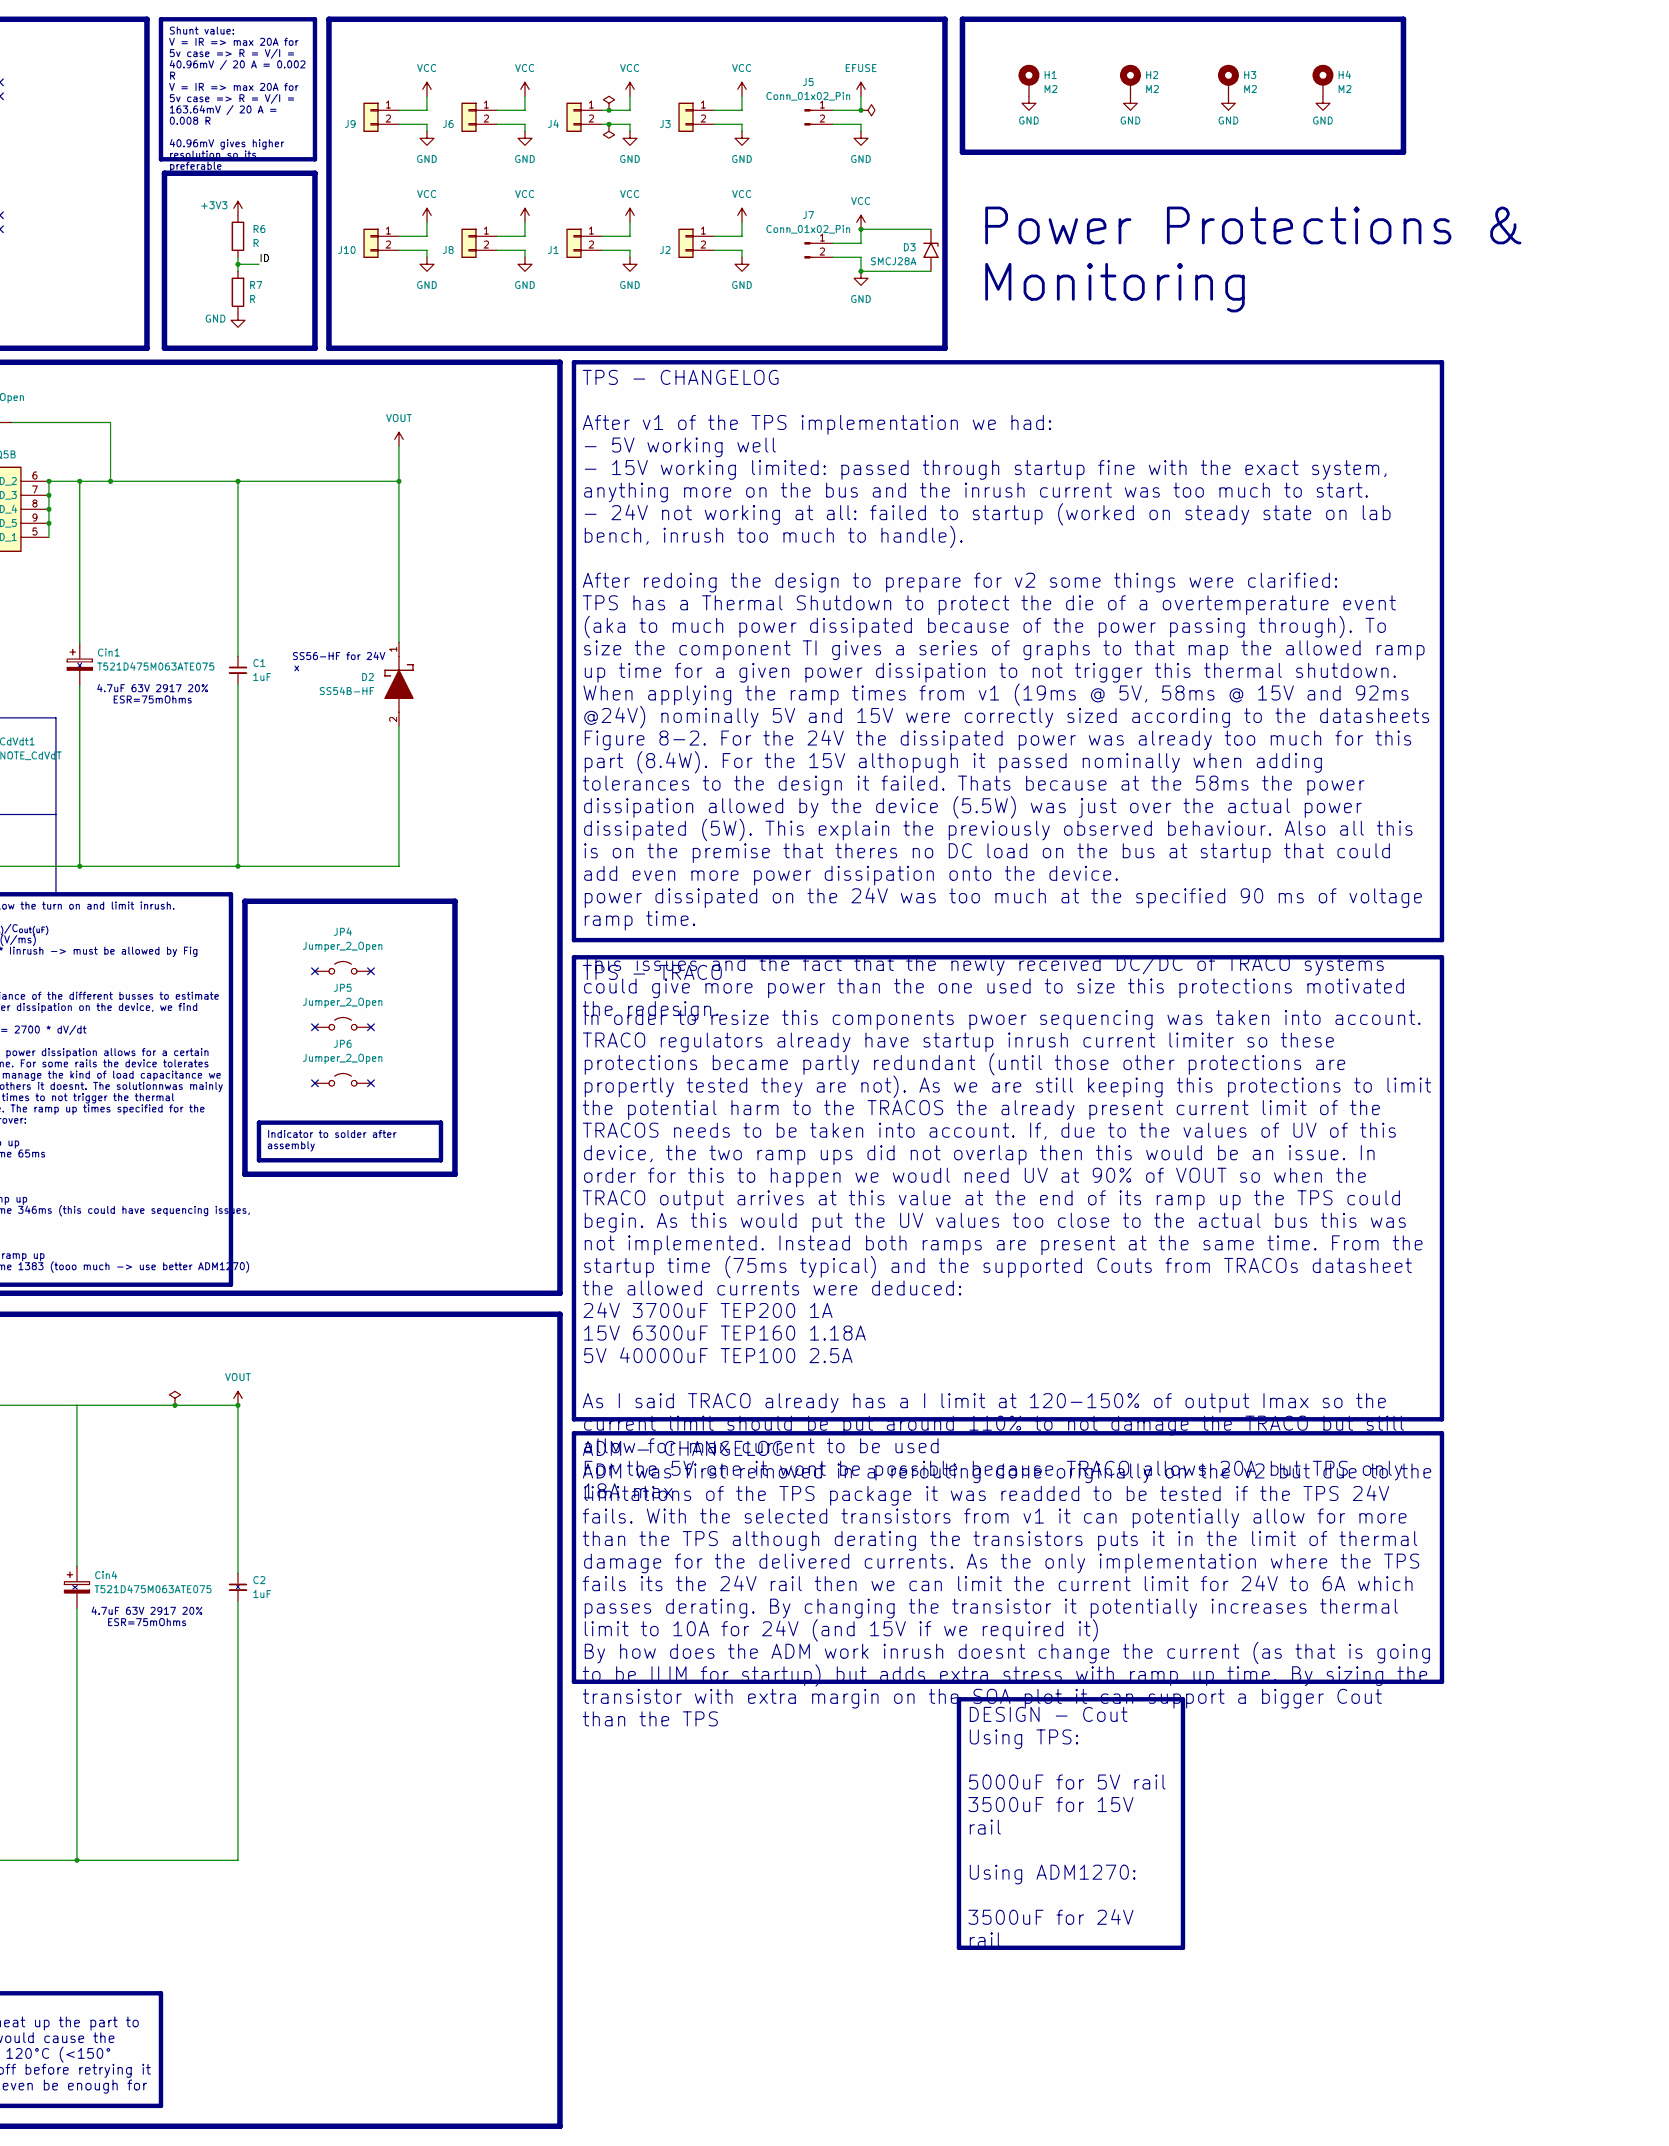
[picture p188: schematic power_hat.kicad_sch, Power Protections V2, part in row 1, column 2]

Parts:
C1, C2: 1uF; C_0805_2012Metric_Pad1.18x1.45mm_HandSolder; Mouser Part Number KAF21KR71H105JU
C3, C4: 4u7 50V XR7; C_0603_1608Metric; Mouser Part Number GRM188Z71A475KE15D
C5, C6: 0.1uF; C_0402_1005Metric_Pad0.74x0.62mm_HandSolder; Mouser Part Number 581-04025C104JAT2A
C38: 1uF - 50V X7R; C_0805_2012Metric; JLCPCB C28323
C39: 1nF - 50V X7R; C_0805_2012Metric; JLCPCB C46653
C40, C41: 470nF; C_0805_2012Metric; JLCPCB C1711
C_{imon_filter}1: 0.1uF; C_0402_1005Metric_Pad0.74x0.62mm_HandSolder; Mouser Part Number 581-04025C104JAT2A
CdVdt1: NOTE_CdVdT; C_1206_3216Metric_Pad1.33x1.80mm_HandSolder
Cin1, Cin4: T521D475M063ATE075; T521D; Mouser Part Number 80-T521D475M63ATE075
Cin2, Cin3: T521D106M050ATE120; T521D; Mouser Part Number 80-T543X106K63AHW50
Citimer1: 10nF; C_0402_1005Metric_Pad0.74x0.62mm_HandSolder; Mouser Part Number 81-GRM1555CYA103GE1J
Cretry_dly1: 220pF; C_0402_1005Metric_Pad0.74x0.62mm_HandSolder
D1: SMCJ28A; SMCJ50A; Mouser Part Number 621-3.0SMCJ28A-13
D2: SS54B-HF; DIOM5235X244N; Mouser Part Number 750-SS54B-HF
D3: SMCJ28A; D_SMA; Mouser Part Number 621-3.0SMCJ28A-13
H1, H2, H3, H4: M2; MountingHole_2.2mm_M2_Pad_Via
IC1: TPS259830LNRGER; Mouser Part Number 595-TPS259830LNRGER
IC2: INA238AQDGSRQ1; SOP50P490X110-10N; Mouser Part Number 595-INA238AQDGSRQ1
J1, J2, J3, J4, J6, J8, J9, J10: XT30PW-M/Terminal block; AMASS_XT30PW-M_1x02_P2.50mm_Horizontal; Manufacturer_Part_Number XT30PW-M
J5: Conn_01x02_Pin; AMASS_XT60PW-M_1x02_P7.20mm_Horizontal
J7: Conn_01x02_Pin; AMASS_XT60PW-F_1x02_P7.20mm_Horizontal
J13, J14: 502585-0570; 5025850570; Mouser Part Number 538-502585-0570
JP1, JP4, JP5, JP6, JP7: Jumper_2_Open; SolderJumper-2_P1.3mm_Open_RoundedPad1.0x1.5mm
JP2, JP3: SolderJumper-3_P1.3mm_Open_RoundedPad1.0x1.5mm
Q1: CSD18540Q5B; Mouser Part Number 595-CSD18540Q5B
Q2, Q3: SIR5607DP-T1-UE3; SIRA14DPT1GE3; Manufacturer_Part_Number SIR5607DP-T1-UE3
R1, R2, R3: R_Small; R_0805_2012Metric_Pad1.20x1.40mm_HandSolder
R4: 0R; R_0402_1005Metric_Pad0.72x0.64mm_HandSolder; Manufacturer_Part_Number 594-MCS0402MZ0000ZE0
R6, R7: R; R_0603_1608Metric
R9: WSLF25122L000FEA; RESC6430X38N; Mouser Part Number 71-WSLF25122L000FEA
R10, R11, R12: 10k; R_0402_1005Metric_Pad0.72x0.64mm_HandSolder; Manufacturer_Part_Number 71-CRCW040210K0FHEDP
R27: NOTE; R_0805_2012Metric; JLCPCB C17598
R28: NOTE; R_0805_2012Metric; JLCPCB C17677
R29: NOTE; R_0805_2012Metric; JLCPCB C17414
R30: 8k06; R_0805_2012Metric; JLCPCB C17598
R31: 10k; R_0805_2012Metric; Manufacturer_Part_Number 71-CRCW040210K0FHEDP; JLCPCB C17598
R32: 10k; R_0805_2012Metric; Manufacturer_Part_Number 71-CRCW040210K0FHEDP; JLCPCB C17631
R33: 5m; R_2512_6332Metric; Mfr_Part_Number WPB2512QLR005FYR; JLCPCB C705607
R34: NOTE; R_0805_2012Metric; JLCPCB C104550
R35: NOTE; R_0805_2012Metric; JLCPCB C104036
R36: NOTE; R_0805_2012Metric; JLCPCB C2828855
RG1: 100R; R_0402_1005Metric; Mouser Part Number 710-560112110022
R_{imon_filter}1: 10k; R_0402_1005Metric_Pad0.72x0.64mm_HandSolder; Manufacturer_Part_Number 71-CRCW040210K0FHEDP
Rillim1: NOTE_R; R_0402_1005Metric_Pad0.72x0.64mm_HandSolder
Rimon1: NOTE_IMON; R_0402_1005Metric_Pad0.72x0.64mm_HandSolder
U17: ADM1270ARQZ; SSOP-16_3.9x4.9mm_P0.635mm; Voltage high voltage; Manufacturer_Part_Number ADM1270ARQZ

Connections:
+3V3: C3.1, C4.1, C5.1, IC2.6 (VS), J13.1, J14.1, JP2.1 (A), JP3.3 (B), R6.1, R10.2, R11.1, R12.1
/A0: IC2.2 (A0), JP2.2 (C)
/A1: IC2.1 (A1), JP3.2 (C)
/ALERT: IC2.3 (ALERT), R10.1
/Efuse_out: IC1.17 (OUT_1), IC1.18 (OUT_2), IC1.19 (OUT_3), IC1.20 (OUT_4), IC1.21 (OUT_5), IC1.22 (OUT_6), IC1.23 (OUT_7), IC1.24 (OUT_8), JP1.1 (A), JP7.2 (B), Q1.1 (S_1), Q1.2 (S_2), Q1.3 (S_3)
/ID: J13.2, J14.2, R6.2, R7.2
/SCL: IC2.5 (SCL), J13.4, J14.4, R12.2
/SDA: IC2.4 (SDA), J13.3, J14.3, R11.2
/SENSE+: Q2.1 (S_1), Q2.2 (S_2), Q2.3 (S_3), R27.2, R33.1, U17.1 (VCC/SENSE+)
/SENSE-: Q3.1 (S_1), Q3.2 (S_2), Q3.3 (S_3), R33.2, U17.16 (SENSE-)
/VCAP: C38.1, R30.2, R32.2, U17.3 (VCAP)
EFUSE: C6.1, Cin2.1, Cin3.1, D1.1 (K), IC1.1 (IN_1), IC1.2 (IN_2), IC1.3 (IN_3), IC1.16 (IN_4), IC1.25 (IN_5), J5.1, JP7.1 (A), Q2.5 (D_1), Q2.6 (D_2), Q2.7 (D_3), Q2.8 (D_4), Q2.9 (D_5), Q2.10 (D_6), Q2.11 (D_7), R1.1
GND: C1.2, C2.2, C3.2, C4.2, C5.2, C6.2, C38.2, C39.2, C40.2, C41.2, C_{imon_filter}1.2, CdVdt1.2, Cin1.2, Cin2.2, Cin3.2, Cin4.2, Citimer1.2, Cretry_dly1.2, D1.2 (A), D2.2 (A), D3.2 (A2), H1.1 (1_1), H2.1 (1_1), H3.1 (1_1), H4.1 (1_1), IC1.4 (GND_1), IC1.5 (GND_2), IC1.14 (GND_3), IC1.26 (GND_4), IC2.7 (GND), J1.2, J2.2, J3.2, J4.2, J5.2, J6.2, J7.2, J8.2, J9.2, J10.2, J13.5, J14.5, JP2.3 (B), JP3.1 (A), R3.2, R4.2, R7.1, R29.1, R31.1, R36.2, Rillim1.2, Rimon1.2, U17.9 (GND)
unnamed: C_{imon_filter}1.1, R_{imon_filter}1.2
unnamed: CdVdt1.1, IC1.15 (DVDT/_BGATE), RG1.2
unnamed: IC1.6 (EN/UVLO), R1.2, R2.1
unnamed: IC1.8 (ILIM), Rillim1.1
unnamed: IC1.9 (IMON), R_{imon_filter}1.1, Rimon1.1
unnamed: Citimer1.1, IC1.7 (ITIMER)
unnamed: IC1.11 (NRETRY), R4.1
unnamed: IC1.12 (OVLO), R2.2, R3.1
unnamed: Cretry_dly1.1, IC1.10 (RETRY_DLY)
unnamed: Q1.4 (G), RG1.1
unnamed: Q2.4 (G), U17.2 (RPFG)
unnamed: Q3.4 (G), U17.15 (GATE)
unnamed: R32.1, U17.7 (ENABLE), U17.8 (*FAULT)
unnamed: R35.2, R36.1, U17.12 (FB_PG)
unnamed: R34.2, R35.1, U17.13 (FLB)
unnamed: R30.1, R31.2, U17.4 (ISET)
unnamed: R28.2, R29.2, U17.6 (OV)
unnamed: C40.1, U17.10 (TIMER)
unnamed: C39.1, R27.1, R28.1, U17.5 (UV)
unnamed: C41.1, U17.11 (eTIMER_OFF)
VCC: D3.1 (A1), IC2.8 (VBUS), IC2.9 (IN-), J1.1, J2.1, J3.1, J4.1, J6.1, J7.1, J8.1, J9.1, J10.1, R9.2
VOUT: C1.1, C2.1, Cin1.1, Cin4.1, D2.1 (K), IC2.10 (IN+), JP1.2 (B), Q1.5 (D_1), Q1.6 (D_2), Q1.7 (D_3), Q1.8 (D_4), Q1.9 (D_5), Q3.5 (D_1), Q3.6 (D_2), Q3.7 (D_3), Q3.8 (D_4), Q3.9 (D_5), Q3.10 (D_6), Q3.11 (D_7), R9.1, R34.1

Notes on the sheet:
C_{timer_off}
220pF 16 VDC 1% 0402 C0G (NP0)
D1: 5V -> SMCJ5.0A 15V -> SMCJ15A 24V -> SMCJ28A
4.7uF 63V 2917 20% ESR=75mOhms
C_{timer}
63V 10uF 2917 10% ESR = 50mR
V_{IN(UV)} = V_{UVLO(R)} * (R1 + R2 + R3) / (R2 + R3) V_{IN(OV)} = V_{OV(R)} * (R1 + R2 + R3) / (R3)
min/max RP5 = 5/6v min/max jetson = 5/20v min/max lidar = 9/34v
50V 0.1uF X7R 0402 5%
SS56-HF for 24V
ADM - TIMER OFF 1s of cooldown to not heat up the part to failure. A short circuit would cause the transistor to heat up to 120°C (<150° limit) if it doesnt cool off before retrying it can burn. 1s might not even be enough for indefinetelly retrying
This exists mainly to slow the turn on and limit inrush. SR (V/ms) = I_{inrush (mA)}/C_{out(uF)} C_{dVdt (pF)} = 4600 / SR(V/ms) P_{D (inrush)} = 0.5 * Vin * Iinrush -> must be allowed by Fig 8-2 SR = 0.26 V/ms We use the bus capactiance of the different busses to estimate the inrush and the power 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
DESIGN - Cout Using TPS: 5000uF for 5V rail 3500uF for 15V rail Using ADM1270: 3500uF for 24V rail
ADM - CHANGELOG ADM was first removed in a rerouting done originally on the v2 but due to the limitations of the TPS package it was readded to be tested if the TPS 24V fails. With the selected transistors from v1 it can potentially allow for more than the TPS although derating the transistors puts 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
TPS - TRACO In order to resize this components pwoer sequencing was taken into account. TRACO regulators already have startup inrush current limiter so these protections became partly redundant (until those other protections are propertly tested they are not). As we are still keeping this protectio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
Taken from table in datasheet, 220pF @ 9.3ms retry delay for 5V and 15V, 2.2nF @ 100ms for 24V (if it works, its going to be thermally tight, needs to cool off during retries)
Shunt value: V = IR => max 20A for 5v case => R = V/I = 40.96mV / 20 A = 0.002 R V = IR => max 20A for 5v case => R = V/I = 163.64mV / 20 A = 0.008 R 40.96mV gives higher resolution so its preferable
ADM - UV/OV/FLB v1 Design put the FLB higher than the VRAIL for higher SOA margin as FLB limits the actual current until the stablished value aka if the value is never reached then nominal ILIM is never reached (set to 10A so that we have 9.3 with this). Left the same on v2.
ADM - ONLY 24V 5V and 15V values remain untested as for the v1. Only values for 24V were redesigned.
I_{load(A)} = V_{imon(uV)} / (R_{imon(R)} * G_{imon(uA/A)}) For V_{in}>5V -> Recommended max V_{imon}=3.3v G_{imon} = 243 uA/A typ. From Excel: 5V => 465R 15V => 750R 24V => 825R Anyways we are not using it, dedicated INA better (analog values can drift over long distances -> loss of accuracy)
Power Protections & Monitoring
TPS - CHANGELOG After v1 of the TPS implementation we had: - 5V working well - 15V working limited: passed through startup fine with the exact system, anything more on the bus and the inrush current was too much to start. - 24V not working at all: failed to startup (worked on steady state on lab be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
Indicator to solder after assembly
Rillim puts a constant current protection but only triggered if overcurent < fast-trip current (I_{FT}). I_{FT} = 210% I_{illim} so immediate response in case of short in cables. Else we don't care. R_{illim} = 1460 / (I_{LIM(A)} - 0.11) Limit put at <120% of TRACO Imax (as TRACOS load limit is 120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
Infinite auto-retry nrtry short to gnd
ADM - ISET Added resistor footprints for v2, put 0R for 10A limit like in v1.
This allows the chip to survive an overcurrent fault for Xms before going into fault. t_{itimer(ms)} = (C_{itimer(nF)} * deltaV_{itimer(V)}) / I_{itimer (uA)} deltaV_timer = 0.98V itimer = 2.1uA --> t_{itimer} = 0.4667*C_{itimer(nF)} tITIMER = 5 ms -> allows moderate transient overcurrent pulses wi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
ADM - TIMER 500nF gives 47ms, just enough to pass startup with some margin while being under SOA with enough margin to cover for temperature derating
