EPFLXplore/Power_HW/Wagos/power_hat_prots_ina/power_hat.kicad_pcb

## KiCad design Wagos/power_hat_prots_ina/power_hat.kicad_pcb (continued)

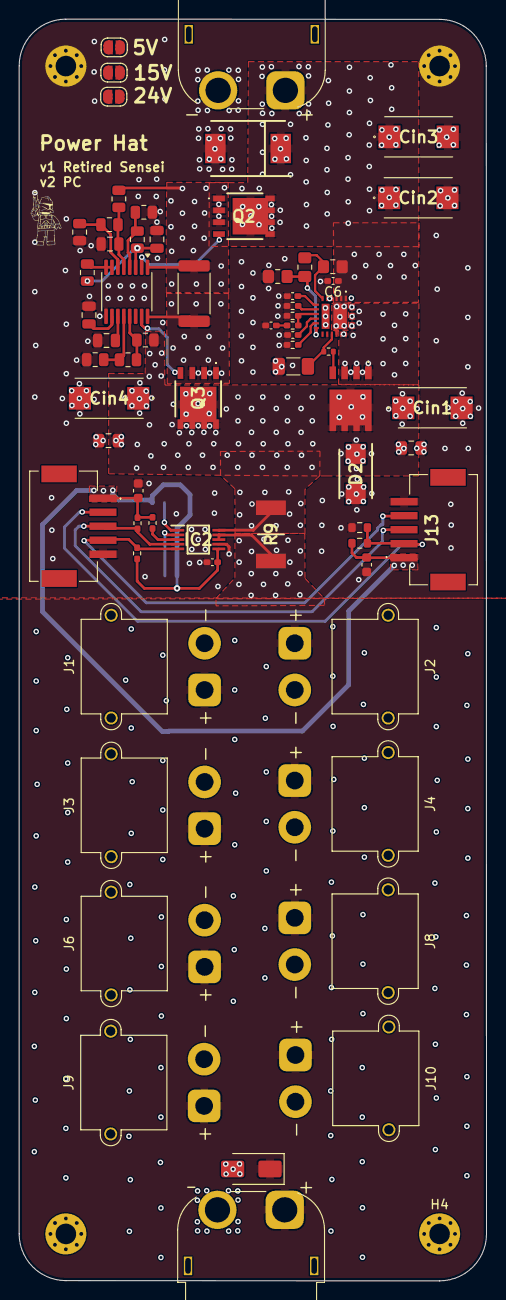
[picture p189: board power_hat.kicad_pcb from above]

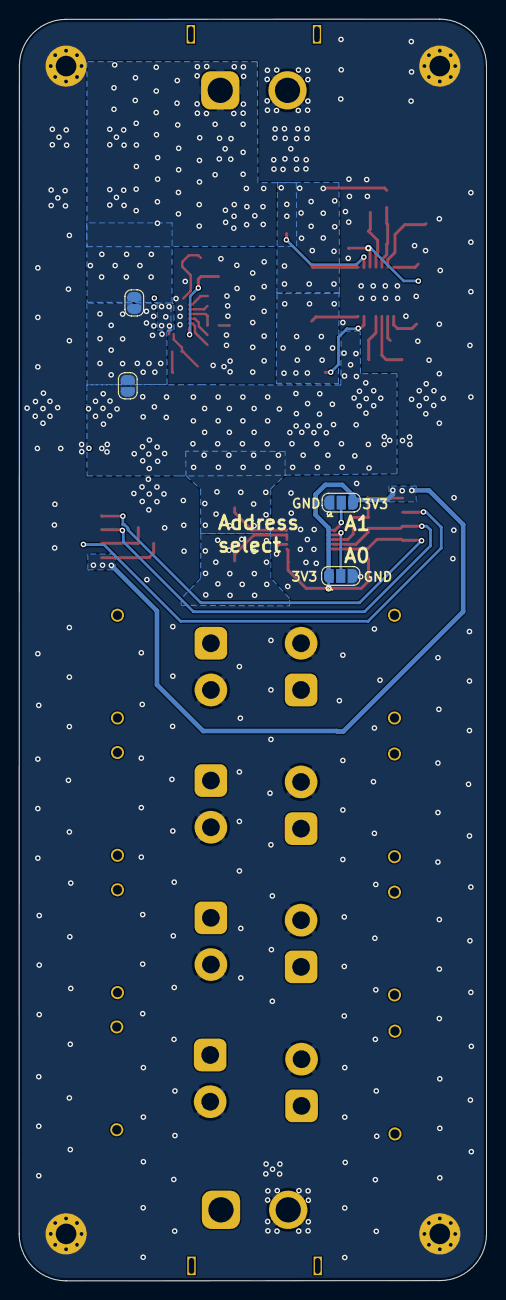
[picture p190: board power_hat.kicad_pcb from below]

Board: 4 copper layers, 50.0 x 135.0 mm, 74 parts (4 on the bottom side), 35 nets.
