EPFLXplore/Power_HW/GEODE/rev1/Documentation/KiCAD design files/SMPS_legged_robot_module/SMPS_legged_robot_module.kicad_pcb

## KiCad design GEODE/rev1/Documentation/KiCAD design files/SMPS_legged_robot_module/SMPS_legged_robot_module.kicad_pcb (2025-02-26, an earlier design)

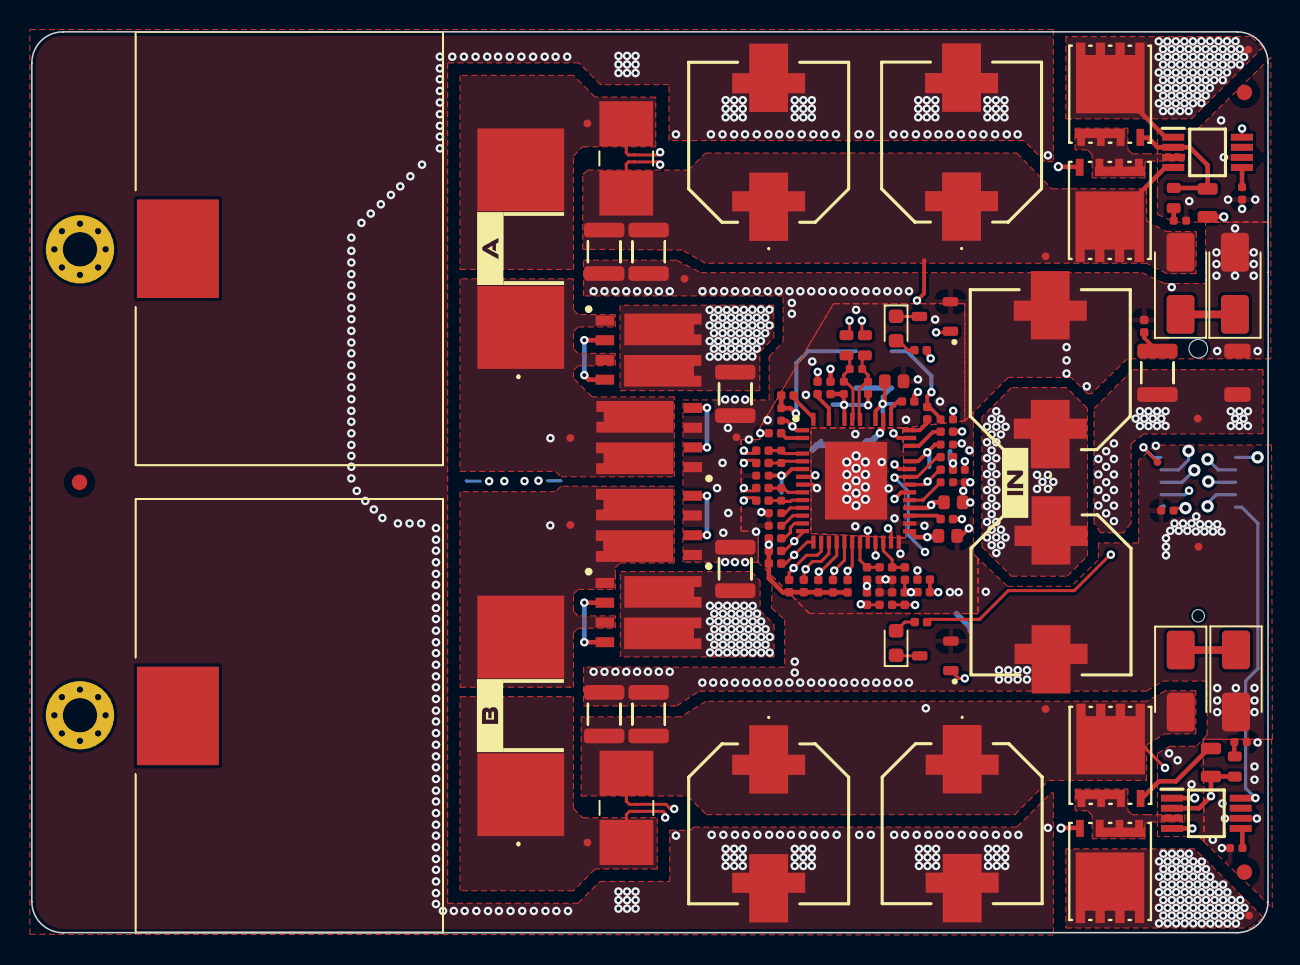
[picture p191: board SMPS_legged_robot_module.kicad_pcb from above]

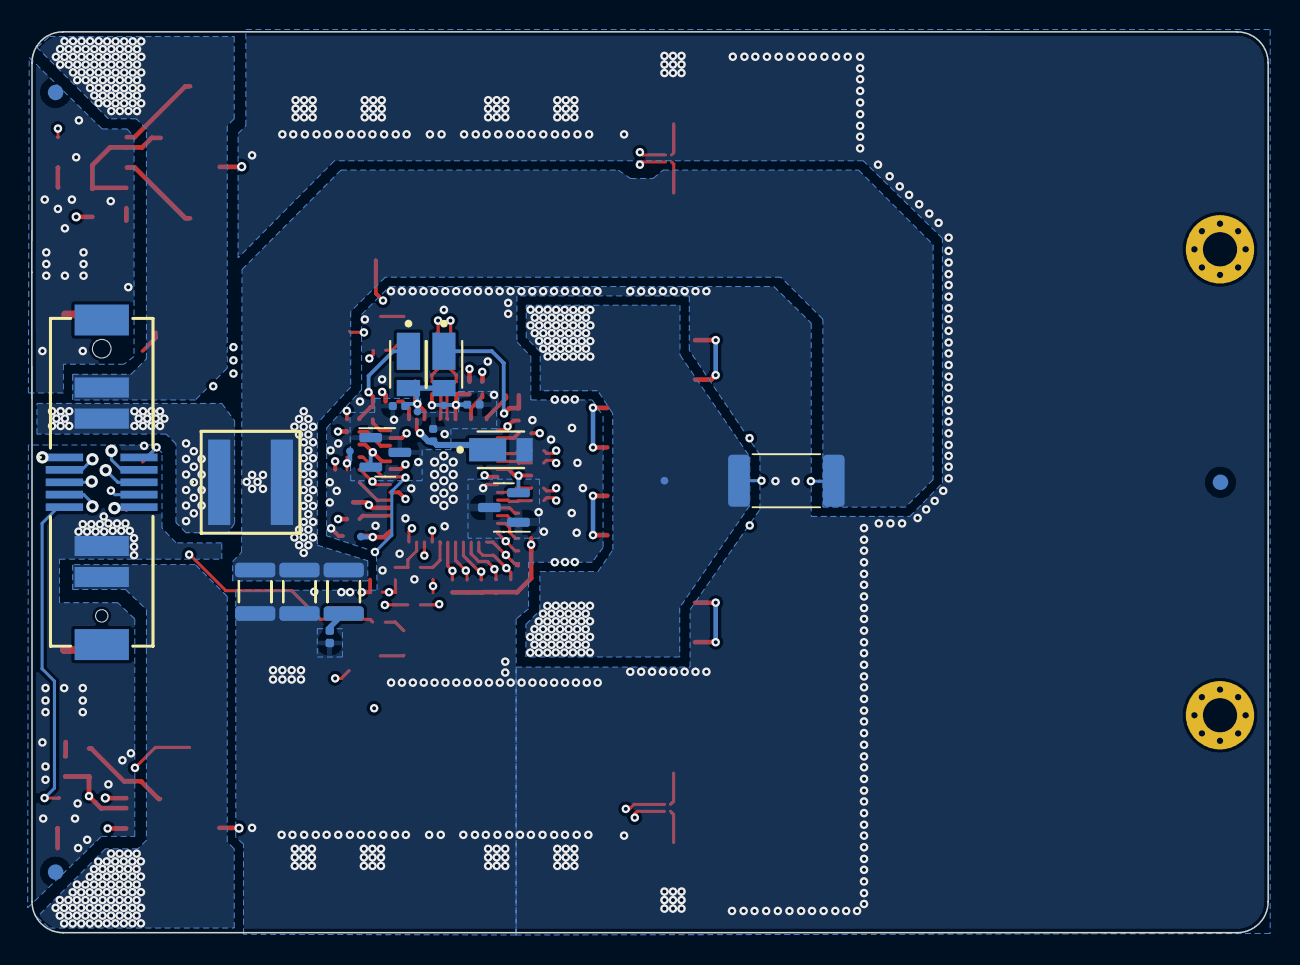
[picture p192: board SMPS_legged_robot_module.kicad_pcb from below]

Board: 6 copper layers, 79.6 x 58.0 mm, 156 parts (25 on the bottom side), 83 nets.

Parts:
C401, C601, C603, C702, C715: 100n X7R 50V; C_0402_1005_DensityHigh
C602, C604, C708, C713, C718, C722, C723: 10n X7R 100V; C_0402_1005_DensityHigh
C607: 1u X7R 25V; C_0603_1608_DensityHigh
C701, C706, C707, C714, C731, C732, C901, C903, C906, C907: 10uF X7R 100V; C_1210_3225_DensityHigh
C703, C720, C725: 1n X7R 100V; C_0402_1005_DensityHigh
C704, C705, C729, C730: 120u CAN 50V; Hybrid_G_VP
C709, C712: 33p X7R 25V; C_0402_1005_DensityHigh
C710, C711: 6.8n X7R 25V; C_0402_1005_DensityHigh
C716, C726: 2.2u X7R 25V; C_0603_1608_DensityHigh
C717, C724: 4.7u X5R 25V; C_0402_1005_DensityHigh
C902: 4u7 X7R 100V; C_1206_3216_DensityHigh
C904, C905: 56u CAN 63V; Hybrid_G_VP
D601, D602, D703: DFLS1100-7; Diodes_Inc.-PowerDI123-03_2017-0-MFG
D603, D605: SMAJ28A; D_SMA
D604, D606: SMAJ33A; D_SMA
D701, D702: GREEN; LED_0603_1608Metric
FM701, FM702, FM703, FM704, FM705, FM706: Fiducial; Fiducial_1mm_Mask2mm
H801, H802: M2 (2.2mm); MountingHole_2.2mm_M2_Pad_Via
IC601, IC602: LTC4372CMS8#TRPBF; SOP65P490X110-8N
IC701: LTC3889EUKG#PBF; QFN50P700X800X80-53N-D
J401: 10159559-410221RLF; 10159559410221RLF
L701, L702: 4,7uH; PQ2617BHA4R7K
L901: 1u XEL6060-102MEB; XEL6060102MEC
NT601, NT602, NT603, NT604, NT605, NT606: NetTie_2; NetTie-2_SMD_Pad0.2mm
Q601, Q602, Q603, Q604: BSC016N06NSATMA1; PG-TDSON-8_INF
Q701, Q702, Q705, Q706: IPG20N06S4L26AATMA1; Infineon-IPG20N06S4L-26A-Manufacturer_Recommended
Q703, Q704: PMBT3906,215; SOT-23
Q707, Q708: NX3020NAK,215; SOT-23-3
R601, R603: 10R 1% 1/8W; R_0805_2012_DensityHigh
R602, R604, R727, R728: 1k 1% 1/10W; R_0603_1608_DensityHigh
R701: 5k 1% 1/16W; R_0402_1005_DensityHigh
R702, R703, R704, R705, R706, R707, R708, R709, R710, R711: 10k 1% 1/16W; R_0402_1005_DensityHigh
R712, R713, R714, R715, R716, R718, R719, R720, R721, R722: R; R_0402_1005_DensityHigh
R717, R729: 3m 1% 3W; RESC6432X135N
R723, R724, R730, R731, R901, R902: 10R 1% 1/8W; R_0402_1005_DensityHigh
R725: 2m 1% 3W; R_2512_6332Metric_Pad1.40x3.35mm_HandSolder
R726, R732, R733, R734, R735, R738, R739: 2R 1% 1/8W; R_0402_1005_DensityHigh
R736, R737: 470R 1% 1/8W; R_0402_1005_DensityHigh
TP401: FAULT0; TestPoint_Pad_D0.5mm_Front
TP402: FAULT1; TestPoint_Pad_D0.5mm_Front
TP403: SDA; TestPoint_Pad_D0.5mm_Front
TP404: SCL; TestPoint_Pad_D0.5mm_Front
TP405: RUN0; TestPoint_Pad_D0.5mm_Front
TP406: RUN1; TestPoint_Pad_D0.5mm_Front
TP407: ALERT; TestPoint_Pad_D0.5mm_Front
TP408: +VBAT_IN; TestPoint_Pad_D0.5mm_Front
TP409: +12V; TestPoint_Pad_D0.5mm_Front
TP410, TP413, TP414: GND; TestPoint_Pad_D0.5mm_Front
TP411: MVA; TestPoint_Pad_D0.5mm_Front
TP412: MVB; TestPoint_Pad_D0.5mm_Front
TP701: VIN; TestPoint_Pad_D0.5mm_Front
TP702: SW0; TestPoint_Pad_D0.5mm_Front
TP703: SW1; TestPoint_Pad_D0.5mm_Front
TP704: 2V5LTC; TestPoint_Pad_D0.5mm_Back
TP705: 3V3LTC; TestPoint_Pad_D0.5mm_Back
TP706: DRVCC; TestPoint_Pad_D0.5mm_Back
TP707: MVB_OUT; TestPoint_Pad_D0.5mm_Front
TP708: MVA_OUT; TestPoint_Pad_D0.5mm_Front
TP709: VIN_MOS; TestPoint_Pad_D0.5mm_Front
TP710: SW0_L; TestPoint_Pad_D0.5mm_Front
TP711: SW1_L; TestPoint_Pad_D0.5mm_Front
kibuzzard-66485E02: G***; kibuzzard-66485E02
kibuzzard-66485E57: G***; kibuzzard-66485E57
kibuzzard-66485E80: G***; kibuzzard-66485E80

Connections:
+2V5LTC: C726.2, IC701.27 (VDD25), R712.1, R713.1, R714.1, R715.1, R716.1, TP704.1
+3.3VLTC: C716.2, IC701.30 (VDD33), R701.2, R702.2, R703.2, R704.2, R705.2, R706.2, R707.2, R708.2, R709.2, R710.2, R711.2, TP705.1
+12V: C401.1, C717.2, D703.1 (K), IC701.43 (EXTVCC), J401.S10, R736.1, R737.1, TP409.1
/Project Architecture/+VBAT_Filtered: C903.1, C904.1, C905.1, C906.1, C907.1, L901.2, NT602.1, R725.1, R726.2
/Project Architecture/+VBAT_IN: C901.1, C902.1, J401.P1, L901.1, TP408.1
/Project Architecture/MVA_FILTERED: IC601.1 (OUT), J401.P3, Q602.1 (D), TP411.1
/Project Architecture/MVB_FILTERED: IC602.1 (OUT), J401.P4, Q604.1 (D), TP412.1
/Project Architecture/Power - Connector /MVA_SHDN: IC601.8 (SHDN), J401.S8
/Project Architecture/Power - Connector /MVB_SHDN: IC602.8 (SHDN), J401.S9
/Project Architecture/Power - Connector /RUN0: IC701.19 (RUN0), J401.S4, R705.1, TP405.1
/Project Architecture/Power - Connector /RUN1: IC701.20 (RUN1), J401.S2, R704.1, TP406.1
/Project Architecture/Power - Connector /SCL: IC701.14 (SCL), J401.S1, R710.1, TP404.1
/Project Architecture/Power - Connector /SDA: IC701.15 (SDA), J401.S3, R711.1, TP403.1
/Project Architecture/Power - Connector /~ALERT: IC701.16 (~ALERT), J401.S5, R709.1, TP407.1
/Project Architecture/Power - Connector /~FAULT0: IC701.17 (~FAULT0), J401.S7, R708.1, TP401.1
/Project Architecture/Power - Connector /~FAULT1: IC701.18 (~FAULT1), J401.S6, R707.1, TP402.1
/Project Architecture/Power - Converter/DRVCC: C607.2, C724.2, D601.2 (A), D602.2 (A), IC701.44 (DRVCC), TP706.1
/Project Architecture/Power - Converter/MVA_OUT: C704.1, C705.1, C706.1, C707.1, D603.2 (A2), IC601.4 (IN), IC701.7 (VSENSE0+), NT606.1, Q601.1 (D), R717.2, TP708.1
/Project Architecture/Power - Converter/MVB_OUT: C729.1, C730.1, C731.1, C732.1, D605.2 (A2), IC602.4 (IN), IC701.35 (VSENSE1+), NT604.1, Q603.1 (D), R729.2, TP707.1
/Project Architecture/Power - Converter/PGOOD0: IC701.34 (PGOOD0), Q707.1 (G), R702.1
/Project Architecture/Power - Converter/PGOOD1: IC701.33 (PGOOD1), Q708.1 (G), R703.1
/Project Architecture/Power - Converter/SHARE_CLK: IC701.29 (SHARE_CLK), R706.1
/Project Architecture/Power - Converter/SW0: C702.2, IC701.1 (SW0), L701.1, Q701.3 (S), Q702.1 (D), TP702.1
/Project Architecture/Power - Converter/SW0_L: L701.2, NT605.1, R717.1, TP710.1
/Project Architecture/Power - Converter/SW1: C715.2, IC701.39 (SW1), L702.2, Q705.3 (S), Q706.1 (D), TP703.1
/Project Architecture/Power - Converter/SW1_L: L702.1, NT603.1, R729.1, TP711.1
/Project Architecture/Power - Converter/SYNC: IC701.13 (SYNC), R701.1
/Project Architecture/Power - Converter/VIN: C718.2, C722.2, C723.2, IC701.48 (VIN), R726.1, TP701.1
/Project Architecture/Power - Converter/VIN_MOS: C701.1, C714.1, NT601.1, Q701.1 (D), Q705.1 (D), R725.2, TP709.1
/Project Architecture/Power - Converter/shuntA+: NT606.2, R724.2
/Project Architecture/Power - Converter/shuntA-: NT605.2, R723.2
/Project Architecture/Power - Converter/shuntB+: NT604.2, R731.2
/Project Architecture/Power - Converter/shuntB-: NT603.2, R730.2
/Project Architecture/Power - Converter/shuntIn+: NT601.2, R728.1
/Project Architecture/Power - Converter/shuntIn-: NT602.2, R727.1
GND: C401.2, C601.2, C602.1, C603.2, C604.1, C607.1, C701.2, C704.2, C705.2, C706.2, C707.2, C708.1, C709.1, C710.1, C711.1, C712.1, C713.1, C714.2, C716.1, C717.1, C718.1, C724.1, C726.1, C729.2, C730.2, C731.2, C732.2, C902.2, C904.2, C905.2, C906.2, C907.2, D604.2 (A2), D606.2 (A2), D703.2 (A), IC601.6 (GND), IC602.6 (GND), IC701.8 (VSENSE0-), IC701.26 (PHAS_CFG), IC701.28 (WP), IC701.53 (GND), J401.P2, Q702.3 (S), Q703.1 (B), Q703.3 (C), Q704.1 (B), Q704.3 (C), Q706.3 (S), Q707.2 (S), Q708.2 (S), R718.2, R719.2, R720.2, R721.2, R722.2, R901.1, R902.1, TP410.1, TP413.1, TP414.1
unnamed: C602.2, R602.2
unnamed: C604.2, R604.2
unnamed: C901.2, R901.2
unnamed: C903.2, R902.2
unnamed: C715.1, D601.1 (K), R738.1
unnamed: C702.1, D602.1 (K), R739.1
unnamed: D603.1 (A1), D604.1 (A1)
unnamed: D605.1 (A1), D606.1 (A1)
unnamed: D701.2 (A), R736.2
unnamed: D701.1 (K), Q707.3 (D)
unnamed: D702.2 (A), R737.2
unnamed: D702.1 (K), Q708.3 (D)
unnamed: IC601.2 (GATE), Q602.2 (G), R601.2, R602.1
unnamed: C601.1, IC601.5 (INTVCC)
unnamed: IC601.3 (SOURCE), Q601.3 (S), Q602.3 (S)
unnamed: IC602.2 (GATE), Q604.2 (G), R603.2, R604.1
unnamed: C603.1, IC602.5 (INTVCC)
unnamed: IC602.3 (SOURCE), Q603.3 (S), Q604.3 (S)
unnamed: C720.1, C722.1, IC701.47 (IIN+), R727.2
unnamed: C720.2, C723.1, IC701.46 (IIN-), R728.2
unnamed: IC701.21 (ASEL0), R714.2, R720.1
unnamed: IC701.22 (ASEL1), R715.2, R721.1
unnamed: IC701.25 (FREQ_CFG), R716.2, R722.1
unnamed: C709.2, IC701.12 (ITH0)
unnamed: C712.2, IC701.31 (ITH1)
unnamed: C710.2, IC701.11 (ITHR0)
unnamed: C711.2, IC701.32 (ITHR1)
unnamed: C708.2, IC701.6 (TSNS0), Q703.2 (E)
unnamed: C713.2, IC701.36 (TSNS1), Q704.2 (E)
unnamed: IC701.23 (VOUT0_CFG), R712.2, R718.1
unnamed: IC701.24 (VOUT1_CFG), R713.2, R719.1
unnamed: IC701.50 (BG0), R732.2
unnamed: IC701.52 (BOOST0), R739.2
unnamed: C703.1, IC701.4 (ISENSE0+), R723.1
unnamed: C703.2, IC701.5 (ISENSE0-), R724.1
unnamed: IC701.2 (TG0), R733.2
unnamed: IC701.42 (BG1), R734.2
unnamed: IC701.40 (BOOST1), R738.2
unnamed: C725.1, IC701.9 (ISENSE1+), R730.1
unnamed: C725.2, IC701.10 (ISENSE1-), R731.1
unnamed: IC701.38 (TG1), R735.2
unnamed: Q601.2 (G), R601.1
unnamed: Q603.2 (G), R603.1
unnamed: Q701.2 (G), R733.1
unnamed: Q702.2 (G), R732.1
unnamed: Q705.2 (G), R735.1
unnamed: Q706.2 (G), R734.1
