EPFLXplore/Power_HW/Pollux/Kicad/HVPowerModule/HVPowerModule.kicad_pcb

## KiCad design Pollux/Kicad/HVPowerModule/HVPowerModule.kicad_pcb (2026-09-20)

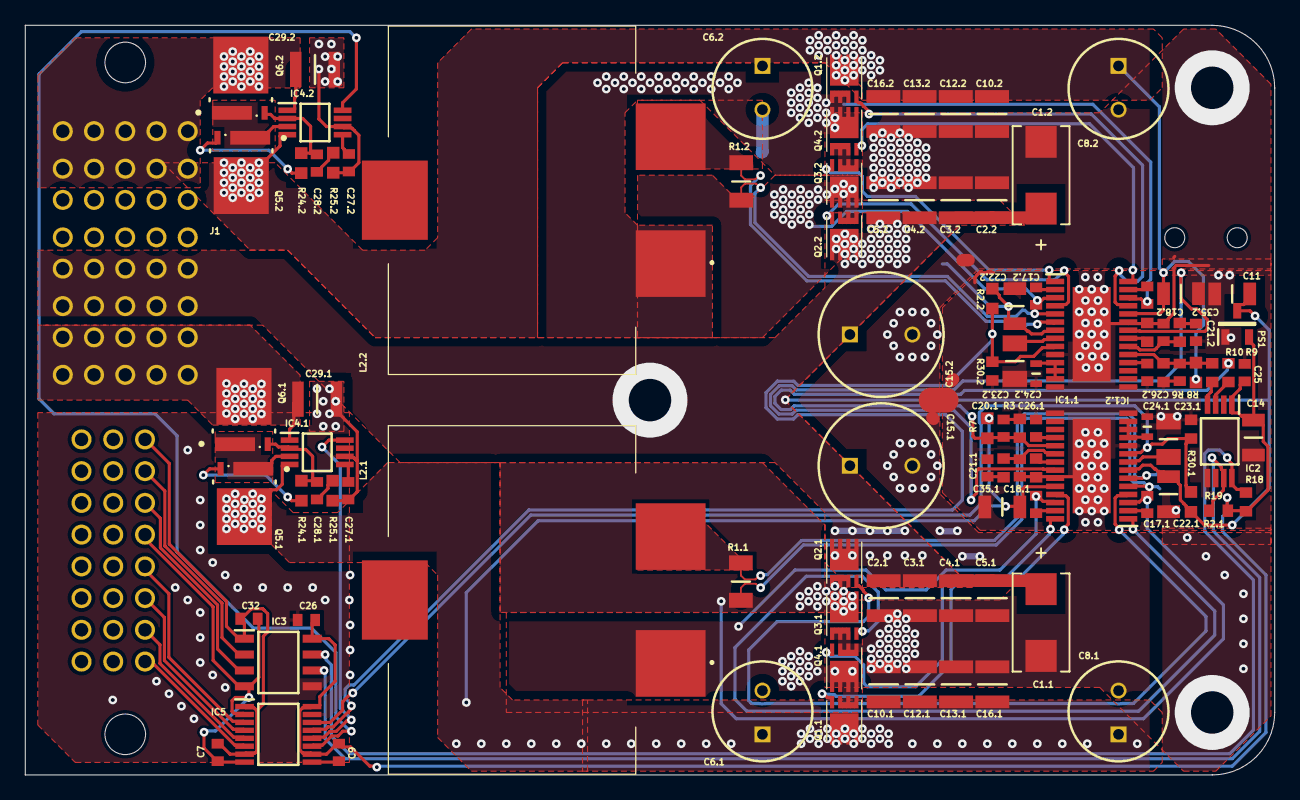
[picture p193: board HVPowerModule.kicad_pcb from above]

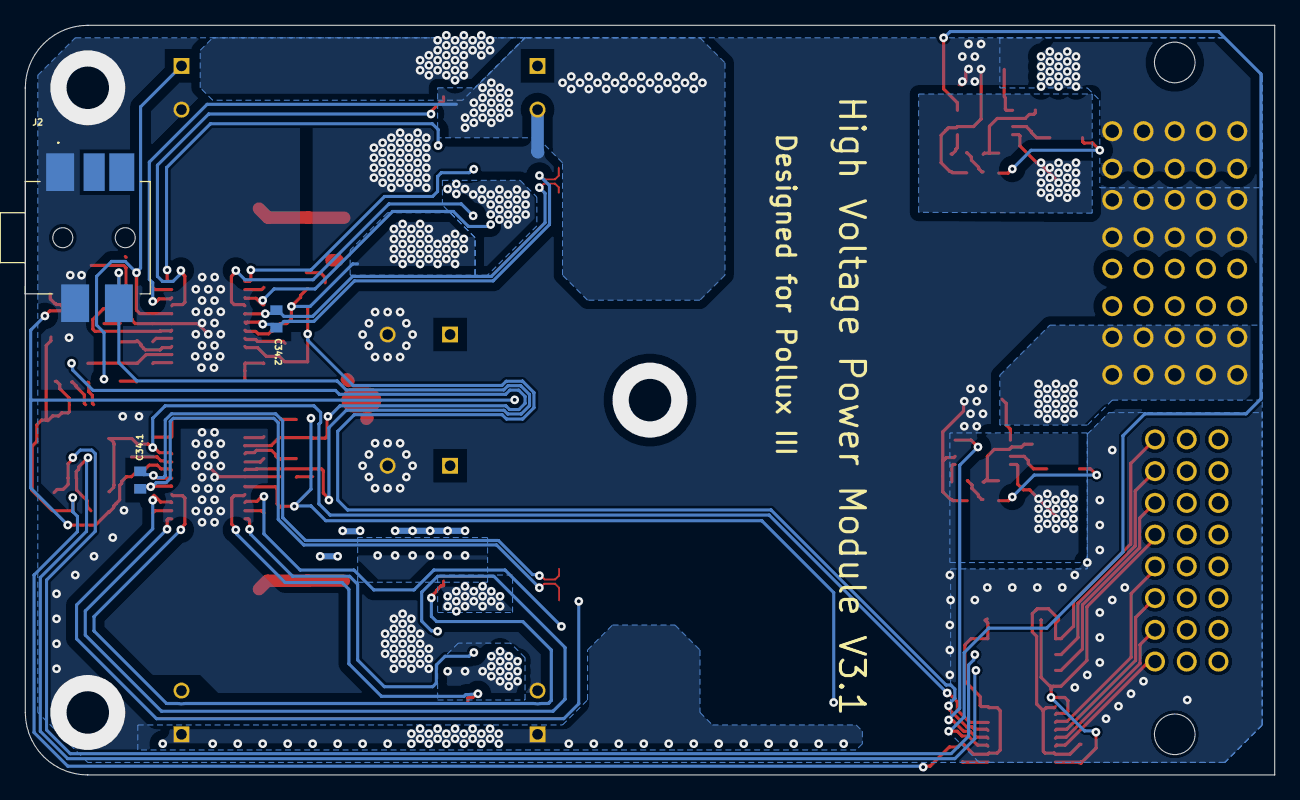
[picture p194: board HVPowerModule.kicad_pcb from below]

Board: 2 copper layers, 100.0 x 60.0 mm, 105 parts (3 on the bottom side), 66 nets.

Parts:
C1.1, C1.2: T598D336M035ATE065; CAPMP7.6X4.3_3.1N_KEM
C2.1, C2.2, C3.1, C3.2, C4.1, C4.2, C5.1, C5.2, C10.1, C10.2, C12.1, C12.2, C13.1, C13.2, C16.1, C16.2: CGA6P1X7R1N106M250AC; CAPC3225X280N
C6.1, C6.2, C8.1, C8.2, C15.1, C15.2: A750MW687M1VAAE018; CAPPRD500W65D1000H1800
C7, C9, C17.1, C17.2, C18.1, C18.2, C25, C26, C26.1, C26.2, C27.1, C27.2, C32: C0603C104K5RACTU; CAPC1608X95N
C11, C14: C1206C105K5RAC; CAPC3216X110N
C19.1, C19.2: C0603C689C5GACTU; CAPC1608X87N
C20.1, C20.2: C0603C221K5RACTU; CAPC1608X87N
C21.1, C21.2, C34.1, C34.2: C0603C102J5RACTU; CAPC1608X95N
C22.1, C22.2, C35.1, C35.2: C1206C105M5RECTU; CAPC3216X130N
C23.1, C23.2: C1206X475M5RACAUTO; CAPC3316X195N
C24.1, C24.2: C0603C474K4PACTU; CAPC1608X90N
C28.1, C28.2: C0603C103K5RACTU; CAPC1608X95N
C29.1, C29.2: C3225X7R2A106K250AC; CAPC3225X230N
IC1.1, IC1.2: LT8392JFE#PBF; SOP65P640X120-29N
IC2: MCP47FEB02A0-E_ST; SOP65P640X120-8N
IC3: ADUM1251ARZ; SOIC127P600X175-8N
IC4.1, IC4.2: LTC4372CMS8#TRPBF; SOP65P490X110-8N
IC5: SI8640EB-B-IU; SOP64P600X175-16N
J1: 46437-3001; 464373001
J2: 980TR
L2.1, L2.2: PQ2614BHA-100K; PQ2614BLA1R0K
PS1: MCP1799T-3302H_TT; SOT95P237X112-3N
Q1.1, Q1.2, Q2.1, Q2.2, Q3.1, Q3.2, Q4.1, Q4.2: BSZ034N04LS; BSZ060NE2LS
Q5.1, Q5.2, Q6.1, Q6.2: BSC016N06NSATMA1; FP-PG-TDSON-8-MFG
R1.1, R1.2: PCS1206FR0030ET; RESC3216X68N
R2.1, R2.2, R7, R8: CRCW0603100KJNEAC; RESC1608X55N
R3, R6: CRCW06034K32FKEA; RESC1608X50N
R4.1, R4.2: CRCW0603255KFKEAC; RESC1608X50N
R5.1, R5.2: CRCW0603316KFKTA; RESC1608X50N
R9, R10: CRCW060322K1FKEB; RESC1608X50N
R18, R19: CRCW06035K60JNEAC; RESC1608X50N
R24.1, R24.2: CRCW060310R0JNEAC; RESC1608X55N
R25.1, R25.2: CRCW06031K00FKECC; RESC1608X55N
R30.1, R30.2: CRCW06038K87FKTA; RESC1608X50N

Connections:
24V.1: C6.1.1, C8.1.1, C10.1.2, C12.1.2, C13.1.2, C16.1.2, C35.1.1, IC1.1.24, IC4.1.4, Q1.1.1, Q1.1.2, Q1.1.3, Q1.1.4, Q5.1.5-6-7-8, R7.2
24V.2: C6.2.1, C8.2.1, C10.2.2, C12.2.2, C13.2.2, C16.2.2, C35.2.1, IC1.2.24, IC4.2.4, Q1.2.1, Q1.2.2, Q1.2.3, Q1.2.4, Q5.2.5-6-7-8, R8.2
24VA_CTRL: IC1.1.9, IC5.14, R2.1.1, R30.1.2
24VA_INJ: IC2.3, R9.2
24VA_OUT: C29.1.2, IC4.1.1, J1.P4, Q6.1.5-6-7-8
24VA_SHDN: IC4.1.8, IC5.12
24VB_CTRL: IC1.2.9, IC5.13, R2.2.1, R30.2.2
24VB_INJ: IC2.4, R10.2
24VB_OUT: C29.2.2, IC4.2.1, J1.P1, Q6.2.5-6-7-8
24VB_SHDN: IC4.2.8, IC5.11
24V_COMP.1: C19.1.2, IC1.1.20, R4.1.2
24V_COMP.2: C19.2.2, IC1.2.20, R4.2.2
24V_FB.1: C20.1.2, IC1.1.19, R3.1, R7.1, R9.1
24V_FB.2: C20.2.2, IC1.2.19, R6.1, R8.1, R10.1
EXT_3V3: C7.1, C32.2, IC3.1, IC5.1, IC5.7, J1.S17
EXT_GND: C7.2, C32.1, IC3.4, IC5.2, IC5.8, J1.S20
EXT_SCL: IC3.3, J1.S19
EXT_SDA: IC3.2, J1.S18
GATE1.1: Q5.1.4, R24.1.2
GATE1.2: Q5.2.4, R24.2.2
GATE2.1: C28.1.2, IC4.1.2, Q6.1.4, R24.1.1
GATE2.2: C28.2.2, IC4.2.2, Q6.2.4, R24.2.1
GND: C1.1.2, C1.2.2, C2.1.1, C2.2.1, C3.1.1, C3.2.1, C4.1.1, C4.2.1, C5.1.1, C5.2.1, C6.1.2, C6.2.2, C8.1.2, C8.2.2, C9.2, C10.1.1, C10.2.1, C11.1, C12.1.1, C12.2.1, C13.1.1, C13.2.1, C14.1, C15.1.2, C15.2.2, C16.1.1, C16.2.1, C19.1.1, C19.2.1, C20.1.1, C20.2.1, C21.1.1, C21.2.1, C22.1.2, C22.2.2, C23.1.2, C23.2.2, C24.1.2, C24.2.2, C25.1, C26.1, C26.1.1, C26.2.1, C27.1.1, C27.2.1, C29.1.1, C29.2.1, C35.1.2, C35.2.2, IC1.1.10, IC1.1.14, IC1.1.15, IC1.1.23, IC1.1.29, IC1.2.10, IC1.2.14, IC1.2.15, IC1.2.23, IC1.2.29, IC2.5, IC3.5, IC4.1.6, IC4.2.6, IC5.9, IC5.15, J1.P2, J2.1, J2.4, PS1.1, Q3.1.5, Q3.1.6, Q3.1.7, Q3.2.5, Q3.2.6, Q3.2.7, Q4.1.5, Q4.1.6, Q4.1.7, Q4.2.5, Q4.2.6, Q4.2.7, R3.2, R5.1.1, R5.2.1, R6.2, R25.1.1, R25.2.1, R30.1.1, R30.2.1
HDRV1.1: IC1.1.4, Q2.1.8
HDRV1.2: IC1.2.4, Q2.2.8
HDRV2.1: IC1.1.25, Q1.1.8
HDRV2.2: IC1.2.25, Q1.2.8
LDRV1.1: IC1.1.1, Q3.1.8
LDRV1.2: IC1.2.1, Q3.2.8
LDRV2.1: IC1.1.28, Q4.1.8
LDRV2.2: IC1.2.28, Q4.2.8
LSN.1: C34.1.1, IC1.1.6, L2.1.2, R1.1.2
LSN.2: C34.2.1, IC1.2.6, L2.2.2, R1.2.2
NetC17.1_1: C17.1.1, IC1.1.2
NetC17.2_1: C17.2.1, IC1.2.2
NetC18.1_2: C18.1.2, IC1.1.27
NetC18.2_2: C18.2.2, IC1.2.27
NetC21.1_2: C21.1.2, R4.1.1
NetC21.2_2: C21.2.2, R4.2.1
NetC23.1_1: C23.1.1, IC1.1.8
NetC23.2_1: C23.2.1, IC1.2.8
NetC24.1_1: C24.1.1, IC1.1.11, IC1.1.12, IC1.1.13
NetC24.2_1: C24.2.1, IC1.2.11, IC1.2.12, IC1.2.13
NetC26.1_2: C26.1.2, IC1.1.18
NetC26.2_2: C26.2.2, IC1.2.18
NetC27.1_2: C27.1.2, IC4.1.5
NetC27.2_2: C27.2.2, IC4.2.5
NetC28.1_1: C28.1.1, R25.1.2
NetC28.2_1: C28.2.1, R25.2.2
NetIC1.1_21: IC1.1.21, R5.1.2
NetIC1.2_21: IC1.2.21, R5.2.2
NetIC2_7: IC2.7, IC3.6, R19.1
NetIC2_8: IC2.8, IC3.7, R18.1
NetIC4.1_3: IC4.1.3, Q5.1.1-2-3, Q6.1.1-2-3
NetIC4.2_3: IC4.2.3, Q5.2.1-2-3, Q6.2.1-2-3
NetIC5_3: IC5.3, J1.S21
NetIC5_4: IC5.4, J1.S22
NetIC5_5: IC5.5, J1.S23
NetIC5_6: IC5.6, J1.S24
SW1.1: C17.1.2, C34.1.2, IC1.1.3, IC1.1.5, Q2.1.5, Q2.1.6, Q2.1.7, Q3.1.1, Q3.1.2, Q3.1.3, Q3.1.4, R1.1.1
SW1.2: C17.2.2, C34.2.2, IC1.2.3, IC1.2.5, Q2.2.5, Q2.2.6, Q2.2.7, Q3.2.1, Q3.2.2, Q3.2.3, Q3.2.4, R1.2.1
SW2.1: C18.1.1, IC1.1.26, L2.1.1, Q1.1.5, Q1.1.6, Q1.1.7, Q4.1.1, Q4.1.2, Q4.1.3, Q4.1.4
SW2.2: C18.2.1, IC1.2.26, L2.2.1, Q1.2.5, Q1.2.6, Q1.2.7, Q4.2.1, Q4.2.2, Q4.2.3, Q4.2.4
SYNC: IC1.1.22, IC1.2.22, J2.5
V_IN: C1.1.1, C1.2.1, C2.1.2, C2.2.2, C3.1.2, C3.2.2, C4.1.2, C4.2.2, C5.1.2, C5.2.2, C11.2, C15.1.1, C15.2.1, C22.1.1, C22.2.1, IC1.1.7, IC1.2.7, J1.P3, PS1.3, Q2.1.1, Q2.1.2, Q2.1.3, Q2.1.4, Q2.2.1, Q2.2.2, Q2.2.3, Q2.2.4, R2.1.2, R2.2.2
V_LDO: C9.1, C14.2, C25.2, C26.2, IC2.1, IC3.8, IC5.10, IC5.16, PS1.2, R18.2, R19.2
