EPFLXplore/Power_HW/Pollux/Kicad/LVPowerModule/KiCad FIles/LVPowerModule.kicad_pcb

## KiCad design Pollux/Kicad/LVPowerModule/KiCad FIles/LVPowerModule.kicad_pcb (2026-09-20)

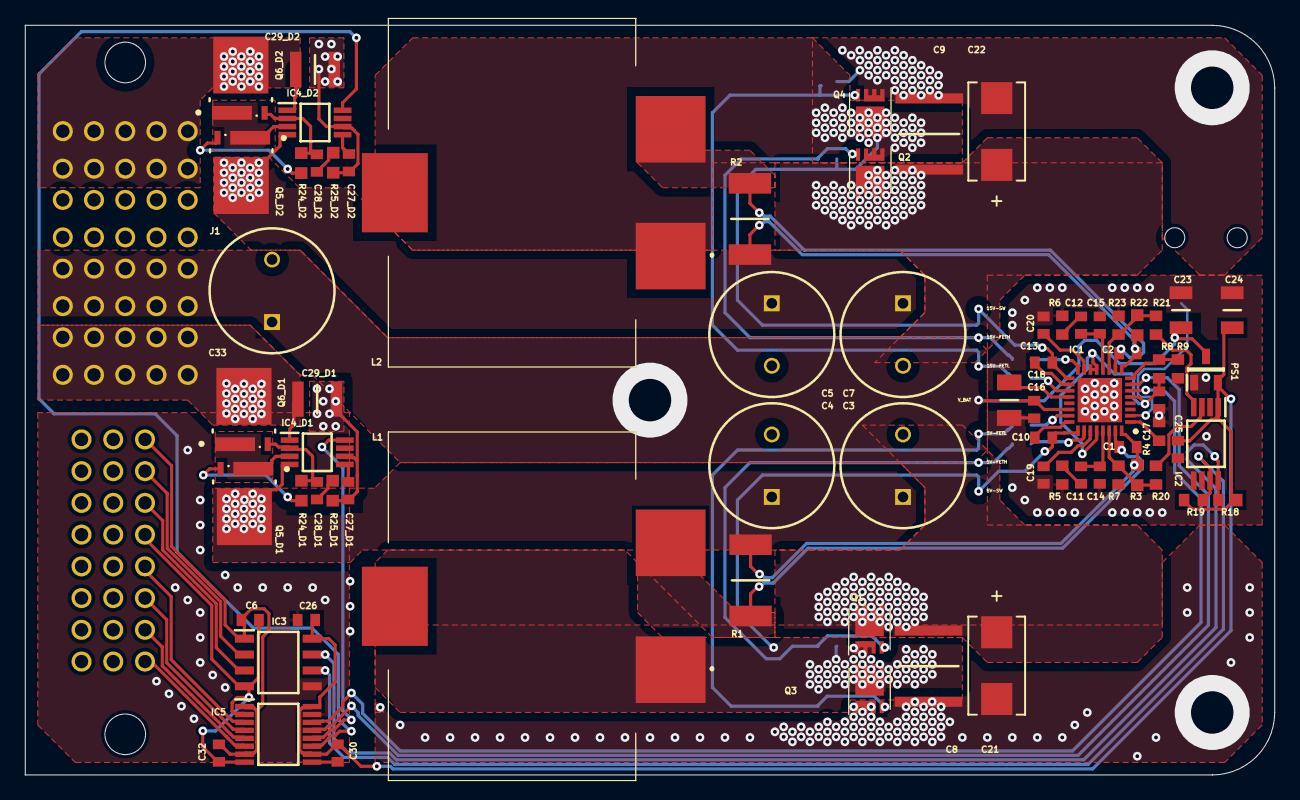
[picture p195: board LVPowerModule.kicad_pcb from above]

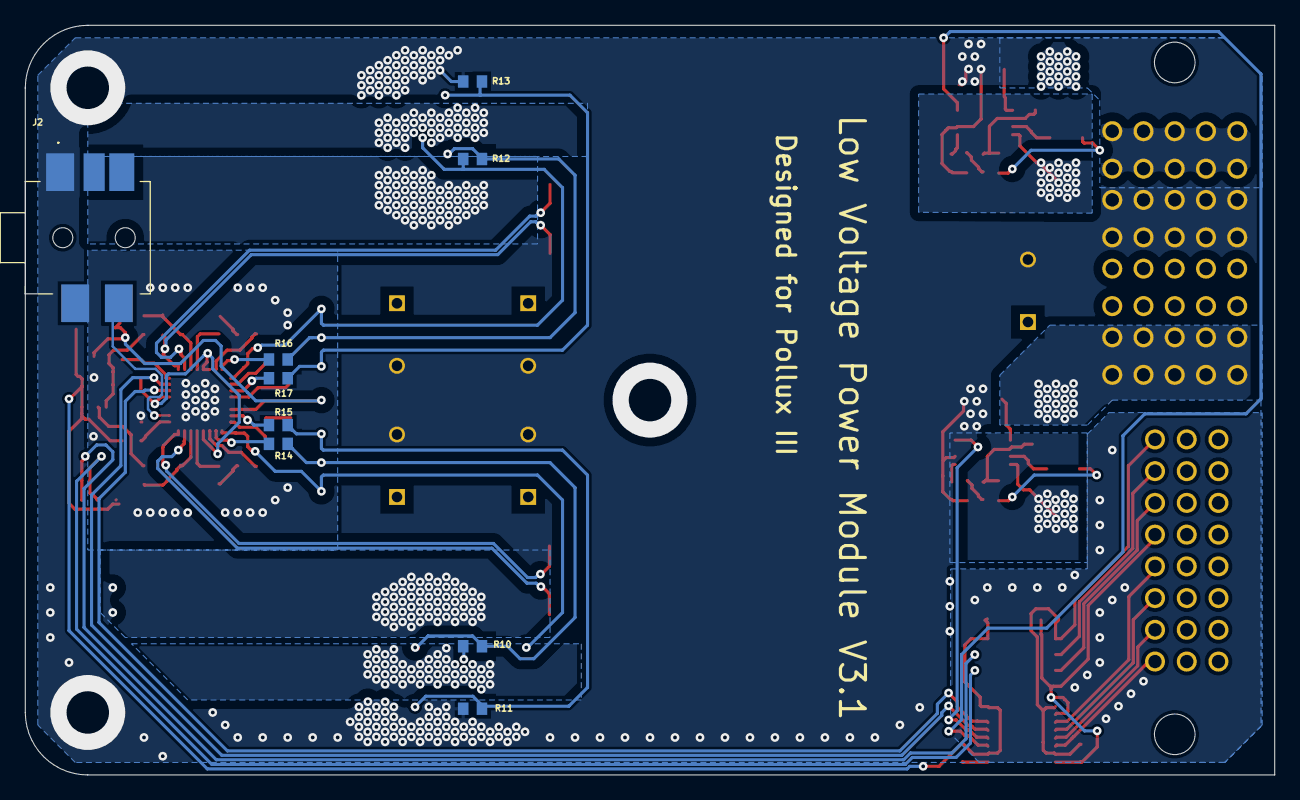
[picture p196: board LVPowerModule.kicad_pcb from below]

Board: 2 copper layers, 100.0 x 60.0 mm, 81 parts (9 on the bottom side), 60 nets.

Parts:
C1, C2: C0603C102J5RACTU; CAPC1608X95N
C3, C4, C5, C7, C33: A750MW687M1VAAE018; CAPPRD500W65D1000H1800
C6, C10, C13, C16, C17, C19, C20, C25, C26, C27_D1, C27_D2, C30, C32: C0603C104K5RACTU; CAPC1608X95N
C8, C9: C5750X7S2A106K230KB; CAPC5750X310N
C11: C0603C512J5GACAUTO; CAPC1608X87N
C12: C0603C362J5GACTU; CAPC1608X87N
C14: C0603C121J5GACTU; CAPC1608X87N
C15: C0603C151J5GAC; CAPC1608X87N
C18: C1206X475M5RACAUTO; CAPC3316X195N
C21, C22: T598D336M035ATE065; CAPMP7.6X4.3_3.1N_KEM
C23, C24: C1206C105K5RAC; CAPC3216X110N
C28_D1, C28_D2: C0603C103K5RACTU; CAPC1608X95N
C29_D1, C29_D2: C3225X7R2A106K250AC; CAPC3225X230N
IC1: LTC3892EUH#PBF; QFN50P500X500X80-33N-D
IC2: MCP47FEB02A0-E_ST; SOP65P640X120-8N
IC3: ADUM1251ARZ; SOIC127P600X175-8N
IC4_D1, IC4_D2: LTC4372CMS8#TRPBF; SOP65P490X110-8N
IC5: SI8640EB-B-IU; SOP64P600X175-16N
J1: 46437-3001; 464373001
J2: 980TR
L1, L2: PQ2614BHA-100K; PQ2614BLA1R0K
PS1: MCP1799T-3302H_TT; SOT95P237X112-3N
Q1, Q2, Q3, Q4: BSZ0703LS; BSZ011NE2LS5IATMA1
Q5_D1, Q5_D2, Q6_D1, Q6_D2: BSC016N06NSATMA1; FP-PG-TDSON-8-MFG
R1, R2: CRF2512-FZ-R005ELF; RESC6432X80N
R3, R22: CRCW0603100KJNEAC; RESC1608X55N
R4: CRCW060324K9FKTA; RESC1608X50N
R5, R10, R11, R12, R13, R20, R21: CRCW060322K1FKEB; RESC1608X50N
R6: CRCW060326K7FKEB; RESC1608X50N
R7, R18, R19, R23: CRCW06035K60JNEAC; RESC1608X50N
R8, R9, R14, R15, R16, R17: CRCW06030000ZSTB; RESC1608X50N
R24_D1, R24_D2: CRCW060310R0JNEAC; RESC1608X55N
R25_D1, R25_D2: CRCW06031K00FKECC; RESC1608X55N

Connections:
5FETH: Q1.4, R10.2, R14.2
5FETL: Q3.4, R11.2, R15.2
5SW: C10.2, IC1.25, L1.1, Q1.1, Q1.2, Q1.3, Q1.10, Q3.5, Q3.6, Q3.7, Q3.8, Q3.9, R10.1
5V: C1.2, C3.1, C4.1, IC1.32, IC4_D1.4, Q5_D1.5-6-7-8, R1.2, R3.2
5V+: C1.1, IC1.31, L1.2, R1.1
5V_COMP: C11.2, C14.2, IC1.29
5V_CTRL: IC1.6, IC5.14
5V_FB: IC1.30, R3.1, R7.2, R20.1
5V_INJ: IC2.3, R20.2
5V_OUT: C29_D1.2, IC4_D1.1, J1.P4, Q6_D1.5-6-7-8
5V_SHDN: IC4_D1.8, IC5.12
15FETH: Q2.4, R12.2, R16.2
15FETL: Q4.4, R13.2, R17.2
15SW: C13.2, IC1.17, L2.1, Q2.1, Q2.2, Q2.3, Q2.10, Q4.5, Q4.6, Q4.7, Q4.8, Q4.9, R12.1
15V: C2.2, C5.1, C7.1, IC1.9, IC4_D2.4, Q5_D2.5-6-7-8, R2.2, R22.2
15V+: C2.1, IC1.10, L2.2, R2.1
15V_COMP: C12.2, C15.2, IC1.12
15V_CTRL: IC1.7, IC5.13
15V_FB: IC1.11, R21.1, R22.1, R23.2
15V_INJ: IC2.4, R21.2
15V_OUT: C29_D2.2, IC4_D2.1, J1.P1, Q6_D2.5-6-7-8
15V_SHDN: IC4_D2.8, IC5.11
EXT_3V3: C6.1, C32.2, IC3.1, IC5.1, IC5.7, J1.S17
EXT_GND: C6.2, C32.1, IC3.4, IC5.2, IC5.8, J1.S20
EXT_SCL: IC3.3, J1.S19
EXT_SDA: IC3.2, J1.S18
GATE1_D1: Q5_D1.4, R24_D1.2
GATE1_D2: Q5_D2.4, R24_D2.2
GATE2_D1: C28_D1.2, IC4_D1.2, Q6_D1.4, R24_D1.1
GATE2_D2: C28_D2.2, IC4_D2.2, Q6_D2.4, R24_D2.1
GND: C3.2, C4.2, C5.2, C7.2, C8.1, C9.1, C14.1, C15.1, C16.1, C17.1, C18.1, C19.2, C20.2, C21.2, C22.2, C23.1, C24.1, C25.1, C26.1, C27_D1.1, C27_D2.1, C29_D1.1, C29_D2.1, C30.2, C33.2, IC1.33, IC2.5, IC3.5, IC4_D1.6, IC4_D2.6, IC5.9, IC5.15, J1.P2, J2.1, J2.4, PS1.1, Q3.1, Q3.2, Q3.3, Q3.10, Q4.1, Q4.2, Q4.3, Q4.10, R4.2, R5.1, R6.1, R7.1, R9.2, R11.1, R13.1, R23.1, R25_D1.1, R25_D2.1
ILIM: IC1.8, R8.1, R9.1
INTVCC: C17.2, IC1.5, IC1.13, IC1.14, IC1.28, R8.2
NetC10_1: C10.1, IC1.24
NetC11_1: C11.1, R5.2
NetC12_1: C12.1, R6.2
NetC13_1: C13.1, IC1.18
NetC18_2: C18.2, IC1.20
NetC19_1: C19.1, IC1.27
NetC20_1: C20.1, IC1.15
NetC27_D1_2: C27_D1.2, IC4_D1.5
NetC27_D2_2: C27_D2.2, IC4_D2.5
NetC28_D1_1: C28_D1.1, R25_D1.2
NetC28_D2_1: C28_D2.1, R25_D2.2
NetIC1_16: IC1.16, R16.1
NetIC1_19: IC1.19, R17.1
NetIC1_23: IC1.23, R15.1
NetIC1_26: IC1.26, R14.1
NetIC2_7: IC2.7, IC3.6, R19.1
NetIC2_8: IC2.8, IC3.7, R18.1
NetIC4_D1_3: IC4_D1.3, Q5_D1.1-2-3, Q6_D1.1-2-3
NetIC4_D2_3: IC4_D2.3, Q5_D2.1-2-3, Q6_D2.1-2-3
NetIC5_3: IC5.3, J1.S21
NetIC5_4: IC5.4, J1.S22
NetIC5_5: IC5.5, J1.S23
NetIC5_6: IC5.6, J1.S24
RT: IC1.1, R4.1
SYNC: IC1.2, J2.5
V_IN: C8.2, C9.2, C16.2, C21.1, C22.1, C23.2, C33.1, IC1.22, J1.P3, PS1.3, Q1.5, Q1.6, Q1.7, Q1.8, Q1.9, Q2.5, Q2.6, Q2.7, Q2.8, Q2.9
V_LDO: C24.2, C25.2, C26.2, C30.1, IC2.1, IC3.8, IC5.10, IC5.16, PS1.2, R18.2, R19.2
