EPFLXplore/Power_HW/(commit log)

2025-03-09 Added photos, updated to Kicad 9.0 and wrote next improvements
    [Block Diagram.kicad_sch, MCU - Unit.kicad_sch, Misc - Mounting Holes.kicad_sch, Power - Charger.kicad_sch, Power - Connectors.kicad_sch, Power - Generation.kicad_sch, Power - Power Path.kicad_sch, Power - Sequencing.kicad_sch]
2025-03-22 Updated STEP file and added fan 3D model
2025-06-08 Last changes before v1.1
    [Block Diagram.kicad_sch, MCU - Unit.kicad_sch, Power - Charger.kicad_sch, Power - Connectors.kicad_sch, Power - Generation.kicad_sch, Power - Power Path.kicad_sch, Revision History.kicad_sch, User - LED Indicators.kicad_sch]
2025-07-14 Done with changes of v1.1, need to final check and order
    [Block Diagram.kicad_sch, MCU - Unit.kicad_sch, Misc - Fan Controller.kicad_sch, Misc - Mounting Holes.kicad_sch, Power - Charger.kicad_sch, Power - Connectors.kicad_sch, Power - Generation.kicad_sch, Power - Power Path.kicad_sch]
2025-07-24 Finished V1.1, maybe extra cleaning needed of some details in the doc
    [Block Diagram.kicad_sch, Interface - Connectors.kicad_sch, MCU - Unit.kicad_sch, Misc - Fan Controller.kicad_sch, Misc - Mounting Holes.kicad_sch, Power - Charger.kicad_sch, Power - Connectors.kicad_sch, Power - Generation.kicad_sch]
2025-08-14 added high power module
    [464373001.stp, 980TR.stp, A750MW687M1VAAE018.stp, C0603C101J5RACTU.stp, C0603C104M4RACTU.stp, C1206C105K5RAC.stp, C1206C105M5RECTU.stp, C1206X475M5RACAUTO.stp]
2025-08-14 high power kicad
    [464373001.stp, 980TR.stp, A750MW687M1VAAE018.stp, C0603C101J5RACTU.stp, C0603C104M4RACTU.stp, C1206C105K5RAC.stp, C1206C105M5RECTU.stp, C1206X475M5RACAUTO.stp]
2025-08-14 pollux Altium
    [AnalogFrontEnd.SchDoc, Audio.SchDoc, AuxiliaryPowerSupply.SchDoc, CAN.SchDoc, ControlUnit.SchDoc, Controller.SchDoc, DIV30.SchDoc, Display.SchDoc]
2025-08-14 added pollux and lv module
    [464373001.stp, 980TR.stp, A750MW687M1VAAE018.stp, AnalogFrontEnd.kicad_sch, BSZ011NE2LS5IATMA1.stp, C0603C101J5RACTU.stp, C0603C104M4RACTU.stp, C1206C105K5RAC.stp]
2025-08-28 Small adjustments
    [Block Diagram.kicad_sch, Interface - Connectors.kicad_sch, MCU - Unit.kicad_sch, Misc - Fan Controller.kicad_sch, Power - Charger.kicad_sch, Power - Connectors.kicad_sch, Power - Generation.kicad_sch, Power - Power Path.kicad_sch]
2025-09-04 Cleaned README, updated block diagram
    [Block Diagram.kicad_sch, Interface - Connectors.kicad_sch, MCU - Unit.kicad_sch, Misc - Fan Controller.kicad_sch, Misc - Mounting Holes.kicad_sch, Power - Charger.kicad_sch, Power - Connectors.kicad_sch, Power - Generation.kicad_sch]
2025-10-16 Create README.md for Bucky
2025-10-16 Uploaded Bucky V1
    Bucky V1 schematics and layout
    [Bucky.kicad_pcb, Bucky.kicad_sch]
2026-04-16 added power hat
    [power_hat-B_Cu (Sig).gbr, power_hat-B_Mask.gbr, power_hat-B_Paste.gbr, power_hat-B_Silkscreen.gbr, power_hat-Edge_Cuts.gbr, power_hat-F_Cu (Sig).gbr, power_hat-F_Mask.gbr, power_hat-F_Paste.gbr]
2026-04-16 added power changes
    [power_hat.kicad_pcb, power_hat.kicad_sch]
2026-04-18 added gerbers and final modifications before ordering
    [power_hat-B_Cu (Sig).gbr, power_hat-B_Mask.gbr, power_hat-B_Paste.gbr, power_hat-B_Silkscreen.gbr, power_hat-Edge_Cuts.gbr, power_hat-F_Cu (Sig).gbr, power_hat-F_Mask.gbr, power_hat-F_Paste.gbr]
2026-06-24 added monitoring, rerouting partially
    [power_hat.kicad_pcb, power_hat.kicad_sch]
2026-07-24 Reruted a while ago with TPS, resized TPS with personal notes and Excel, issues with 24V one
    [15V_TPS25983_Design_Calculator_v1.4.xlsm, 24V_TPS25983_Design_Calculator_v1.4.xlsm, 5V_TPS25983_Design_Calculator_v1.4.xlsm, TPS25983_Design_Calculator_v1.4.xlsm, power_hat.kicad_pcb, power_hat.kicad_sch]
2026-07-25 Rerouted and DRC repassed to put back ADM as TPS is thermally limited for 24V
    [power_hat.kicad_pcb, power_hat.kicad_sch]
2026-07-27 v2 done
    [15V_TPS25983_Design_Calculator_v1.4.xlsm, 24V_ADM1270 Design Spreadsheet tool_Release.xlsm, 24V_TPS25983_Design_Calculator_v1.4.xlsm, 5V_TPS25983_Design_Calculator_v1.4.xlsm, TPS25983_Design_Calculator_v1.4.xlsm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]
2026-07-28 Already bought but forgot to commit
    [power_hat-B_Cu (Sig).gbr, power_hat-B_Mask.gbr, power_hat-B_Paste.gbr, power_hat-B_Silkscreen.gbr, power_hat-Edge_Cuts.gbr, power_hat-F_Cu (Sig).gbr, power_hat-F_Mask.gbr, power_hat-F_Paste.gbr]
2026-08-12 Small tweak on assembly
    [24V_ADM1270 Design Spreadsheet tool_Release.xlsm]
2026-08-22 Some wago thigns
    [15V_TPS25983_Design_Calculator_v1.4.xlsm, 24V_ADM1270 Design Spreadsheet tool_Release.xlsm, 24V_TPS25983_Design_Calculator_v1.4.xlsm, 5V_TPS25983_Design_Calculator_v1.4.xlsm, TPS25983_Design_Calculator_v1.4.xlsm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]
