EPFLXplore/Power_HW/(notices)

Notices in the files:
GEODE/rev1/Geode_FW/Core/Inc/main.h:
Copyright (c) 2024 STMicroelectronics.
All rights reserved.
This software is licensed under terms that can be found in the LICENSE file
GEODE/rev2/SMPS_Motherboard/footprints/connector/JTAG/FTSH-107-01-F-DV-K-P-TR.stp:
author */ ('License CC BY-ND 4.0'),
parts and their libraries:
COPYRIGHT: Copyright (C) 2018 Accelerated Designs. All rights reserved
